FormulaRacingatUCDavis/FE11_CAD/Electrical/Components/Brake Light/EL-A0106-AA-Brake Light Assembly.SLDASM

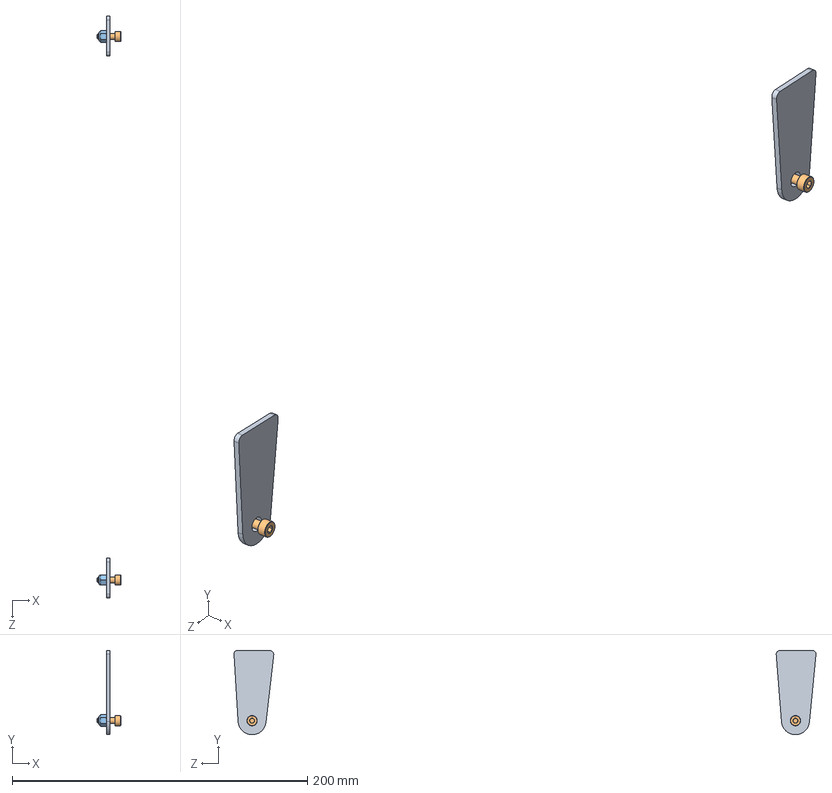
[picture p1: CAD file, 2024-04-30]
Electrical/Components/Brake Light/EL-A0106-AA-Brake Light Assembly.SLDASM
16.0 x 57.3 x 394.5 mm
EL-30080-AA-Brake Light Tabs x 2
BR-Black Oxide C12.9 SHCS, M4x0.7-12 (91290A148) x 2
FS-NYLOC C8 HX, M4x0.7-5 (90576A103) x 2
