FormulaRacingatUCDavis/FE11_CAD/Electrical/Components/Dashboard/FE10 Dashboard Packaging/EL-A00XX-BA-Dashboard Assembly.SLDASM

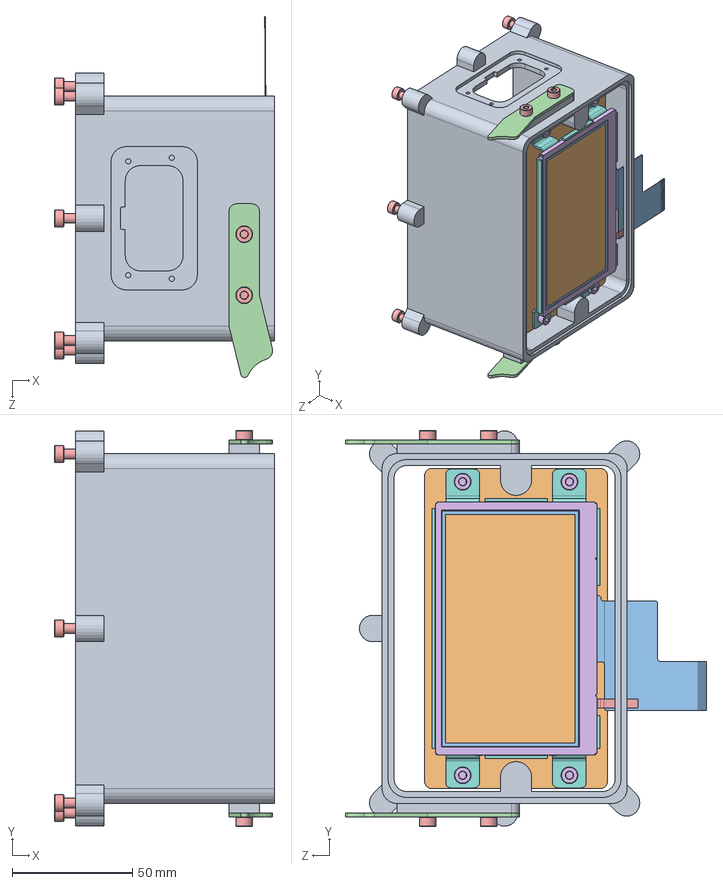
[picture p2: CAD file, 2023-11-07]
Electrical/Components/Dashboard/FE10 Dashboard Packaging/EL-A00XX-BA-Dashboard Assembly.SLDASM
91.8 x 164.9 x 150.3 mm
NHD-4.3-480272MF-34-Controller-Board
PANEL
PANEL-1
BLU
BLU-1
BEZEL
BSO4-M3-6 x 4
NHD-4.3-B
EL-500XX-BA-Dashboard Bottom Enclosure
EL-500XX-AA-Dashboard Screen Flat Panel
EL-500XX-AA-Dashboard Rear Flat Panel
EL-300XX-AA-Dashboard Enclosure Tabs x 2
BR-Black Oxide C12.9 SHCS, M4x0.7-8 (91290A140) x 13
BR-Black Oxide C12.9 SHCS, M4x0.7-5 (91290A138) x 4
