FormulaRacingatUCDavis/FE11_CAD/Electrical/Components/LV Battery/EL-A0104-AA-LV Battery Assembly.SLDASM

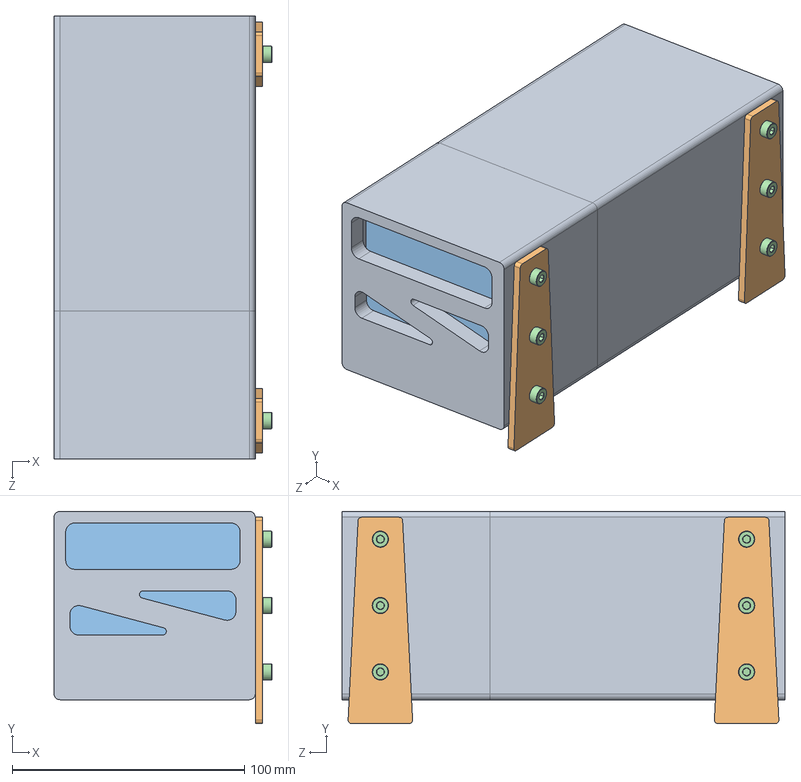
[picture p3: CAD file, 2024-04-30]
Electrical/Components/LV Battery/EL-A0104-AA-LV Battery Assembly.SLDASM
93.9 x 91.4 x 190.8 mm
EL-50060-AA-LV Battery Enclosure
EL-30061-AA-LV Battery Mounting Tab x 2
EL-00004-AA-Aegies-12 V 20 Ah Battery
BR-Black Oxide C12.9 SHCS, M4x0.7-8 (91290A140) x 6
