FormulaRacingatUCDavis/FE11_CAD/Electrical/Components/TSAL/EL-A0105-AA-TSAL Assembly.SLDASM

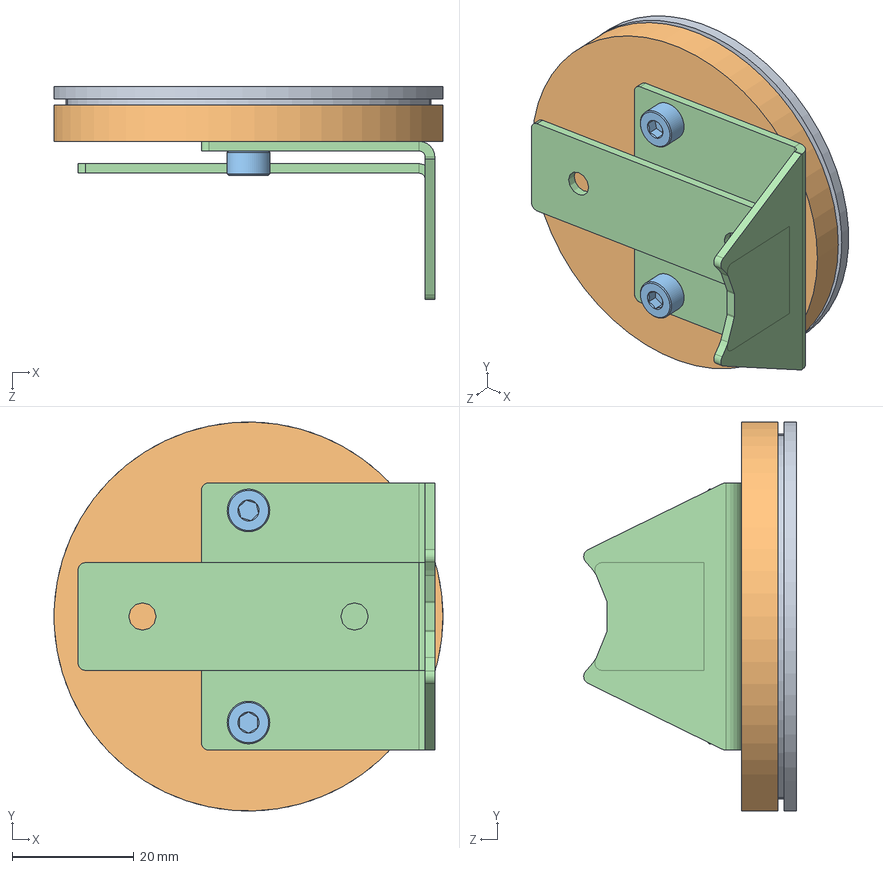
[picture p4: CAD file, 2024-04-30]
Electrical/Components/TSAL/EL-A0105-AA-TSAL Assembly.SLDASM
64.0 x 64.0 x 35.0 mm
EL-50071-AA-TSAL Bottom Housing
EL-50070-AA-TSAL Top Housing
BR-Black Oxide C12.9 SHCS, M4x0.7-8 (91290A140) x 2
EL-30072-AA-TSAL Mounting Tab
