FormulaRacingatUCDavis/FE11_CAD/Electrical/Components/TSMP + MS/EL-A0101-AA-TSMP + MS Assembly.SLDASM

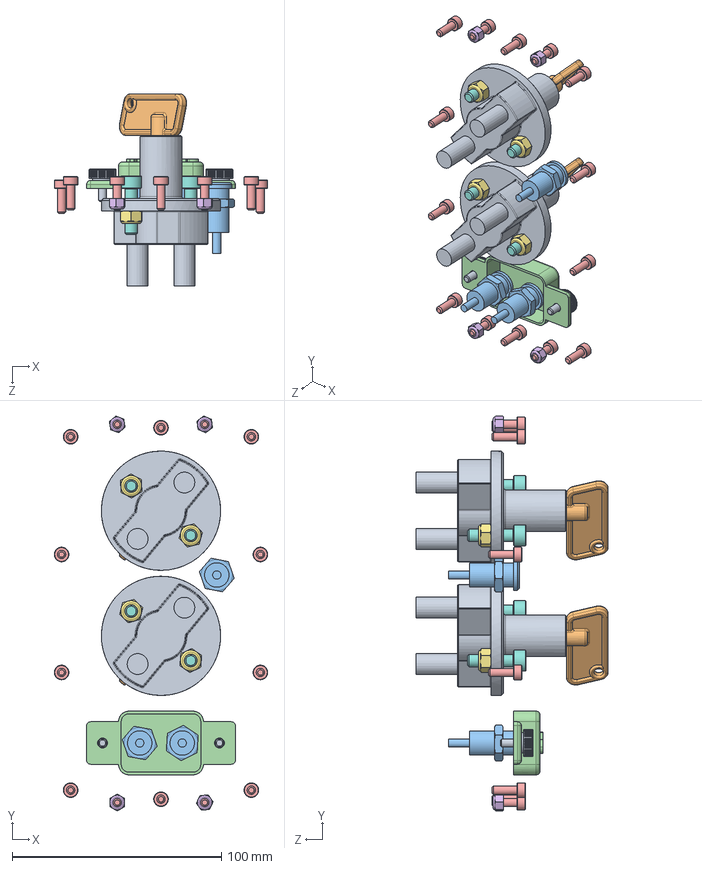
[picture p5: CAD file, 2024-04-30]
Electrical/Components/TSMP + MS/EL-A0101-AA-TSMP + MS Assembly.SLDASM
102.0 x 188.8 x 92.0 mm
EL-000XX-AA-Master Switch x 2
EL-000XX-AA-Master Switch Key x 2
EL-000XX-AA-Pomona Port (72930) x 3
EL-500XX-AA-TSMP Cover
BR-Black Oxide C12.9 SHCS, M4x0.7-12 (91290A148) x 14
FS-NYLOC C8 HX, M4x0.7-5 (90576A103) x 4
EL-Steel Nylon Locknut, C8, M6x1-6 (90576A115) x 4
EL-BLACK OXIDE C12.9 SHCP, M6x1-22 (91290A328) x 4
FS-PLASTIC-HEAD THUMB SCREW, M4x0.7-10 (96016A843 x 2
