FormulaRacingatUCDavis/FE11_CAD/Powertrain/Accumulator/AC-A0200-AA-Accumulator Assembly.SLDASM

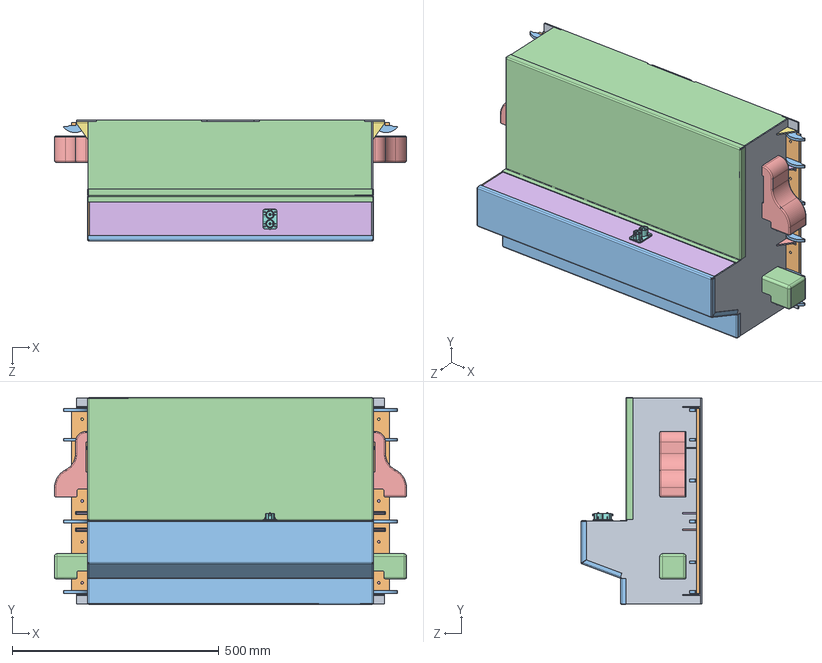
[picture p6: CAD file, 2023-09-17]
Powertrain/Accumulator/AC-A0200-AA-Accumulator Assembly.SLDASM
850.8 x 501.5 x 292.3 mm
AC-30020-BA-Accumulator Floor
AC-30021-AB-Center Walls x 2
AC-30022-AB-Front Wall
AC-30023-AB-Rear Wall
AC-30024-AB-Internal Wall 1
AC-30025-AB-Internal Wall 2
AC-30026-AB-Internal Wall 3
AC-30027-AB-Internal Wall 4
AC-30028-AB-Left Wall
AC-30029-AB-Right Wall
AC-20030-AA-Power Electronics Lid
AC-20031-AA-Accumulator Lid
AC-30032-AA-Long Mount Gusset x 2
AC-30033-AA-Middle Mount Gusset x 2
AC-30034-AA-Short Mount Gusset x 2
AC-X0060-AA-Subpack Case Body x 10
AC-00041-AA-Surlock Maintenance Receptable x 20
AC-00061-AA-Subpack Heatsink x 10
AC-00001-AA-AIR Gigavac GV200 x 2
BenderAIsometer-FE2
AMP_c-1445022-8-d-3d
AMP_c-1445022-2-d-3d x 2
AC-00003-AA-E Meter
AC-00002-AA-Surlock Receptable, PL082X-121-10M6
AC-50005-AA-Internal Duct x 5
AC-30006-AA-Accumulator Mount Plate x 2
AC-30007-AA-Accumulator Mount Gusset x 12
AC-50008-AA-Single External Duct x 2
AC-50009-AA-Double External Duct x 2
