FormulaRacingatUCDavis/FE11_CAD/Powertrain/Accumulator/Components/Power Electronics/3D Prints/AC-50046-AA-Right Maintenance Plug Divider.SLDPRT

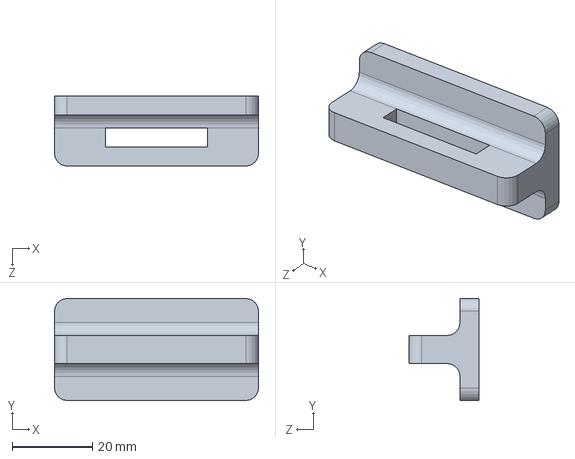
[picture p7: CAD file, 2024-04-30]
Powertrain/Accumulator/Components/Power Electronics/3D Prints/AC-50046-AA-Right Maintenance Plug Divider.SLDPRT
50.8 x 25.4 x 17.5 mm
