FormulaRacingatUCDavis/FE11_CAD/Powertrain/Accumulator/Components/Power Electronics/Cables/AC-00018-AA-Positive Maintenance Cable.SLDPRT

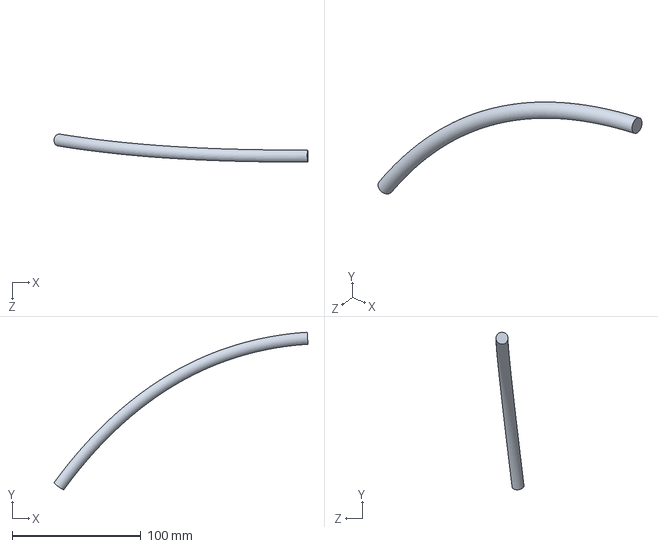
[picture p8: CAD file, 2024-04-30]
Powertrain/Accumulator/Components/Power Electronics/Cables/AC-00018-AA-Positive Maintenance Cable.SLDPRT
197.6 x 122.6 x 21.8 mm
