FormulaRacingatUCDavis/FE11_CAD/Powertrain/Accumulator/Components/Subpacks/Busbars/AC-00090-AA-Surlock Plus Maintenance Receptacles.SLDPRT

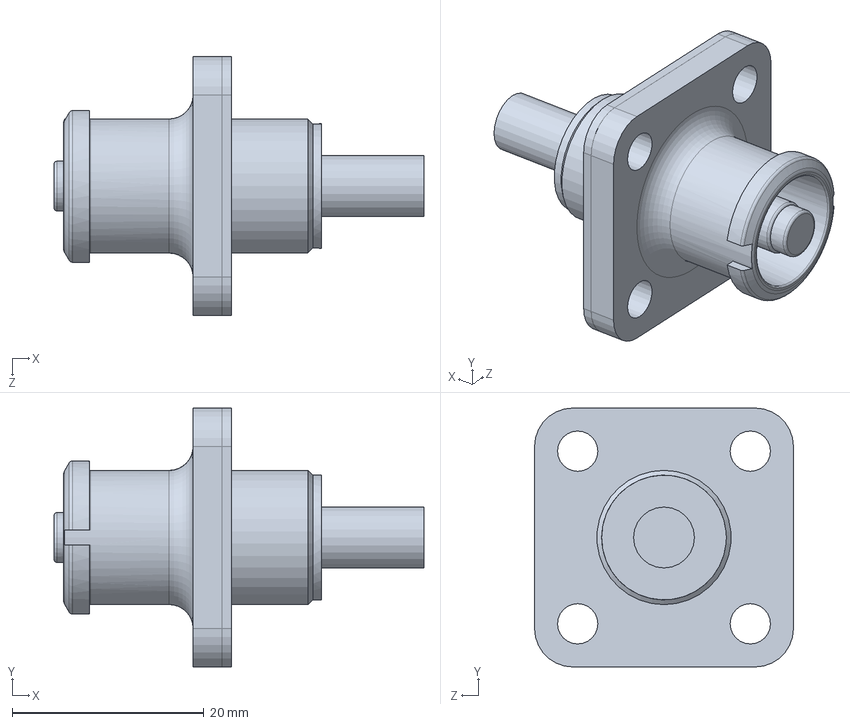
[picture p9: CAD file, 2024-02-17]
Powertrain/Accumulator/Components/Subpacks/Busbars/AC-00090-AA-Surlock Plus Maintenance Receptacles.SLDPRT
38.6 x 27.0 x 27.0 mm
