FormulaRacingatUCDavis/FE11_CAD/Powertrain/Drivetrain/Components/Drivetrain FEA/EN-A0100-AA-Assembly Drivetrain FEA.SLDASM

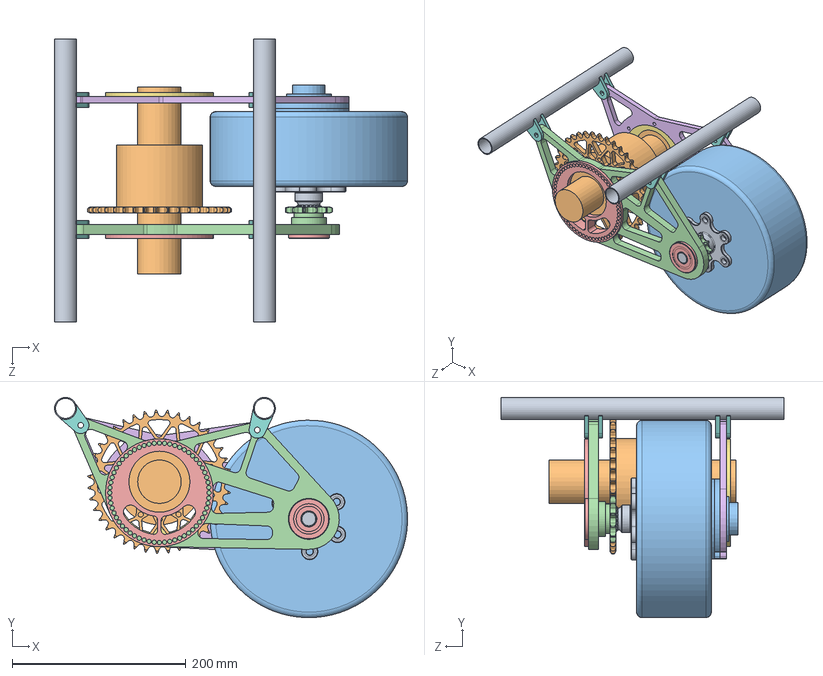
[picture p10: CAD file, 2023-11-04]
Powertrain/Drivetrain/Components/Drivetrain FEA/EN-A0100-AA-Assembly Drivetrain FEA.SLDASM
405.8 x 253.2 x 325.1 mm
Chassis_tubes x 2
EN-00000-AA-Differential Solid Model (1)
EN-00000-AA-Motor Solid Model
EN-10001-AC-Drive_Side_Bracket
EN-10003-AA-Drive Side Puck (DSP)
EN-10001-AD-Support Side Bracket
EN-10004-AA-Support Side Puck (SSP)
EN-30005-AB-Bracket Tabs x 8
EN-00021-AC- Motor Shaft, Involute Splines
EN-10029-AA-Differential Sprocket
EN-10001-AA-Support Side Bracket Spacer (SSBS)
EN-00021-XB-Motor Sprocket, 40B12 Splined
EN-00022-AA-Timken 6303-2RS Deep Groove Ball Bearing
