FormulaRacingatUCDavis/FE11_CAD/Powertrain/Drivetrain/Components/Half Shafts/EN-A0104-AB-Half Shaft Assembly.SLDASM

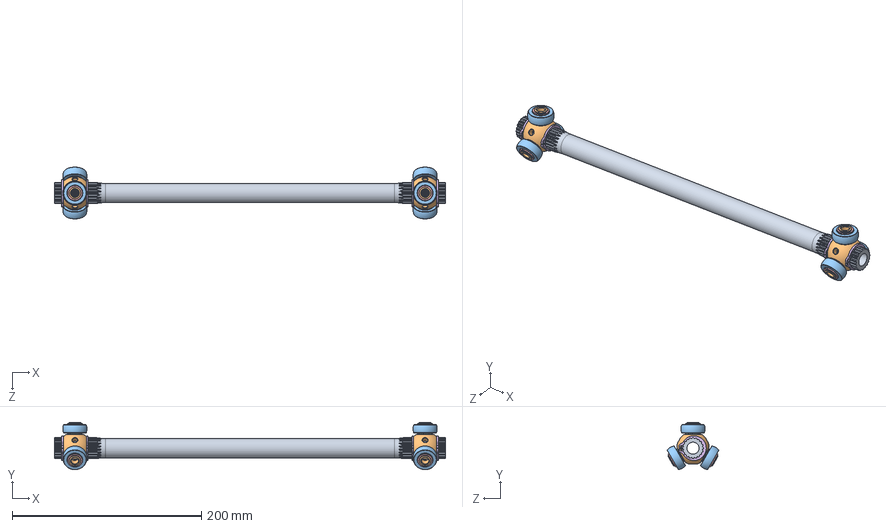
[picture p11: CAD file, 2023-10-24]
Powertrain/Drivetrain/Components/Half Shafts/EN-A0104-AB-Half Shaft Assembly.SLDASM
412.8 x 49.9 x 54.7 mm
EN-00030-AB-RCV Half Shaft
FSAE Tripod V2_1^EN-00031-AB-RCV Tripod x 2
FSAE roller_2451_2^EN-00031-AB-RCV Tripod x 6
needle^EN-00031-AB-RCV Tripod x 174
Tripod Retainer^EN-00031-AB-RCV Tripod x 6
FS-RCV FSAE Snap Ring,214-54 x 4
