FormulaRacingatUCDavis/FE11_CAD/Powertrain/Drivetrain/Components/HVD/EN-A0005-AA-HVD Assembly.SLDASM

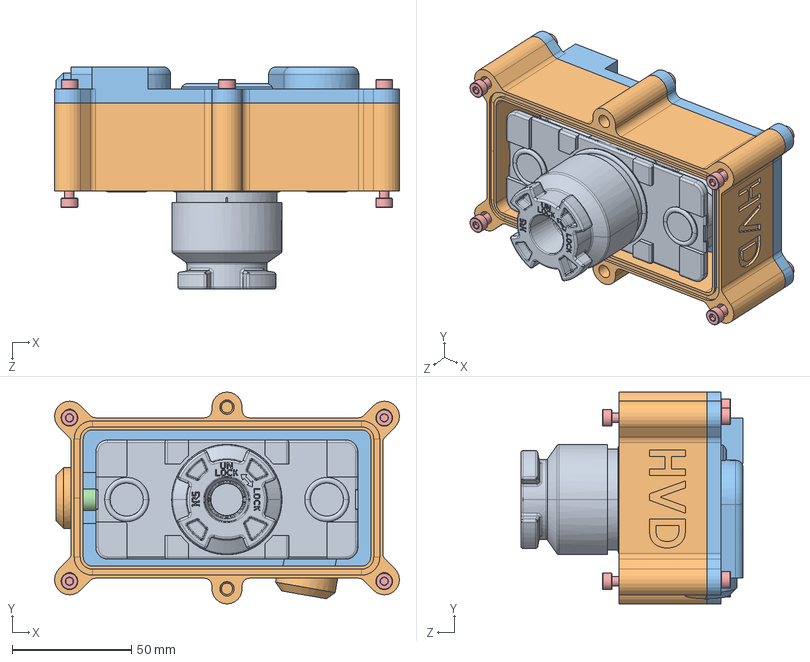
[picture p12: CAD file, 2023-12-18]
Powertrain/Drivetrain/Components/HVD/EN-A0005-AA-HVD Assembly.SLDASM
144.8 x 88.9 x 93.3 mm
EN-00033-AB-HVD, HRS EM30MSD
EN-50000-AA-HVD Bottom Cover
EN-50000-AA-HVD Top Cover
EN-00017-AB-Nelco KRF 16-6 Compression Lugs x 2
BR-Black Oxide C12.9 SHCS, M4x0.7-12(91290A148) x 10
