FormulaRacingatUCDavis/FE11_CAD/Powertrain/Drivetrain/Components/Motor Assembly/Motor Assembly FEA/EN-A0101-XA-Emrax 228 Motor Assembly.SLDASM

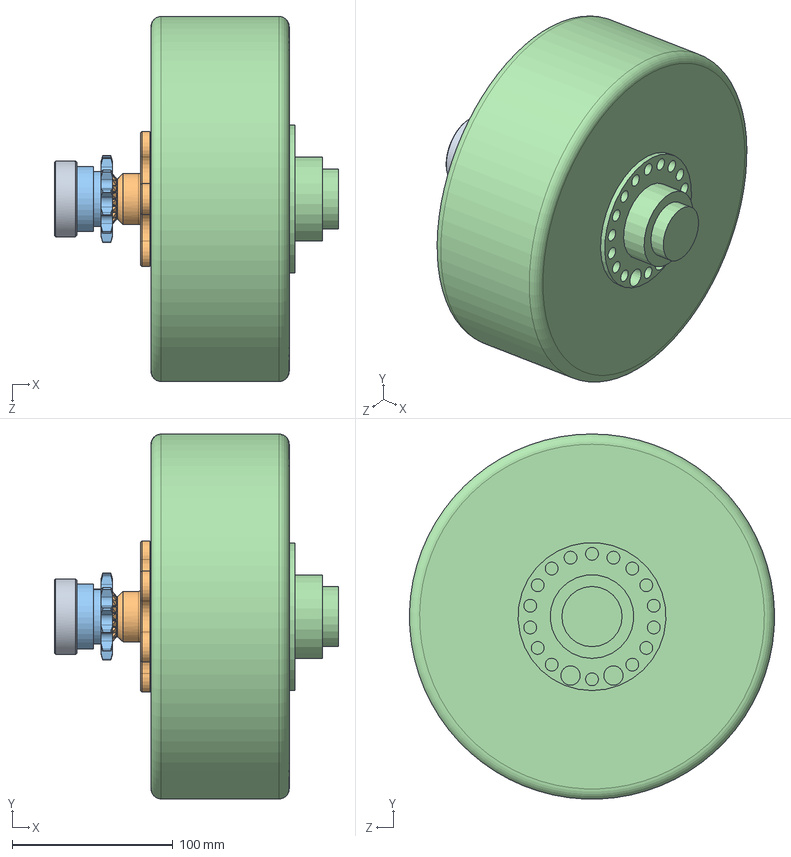
[picture p13: CAD file, 2023-11-03]
Powertrain/Drivetrain/Components/Motor Assembly/Motor Assembly FEA/EN-A0101-XA-Emrax 228 Motor Assembly.SLDASM
176.8 x 226.9 x 227.0 mm
EN-00022-AA-Timken 6303-2RS Deep Groove Ball Bearing
EN-00021-AC- Motor Shaft, Involute Splines
EN-00021-XB-Motor Sprocket, 40B12 Splined
EN-00000-AA-Motor Solid Model
