FormulaRacingatUCDavis/FE11_CAD/Powertrain/Drivetrain/Components/Tensioning Tool/Tensioning Tool EN-A0100-AC-Drivetrain Assembly.SLDPRT

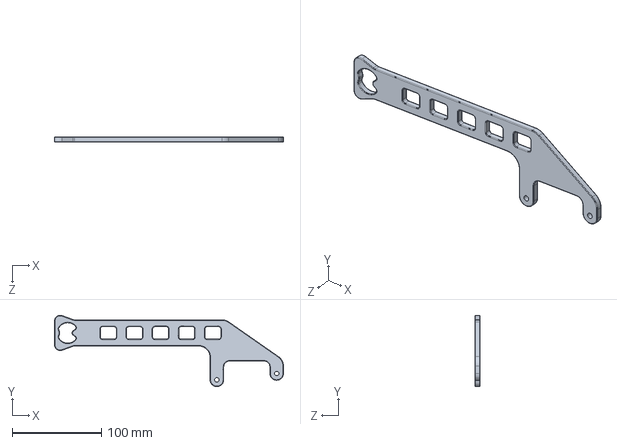
[picture p14: CAD file, 2023-12-28]
Powertrain/Drivetrain/Components/Tensioning Tool/Tensioning Tool EN-A0100-AC-Drivetrain Assembly.SLDPRT
255.9 x 79.7 x 5.59 mm
