FormulaRacingatUCDavis/FE11_CAD/Unsprung/Controls/CN-A0100-AA-Controls-Suspension Front Axle.SLDASM

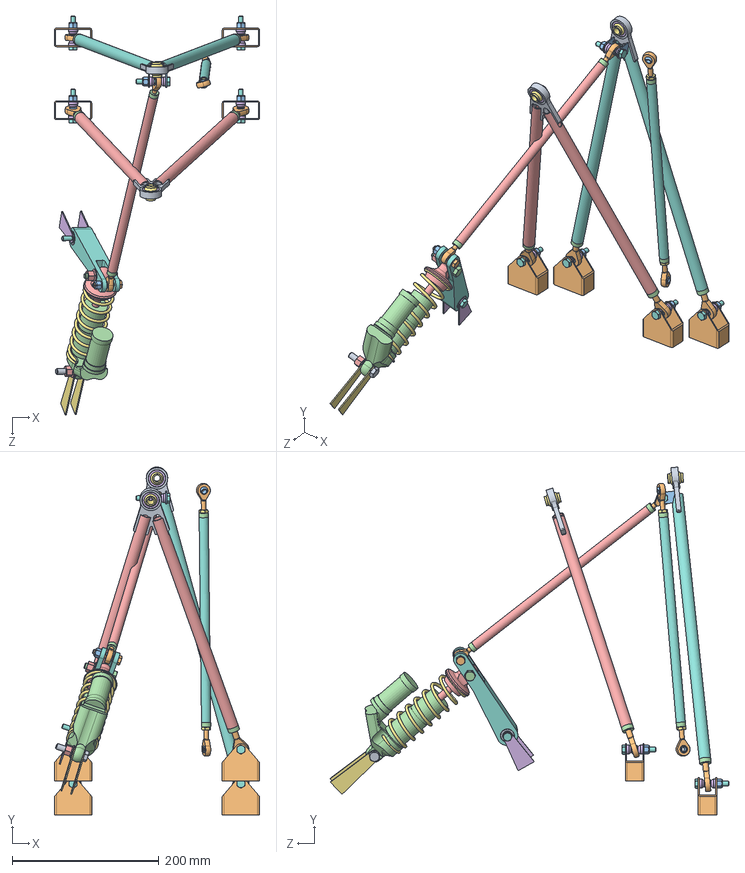
[picture p15: CAD file, 2023-09-12]
Unsprung/Controls/CN-A0100-AA-Controls-Suspension Front Axle.SLDASM
279.4 x 474.2 x 543.7 mm
SP-Upper Apex Front
MirrorBody^MirrorFS-MALE ROD END UNF-3A, 0.3125x24-0.25D (XAM-4)1 x 4
MirrorBall^MirrorFS-MALE ROD END UNF-3A, 0.3125x24-0.25D (XAM-4)1 x 4
SP-10003-AB-Threaded Insert x 4
SP-Upper A-Arm Tube x 2
Race^FS-HIGH MISALIGN SPHERICAL BEARING, 0.375-0.906D (3072-6G) x 2
Ball^FS-HIGH MISALIGN SPHERICAL BEARING, 0.375-0.906D (3072-6G) x 2
SP-Front Lower A-Arm Tube x 2
SP-Lower Apex Front
SP-C30066-AA-A-Arm Tab Box x 4
MirrorSP-30063-AB-Pushrod Tab x 2
Shock Body^SP-A0105-AC-Ohlin TTX25 MKII, 200mm
Head^SP-A0105-AC-Ohlin TTX25 MKII, 200mm
Ball^SP-A0105-AC-Ohlin TTX25 MKII, 200mm x 2
SP-#####-AB-Spring
SP-Front Rocker
FS-BALL BEARING, 0.25ID-0.75OD (60355K702) x 2
FS-CADMIUM PLATED C3 HX, 0.25x28-1.41-0.469 (AN4-13A)
FS-NYLOC G8 HX, 0.25x28-0.3125 (90630A145) x 6
MirrorFS-ZINC YELLOW CHROMATE C10.9 HX, M8x1.25-40-22 (95327A569)
FS-NYLOC FLHX C8, M8x1.25-11.1 (92461A400) x 2
SP-A0200-Front Rocker Tab Box x 2
SP-A0200-Shock Tab x 2
FS-CADMIUM PLATED C3 HEX, 0.25x28-1.65-0.469 (AN4-13A) x 6
FS-ZINC YELLOW CHROMATE C10.9 HX, M8x1.25-40-22 (95327A569)
Body^FS-MALE ROD END UNF-3A, 0.25x28-0.25D (AM-4) x 4
Ball^FS-MALE ROD END UNF-3A, 0.25x28-0.25D (AM-4) x 4
SP-10003-AC-Threaded Insert x 4
SP-A0200-Front Push Rod Tube
FS-ROD END RETAINING WASHER, 0.25-0.245 (NO PN) x 10
FS-ZINC YELLOW THIN NUT G8 HX, 0.25x28-0.15625 (93839A805) x 2
Tie Rod Front
