FormulaRacingatUCDavis/FE11_CAD/Unsprung/Controls/Ergo Jig/Ergo Jig Assembly.SLDASM

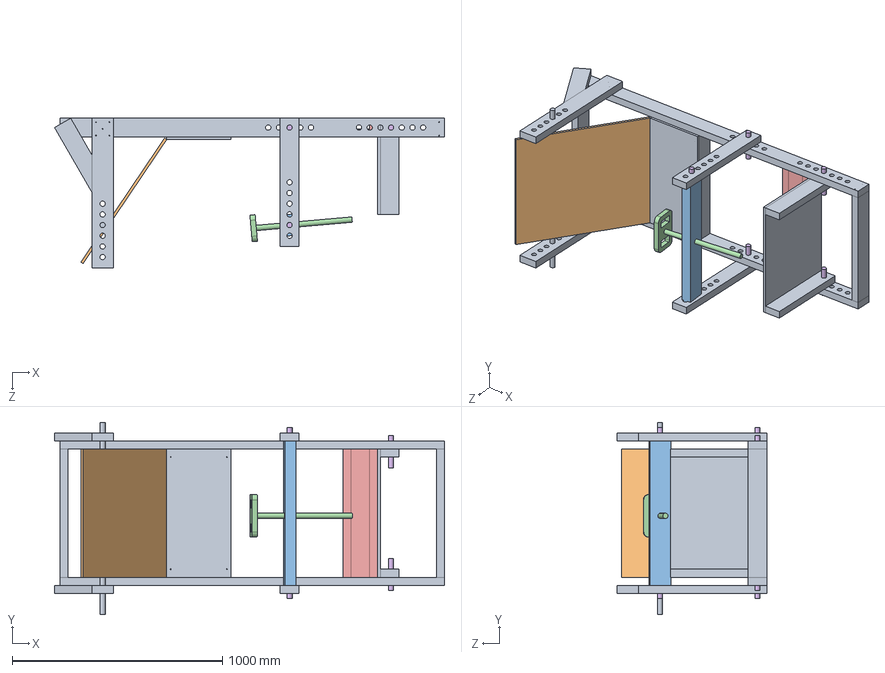
[picture p17: CAD file, 2023-09-12]
Unsprung/Controls/Ergo Jig/Ergo Jig Assembly.SLDASM
1854.5 x 914.4 x 711.2 mm
base-2x4
seat-backing
steering-2x4
steering-wheel
foot rest
adjustment-dowels x 6
