FormulaRacingatUCDavis/FE11_CAD/Unsprung/Controls/Pedal Box/Brake Pedal/Components/Balance Bar/BR-00005-AA-Balance Bar (Tilton 600 Series).SLDASM

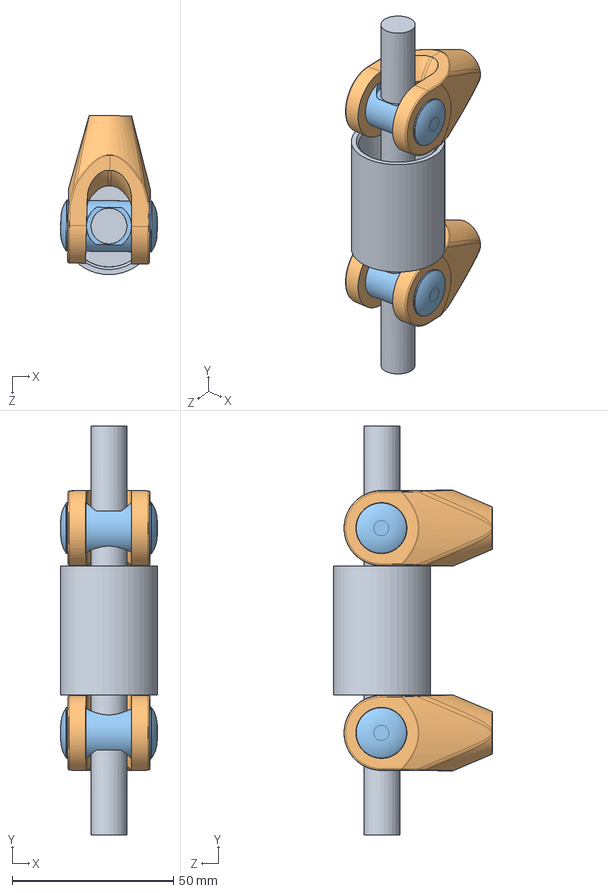
[picture p21: CAD file, 2023-09-12]
Unsprung/Controls/Pedal Box/Brake Pedal/Components/Balance Bar/BR-00005-AA-Balance Bar (Tilton 600 Series).SLDASM
30.2 x 127.0 x 49.5 mm
Copy of Bar^BR-00005-AA-Balance Bar (Tilton 600 Series)
BB Arm^BR-00005-AA-Balance Bar (Tilton 600 Series) x 2
BB Bullet^BR-00005-AA-Balance Bar (Tilton 600 Series) x 2
