FormulaRacingatUCDavis/FE11_CAD/Unsprung/Controls/Pedal Box/Brake Pedal/Components/BPPS/BR-00009-CA-BPPS (PSC360G2-F2AA-C0002-ERA360-05K).SLDASM

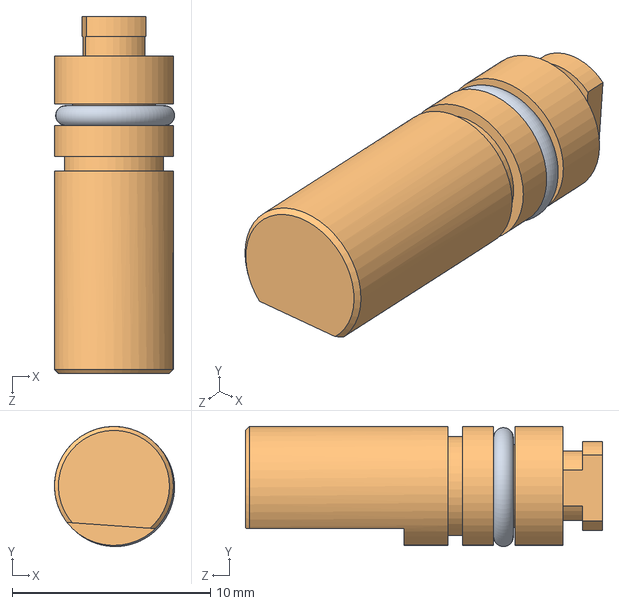
[picture p22: CAD file, 2023-09-12]
Unsprung/Controls/Pedal Box/Brake Pedal/Components/BPPS/BR-00009-CA-BPPS (PSC360G2-F2AA-C0002-ERA360-05K).SLDASM
6.05 x 6.06 x 18.0 mm
3105-JUNTA TORICA PSC360^3269-EJE+ROTOR PSC 360_PSC-360G2_BR-00009-CA-BPPS (PSC360G2-F2AA-C0002-ERA360-05K)
Copy of 3268-EJE METALICO PORTAIMAN PSC 360^BR-00009-CA-BPPS (PSC360G2-F2AA-C0002-ERA360-05K)
