FormulaRacingatUCDavis/FE11_CAD/Unsprung/Controls/Pedal Box/Brake Pedal/Components/Master Cylinder/BR-00004-AB-CP7855 Master Cylinder.SLDASM

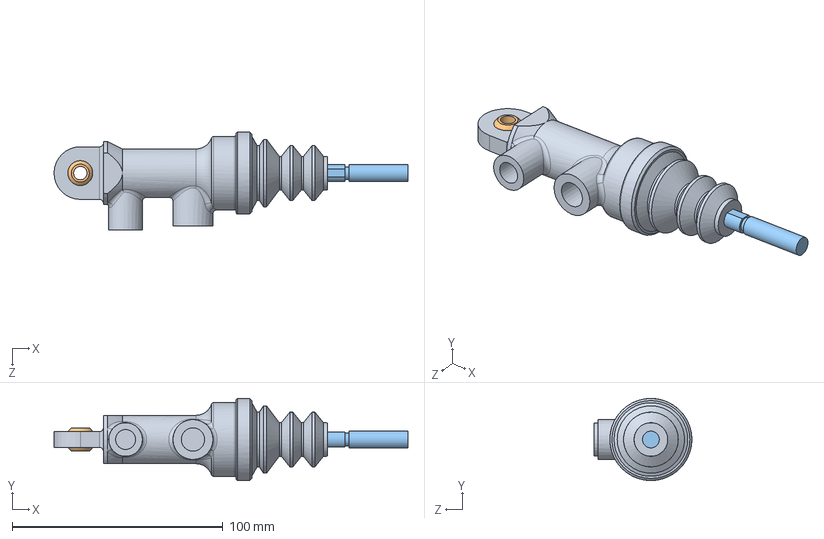
[picture p23: CAD file, 2024-03-02]
Unsprung/Controls/Pedal Box/Brake Pedal/Components/Master Cylinder/BR-00004-AB-CP7855 Master Cylinder.SLDASM
168.1 x 39.0 x 46.5 mm
Main Body^BR-00004-AB-CP7855 Master Cylinder
Spherical Mount^BR-00004-AB-CP7855 Master Cylinder
Threaded Piston^BR-00004-AB-CP7855 Master Cylinder
