FormulaRacingatUCDavis/FE11_CAD/Unsprung/Controls/Steering/Components/Rack Mount Spacer/ST-40026-AA-Rack Mount Spacer.SLDASM

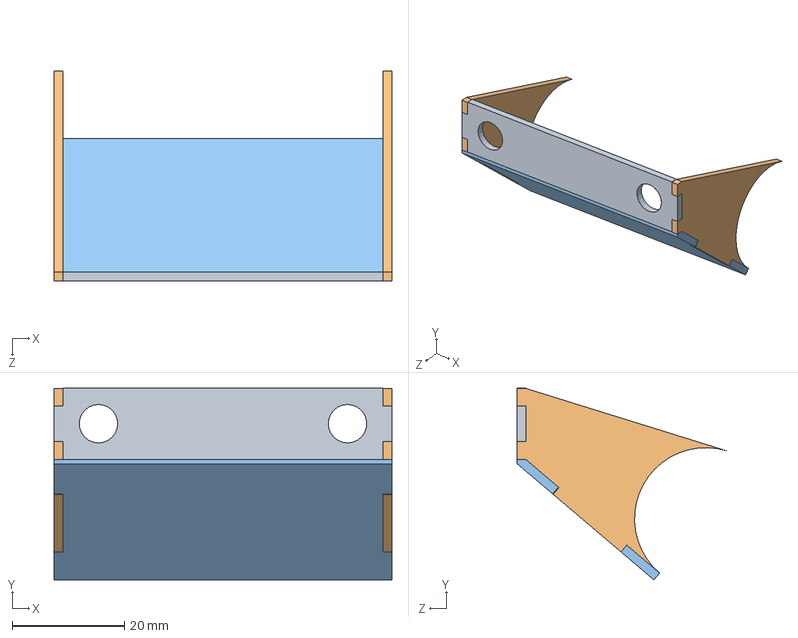
[picture p24: CAD file, 2023-09-12]
Unsprung/Controls/Steering/Components/Rack Mount Spacer/ST-40026-AA-Rack Mount Spacer.SLDASM
60.3 x 34.2 x 37.4 mm
Top Mount^ST-40026-AA-Rack Mount Spacer
Side Brackets^ST-40026-AA-Rack Mount Spacer x 2
Back Plate^ST-40026-AA-Rack Mount Spacer
