FormulaRacingatUCDavis/FE11_CAD/Unsprung/Controls/Steering/Components/ST-10001-AA-Steering Tab Box.SLDASM

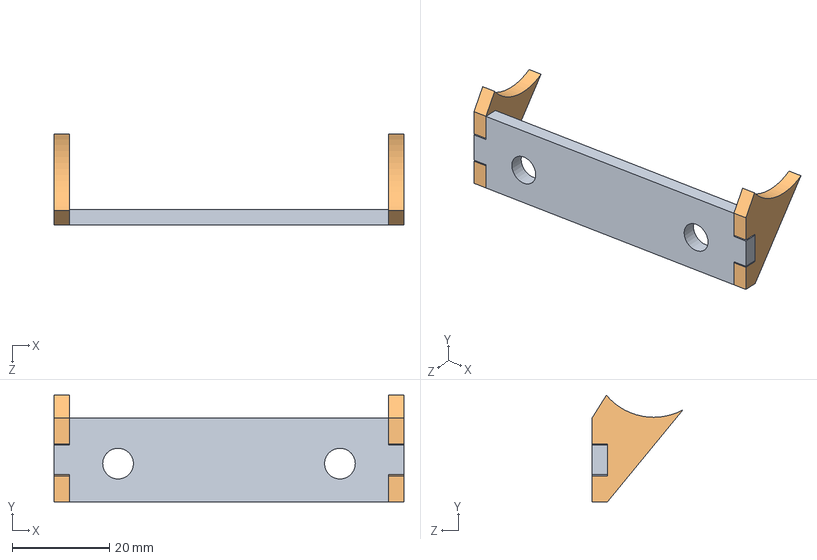
[picture p25: CAD file, 2024-01-08]
Unsprung/Controls/Steering/Components/ST-10001-AA-Steering Tab Box.SLDASM
72.1 x 22.0 x 18.7 mm
Part1^ST-10001-AA-Steering Tab Box
Part2^ST-10001-AA-Steering Tab Box x 2
