FormulaRacingatUCDavis/FE11_CAD/Unsprung/Controls/Steering/Components/Steering Rack/ST-00020-AA-NARRco Rack MkII.SLDASM

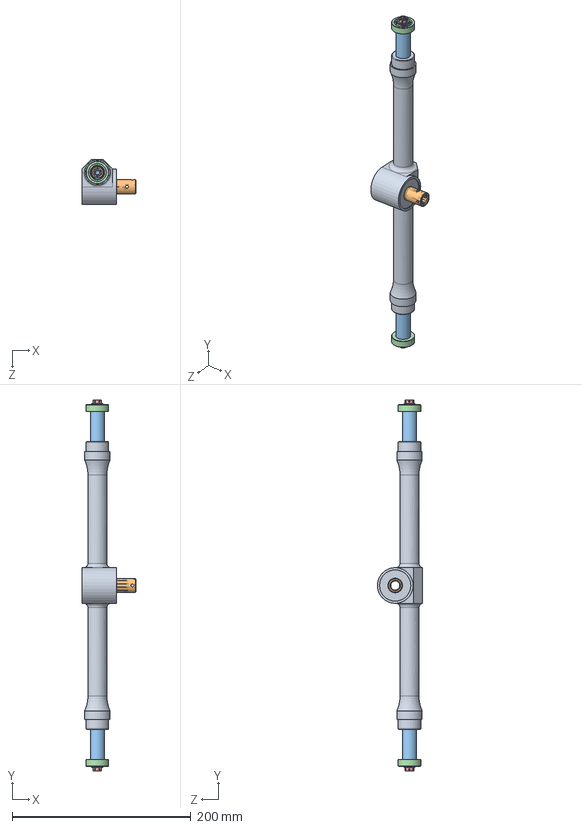
[picture p26: CAD file, 2024-01-16]
Unsprung/Controls/Steering/Components/Steering Rack/ST-00020-AA-NARRco Rack MkII.SLDASM
60.0 x 415.4 x 50.7 mm
ST-00020-AA-NARRco Rack MkII Housing^ST-00020-AA-NARRco Rack MkII
ST-00021-AA-NARRco Rack MkII Pinion^ST-00020-AA-NARRco Rack MkII
ST-00022-AA-NARRco Rack MkII Rack^ST-00020-AA-NARRco Rack MkII
ST-00023-AA-NARRco Rack MkII Bump Stop TT1119-01^ST-00020-AA-NARRco Rack MkII x 2
ST-10024-AA-Rack End Fastener^ST-00020-AA-NARRco Rack MkII x 2
