FormulaRacingatUCDavis/FE11_CAD/Unsprung/Controls/Steering/Components/TYCA Rack Mounts/Rack Mount Assembly.SLDASM

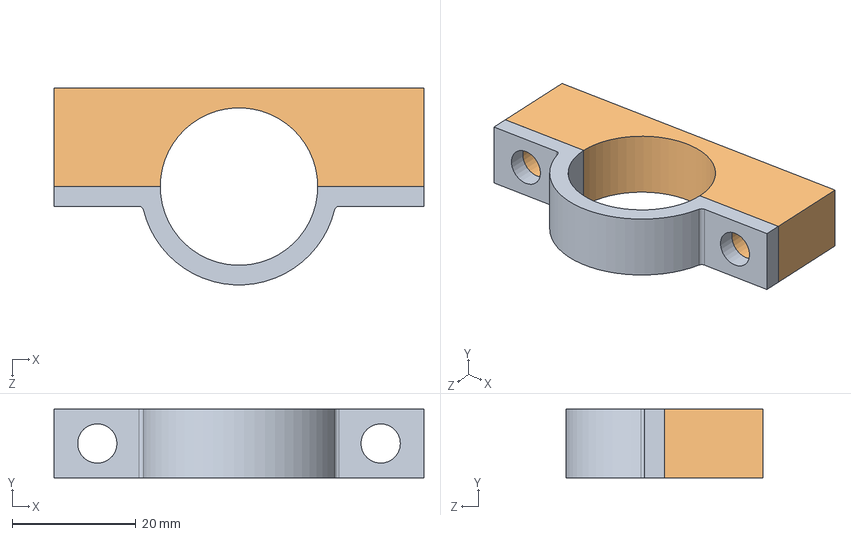
[picture p27: CAD file, 2024-01-08]
Unsprung/Controls/Steering/Components/TYCA Rack Mounts/Rack Mount Assembly.SLDASM
59.7 x 11.1 x 31.7 mm
ST-00011-AB-Rack Mount Top
ST-00012-AB-Rack Mount Bottom
