FormulaRacingatUCDavis/FE11_CAD/Unsprung/Controls/Steering/Components/U-Joint/ST-00007-AB-SU Joint Borgeson.SLDASM

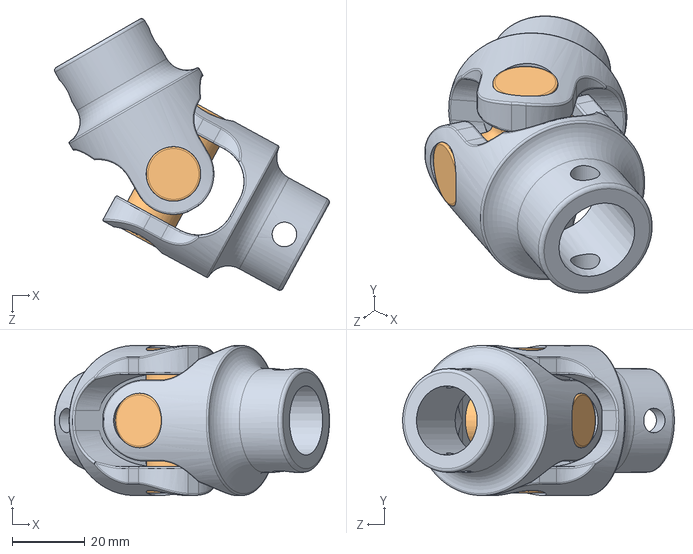
[picture p28: CAD file, 2024-09-13]
Unsprung/Controls/Steering/Components/U-Joint/ST-00007-AB-SU Joint Borgeson.SLDASM
75.6 x 41.2 x 74.7 mm
Clevis^ST-00007-AA-SU Joint Borgeson x 2
Joint^ST-00007-AA-SU Joint Borgeson
