FormulaRacingatUCDavis/FE11_CAD/Unsprung/Suspension/Assemblies/Front A-Arms/SP - Front Lower A-Arms.SLDASM

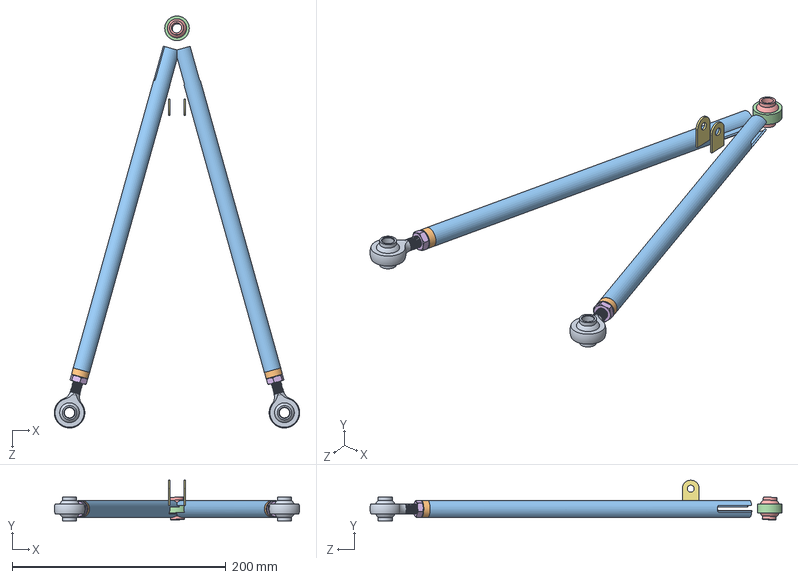
[picture p29: CAD file, 2024-04-30]
Unsprung/Suspension/Assemblies/Front A-Arms/SP - Front Lower A-Arms.SLDASM
229.5 x 38.0 x 385.2 mm
6960T231_Super-Swivel Ball Joint Rod End x 2
SP-10003-AD-Threaded Insert x 2
SP-FR Lower A-Arm Tube x 2
Race^FS-High Misalign Spherical Bearing, 0.375 (HAB-6TG)
Ball^FS-High Misalign Spherical Bearing, 0.375 (HAB-6TG)
FS-ZINC YELLOW THIN NUT G8 HX, 0.375x24-0.21875 (93839A815) x 2
SP-30063-AB-Pushrod Tab x 2
