FormulaRacingatUCDavis/FE11_CAD/Unsprung/Suspension/Assemblies/Rear A-Arms/SP-AB-Rear Upper A-Arms.SLDASM

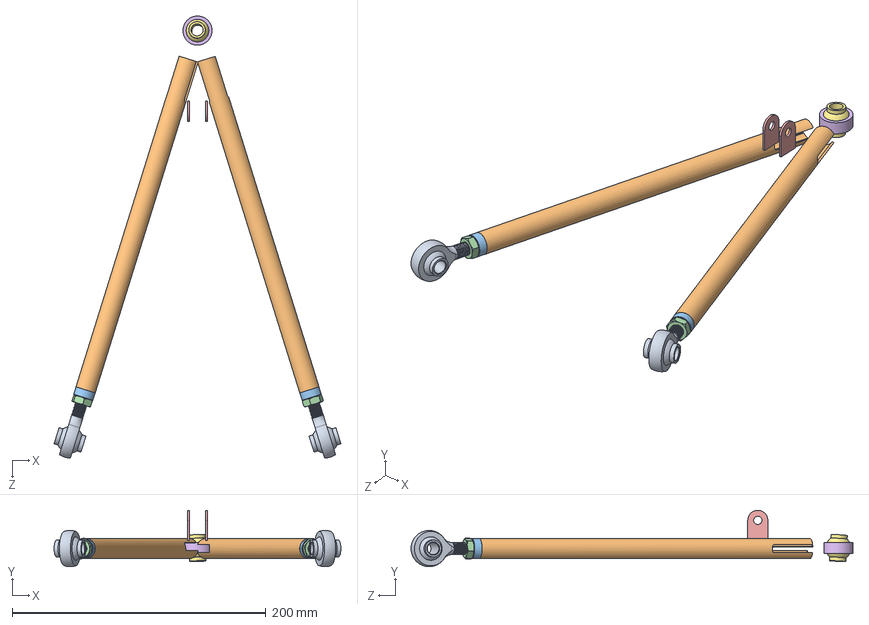
[picture p30: CAD file, 2024-04-30]
Unsprung/Suspension/Assemblies/Rear A-Arms/SP-AB-Rear Upper A-Arms.SLDASM
226.1 x 44.4 x 348.4 mm
6960T231_Super-Swivel Ball Joint Rod End x 2
SP-RR Upper A-Arm Tube x 2
SP-10003-AD-Threaded Insert x 2
FS-ZINC YELLOW THIN NUT G8 HX, 0.375x24-0.21875 (93839A815) x 2
SP-30063-AB-Pushrod Tab x 2
Race^FS-High Misalign Spherical Bearing, 0.375 (HAB-6TG)
Ball^FS-High Misalign Spherical Bearing, 0.375 (HAB-6TG)
