FormulaRacingatUCDavis/FE11_CAD/Unsprung/Suspension/Assemblies/Tie Rods/SP-10011-AA-Front Tie Rods.SLDASM

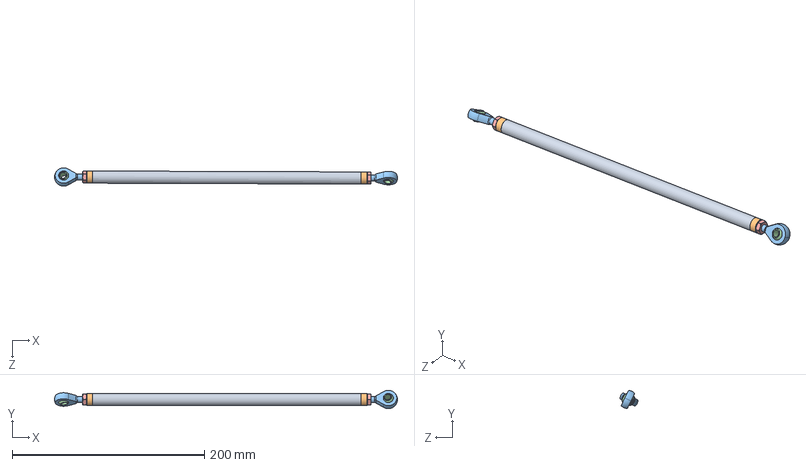
[picture p31: CAD file, 2024-01-16]
Unsprung/Suspension/Assemblies/Tie Rods/SP-10011-AA-Front Tie Rods.SLDASM
356.9 x 19.0 x 19.0 mm
Tie Rod Tube^SP-10011-AA-Front Tie Rods
SP-10003-AC-Threaded Insert x 2
Body^FS-MALE ROD END UNF-3A, 0.25x28-0.25D (AM-4) x 2
Ball^FS-MALE ROD END UNF-3A, 0.25x28-0.25D (AM-4) x 2
FS-ZINC YELLOW THIN NUT G8 HX, 0.25x28-0.15625 (93839A805) x 2
