FormulaRacingatUCDavis/FE11_CAD/Unsprung/Suspension/Components/Rockers/SP-BB-Rear Rocker/SP-A0101-BB-Rear Rocker Assembly.SLDASM

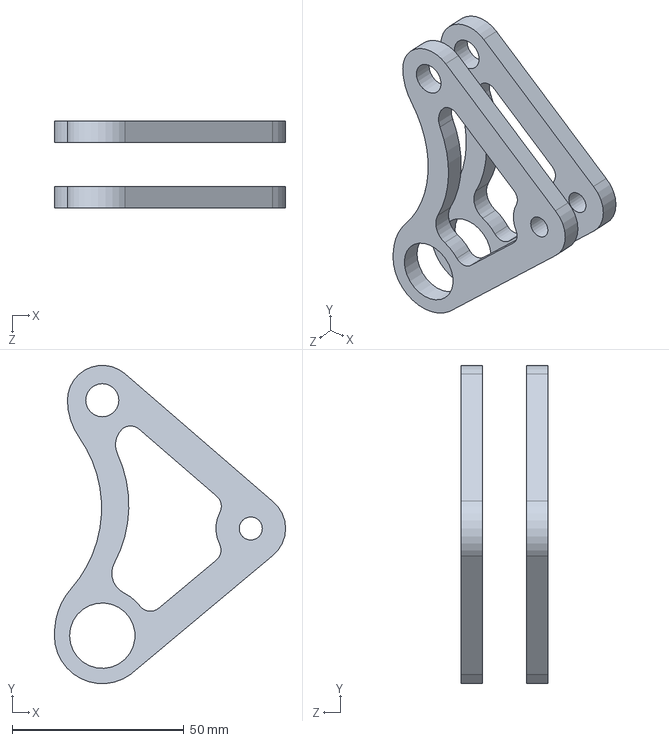
[picture p33: CAD file, 2024-04-30]
Unsprung/Suspension/Components/Rockers/SP-BB-Rear Rocker/SP-A0101-BB-Rear Rocker Assembly.SLDASM
67.4 x 92.6 x 25.4 mm
SP-20001-BB-Rear Rocker x 2
