FormulaRacingatUCDavis/FE11_CAD/Unsprung/Suspension/FE10/Shocks/Shock Tabs/SP-A0106-AB-Front Shock Tab Box.SLDASM

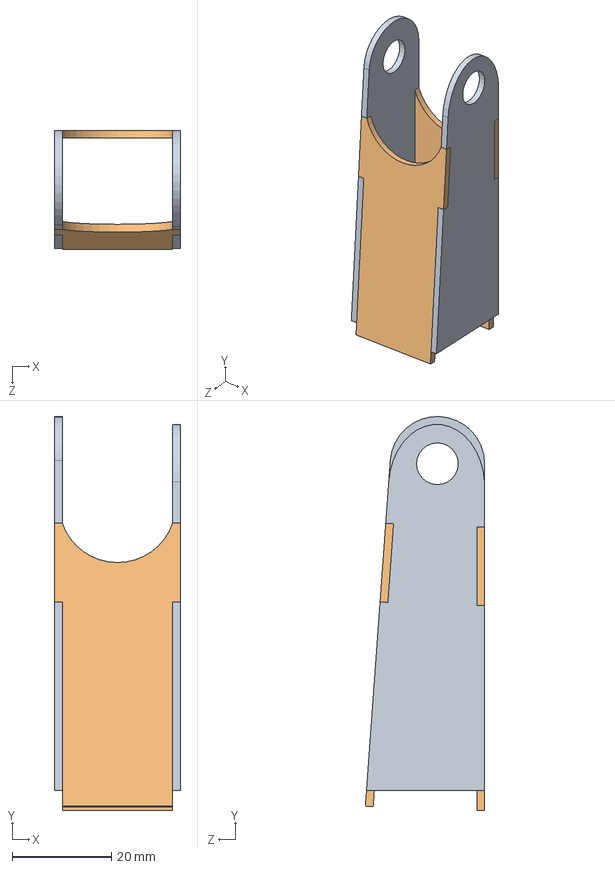
[picture p34: CAD file, 2024-04-30]
Unsprung/Suspension/FE10/Shocks/Shock Tabs/SP-A0106-AB-Front Shock Tab Box.SLDASM
25.4 x 79.4 x 24.0 mm
SP-30034-AB-Front Shock Tab x 2
SP-30035-AA-Front Shock Gusset Tab x 2
