FormulaRacingatUCDavis/FE11_CAD/Unsprung/Suspension/FE10/Shocks/SP-A0105-AC-Ohlin TTX25 MKII, 200mm.SLDASM

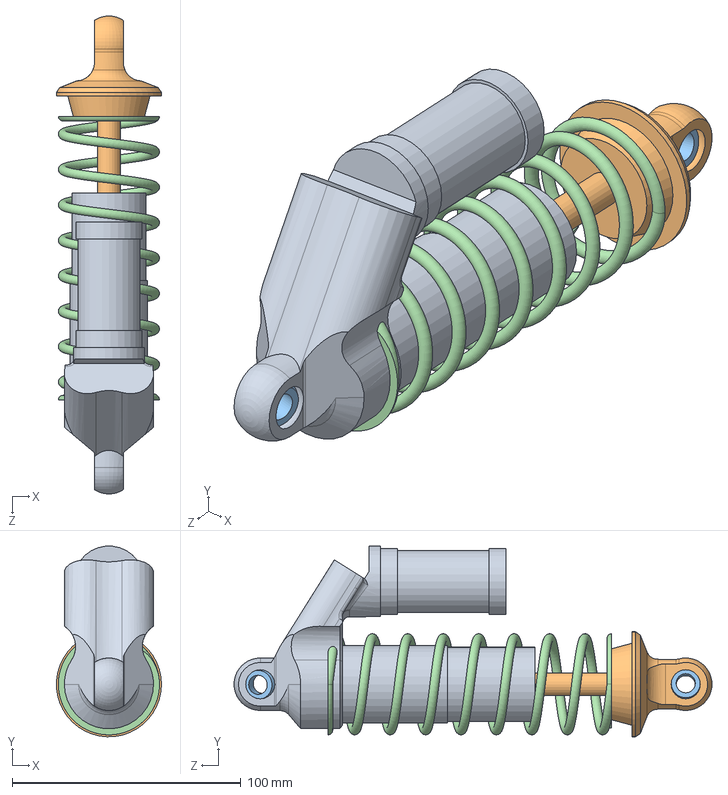
[picture p35: CAD file, 2024-04-30]
Unsprung/Suspension/FE10/Shocks/SP-A0105-AC-Ohlin TTX25 MKII, 200mm.SLDASM
45.9 x 83.4 x 209.2 mm
Shock Body^SP-A0105-AC-Ohlin TTX25 MKII, 200mm
Head^SP-A0105-AC-Ohlin TTX25 MKII, 200mm
Ball^SP-A0105-AC-Ohlin TTX25 MKII, 200mm x 2
SP-#####-AB-Spring
