FormulaRacingatUCDavis/FE11_CAD/Unsprung/Suspension/FE10/Tie-Rod Assembly/Front/SP-####-AA-Front Tie Rod Assembly.SLDASM

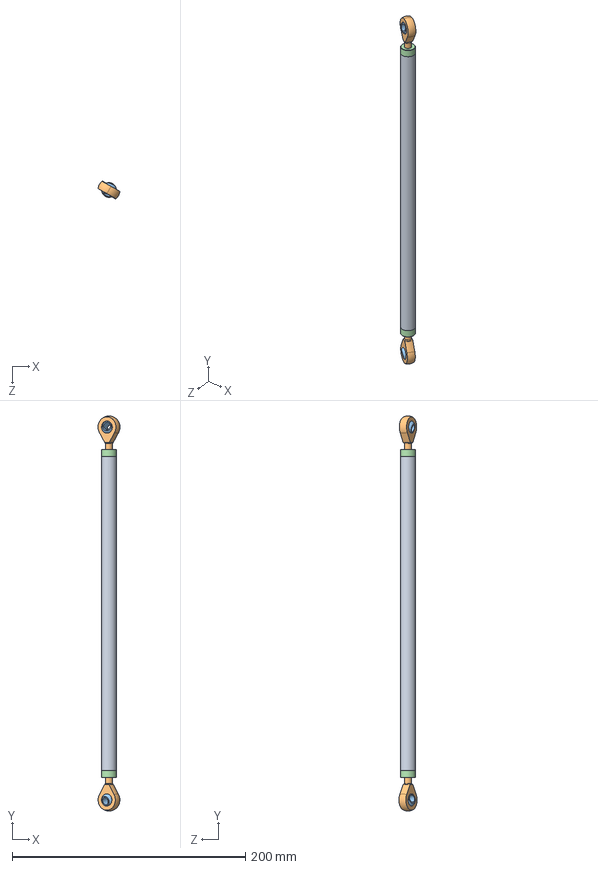
[picture p36: CAD file, 2023-10-22]
Unsprung/Suspension/FE10/Tie-Rod Assembly/Front/SP-####-AA-Front Tie Rod Assembly.SLDASM
18.9 x 339.0 x 15.6 mm
SP-####-AA-Front Tie Rod
Body^FS-MALE ROD END UNF-3A, 0.25x28-0.25D (AM-4) x 2
Ball^FS-MALE ROD END UNF-3A, 0.25x28-0.25D (AM-4) x 2
SP-10003-AC-Threaded Insert x 2
