FormulaRacingatUCDavis/FE11_CAD/Powertrain/Accumulator/Components/Container/Chassis Mounts/AC-A0204-AA-Chassis Side Mount Assembly.SLDASM

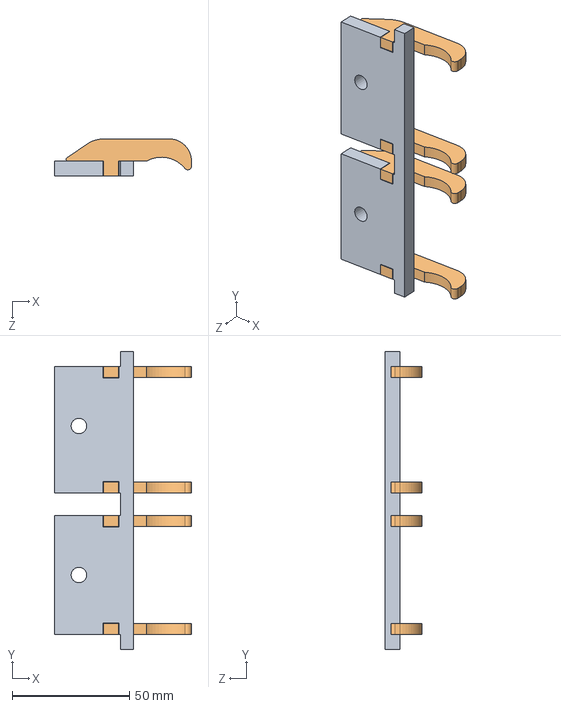
[picture p37: CAD file, 2024-02-17]
Powertrain/Accumulator/Components/Container/Chassis Mounts/AC-A0204-AA-Chassis Side Mount Assembly.SLDASM
58.4 x 127.0 x 15.9 mm
AC-30039-AA-Side Chassis Mounts
AC-30041-AA-Side Mount Gusset x 4
