FormulaRacingatUCDavis/FE11_CAD/Powertrain/Accumulator/Components/Power Electronics/Cables/AC-00022-AA-Left Maintenance Cable.SLDPRT

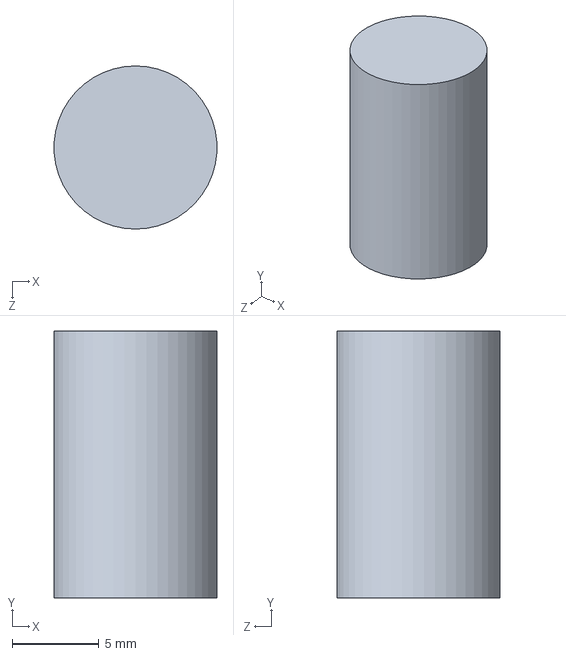
[picture p38: CAD file, 2024-02-17]
Powertrain/Accumulator/Components/Power Electronics/Cables/AC-00022-AA-Left Maintenance Cable.SLDPRT
9.38 x 15.4 x 9.40 mm
