FormulaRacingatUCDavis/FE11_CAD/Powertrain/Drivetrain/Components/Half Shafts/EN-00031-AB-RCV Tripod.SLDASM

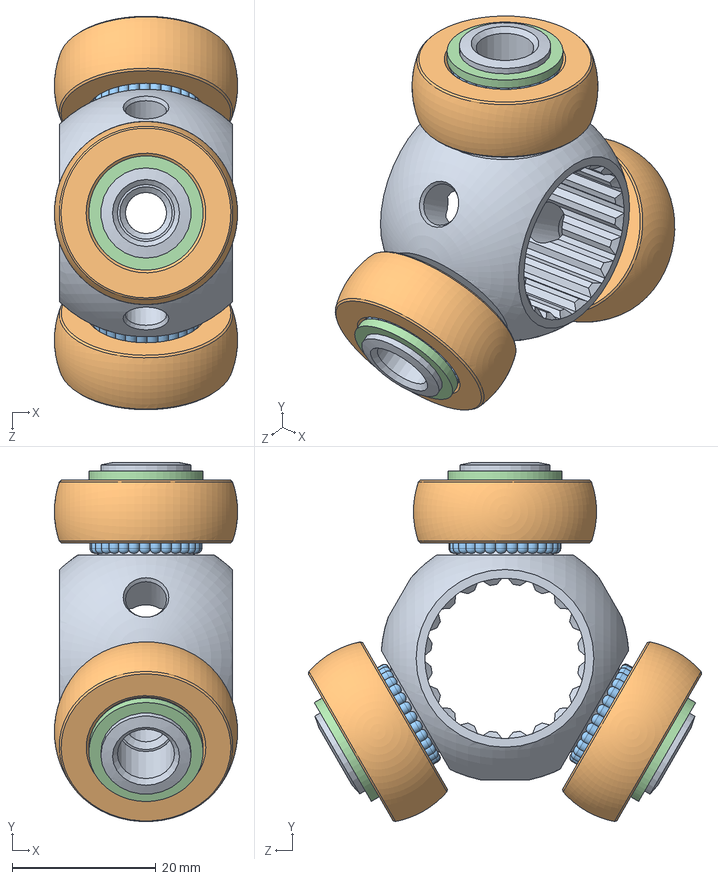
[picture p39: CAD file, 2023-10-24]
Powertrain/Drivetrain/Components/Half Shafts/EN-00031-AB-RCV Tripod.SLDASM
25.5 x 49.9 x 54.7 mm
FSAE Tripod V2_1^EN-00031-AB-RCV Tripod
FSAE roller_2451_2^EN-00031-AB-RCV Tripod x 3
needle^EN-00031-AB-RCV Tripod x 87
Tripod Retainer^EN-00031-AB-RCV Tripod x 3
