FormulaRacingatUCDavis/FE11_CAD/Unsprung/Controls/CN-A0101-AA-Tie Rod Front.SLDASM

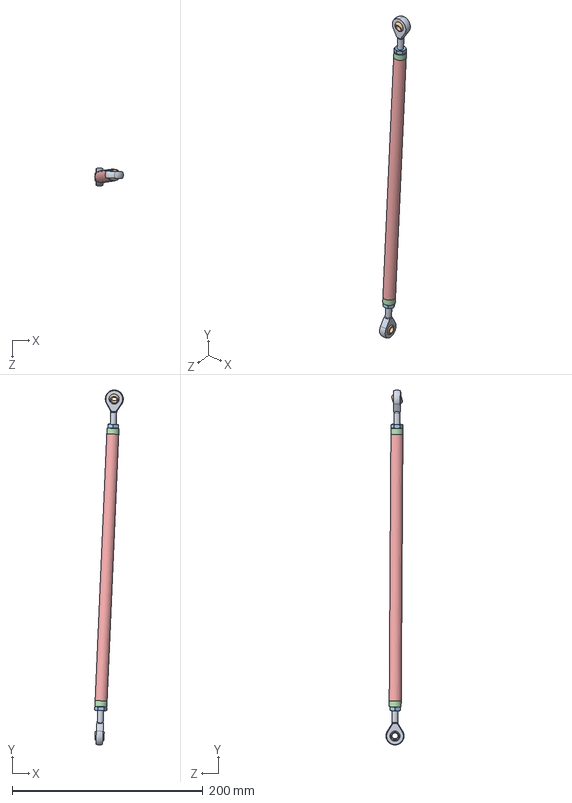
[picture p40: CAD file, 2023-09-12]
Unsprung/Controls/CN-A0101-AA-Tie Rod Front.SLDASM
30.2 x 372.7 x 19.0 mm
Body^FS-MALE ROD END UNF-3A, 0.25x28-0.25D (AM-4) x 2
Ball^FS-MALE ROD END UNF-3A, 0.25x28-0.25D (AM-4) x 2
FS-ZINC YELLOW THIN NUT G8 HX, 0.25x28-0.15625 (93839A805) x 2
SP-10003-AC-Threaded Insert x 2
Tie Rod Front
