FormulaRacingatUCDavis/FE11_CAD/Unsprung/Controls/Pedal Box/Accelerator Pedal/BR-10001-BA-Accel Pedal Assembly.SLDASM

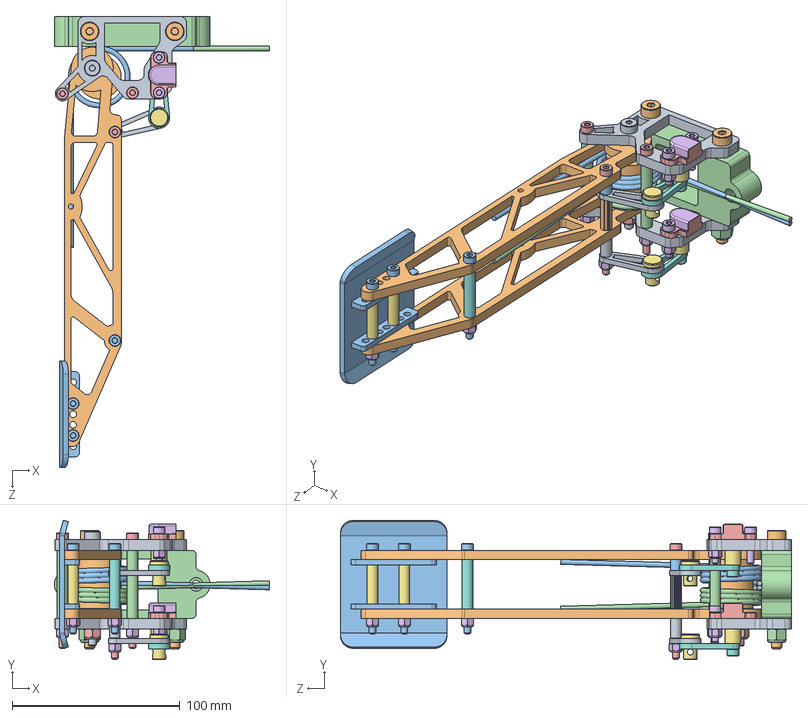
[picture p41: CAD file, 2023-11-05]
Unsprung/Controls/Pedal Box/Accelerator Pedal/BR-10001-BA-Accel Pedal Assembly.SLDASM
128.4 x 83.1 x 268.9 mm
BR-1000X-AC-Accel Pedal Mount x 2
BR-2000X-AE-Accel Pedal Arm x 2
BR-30003-BE-Accel Toe Plate
BR-0000X-AA-AP Mount Spacer x 2
4048_carcasa MSC-360-G01-001^MSC-360_BR-0000X-AA-APPS (MSC360-1A-C0004-ERA360-05K) x 2
3982_apantallamiento^MSC-360_BR-0000X-AA-APPS (MSC360-1A-C0004-ERA360-05K) x 2
BR-0000X-AC-APPS Linkage Barrel x 2
BR-0000X-AC-APPS Linkage Vert Arm x 2
BR-0000X-AC-APPS Linkage Connect Arm x 2
BR-X000X-BB-Torsion Spring Shaft
BR-AD-Torsion Spring (9271K663)
BR-AD-Torsion Spring, Left Wound (9271K597)
BR-Black Oxide C12.9 SHCS, M4x0.7-65 (91290A083) x 3
BR-Steel Nylon Locknut, Grade 8, M4x0.7 (90576A103) x 8
1004-1045 Carbon Steel Clevis Pin (98306A210) x 3
BR-Black Oxide C12.9 SHCS, M4x0.7-8 (91290A140) x 2
BR-Alloy Steel Shoulder B18.3 SHCS, 0.25x10-24, 2.125 in (91259A474)
BR-Alloy Steel Shoulder B18.3 SHCS, 0.3125x0.25-20, 2.125 in Lg (91259A480) x 2
BR-Black Oxide C12.9 SHCS, M4x0.7-50 (91290A186) x 3
BR-Steel Nylon Locknut, Grade 8, 0.25-20 (90630A110) x 2
BR-Stainless Steel Nylon Locknut, 10-24 (91831A011)
BR-Black Oxide C12.9 SHCS, M4x0.7-18 (91290A164) x 3
BR-0000X-AA-AP Toe Plate Spacer x 2
BR-0000X-AA-AP Arm Spacer
BR-0000X-AA-APPS Spacer, Left
BR-0000X-AA-APPS Spacer, Mid
BR-0000X-AA-APPS Spacer, Right
BR-0000X-CB-Accel Pedal Platform
