FormulaRacingatUCDavis/FE11_CAD/Unsprung/Controls/Pedal Box/Brake Pedal/Components/BPPS/BR-00009-AA-BPPS.SLDASM

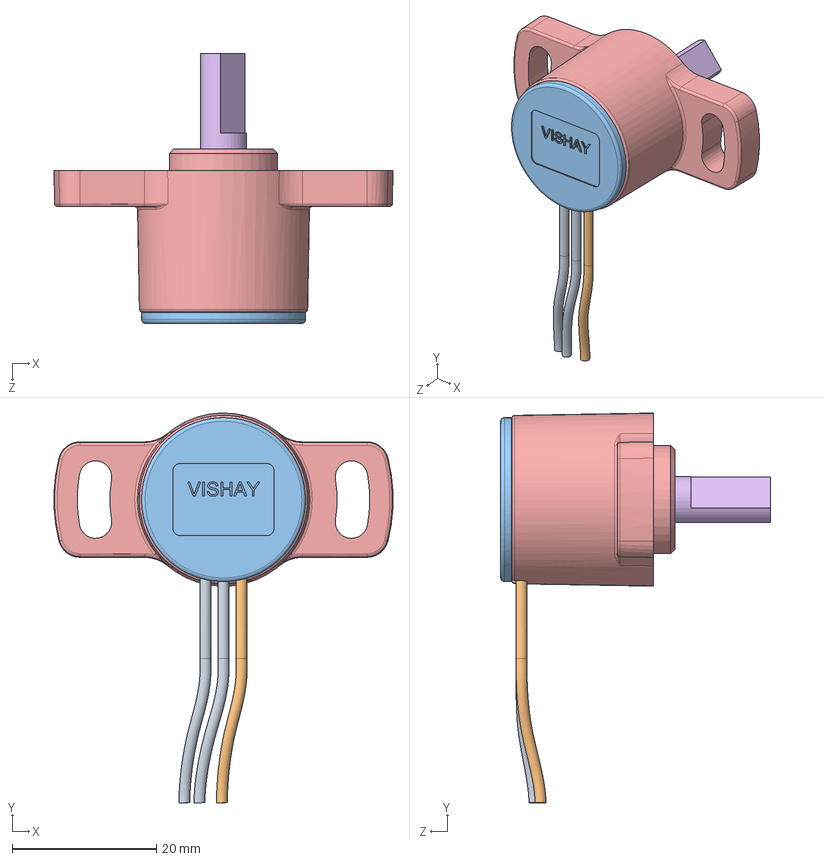
[picture p44: CAD file, 2023-09-12]
Unsprung/Controls/Pedal Box/Brake Pedal/Components/BPPS/BR-00009-AA-BPPS.SLDASM
46.9 x 54.0 x 37.3 mm
fil^981HE-0-W-A-8H01_-_BR-00008-AA-BPPS x 2
fil-oa0^981HE-0-W-A-8H01_-_BR-00008-AA-BPPS
cc00273_-^981HE-0-W-A-8H01_-_BR-00008-AA-BPPS
cn00253^981HE-0-W-A-8H01_-_BR-00008-AA-BPPS
CB00527b^981HE-0-W-A-8H01_-_BR-00008-AA-BPPS
Copy of BPPS Shaft^BR-00008-AA-BPPS
