FormulaRacingatUCDavis/FE11_CAD/Unsprung/Controls/Pedal Box/Brake Pedal/Components/Master Cylinder/BR-00004-AA-Master Cylinder (Tilton 78 Series).SLDASM

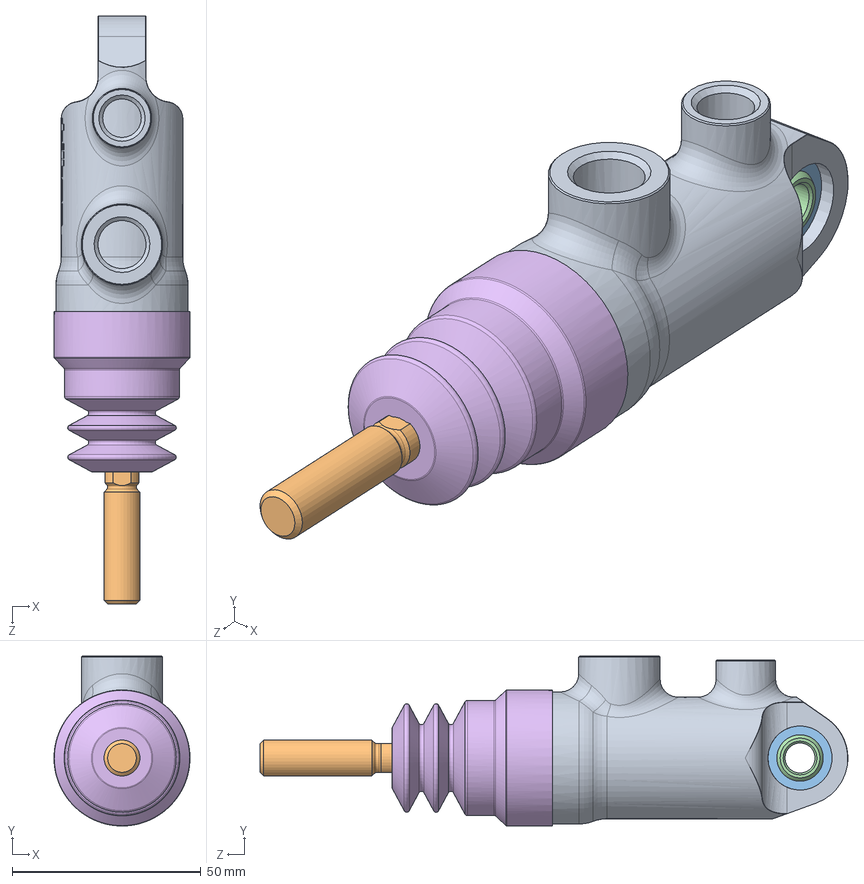
[picture p45: CAD file, 2023-09-12]
Unsprung/Controls/Pedal Box/Brake Pedal/Components/Master Cylinder/BR-00004-AA-Master Cylinder (Tilton 78 Series).SLDASM
36.1 x 45.1 x 155.9 mm
Body^BR-00004-AA-Master Cylinder (Tilton 78 Series)
Piston^BR-00004-AA-Master Cylinder (Tilton 78 Series)
Copy of spherical bearing outer^Copy of Spherical Bearing_BR-00004-AA-Master Cylinder (Tilton 78 Series)
Copy of spherical bearing inner^Copy of Spherical Bearing_BR-00004-AA-Master Cylinder (Tilton 78 Series)
Circlip^BR-00004-AA-Master Cylinder (Tilton 78 Series)
Rubber Boot^BR-00004-AA-Master Cylinder (Tilton 78 Series)
