FormulaRacingatUCDavis/FE11_CAD/Unsprung/Controls/Steering/Ackermann Testing/Assem1.SLDASM

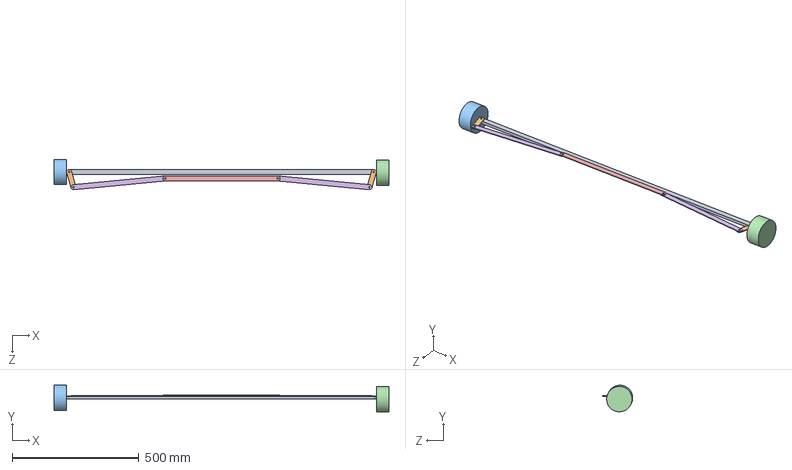
[picture p46: CAD file, 2023-10-22]
Unsprung/Controls/Steering/Ackermann Testing/Assem1.SLDASM
1319.2 x 105.0 x 120.0 mm
Part2^Assem1
Part4^Assem1 x 2
Part6^Assem1
Part8^Assem1
Part9^Assem1
Part10^Assem1 x 2
