FormulaRacingatUCDavis/FE11_CAD/Unsprung/Controls/Steering/Components/Rack Mount Spacer/ST-4000X-AA-Steering Rack Tab Box.SLDASM

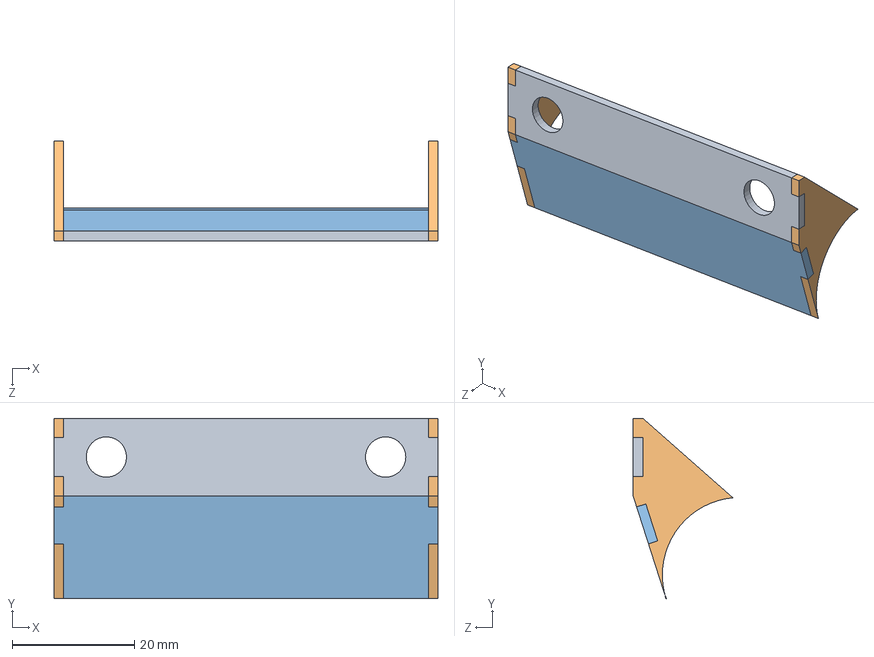
[picture p47: CAD file, 2023-09-12]
Unsprung/Controls/Steering/Components/Rack Mount Spacer/ST-4000X-AA-Steering Rack Tab Box.SLDASM
62.9 x 29.5 x 16.4 mm
Rack Mount Spacer - Top Mount
Rack Mount Spacer - Side Supports x 2
Rack Mount Spacer - Back Support
