FormulaRacingatUCDavis/FE11_CAD/Unsprung/Controls/Steering/Components/U-Joint/ST-00007-AA-SU Joint Borgeson.SLDASM

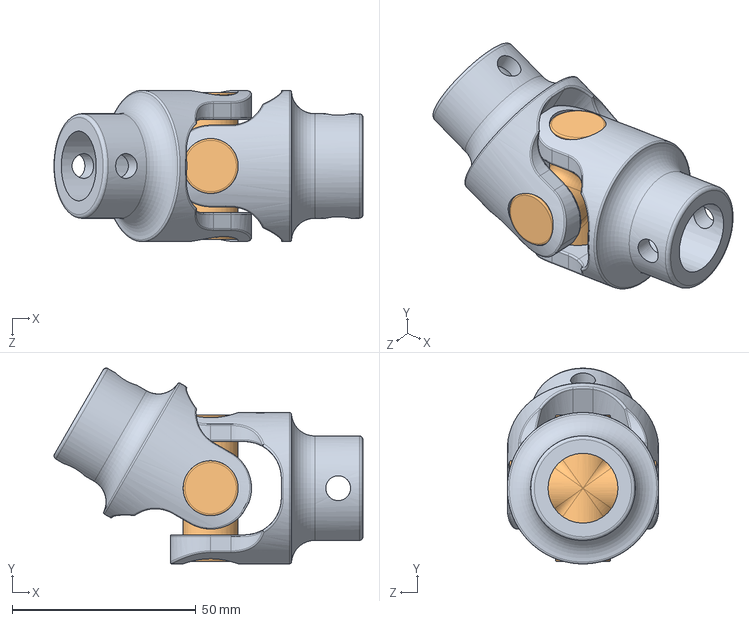
[picture p48: CAD file, 2024-09-13]
Unsprung/Controls/Steering/Components/U-Joint/ST-00007-AA-SU Joint Borgeson.SLDASM
84.2 x 53.3 x 41.2 mm
Clevis^ST-00007-AA-SU Joint Borgeson x 2
Joint^ST-00007-AA-SU Joint Borgeson
