FormulaRacingatUCDavis/FE11_CAD/Unsprung/Suspension/Assemblies/Front A-Arms/SP-AB- Front Upper A-Arms.SLDASM

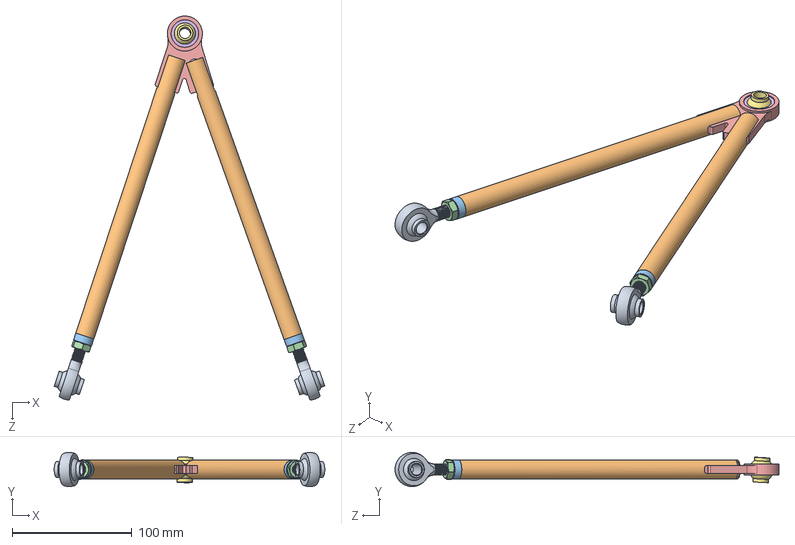
[picture p49: CAD file, 2024-04-30]
Unsprung/Suspension/Assemblies/Front A-Arms/SP-AB- Front Upper A-Arms.SLDASM
226.3 x 28.6 x 321.0 mm
6960T231_Super-Swivel Ball Joint Rod End x 2
SP-FR Upper A-Arm Tube x 2
SP-10003-AD-Threaded Insert x 2
FS-ZINC YELLOW THIN NUT G8 HX, 0.375x24-0.21875 (93839A815) x 2
SP-Upper Apex Front
Race^FS-High Misalign Spherical Bearing, 0.375 (HAB-6TG)
Ball^FS-High Misalign Spherical Bearing, 0.375 (HAB-6TG)
