FormulaRacingatUCDavis/FE11_CAD/Unsprung/Suspension/Assemblies/Rear A-Arms/SP - Rear Lower A-Arms.SLDASM

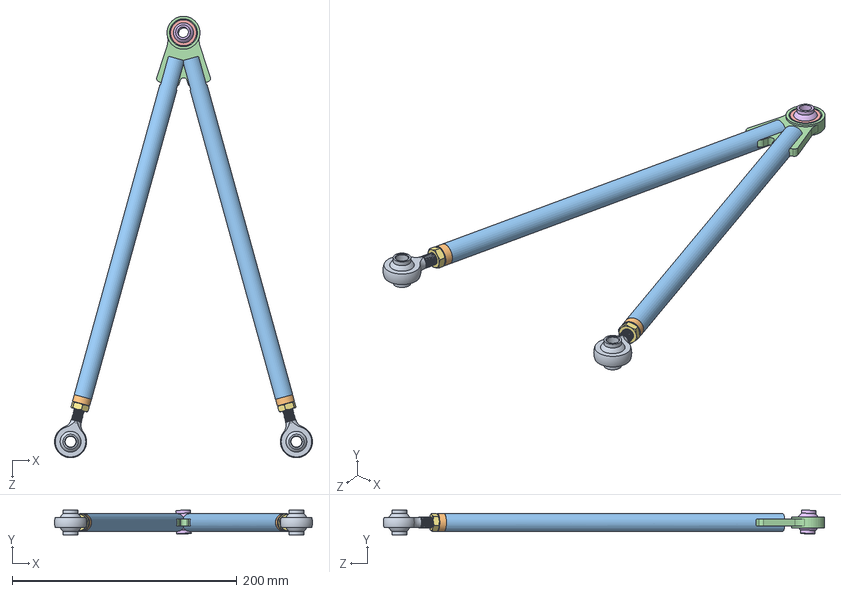
[picture p50: CAD file, 2024-04-30]
Unsprung/Suspension/Assemblies/Rear A-Arms/SP - Rear Lower A-Arms.SLDASM
229.5 x 22.2 x 392.7 mm
6960T231_Super-Swivel Ball Joint Rod End x 2
SP-10003-AD-Threaded Insert x 2
SP-RR Lower A-Arm Tube x 2
SP-10052-AD-Lower Apex R
Race^FS-High Misalign Spherical Bearing, 0.375 (HAB-6TG)
Ball^FS-High Misalign Spherical Bearing, 0.375 (HAB-6TG)
FS-ZINC YELLOW THIN NUT G8 HX, 0.375x24-0.21875 (93839A815) x 2
