FormulaRacingatUCDavis/FE11_CAD/Unsprung/Suspension/Assemblies/SP-A0100-AB-Rear A-Arm Assembly.SLDASM

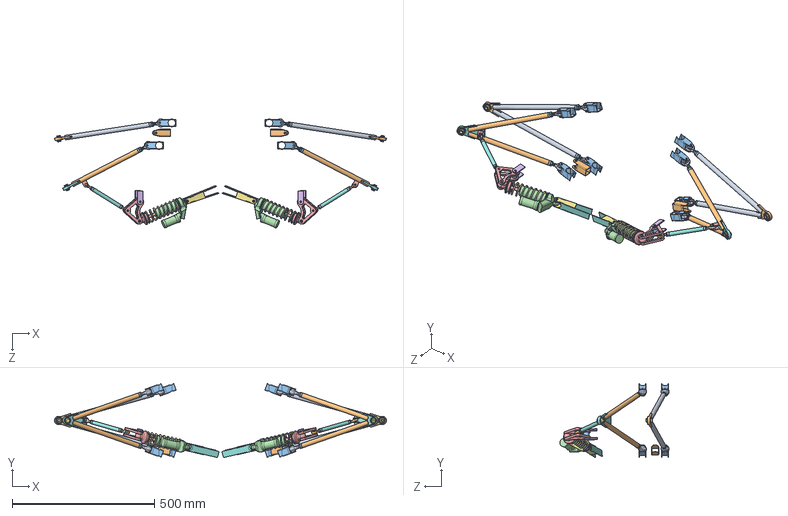
[picture p51: CAD file, 2024-03-02]
Unsprung/Suspension/Assemblies/SP-A0100-AB-Rear A-Arm Assembly.SLDASM
1168.5 x 261.0 x 384.7 mm
6960T231_Super-Swivel Ball Joint Rod End x 8
SP-RR Upper A-Arm Tube x 4
SP-10003-AD-Threaded Insert x 8
FS-ZINC YELLOW THIN NUT G8 HX, 0.375x24-0.21875 (93839A815) x 8
SP-30063-AB-Pushrod Tab x 4
Race^FS-High Misalign Spherical Bearing, 0.375 (HAB-6TG) x 4
Ball^FS-High Misalign Spherical Bearing, 0.375 (HAB-6TG) x 4
SP-10052-AB-Upper Apex R x 2
SP-RR Lower A-Arm Tube x 4
SP-10052-AD-Lower Apex R x 2
SP-C30066-AA-A-Arm Tab Box x 8
Shock Body^SP-A0105-AC-Ohlin TTX25 MKII, 200mm x 2
Head^SP-A0105-AC-Ohlin TTX25 MKII, 200mm x 2
Ball^SP-A0105-AC-Ohlin TTX25 MKII, 200mm x 4
SP-#####-AB-Spring x 2
SP-10071-AC-P Rod Tube R x 2
SP-10003-AC-Threaded Insert x 4
Body^FS-MALE ROD END UNF-3A, 0.25x28-0.25D (AM-4) x 4
Ball^FS-MALE ROD END UNF-3A, 0.25x28-0.25D (AM-4) x 4
FS-ZINC YELLOW THIN NUT G8 HX, 0.25x28-0.15625 (93839A805) x 4
SP-20001-BB-Rear Rocker x 4
SP-A0200-Front Rocker Tab Box x 4
SP-30034-AB-Front Shock Tab x 4
SP-30035-AA-Front Shock Gusset Tab x 4
6391K334_Oil-Embedded Bronze Sleeve Bearing x 2
MirrorSP-C30066-AA-A-Arm Tab Box x 2
92510A802_Aluminum Unthreaded Spacer x 2
