FormulaRacingatUCDavis/FE11_CAD/Unsprung/Suspension/Components/Push Rods/SP-10011-BA-Push Rod Front.SLDASM

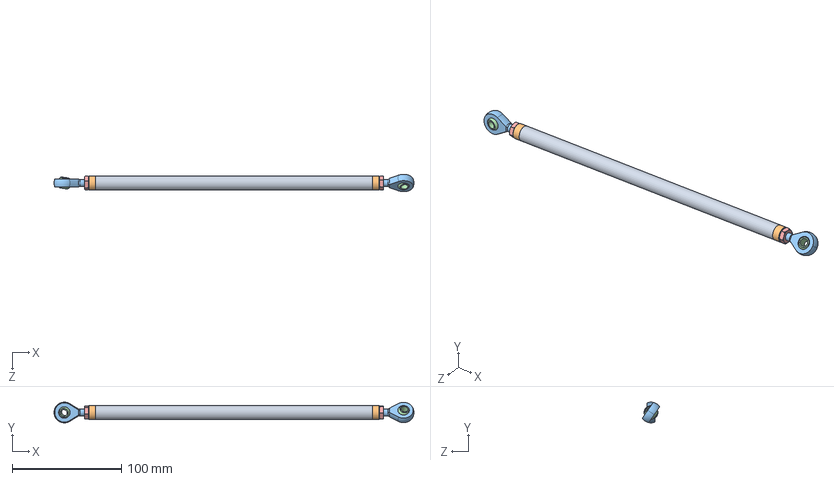
[picture p53: CAD file, 2024-04-30]
Unsprung/Suspension/Components/Push Rods/SP-10011-BA-Push Rod Front.SLDASM
330.2 x 19.0 x 16.0 mm
Part4^SP-10011-BA-Push Rod Front
SP-10003-AC-Threaded Insert x 2
Body^FS-MALE ROD END UNF-3A, 0.25x28-0.25D (AM-4) x 2
Ball^FS-MALE ROD END UNF-3A, 0.25x28-0.25D (AM-4) x 2
FS-ZINC YELLOW THIN NUT G8 HX, 0.25x28-0.15625 (93839A805) x 2
