FormulaRacingatUCDavis/FE11_CAD/Unsprung/Suspension/Components/Shocks/Shock Tabs/SP-A0106-AC-Front Shock Tab Box.SLDASM

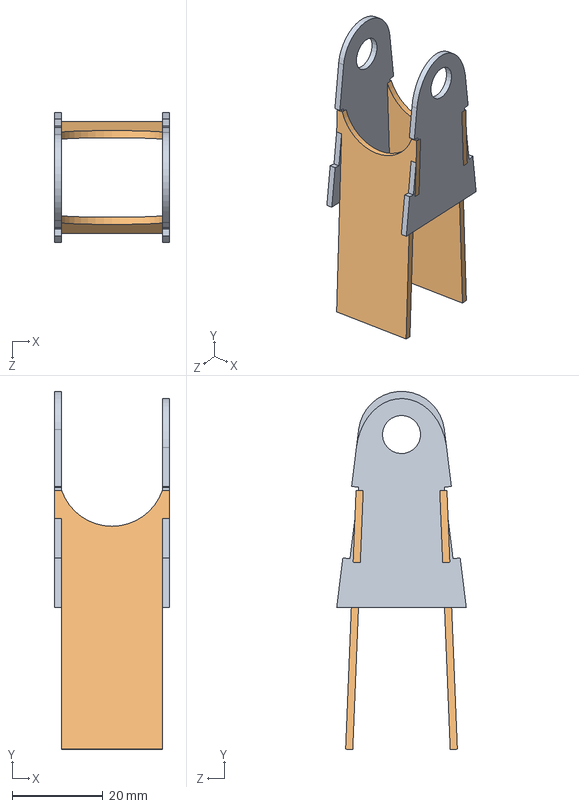
[picture p54: CAD file, 2024-04-30]
Unsprung/Suspension/Components/Shocks/Shock Tabs/SP-A0106-AC-Front Shock Tab Box.SLDASM
25.4 x 79.0 x 28.6 mm
SP-30034-AC-Front Shock Tab x 2
SP-30035-AA-Front Shock Gusset Tab x 2
