FormulaRacingatUCDavis/FE11_CAD/Unsprung/Suspension/FE10/Soft Jaws/Rockers/REAR ROCKER SJ ASSEMBLY.SLDASM

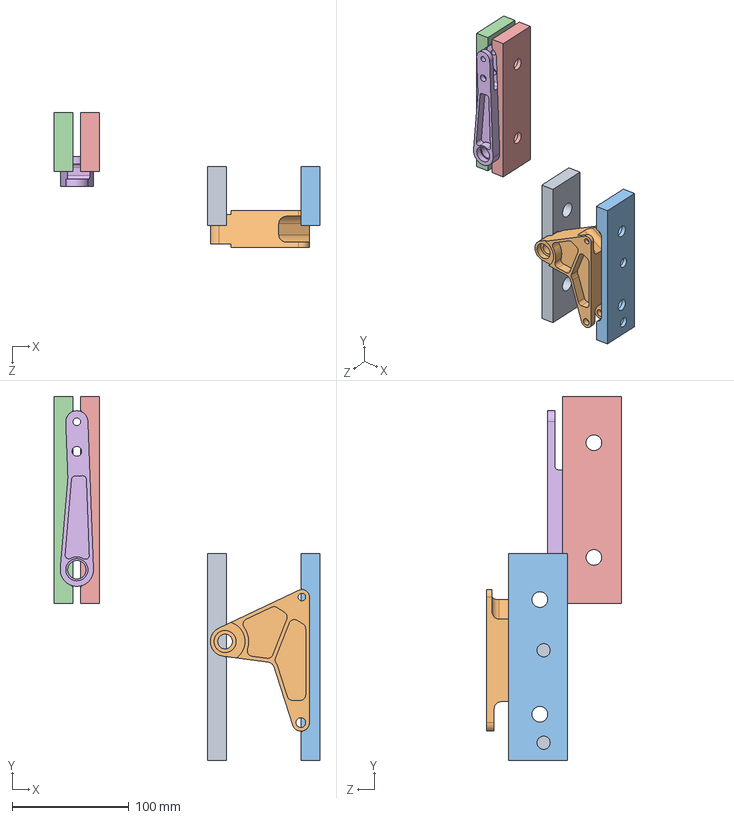
[picture p55: CAD file, 2023-10-22]
Unsprung/Suspension/FE10/Soft Jaws/Rockers/REAR ROCKER SJ ASSEMBLY.SLDASM
228.0 x 312.4 x 116.2 mm
SJ-Rear Rocker 1
WATERJET-REAR-ROCKER
SJ-Rear Rocker 2
SJ-Front Rocker 1
SJ-Front Rocker 2
SP-Front Rocker
