FormulaRacingatUCDavis/FE11_CAD/Unsprung/Suspension/FE10/Tie-Rod Assembly/Rear/SP-####-AA-Rear Tie Rod Assem.SLDASM

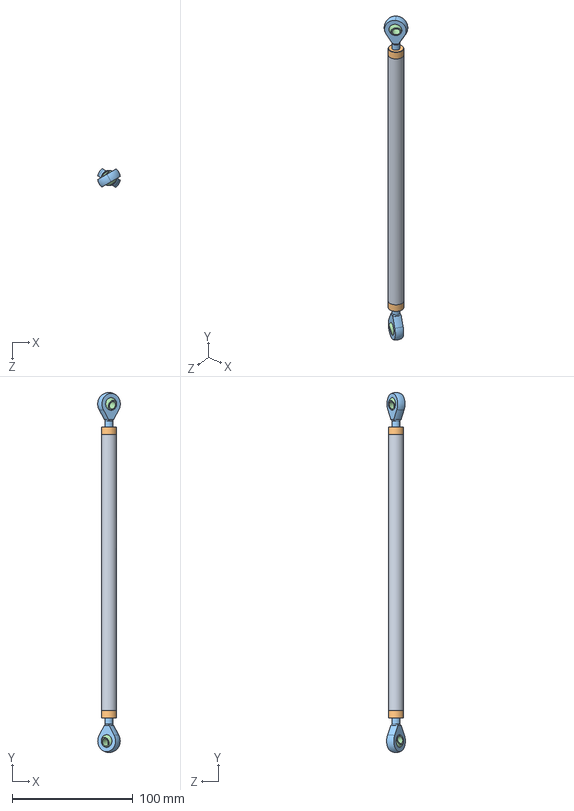
[picture p56: CAD file, 2023-10-22]
Unsprung/Suspension/FE10/Tie-Rod Assembly/Rear/SP-####-AA-Rear Tie Rod Assem.SLDASM
18.9 x 298.7 x 15.6 mm
SP-####-AA-Rear Tie Rod
SP-10003-AC-Threaded Insert x 2
Body^FS-MALE ROD END UNF-3A, 0.25x28-0.25D (AM-4) x 2
Ball^FS-MALE ROD END UNF-3A, 0.25x28-0.25D (AM-4) x 2
