FormulaRacingatUCDavis/FE11_CAD/Powertrain/Accumulator/Components/Power Electronics/3D Prints/AC-50045-AA-Middle Maintenance Plugs Divider.SLDPRT

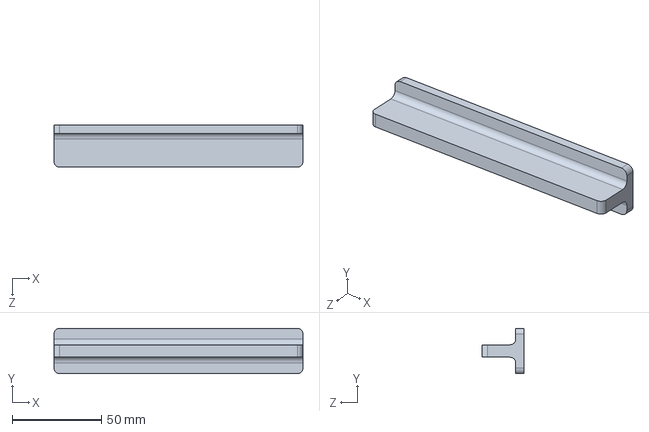
[picture p57: CAD file, 2024-04-30]
Powertrain/Accumulator/Components/Power Electronics/3D Prints/AC-50045-AA-Middle Maintenance Plugs Divider.SLDPRT
139.7 x 25.4 x 23.8 mm
