FormulaRacingatUCDavis/FE11_CAD/Powertrain/Accumulator/Components/Power Electronics/Cables/AC-00019-AA-Negative Maintenance Cable.SLDPRT

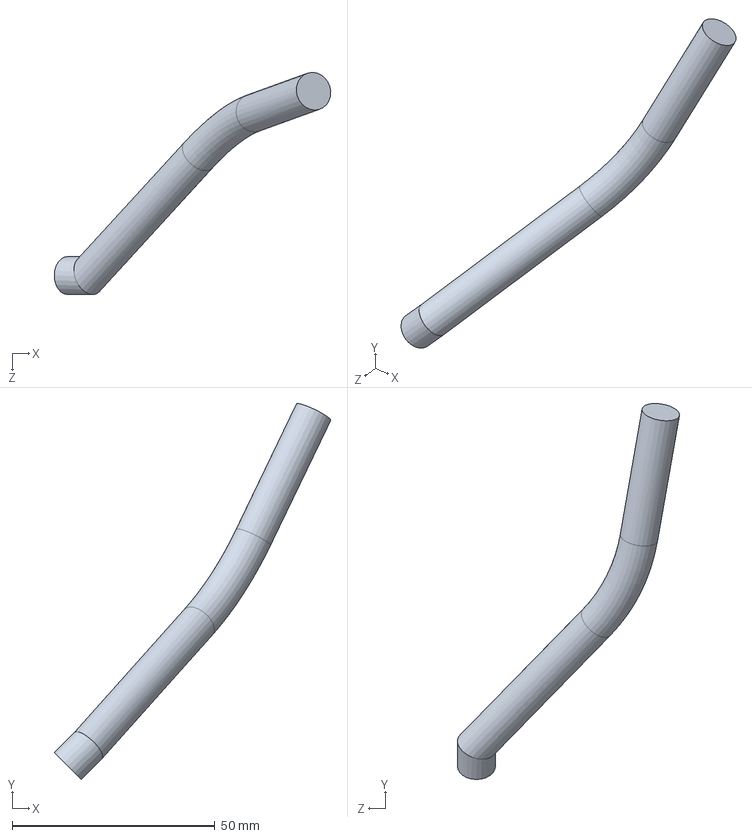
[picture p58: CAD file, 2024-02-17]
Powertrain/Accumulator/Components/Power Electronics/Cables/AC-00019-AA-Negative Maintenance Cable.SLDPRT
68.2 x 92.7 x 54.8 mm
