FormulaRacingatUCDavis/FE11_CAD/Powertrain/Accumulator/Components/Power Electronics/Electronics/AC-00017-AA-Surlock Plus Maintenance Plugs.SLDPRT

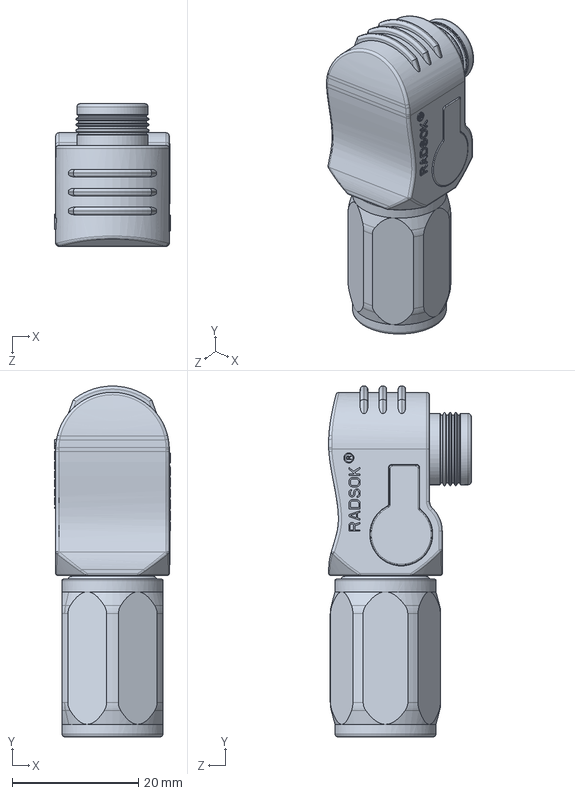
[picture p59: CAD file, 2024-02-17]
Powertrain/Accumulator/Components/Power Electronics/Electronics/AC-00017-AA-Surlock Plus Maintenance Plugs.SLDPRT
18.4 x 55.6 x 22.6 mm
