FormulaRacingatUCDavis/FE11_CAD/Powertrain/Cooling/Components/Fittings/Tee Adapter Subassembly.SLDASM

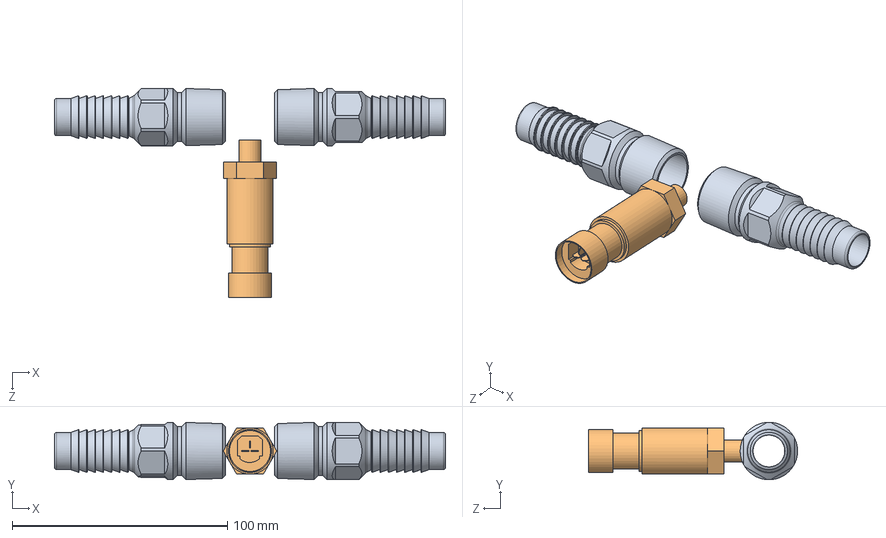
[picture p60: CAD file, 2024-04-30]
Powertrain/Cooling/Components/Fittings/Tee Adapter Subassembly.SLDASM
181.6 x 26.7 x 97.2 mm
EN10111-AA-0.75in Easy-Fit Barbed Hose Fitting (5363K52) x 2
EN-10202-AA-Pressure and Temperature Transducer, Transducers Direct
