FormulaRacingatUCDavis/FE11_CAD/Powertrain/Cooling/Components/Radiators/EN-A0201-AA-4x Koolance Radiator Assembly.SLDASM

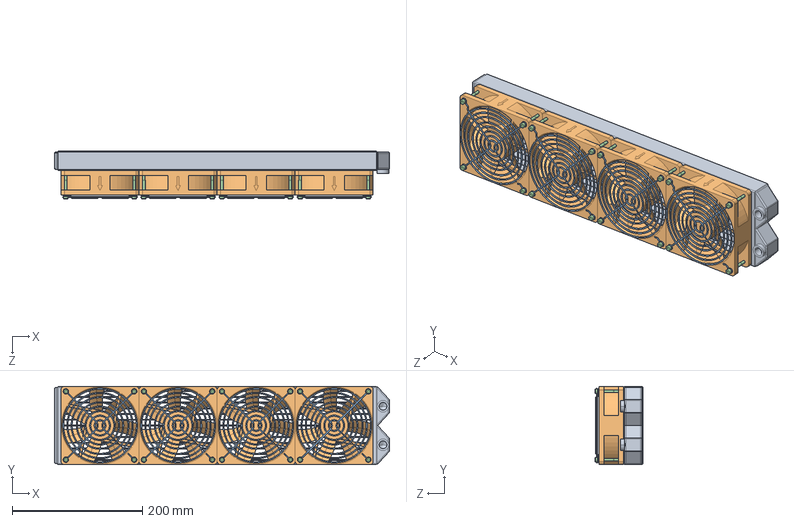
[picture p61: CAD file, 2024-04-30]
Powertrain/Cooling/Components/Radiators/EN-A0201-AA-4x Koolance Radiator Assembly.SLDASM
515.0 x 120.1 x 73.3 mm
EN-00045-AA-CU1320V
EN-00046-12038HBK-184 (Fan) x 4
EN-00078-AA-GRL-AP002P (Grill) x 4
FS-BLACK-OXIDE C12.9 SHCS, M4x0.7-45 (91290A145) x 16
