FormulaRacingatUCDavis/FE11_CAD/Unsprung/Controls/DXF/Rack Mount Assembly.DXF

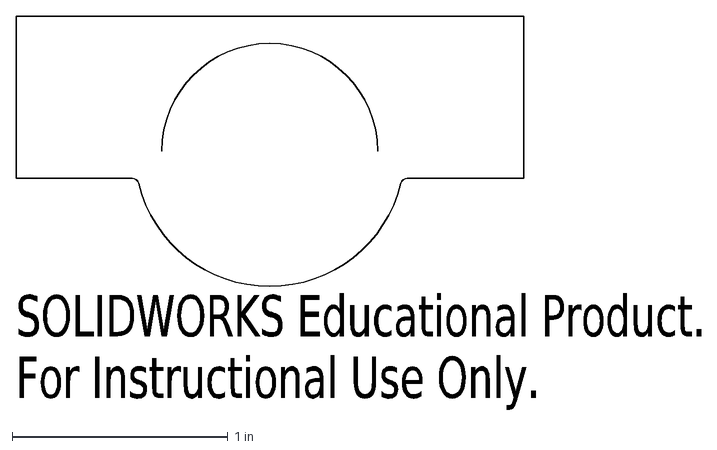
[picture p62: CAD file, 2024-01-08]
Unsprung/Controls/DXF/Rack Mount Assembly.DXF
SOLIDWORKS Educational Product.
For Instructional Use Only.
