FormulaRacingatUCDavis/FE11_CAD/Unsprung/Controls/Pedal Box/BR-A10001-AD-Pedal Box Assembly.SLDASM

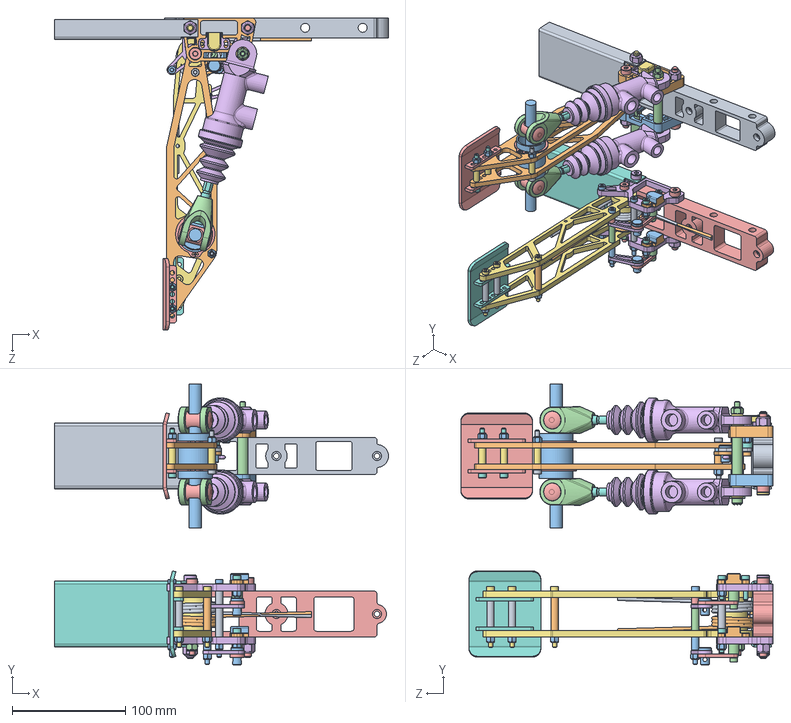
[picture p63: CAD file, 2023-09-12]
Unsprung/Controls/Pedal Box/BR-A10001-AD-Pedal Box Assembly.SLDASM
295.3 x 248.1 x 276.2 mm
BR-X000X-AE-Brake Pedal Platform
BR-20002-AG-Brake Pedal Arm x 2
Copy of Bar^BR-00005-AA-Balance Bar (Tilton 600 Series)
BB Arm^BR-00005-AA-Balance Bar (Tilton 600 Series) x 2
BB Bullet^BR-00005-AA-Balance Bar (Tilton 600 Series) x 2
Main Body^BR-00004-AB-CP7855 Master Cylinder x 2
Spherical Mount^BR-00004-AB-CP7855 Master Cylinder x 2
Threaded Piston^BR-00004-AB-CP7855 Master Cylinder x 2
BR-00001-BC-Heel Plate
BR-10001-BE-Brake Pedal Mount (Left)
BR-10001-BF-Brake Pedal Mount (Right)
FR-00006-AA-BOTS M2011SD3W01
BR-30003-BF-Toe Plate
4048_carcasa MSC-360-G01-001^MSC-360_BR-00009-DA-BPPS (MSC360-1A-C0004-ERA360-05K)
3982_apantallamiento^MSC-360_BR-00009-DA-BPPS (MSC360-1A-C0004-ERA360-05K)
BR-00012-AA-BPPS Linkage Barrel
BR-00010-AC-BPPS Linkage A
BR-00011-AC-BPPS Linkage B
BR-Steel Nylon Locknut, Grade 8, M4x0.7 (90576A103) x 14
BR-Alloy Steel Shoulder B18.3 SHCS, 0.25x10-24, 3 in Lg (91259A106)
BR-Alloy Steel Shoulder B18.3 SHCS, 0.3125x0.25-20, 2.125 in Lg (91259A480) x 3
BR-Steel Nylon Locknut, Grade 8, 0.25-20 (90630A110) x 5
BR-Alloy Steel Shoulder B18.3 SHCS, 0.3125x0.25-20, 2.25 in (91259A108)
FS-BLACK OXIDE C12.9 SHCS, M4x0.7-40 (91290A184) x 2
BR-Black Oxide C12.9 SHCS, M4x0.7-35 (91290A173) x 2
BR-Black Oxide C12.9 SHCS, M4x0.7-12 (91290A148)
1004-1045 Carbon Steel Clevis Pin (98306A210) x 4
BR-Stainless Steel Nylon Locknut, 10-24 (91831A011) x 2
BR-Spring Steel External Retaining Ring, 1.176 ID (97633A340) x 2
BR-Zinc-Plated 1004-1045 Carbon Steel Cotter Pins, 0.5 Lg (98338A170)
BR-0000X-AC-Toe Plate Spacer x 3
BR-0000X-AC-Brake Pedal Arm Spacer, Mid
BR-0000X-AC-Brake Pedal Arm Spacer, Sides x 2
BR-0000X-AA-BPPS Spacer, Long
BR-0000X-AA-BPPS Spacer, Short
BR-0000X-AB-Brake Mount Spacer
BR-0000X-BD-Accel Pedal Platform
BR-1000X-AC-Accel Pedal Mount x 2
BR-2000X-AE-Accel Pedal Arm x 2
BR-30003-BE-Accel Toe Plate
BR-0000X-AA-AP Mount Spacer x 2
4048_carcasa MSC-360-G01-001^MSC-360_BR-0000X-AA-APPS (MSC360-1A-C0004-ERA360-05K) x 2
3982_apantallamiento^MSC-360_BR-0000X-AA-APPS (MSC360-1A-C0004-ERA360-05K) x 2
BR-0000X-AC-APPS Linkage Barrel x 2
BR-0000X-AC-APPS Linkage Vert Arm x 2
BR-0000X-AC-APPS Linkage Connect Arm x 2
BR-X000X-BB-Torsion Spring Shaft
BR-00001-BD-Heel Plate
BR-AD-Torsion Spring (9271K663)
BR-AD-Torsion Spring, Left Wound (9271K597)
BR-Black Oxide C12.9 SHCS, M4x0.7-65 (91290A083) x 3
BR-Black Oxide C12.9 SHCS, M4x0.7-8 (91290A140) x 2
BR-Alloy Steel Shoulder B18.3 SHCS, 0.25x10-24, 2.125 in (91259A474)
BR-Alloy Steel Shoulder B18.3 SHCS, 0.3125x0.25-20, 2.25 in Lg (91259A108)
BR-Black Oxide C12.9 SHCS, M4x0.7-50 (91290A186) x 3
BR-Black Oxide C12.9 SHCS, M4x0.7-18 (91290A164) x 3
BR-0000X-AA-AP Toe Plate Spacer x 2
BR-0000X-AA-AP Arm Spacer
BR-0000X-AA-APPS Spacer, Left
BR-0000X-AA-APPS Spacer, Mid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
