FormulaRacingatUCDavis/FE11_CAD/Unsprung/Controls/Pedal Box/Brake Pedal/Components/BPPS/BR-00009-DA-BPPS (MSC360-1A-C0004-ERA360-05K).SLDASM

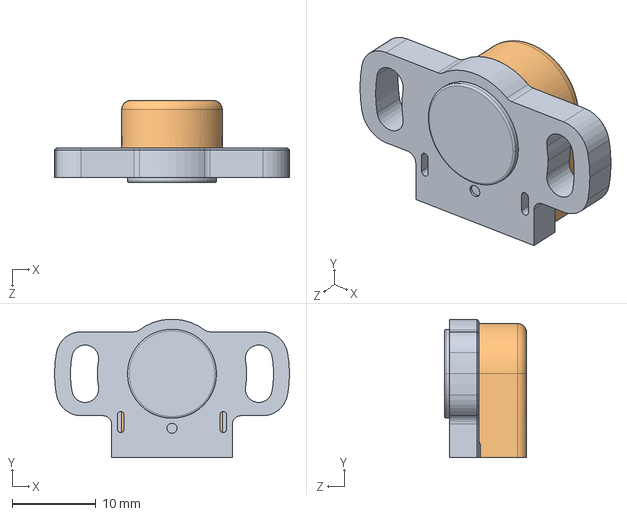
[picture p65: CAD file, 2023-09-12]
Unsprung/Controls/Pedal Box/Brake Pedal/Components/BPPS/BR-00009-DA-BPPS (MSC360-1A-C0004-ERA360-05K).SLDASM
28.0 x 16.5 x 9.80 mm
4048_carcasa MSC-360-G01-001^MSC-360_BR-00009-DA-BPPS (MSC360-1A-C0004-ERA360-05K)
3982_apantallamiento^MSC-360_BR-00009-DA-BPPS (MSC360-1A-C0004-ERA360-05K)
