FormulaRacingatUCDavis/FE11_CAD/Unsprung/Suspension/Assemblies/Front A-Arms/SP - Front Upper A-Arms.SLDASM

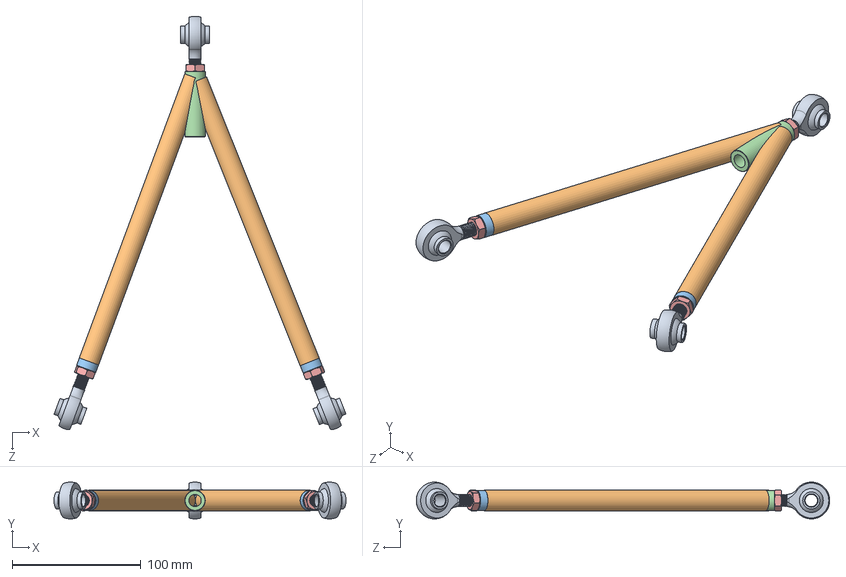
[picture p67: CAD file, 2023-11-03]
Unsprung/Suspension/Assemblies/Front A-Arms/SP - Front Upper A-Arms.SLDASM
226.4 x 28.6 x 320.7 mm
6960T231_Super-Swivel Ball Joint Rod End x 3
SP-FR Upper A-Arm Tube x 2
SP-10003-AD-Threaded Insert x 2
SP-10004-AA-Outer Threaded Insert
FS-ZINC YELLOW THIN NUT G8 HX, 0.375x24-0.21875 (93839A815) x 3
