FormulaRacingatUCDavis/FE11_CAD/Unsprung/Suspension/Assemblies/Rear A-Arms/SP - Rear Upper A-Arms.SLDASM

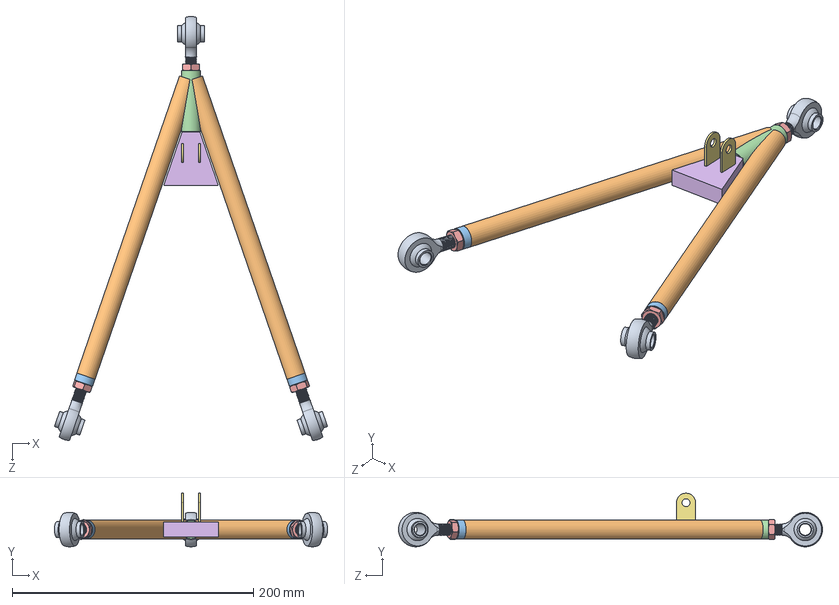
[picture p68: CAD file, 2023-11-03]
Unsprung/Suspension/Assemblies/Rear A-Arms/SP - Rear Upper A-Arms.SLDASM
226.3 x 44.4 x 351.2 mm
6960T231_Super-Swivel Ball Joint Rod End x 3
SP-RR Upper A-Arm Tube x 2
SP-10003-AD-Threaded Insert x 2
SP-10004-AA-Outer Threaded Insert
FS-ZINC YELLOW THIN NUT G8 HX, 0.375x24-0.21875 (93839A815) x 3
Part2^SP - Rear Upper A-Arms
SP-30063-AB-Pushrod Tab x 2
