FormulaRacingatUCDavis/FE11_CAD/Unsprung/Suspension/Components/Push Rods/SP-10011-BA-Push Rod Rear.SLDASM

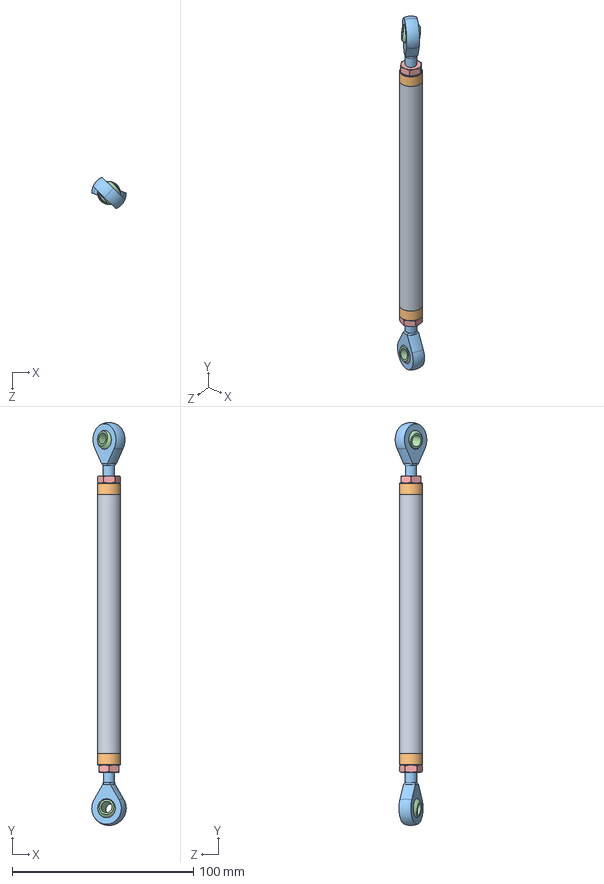
[picture p70: CAD file, 2023-10-24]
Unsprung/Suspension/Components/Push Rods/SP-10011-BA-Push Rod Rear.SLDASM
19.0 x 222.2 x 17.4 mm
SP-10071-AC-P Rod Tube R
SP-10003-AC-Threaded Insert x 2
Body^FS-MALE ROD END UNF-3A, 0.25x28-0.25D (AM-4) x 2
Ball^FS-MALE ROD END UNF-3A, 0.25x28-0.25D (AM-4) x 2
FS-ZINC YELLOW THIN NUT G8 HX, 0.25x28-0.15625 (93839A805) x 2
