FormulaRacingatUCDavis/FE11_CAD/Unsprung/Suspension/Components/Shocks/SP-A0105-AC-Ohlin TTX25 MKII, 200mm.SLDASM

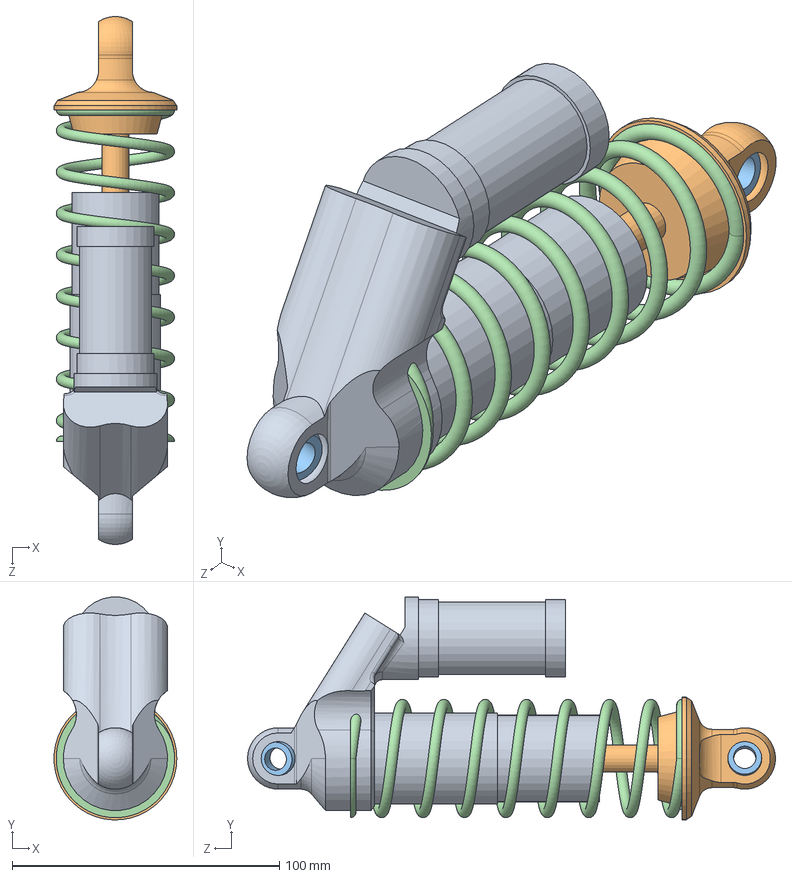
[picture p71: CAD file, 2023-10-22]
Unsprung/Suspension/Components/Shocks/SP-A0105-AC-Ohlin TTX25 MKII, 200mm.SLDASM
45.9 x 83.4 x 197.6 mm
Shock Body^SP-A0105-AC-Ohlin TTX25 MKII, 200mm
Head^SP-A0105-AC-Ohlin TTX25 MKII, 200mm
Ball^SP-A0105-AC-Ohlin TTX25 MKII, 200mm x 2
SP-#####-AB-Spring
