FormulaRacingatUCDavis/FE11_CAD/Unsprung/Wheel Package/Rear Left (Copied over from FE10, needs changes)/RL_Brake Assembly/Int. Brake Assembly.SLDASM

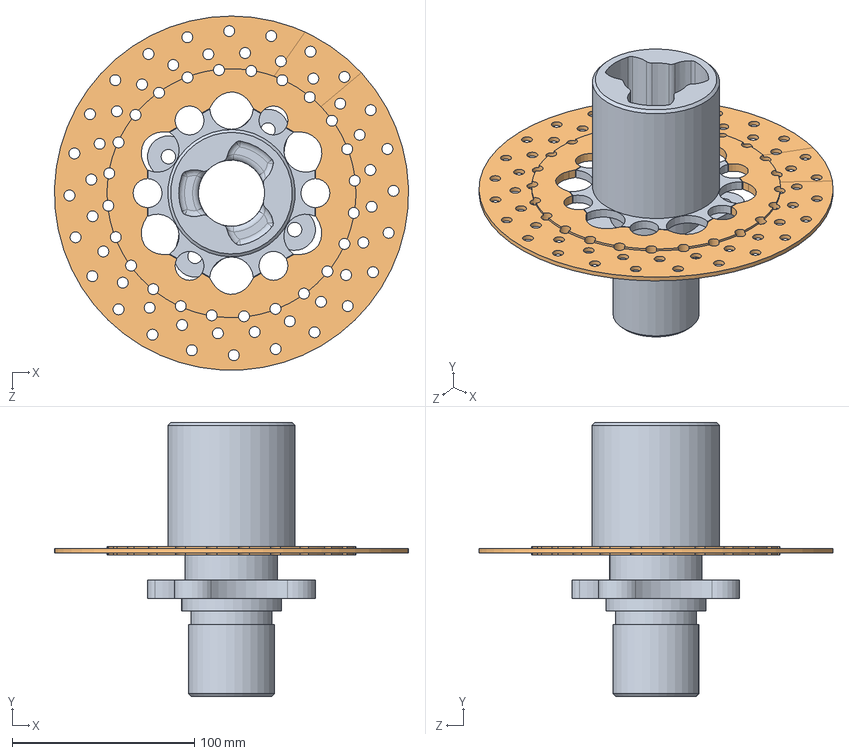
[picture p72: CAD file, 2023-10-22]
Unsprung/Wheel Package/Rear Left (Copied over from FE10, needs changes)/RL_Brake Assembly/Int. Brake Assembly.SLDASM
194.2 x 150.5 x 194.1 mm
WT-XA-#####-Tripod Hub
BR-20601-AB-Brake Rotor
