FormulaRacingatUCDavis/FE11_CAD/Electrical/Components/Dashboard/FE10 Dashboard Packaging/EL-000XX-AA-Dashboard Display PCB.SLDASM

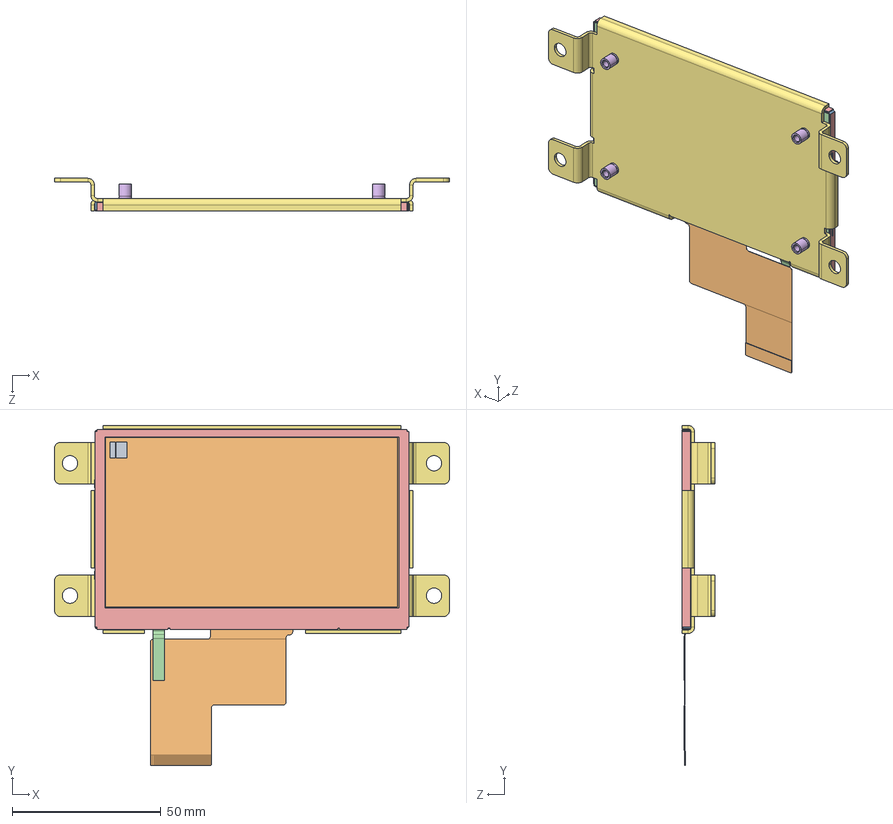
[picture p73: CAD file, 2023-11-03]
Electrical/Components/Dashboard/FE10 Dashboard Packaging/EL-000XX-AA-Dashboard Display PCB.SLDASM
132.6 x 114.2 x 10.9 mm
PANEL
PANEL-1
BLU
BLU-1
BEZEL
BSO4-M3-6 x 4
NHD-4.3-B
