FormulaRacingatUCDavis/FE11_CAD/Electrical/Components/E-stops/FE10 E-stops/EL-A00XX-AA-E-Stop Assembly.SLDASM

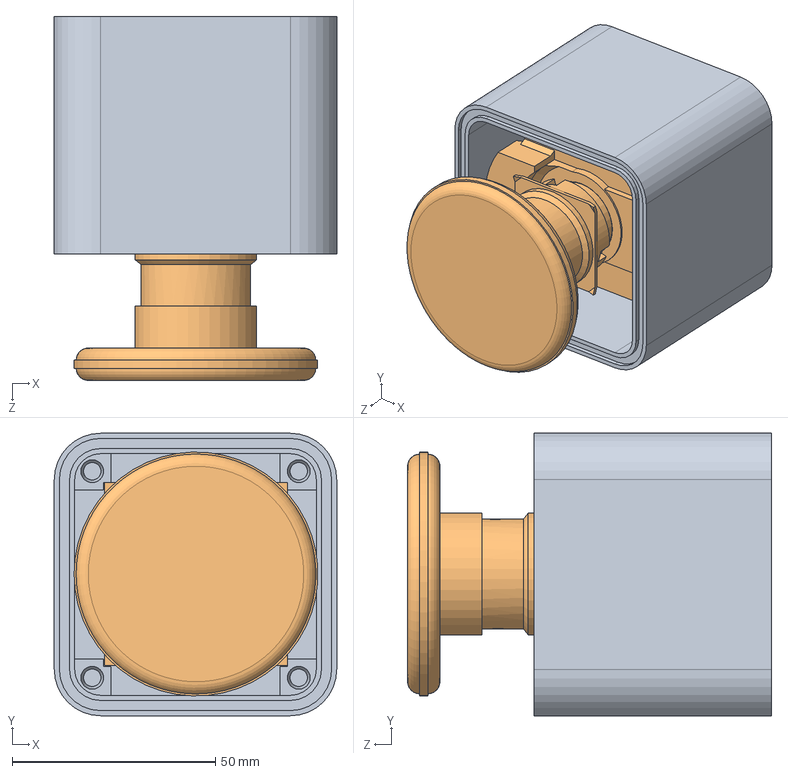
[picture p74: CAD file, 2023-10-24]
Electrical/Components/E-stops/FE10 E-stops/EL-A00XX-AA-E-Stop Assembly.SLDASM
69.5 x 69.5 x 89.5 mm
EL-500XX-AB-E-Stop Enclosure
EL-0002XX-AA-E-Stop
