FormulaRacingatUCDavis/FE11_CAD/Electrical/Components/LV Battery/FE10 LV Battery/EL-A00XX-LV Battery Assembly.SLDASM

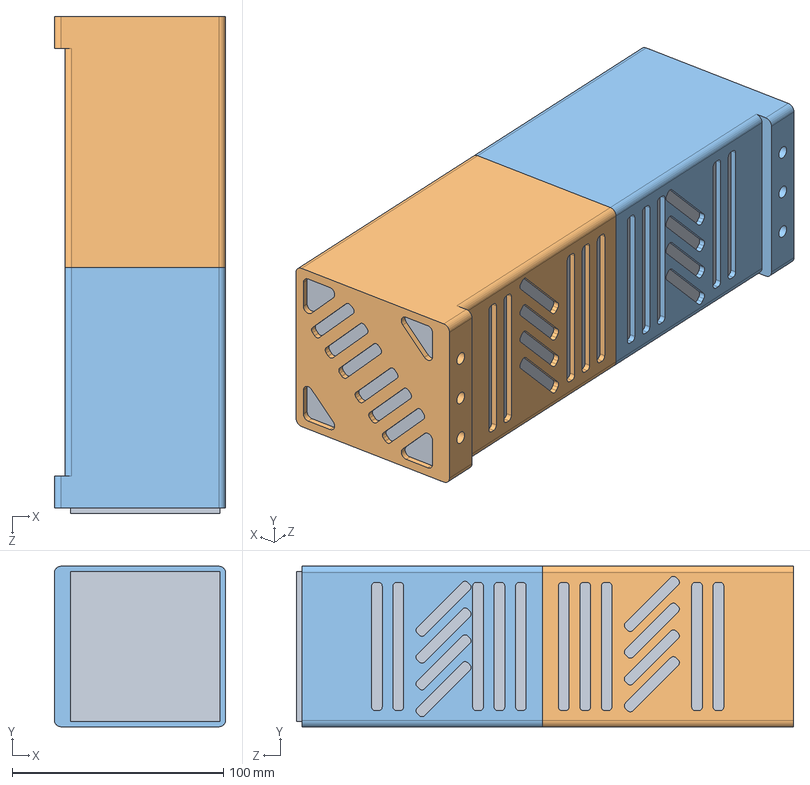
[picture p75: CAD file, 2023-10-24]
Electrical/Components/LV Battery/FE10 LV Battery/EL-A00XX-LV Battery Assembly.SLDASM
81.1 x 76.1 x 235.5 mm
EL-00004-AA-Aegies 12V 30Ah Battery
EL-500XX-AA-12V 30Ah Battery Bottom Enclosure
EL-500XX-AA-12V 30Ah Battery Top Enclosure
