FormulaRacingatUCDavis/FE11_CAD/Electrical/Components/TSMP + MS/FE10 TSMP + MS/EL-AXXXX-AA-HVI Assembly.SLDASM

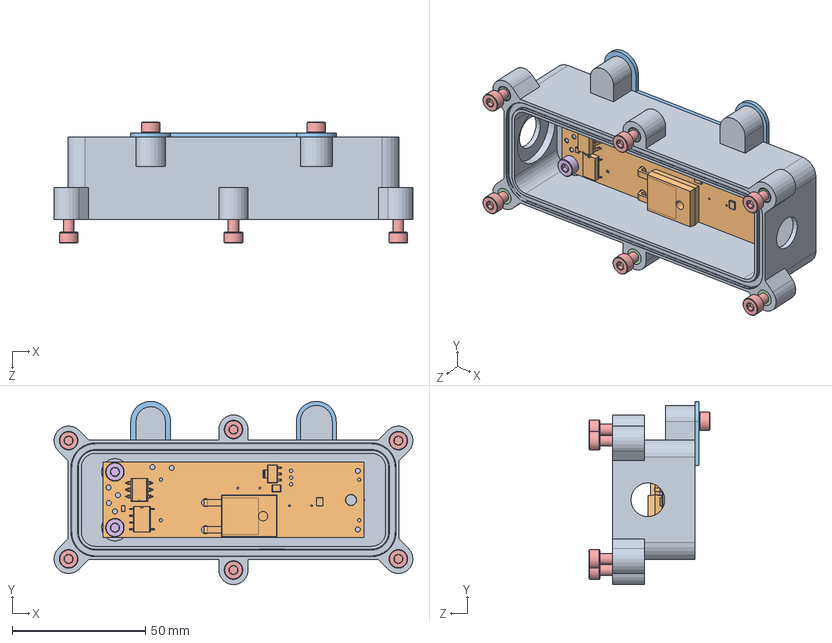
[picture p76: CAD file, 2023-10-24]
Electrical/Components/TSMP + MS/FE10 TSMP + MS/EL-AXXXX-AA-HVI Assembly.SLDASM
134.8 x 68.8 x 45.3 mm
EL-500XX-AA-HVI Enclosure
EL-800XX-BA-HVI Board.SLDASM
EL-300XX-AA-HVI Enclosure Tab
FS-Heat Set Insert, M4x7-4.7 (94180A351) x 11
BR-Black Oxide C12.9 SHCS, M4x0.7-8 (91290A140) x 8
BR-Black Oxide C12.9 SHCS, M4x0.7-5 (91290A138) x 2
