FormulaRacingatUCDavis/FE11_CAD/Unsprung/Controls/Pedal Box/Accelerator Pedal/BR-10001-AB-Accel Pedal Assembly.SLDASM

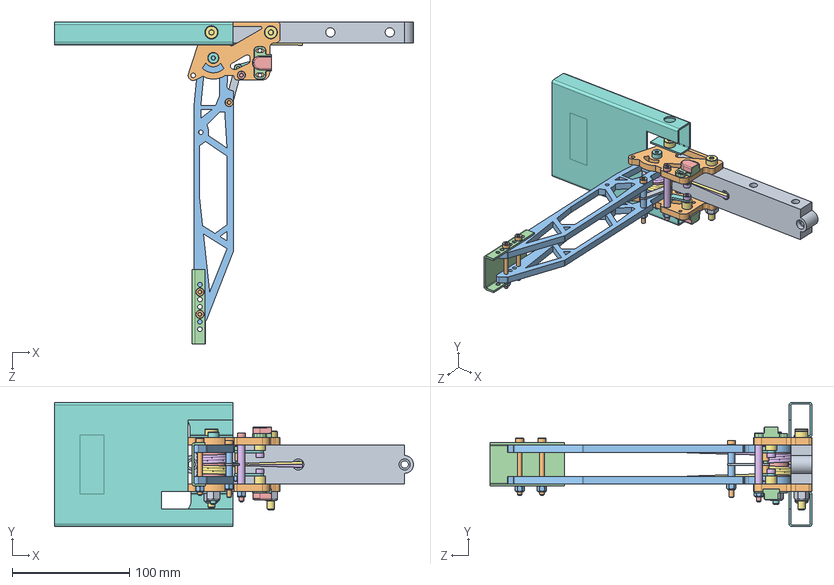
[picture p77: CAD file, 2023-11-03]
Unsprung/Controls/Pedal Box/Accelerator Pedal/BR-10001-AB-Accel Pedal Assembly.SLDASM
306.8 x 106.3 x 275.3 mm
BR-0000X-AA-Accel Pedal Platform
BR-1000X-AA-Accel Pedal Mount x 2
BR-2000X-AC-Accel Pedal Arm x 2
4048_carcasa MSC-360-G01-001^MSC-360_BR-0000X-AA-APPS (MSC360-1A-C0004-ERA360-05K) x 2
3982_apantallamiento^MSC-360_BR-0000X-AA-APPS (MSC360-1A-C0004-ERA360-05K) x 2
BR-0000X-AA-Accel Pedal Stop
BR-0000X-AA-APPS Linkage Barrel x 2
BR-0000X-AA-APPS Linkage Vert Arm x 2
BR-0000X-AA-APPS Linkage Connect Arm
BR-0000X-AA-APPS Linkage Spacer Lower x 2
BR-0000X-AA-APPS Linkage Spacer Upper x 2
BR-30003-AB-Toe Plate
BR-X000X-AA-Torsion Spring Shaft
BR-AB-0000X-Torsion Spring (9271K659)
BR-AA-0000X-Torsion Spring, Left Wound (9271K594)
BR-Steel Nylon Locknut, Grade 8, 0.25-20 (90630A110) x 3
BR-Black Oxide C12.9 SHCS, M4x0.7-45 (91290A175) x 3
BR-Steel Nylon Locknut, Grade 8, M4x0.7 (90576A103) x 5
BR-Black Oxide C12.9 SHCS, M4x0.7-25 (91290A176)
BR-Black Oxide C12.9 SHCS, M4x0.7-55 (91290A187)
BR-Black Oxide C12.9 SHCS, M4x0.7-8 (91290A140) x 2
BR-Alloy Steel Shoulder B18.3 SHCS, 0.3125x0.25-20, 2 in Lg (91259A591) x 2
BR-0000X-AC-Heel Plate
