FormulaRacingatUCDavis/FE11_CAD/Unsprung/Controls/Pedal Box/Brake Pedal/BR-10001-DA-Brake Pedal Assembly.SLDASM

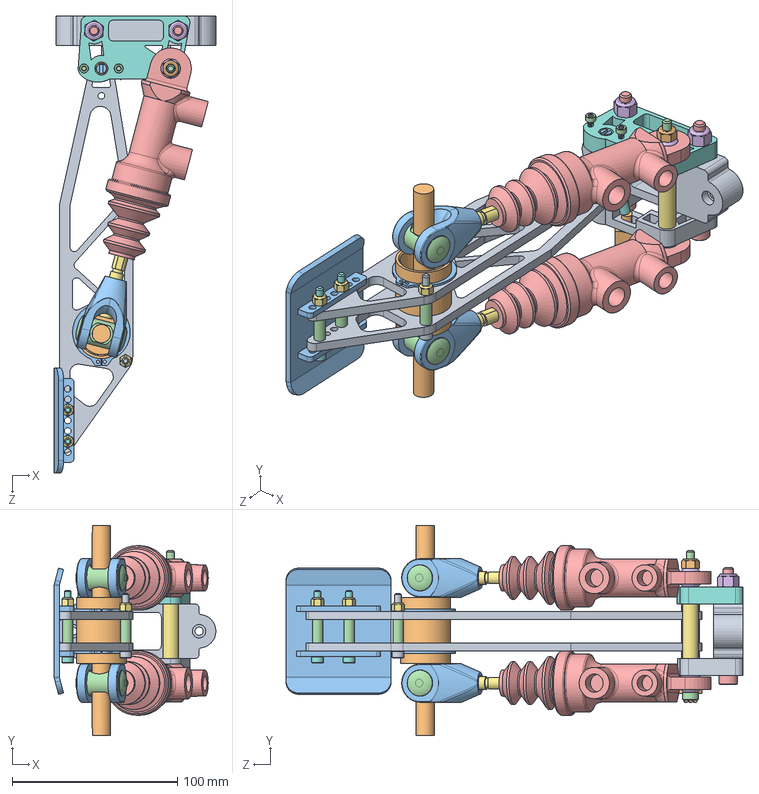
[picture p78: CAD file, 2023-10-22]
Unsprung/Controls/Pedal Box/Brake Pedal/BR-10001-DA-Brake Pedal Assembly.SLDASM
97.8 x 127.0 x 276.2 mm
BR-20002-AG-Brake Pedal Arm x 2
Copy of Bar^BR-00005-AA-Balance Bar (Tilton 600 Series)
BB Arm^BR-00005-AA-Balance Bar (Tilton 600 Series) x 2
BB Bullet^BR-00005-AA-Balance Bar (Tilton 600 Series) x 2
Main Body^BR-00004-AB-CP7855 Master Cylinder x 2
Spherical Mount^BR-00004-AB-CP7855 Master Cylinder x 2
Threaded Piston^BR-00004-AB-CP7855 Master Cylinder x 2
BR-10001-BE-Brake Pedal Mount (Left)
BR-10001-BF-Brake Pedal Mount (Right)
FR-00006-AA-BOTS M2011SD3W01
BR-30003-BF-Toe Plate
BR-Alloy Steel Shoulder B18.3 SHCS, 0.25x10-24, 3 in Lg (91259A106)
BR-Alloy Steel Shoulder B18.3 SHCS, 0.3125x0.25-20, 2.125 in Lg (91259A480) x 2
BR-Steel Nylon Locknut, Grade 8, 0.25-20 (90630A110) x 2
BR-Steel Nylon Locknut, Grade 8, M4x0.7 (90576A103) x 3
FS-BLACK OXIDE C12.9 SHCS, M4x0.7-40 (91290A184) x 2
BR-Black Oxide C12.9 SHCS, M4x0.7-35 (91290A173)
BR-Stainless Steel Nylon Locknut, 10-24 (91831A011)
BR-Spring Steel External Retaining Ring, 1.176 ID (97633A340) x 2
BR-0000X-AC-Toe Plate Spacer x 3
BR-0000X-AC-Brake Pedal Arm Spacer, Mid
BR-0000X-AC-Brake Pedal Arm Spacer, Sides x 2
BR-0000X-AB-Brake Mount Spacer
FR-0000X-AA-BOTS CAP
BR-X000X-BB-Brake Pedal Platform
7804K111_Stainless Steel Ball Bearing 6mm ID 10mm OD x 2
76161 - D-Shaft
91290A115_Alloy Steel Socket Head Screw M3 x 0.5 mm Thread 10 mm Long x 2
