FormulaRacingatUCDavis/FE11_CAD/Unsprung/Controls/Steering/ST-A0100-AB-Inboard Steering.SLDASM

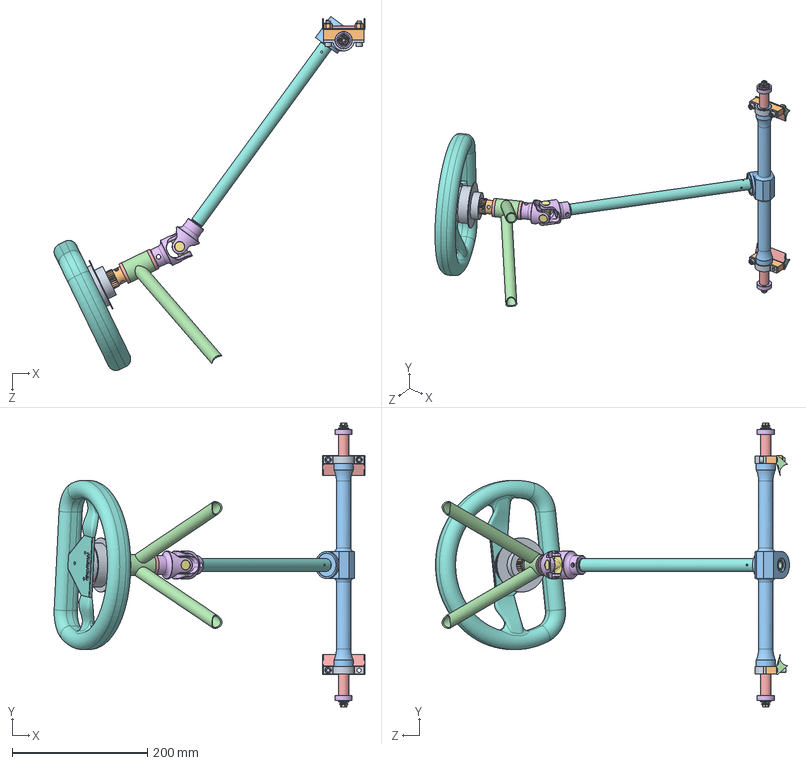
[picture p79: CAD file, 2023-09-12]
Unsprung/Controls/Steering/ST-A0100-AB-Inboard Steering.SLDASM
459.2 x 419.3 x 522.9 mm
ST-00002-AA-Longacre Quick Disconnect_52-56605
ST-00003-AA-Longacre Spud
ST-10004-AB-Upper Column
ST-10005-AC-Upper Support
ST-00006-AA-Upper Column Bearing (2938T23) x 2
Clevis^ST-00007-AA-SU Joint Borgeson x 2
Joint^ST-00007-AA-SU Joint Borgeson
ST-10008-AD-Lower Column
ST-00011-AB-Rack Mount Top x 2
ST-00012-AB-Rack Mount Bottom x 2
ST-00020-AA-NARRco Rack MkII Housing^ST-00020-AA-NARRco Rack MkII
ST-00021-AA-NARRco Rack MkII Pinion^ST-00020-AA-NARRco Rack MkII
ST-00022-AA-NARRco Rack MkII Rack^ST-00020-AA-NARRco Rack MkII
ST-00023-AA-NARRco Rack MkII Bump Stop TT1119-01^ST-00020-AA-NARRco Rack MkII x 2
ST-10024-AA-Rack End Fastener^ST-00020-AA-NARRco Rack MkII x 2
ST-#####-AA-MOMO MOD 12
BR-Black-Oxide Alloy Steel C12.9 SHCS, 0.25-20, 1.25 (91251A544) x 3
BR-Steel Nylon Locknut, Grade 8, 0.25-20 (90630A110) x 2
Rack Mount Spacer - Top Mount x 2
Rack Mount Spacer - Side Supports x 4
Rack Mount Spacer - Back Support x 2
