FormulaRacingatUCDavis/FE11_CAD/Unsprung/Suspension/Assemblies/SP-A0100-AB-Front A-Arm Assembly.SLDASM

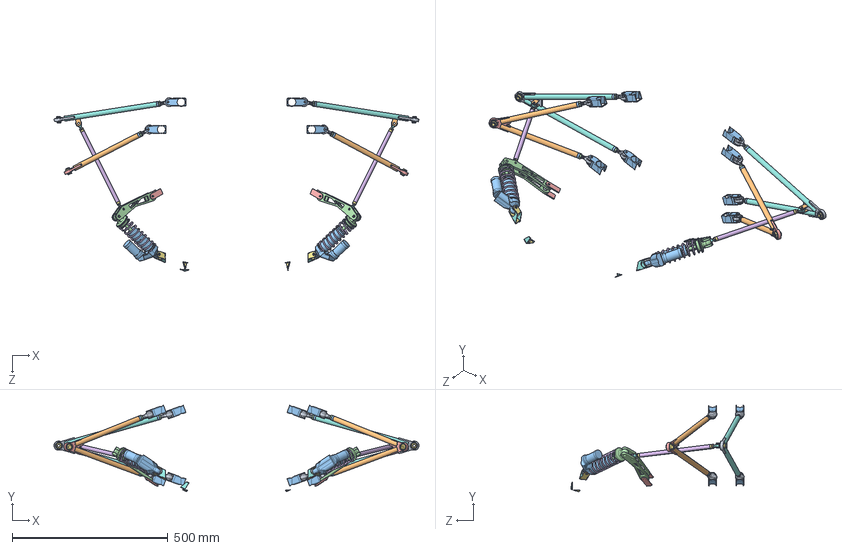
[picture p80: CAD file, 2023-11-07]
Unsprung/Suspension/Assemblies/SP-A0100-AB-Front A-Arm Assembly.SLDASM
1172.3 x 278.7 x 557.3 mm
6960T231_Super-Swivel Ball Joint Rod End x 8
SP-FR Upper A-Arm Tube x 4
SP-10003-AD-Threaded Insert x 8
FS-ZINC YELLOW THIN NUT G8 HX, 0.375x24-0.21875 (93839A815) x 8
SP-Upper Apex Front x 2
Race^FS-High Misalign Spherical Bearing, 0.375 (HAB-6TG) x 4
Ball^FS-High Misalign Spherical Bearing, 0.375 (HAB-6TG) x 4
SP-FR Lower A-Arm Tube x 4
SP-10002-AF-Lower Apex F x 2
SP-30063-AB-Pushrod Tab x 4
SP-C30066-AA-A-Arm Tab Box x 8
SP-10001 - BA - Front Rocker x 2
SP-A0200-Front Rocker Tab Box x 4
Part4^SP-10011-BA-Push Rod Front x 2
SP-10003-AC-Threaded Insert x 4
Body^FS-MALE ROD END UNF-3A, 0.25x28-0.25D (AM-4) x 4
Ball^FS-MALE ROD END UNF-3A, 0.25x28-0.25D (AM-4) x 4
FS-ZINC YELLOW THIN NUT G8 HX, 0.25x28-0.15625 (93839A805) x 4
Shock Body^SP-A0105-AC-Ohlin TTX25 MKII, 200mm x 2
Head^SP-A0105-AC-Ohlin TTX25 MKII, 200mm x 2
Ball^SP-A0105-AC-Ohlin TTX25 MKII, 200mm x 4
SP-#####-AB-Spring x 2
SP-30034-AC-Front Shock Tab x 4
SP-30035-AA-Front Shock Gusset Tab x 4
2868T52_High-Load Oil-Embedded 863 Sleeve Bearing x 2
