FormulaRacingatUCDavis/FE11_CAD/Unsprung/Suspension/Components/Push Rods/Push Rod Front.SLDASM

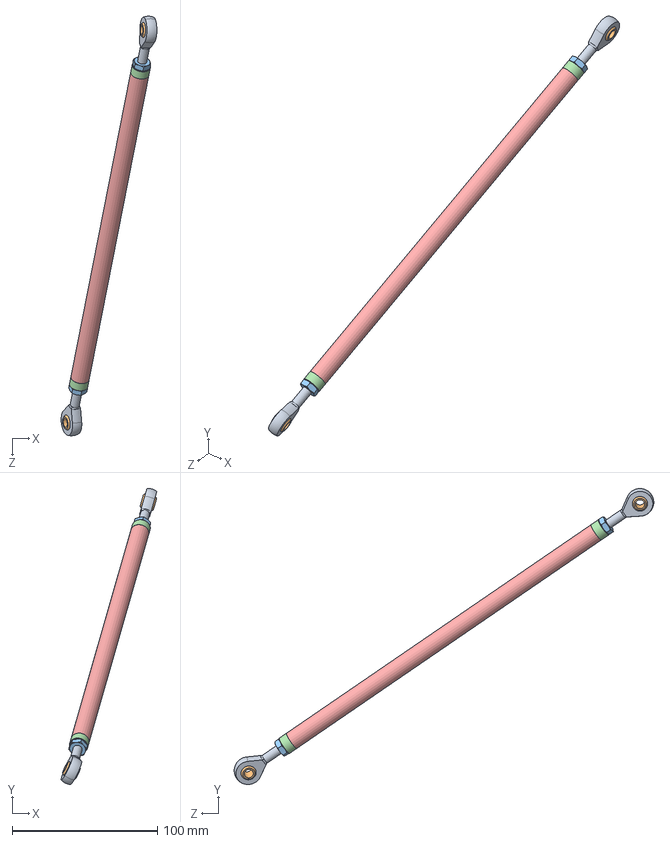
[picture p81: CAD file, 2023-10-22]
Unsprung/Suspension/Components/Push Rods/Push Rod Front.SLDASM
65.9 x 203.6 x 288.6 mm
Body^FS-MALE ROD END UNF-3A, 0.25x28-0.25D (AM-4) x 2
Ball^FS-MALE ROD END UNF-3A, 0.25x28-0.25D (AM-4) x 2
FS-ZINC YELLOW THIN NUT G8 HX, 0.25x28-0.15625 (93839A805) x 2
SP-10003-AC-Threaded Insert x 2
Push Rod Tubes F
