FormulaRacingatUCDavis/FE11_CAD/Unsprung/Suspension/FE10/Rockers/Front Rocker Assembly.SLDASM

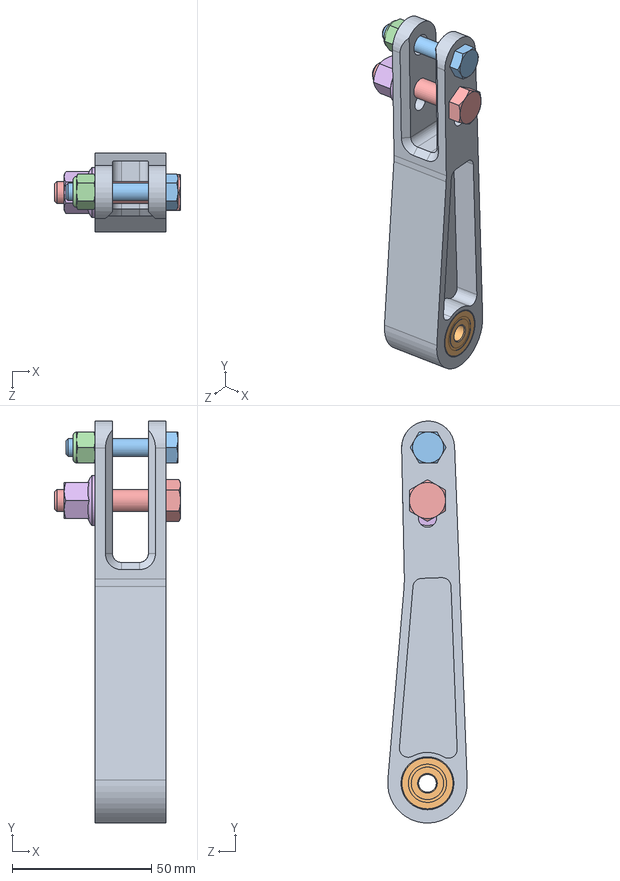
[picture p82: CAD file, 2023-10-24]
Unsprung/Suspension/FE10/Rockers/Front Rocker Assembly.SLDASM
45.3 x 144.4 x 28.5 mm
SP-Front Rocker
FS-BALL BEARING, 0.25ID-0.75OD (60355K702) x 2
FS-CADMIUM PLATED C3 HX, 0.25x28-1.41-0.469 (AN4-13A)
FS-NYLOC G8 HX, 0.25x28-0.3125 (90630A145)
FS-ZINC YELLOW CHROMATE C10.9 HX, M8x1.25-40-22 (95327A569)
FS-NYLOC FLHX C8, M8x1.25-11.1 (92461A400)
