FormulaRacingatUCDavis/FE11_CAD/Unsprung/Suspension/FE10/Shocks/SP-A0105-AD-Ohlin TTX25 MKII, 200mm.SLDASM

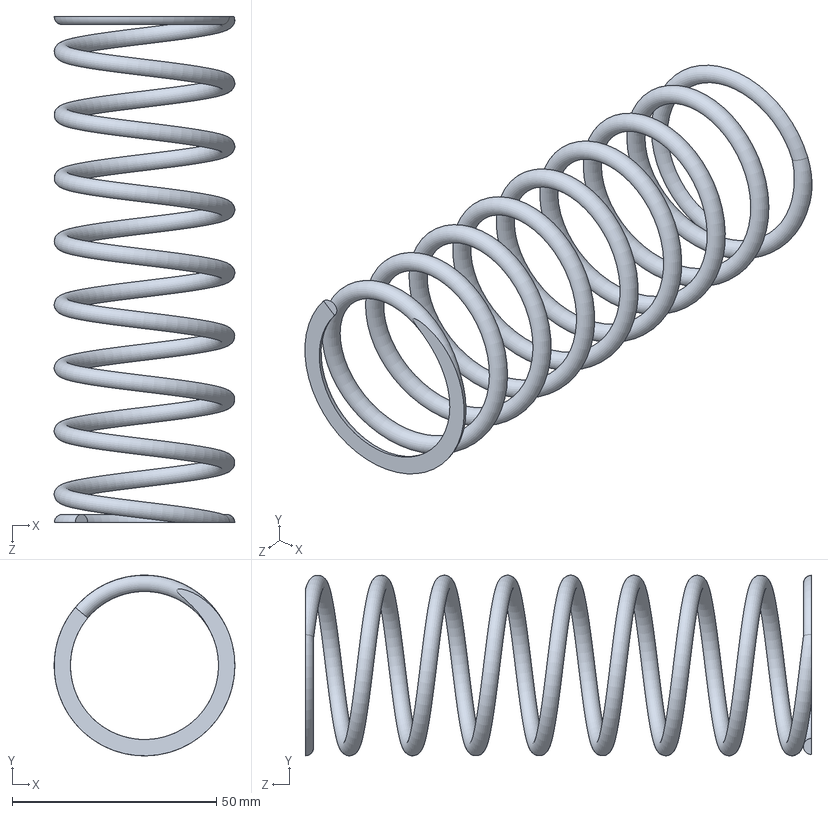
[picture p83: CAD file, 2023-10-22]
Unsprung/Suspension/FE10/Shocks/SP-A0105-AD-Ohlin TTX25 MKII, 200mm.SLDASM
44.3 x 44.3 x 124.0 mm
