FormulaRacingatUCDavis/FE11_CAD/Electrical/Components/HVI/EL-A0107-AA-HVI Assembly.SLDASM

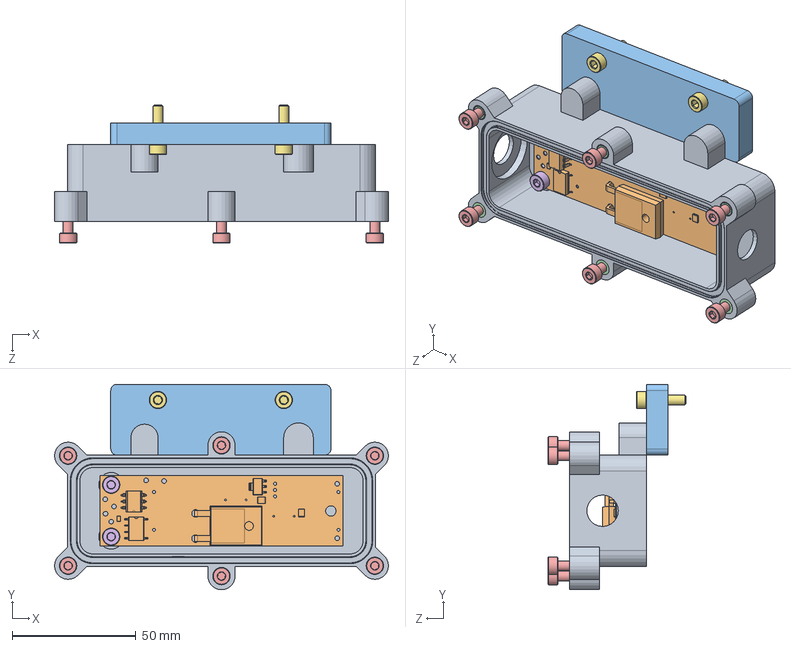
[picture p84: CAD file, 2024-04-30]
Electrical/Components/HVI/EL-A0107-AA-HVI Assembly.SLDASM
134.8 x 82.9 x 55.8 mm
EL-50090-AA-HVI Enclosure
EL-80091-AA-HVI PCB
EL-50093-AA-HVI Mounting Adapter
AC-Heat Set Insert, M4x7-4.7 (94180A351) x 6
BR-Black Oxide C12.9 SHCS, M4x0.7-8 (91290A140) x 8
BR-Black Oxide C12.9 SHCS, M4x0.7-5 (91290A138) x 2
91290A154_Alloy Steel Socket Head Screw, M4x0.7, 16mm x 2
