FormulaRacingatUCDavis/FE11_CAD/Powertrain/Accumulator/Components/Power Electronics/Cables/AC-00020-AA-Right Maintenance Cable.SLDPRT

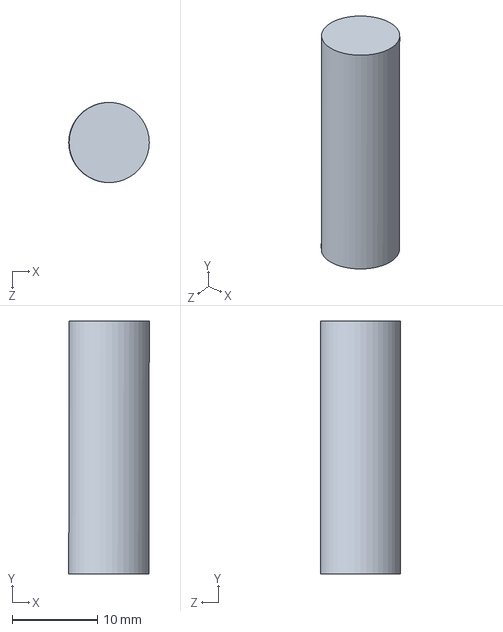
[picture p85: CAD file, 2024-02-17]
Powertrain/Accumulator/Components/Power Electronics/Cables/AC-00020-AA-Right Maintenance Cable.SLDPRT
9.45 x 29.6 x 9.37 mm
