FormulaRacingatUCDavis/FE11_CAD/Powertrain/Cooling/Components/Fittings/Aluminum Adapter Subassembly.SLDASM

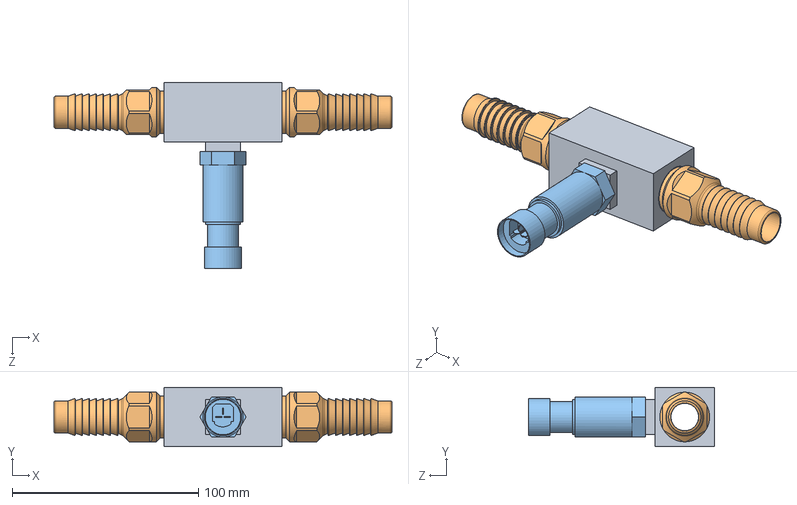
[picture p86: CAD file, 2024-04-30]
Powertrain/Cooling/Components/Fittings/Aluminum Adapter Subassembly.SLDASM
181.6 x 31.8 x 99.7 mm
EN10114-AA-Aluminum Adapter
EN10111-AA-0.75in Easy-Fit Barbed Hose Fitting (5363K52) x 2
EN-10202-AA-Pressure and Temperature Transducer, Transducers Direct
