FormulaRacingatUCDavis/FE11_CAD/Powertrain/Drivetrain/Components/HV Cover/EN-A0010-AC-HV Connection Cover.SLDASM

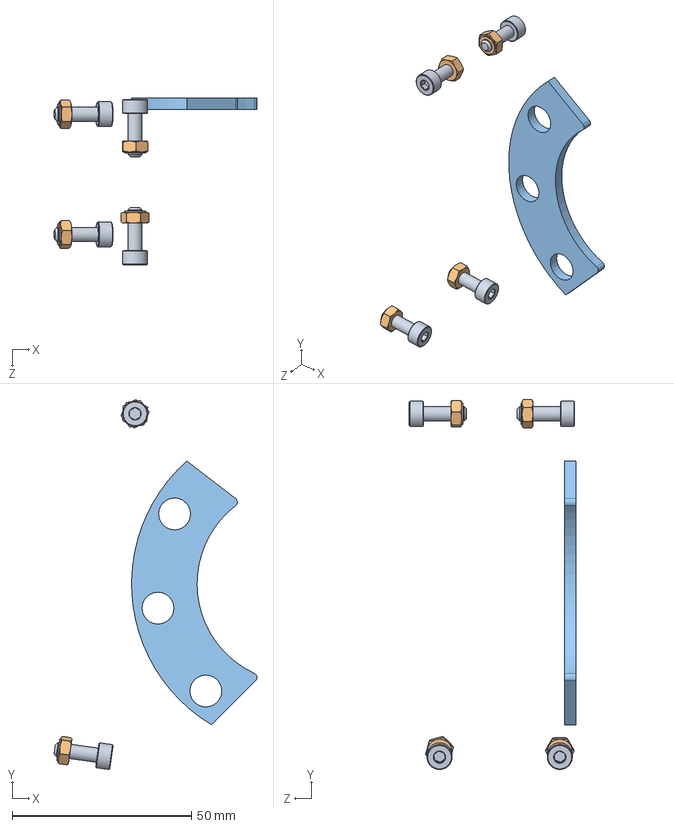
[picture p87: CAD file, 2023-11-03]
Powertrain/Drivetrain/Components/HV Cover/EN-A0010-AC-HV Connection Cover.SLDASM
56.6 x 103.1 x 46.4 mm
BR-Black Oxide C12.9 SHCS, M4x0.7-12 (91290A148) x 4
FS - Nylon Hex Nut, M4x0.7 (93369A127) x 4
HV Cover 1
