FormulaRacingatUCDavis/FE11_CAD/Unsprung/Controls/DXF/Rack Mount Assembly v3.dxf

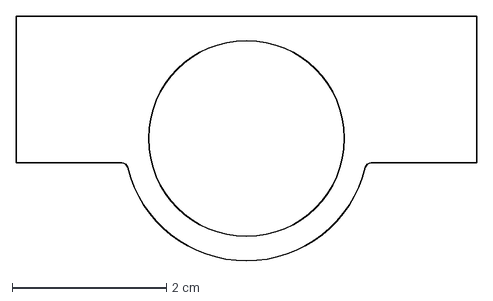
[picture p88: CAD file, 2024-01-08]
Unsprung/Controls/DXF/Rack Mount Assembly v3.dxf
5.97 x 3.18 cm
