FormulaRacingatUCDavis/FE11_CAD/Unsprung/Controls/Pedal Box/Accelerator Pedal/BR-10001-CB-Accel Pedal Assembly.SLDASM

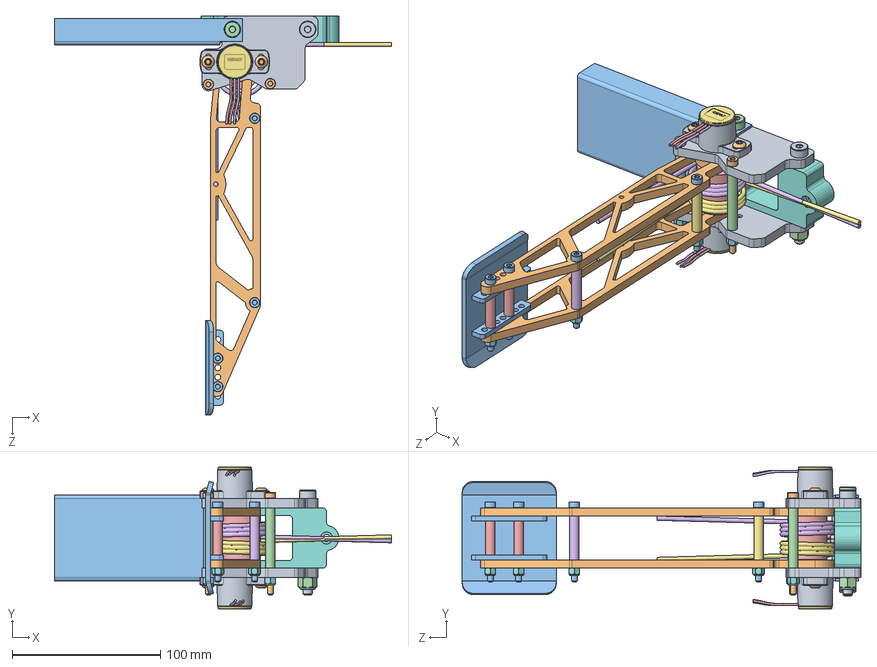
[picture p89: CAD file, 2023-10-26]
Unsprung/Controls/Pedal Box/Accelerator Pedal/BR-10001-CB-Accel Pedal Assembly.SLDASM
227.4 x 95.6 x 268.9 mm
BR-1000X-CB-Accel Pedal Mount x 2
BR-2000X-BB-Accel Pedal Arm x 2
BR-30003-BE-Accel Toe Plate
BR-0000X-AA-AP Mount Spacer x 2
BR-X000X-BC-Torsion Spring Shaft
BR-AD-Torsion Spring (9271K663)
BR-AD-Torsion Spring, Left Wound (9271K597)
BR-Steel Nylon Locknut, Grade 8, M4x0.7 (90576A103) x 6
BR-Alloy Steel Shoulder B18.3 SHCS, 0.3125x0.25-20, 2.125 in Lg (91259A480)
BR-Black Oxide C12.9 SHCS, M4x0.7-65 (91290A083) x 2
BR-Black Oxide C12.9 SHCS, M4x0.7-50 (91290A186) x 4
BR-Steel Nylon Locknut, Grade 8, 0.25-20 (90630A110) x 2
BR-0000X-AA-AP Toe Plate Spacer x 2
BR-0000X-AA-AP Arm Spacer
BR-0000X-AA-APPS Spacer, Right
BR-0000X-CB-Accel Pedal Platform
7804K115_Stainless Steel Ball Bearing 8mm ID 12 mm OD x 2
D-Shaft Misumi SFRV8-74-F30-T30-W6 8mm OD
BR-00001-BD-Heel Plate
BR-Alloy Steel Shoulder B18.3 SHCS, 0.3125x0.25-20, 2.25 in Lg (91259A108)
fil.stp x 4
fil-oa0.stp x 2
cc00273_-.stp x 2
cn00253.stp x 2
CB00527b.stp x 2
90910A961_Button Head Torx Screws M4.5x0.7-10 x 4
