FormulaRacingatUCDavis/FE11_CAD/Unsprung/Controls/Pedal Box/BR-A10001-AA-Pedal Box Assembly.SLDASM

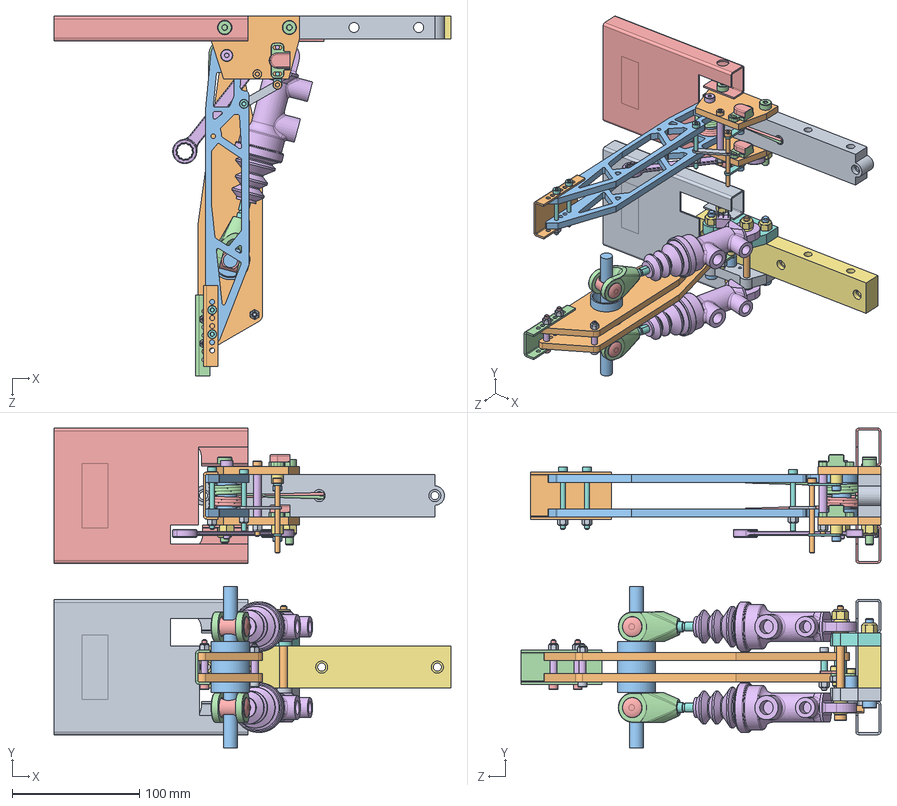
[picture p90: CAD file, 2023-09-12]
Unsprung/Controls/Pedal Box/BR-A10001-AA-Pedal Box Assembly.SLDASM
311.9 x 251.4 x 282.6 mm
BR-0000X-AA-Accel Pedal Platform
BR-1000X-AA-Accel Pedal Mount x 2
BR-2000X-AD-Accel Pedal Arm x 2
4048_carcasa MSC-360-G01-001^MSC-360_BR-0000X-AA-APPS (MSC360-1A-C0004-ERA360-05K) x 2
3982_apantallamiento^MSC-360_BR-0000X-AA-APPS (MSC360-1A-C0004-ERA360-05K) x 2
BR-0000X-AA-Accel Pedal Stop
BR-0000X-AA-APPS Linkage Barrel x 2
BR-0000X-AA-APPS Linkage Vert Arm x 2
BR-0000X-AA-APPS Linkage Connect Arm
BR-30003-AB-Toe Plate
BR-X000X-AA-Torsion Spring Shaft
BR-AB-0000X-Torsion Spring (9271K659)
BR-AA-0000X-Torsion Spring, Left Wound (9271K594)
BR-Alloy Steel Shoulder B18.3 SHCS, 0.25x10-24, 1.875 in Lg (91259A510)
BR-Steel Nylon Locknut, Grade 8, 0.25-20 (90630A110) x 7
BR-Black Oxide C12.9 SHCS, M4x0.7-45 (91290A175) x 3
BR-Steel Nylon Locknut, Grade 8, M4x0.7 (90576A103) x 9
BR-Black Oxide C12.9 SHCS, M4x0.7-55 (91290A187) x 2
BR-Black Oxide C12.9 SHCS, M4x0.7-8 (91290A140) x 2
BR-Alloy Steel Shoulder B18.3 SHCS, 0.3125x0.25-20, 2 in Lg (91259A591) x 2
BR-0000X-AC-Heel Plate
BR-0000X-AA-Wrench For Reference
BR-X000X-AB-Brake Pedal Platform
BR-10001-BC-Brake Pedal Mount (Left)
BR-10001-BC-Brake Pedal Mount (Right)
BR-20002-AC-Brake Pedal Arm x 2
Copy of Bar^BR-00005-AA-Balance Bar (Tilton 600 Series)
BB Arm^BR-00005-AA-Balance Bar (Tilton 600 Series) x 2
BB Bullet^BR-00005-AA-Balance Bar (Tilton 600 Series) x 2
Main Body^BR-00004-AB-CP7855 Master Cylinder x 2
Spherical Mount^BR-00004-AB-CP7855 Master Cylinder x 2
Threaded Piston^BR-00004-AB-CP7855 Master Cylinder x 2
4048_carcasa MSC-360-G01-001^MSC-360_BR-00009-BA-BPPS (MSC360-1A-C0004-ERA360-05K)
3982_apantallamiento^MSC-360_BR-00009-BA-BPPS (MSC360-1A-C0004-ERA360-05K)
BR-00012-AA-BPPS Linkage Barrel
BR-00010-AA-BPPS Linkage A
BR-00011-AA-BPPS Linkage B
FR-00006-AA-BOTS M2011SD3W01
BR-Black Oxide C12.9 SHCS, M4x0.7-12 (91290A148) x 2
BR-0000X-AB-Brake Pedal Arm Spacer Upper
BR-Black Oxide C12.9 SHCS, M4x0.7-30 (91290A172) x 2
BR-Alloy Steel Shoulder B18.3 SHCS, 0.25x10-24, 3 in Lg (91259A106)
BR-Alloy Steel Shoulder B18.3 SHCS, 0.3125x0.25-20, 2.125 in Lg (91259A480) x 3
BR-30003-AD-Toe Plate
BR-Black Oxide C12.9 SHCS, M4x0.7-35 (91290A173) x 2
BR-0000X-AB-Toe Plate Spacer x 3
BR-0000X-AA-Brake Pedal Arm Spacer (Lower, Side) x 2
BR-0000X-AA-Brake Pedal Arm Spacer (Lower, Mid)
BR-00001-AA-Heel Plate
