FormulaRacingatUCDavis/FE11_CAD/Unsprung/Suspension/Components/Push Rods/SP-A0104-AB-P Rod F.SLDASM

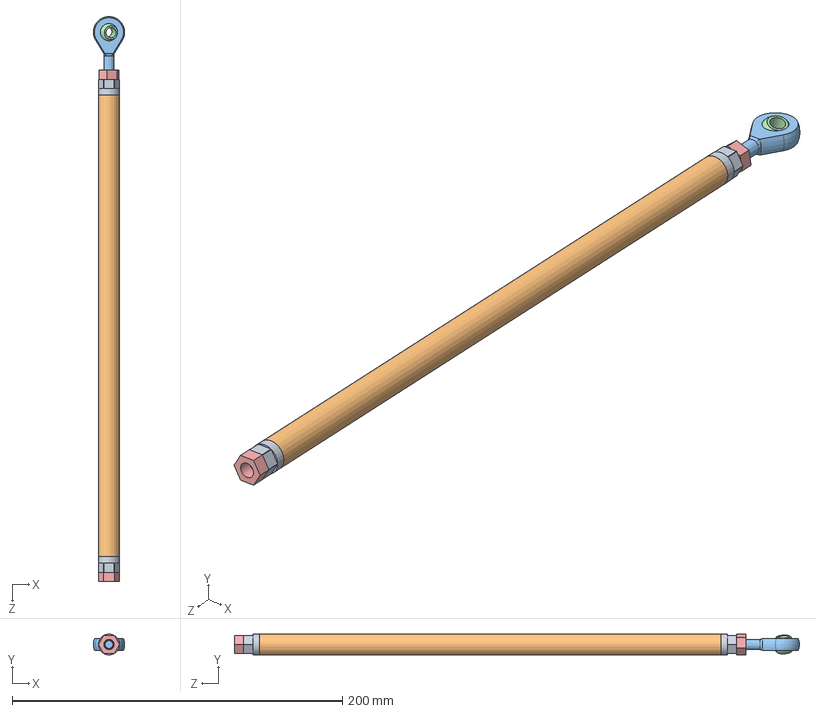
[picture p92: CAD file, 2023-10-22]
Unsprung/Suspension/Components/Push Rods/SP-A0104-AB-P Rod F.SLDASM
19.0 x 12.7 x 342.2 mm
SP-10003-AB-Threaded Insert x 2
SP-10031-AC-P Rod Tube F
Body^FS-Rod End, 0.25x0.25-28 (AM-4T)
Ball^FS-Rod End, 0.25x0.25-28 (AM-4T)
FS-Jam Nut, 0.25-28 (99891A505) x 2
