FormulaRacingatUCDavis/FE11_CAD/Unsprung/Suspension/Components/Shocks/Shock Tabs/SP-A0106-AA-Front Shock Tab Box.SLDASM

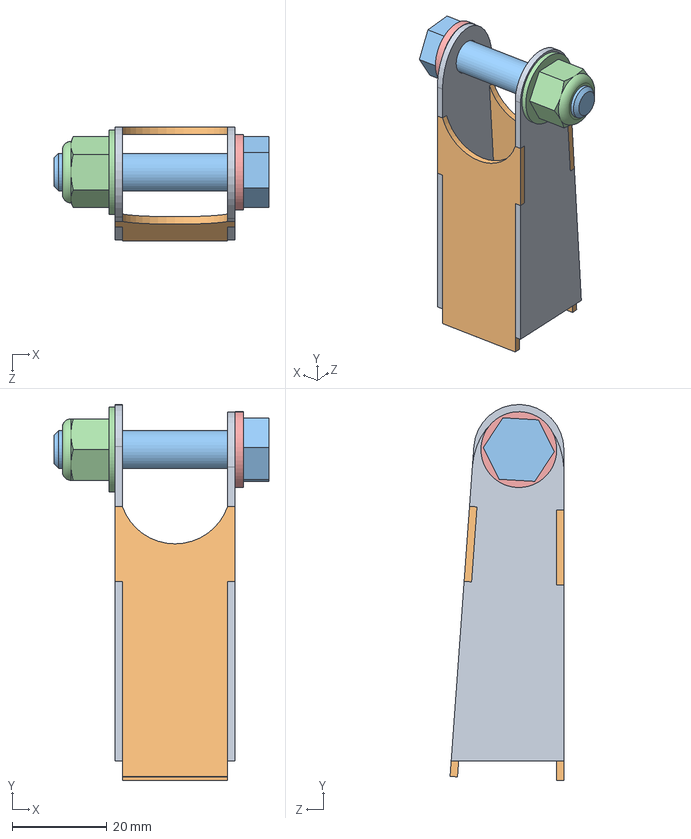
[picture p93: CAD file, 2023-10-22]
Unsprung/Suspension/Components/Shocks/Shock Tabs/SP-A0106-AA-Front Shock Tab Box.SLDASM
45.3 x 79.4 x 24.0 mm
SP-30034-AB-Front Shock Tab x 2
SP-30035-AA-Front Shock Gusset Tab x 2
FS-High Strength Zinc Yellow-Chromate Plated Cap Screw, M8-40 (95327A569)
FS-Nylon-Insert Nonmarring Flanger Locknut, M8 (92461A400)
FS-Steel Flat Washer, M8-1.8 Cl.10.9 (91455A130)
