FormulaRacingatUCDavis/FE11_CAD/Unsprung/Suspension/Components/Shocks/SP-A0105-AB-Ohlin TTX25 MKII, 200mm.SLDASM

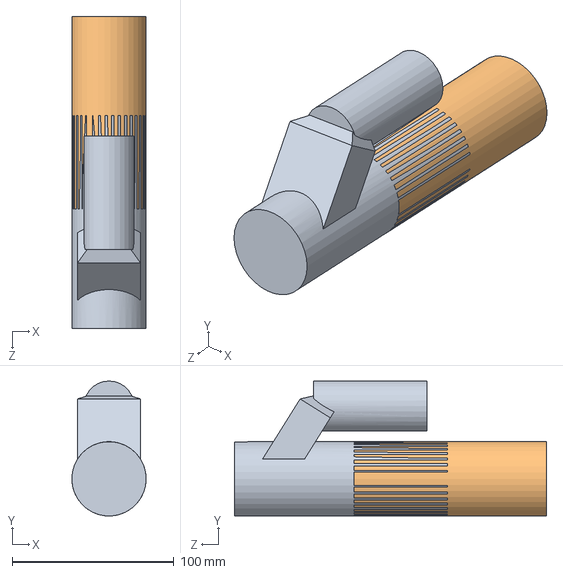
[picture p94: CAD file, 2023-10-22]
Unsprung/Suspension/Components/Shocks/SP-A0105-AB-Ohlin TTX25 MKII, 200mm.SLDASM
46.0 x 83.5 x 193.1 mm
Shock Body^SP-A0105-AB-Ohlin TTX25 MKII, 200mm
Head^SP-A0105-AB-Ohlin TTX25 MKII, 200mm
