FormulaRacingatUCDavis/FE11_CAD/Unsprung/Wheel Package/Front Left/WT-A0100-AC-Toe Bracket.SLDASM

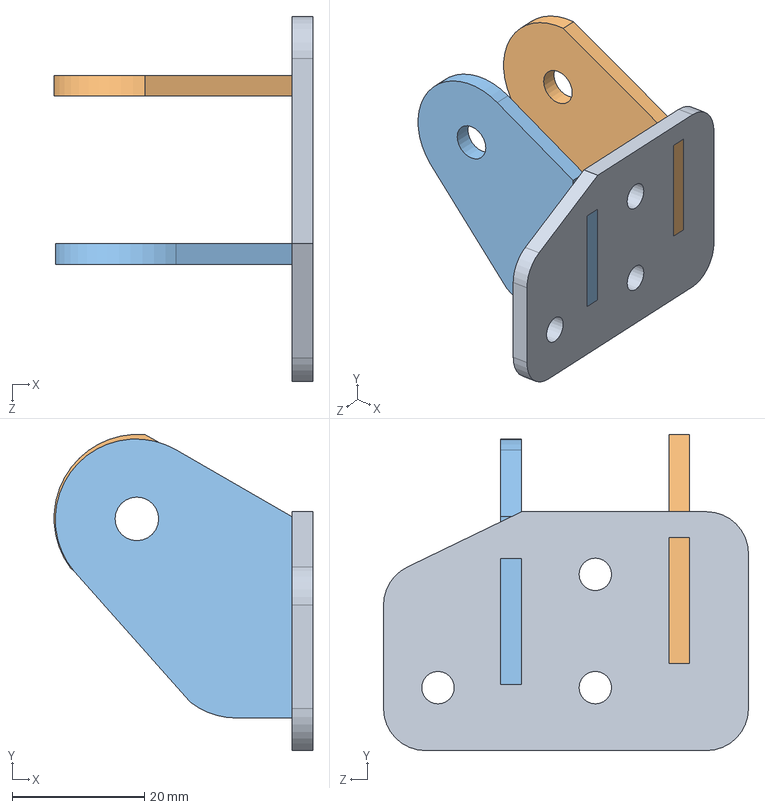
[picture p95: CAD file, 2023-12-09]
Unsprung/Wheel Package/Front Left/WT-A0100-AC-Toe Bracket.SLDASM
39.2 x 47.8 x 55.2 mm
WT-FC-Toe Base Plate
WT-FC-Toe Bottom Clevis
WT-GB-Toe Top Clevis1
