FormulaRacingatUCDavis/FE11_CAD/Unsprung/Wheel Package/Rear Left (Copied over from FE10, needs changes)/RL_Brake Assembly/BR-A0000-AA-Rear Brake Assembly.SLDASM

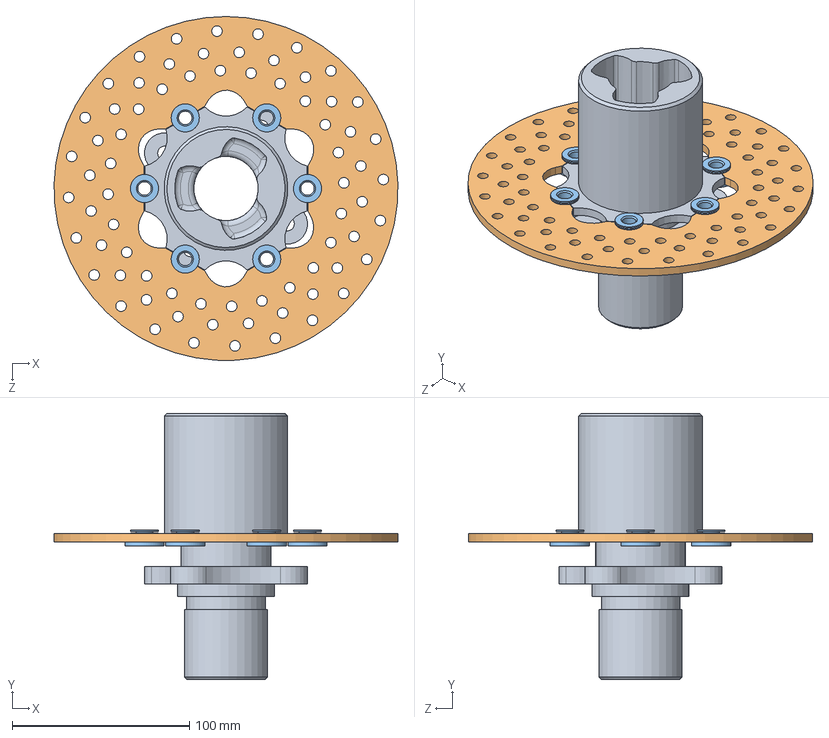
[picture p96: CAD file, 2023-10-22]
Unsprung/Wheel Package/Rear Left (Copied over from FE10, needs changes)/RL_Brake Assembly/BR-A0000-AA-Rear Brake Assembly.SLDASM
194.2 x 150.5 x 194.3 mm
WT-XA-#####-Tripod Hub
BR-20601-AB-Brake Rotor
BR-20603-BA-Floating Bobbins x 6
