FormulaRacingatUCDavis/FE11_CAD/Electrical/Components/Telemnodes/Rear Telemnode Assembly.SLDASM

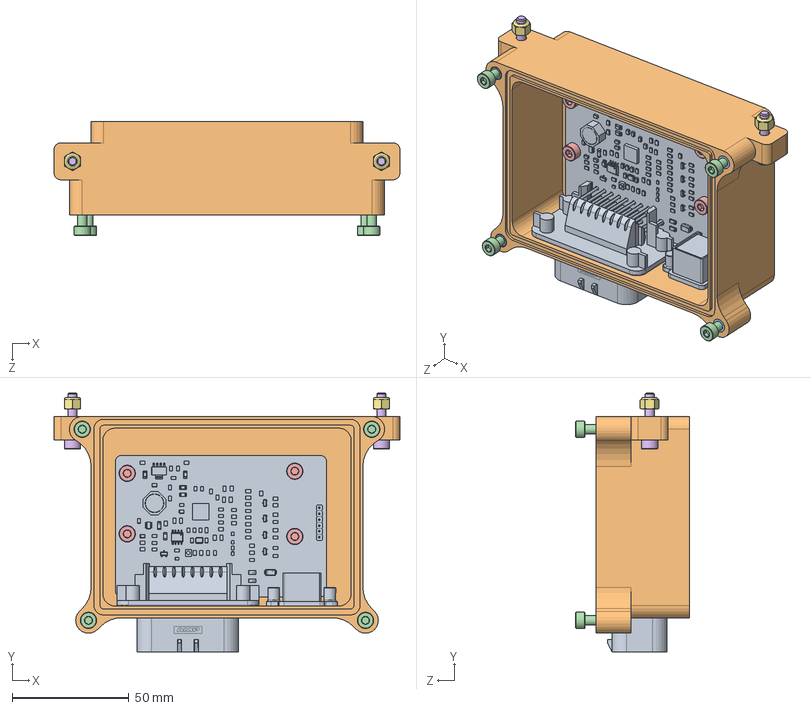
[picture p97: CAD file, 2023-11-12]
Electrical/Components/Telemnodes/Rear Telemnode Assembly.SLDASM
148.1 x 110.8 x 48.7 mm
Rear Telemnode
Rear Telemnode Enclosure
AC-Heat Set Insert, M4x7-4.7 (94180A351) x 8
BR-Black Oxide C12.9 SHCS, M4x0.7-8 (91290A140) x 4
BR-Black Oxide C12.9 SHCS, M4x0.7-5 (91290A138) x 4
91290A168_Alloy Steel Socket Head Screw M4x0.7, 20mm x 2
BR-Steel Nylon Locknut, Grade 8, M4x0.7 (90576A103) x 2
