FormulaRacingatUCDavis/FE11_CAD/Powertrain/Drivetrain/Components/Drexler Assembly/EN-00027-AB-61810-2RS1.SLDASM

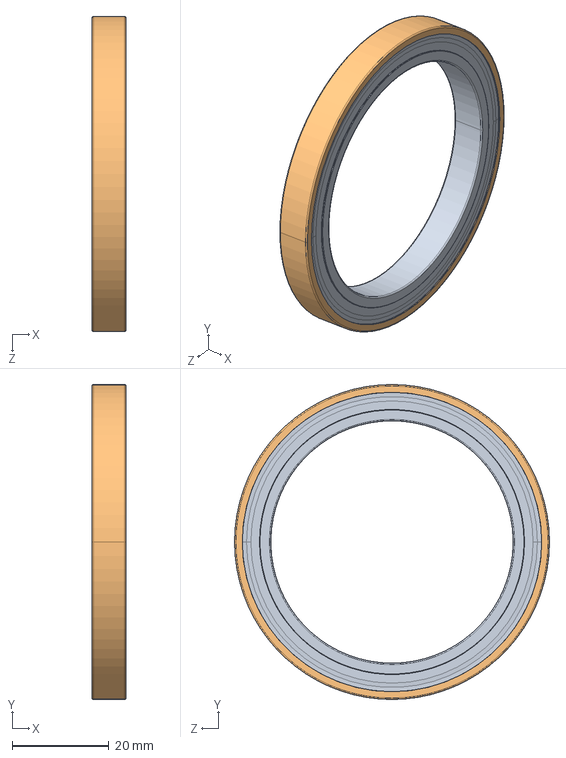
[picture p98: CAD file, 2023-08-29]
Powertrain/Drivetrain/Components/Drexler Assembly/EN-00027-AB-61810-2RS1.SLDASM
7.00 x 65.0 x 65.0 mm
Copy of Copy of _61810_2RS1_PART1_2^EN-00027-AB-61810-2RS1
Copy of Copy of _61810_2RS1_PART2_4^EN-00027-AB-61810-2RS1
