FormulaRacingatUCDavis/FE11_CAD/Unsprung/Controls/Pedal Box/Accelerator Pedal/BR-10001-CA-Accel Pedal Assembly.SLDASM

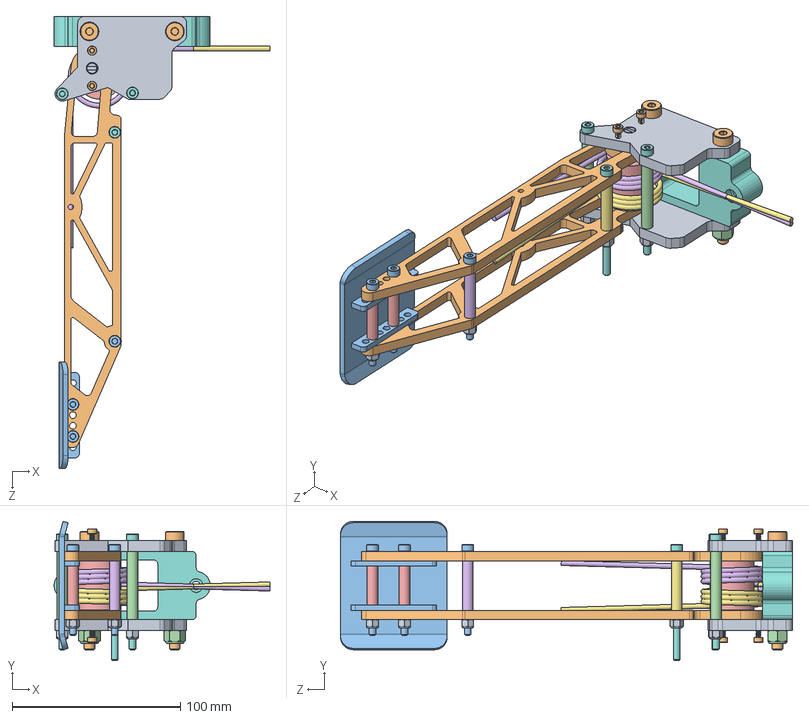
[picture p99: CAD file, 2023-10-22]
Unsprung/Controls/Pedal Box/Accelerator Pedal/BR-10001-CA-Accel Pedal Assembly.SLDASM
128.4 x 82.9 x 268.9 mm
BR-1000X-CA-Accel Pedal Mount x 2
BR-2000X-BA-Accel Pedal Arm x 2
BR-30003-BE-Accel Toe Plate
BR-0000X-AA-AP Mount Spacer x 2
BR-X000X-BB-Torsion Spring Shaft
BR-AD-Torsion Spring (9271K663)
BR-AD-Torsion Spring, Left Wound (9271K597)
BR-Black Oxide C12.9 SHCS, M4x0.7-65 (91290A083) x 3
BR-Steel Nylon Locknut, Grade 8, M4x0.7 (90576A103) x 6
BR-Alloy Steel Shoulder B18.3 SHCS, 0.3125x0.25-20, 2.125 in Lg (91259A480) x 2
BR-Black Oxide C12.9 SHCS, M4x0.7-50 (91290A186) x 3
BR-Steel Nylon Locknut, Grade 8, 0.25-20 (90630A110) x 2
BR-0000X-AA-AP Toe Plate Spacer x 2
BR-0000X-AA-AP Arm Spacer
BR-0000X-AA-APPS Spacer, Right
BR-0000X-CB-Accel Pedal Platform
76161 - D-Shaft
91290A115_Alloy Steel Socket Head Screw M3 x 0.5 mm Thread 10 mm Long x 4
7804K111_Stainless Steel Ball Bearing 6mm ID 10mm OD x 2
