FormulaRacingatUCDavis/FE11_CAD/Unsprung/Controls/Pedal Box/Brake Pedal/BR-10001-BB-Brake Pedal Assembly.SLDASM

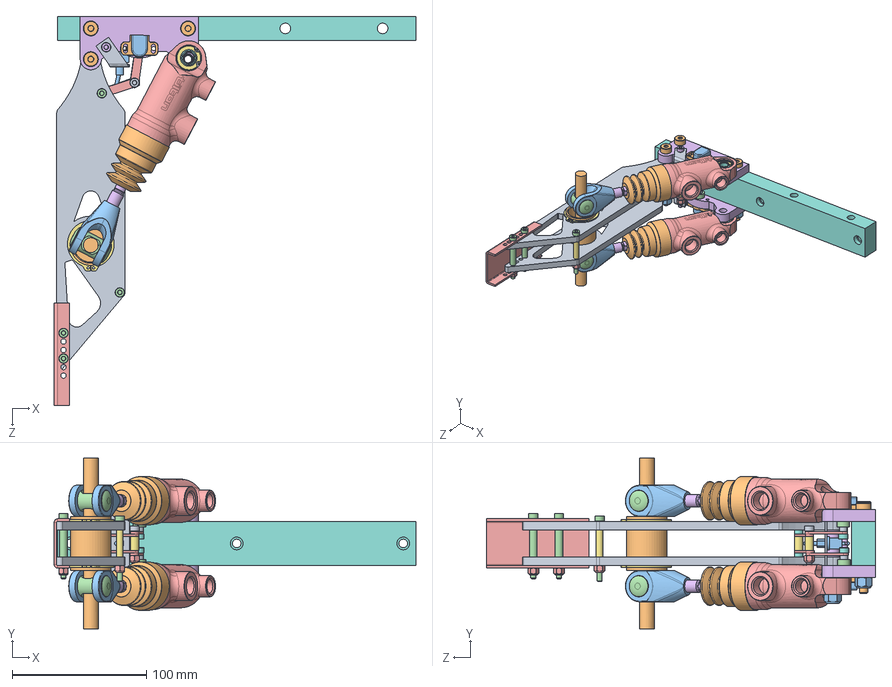
[picture p100: CAD file, 2023-09-12]
Unsprung/Controls/Pedal Box/Brake Pedal/BR-10001-BB-Brake Pedal Assembly.SLDASM
269.2 x 127.0 x 289.6 mm
BR-20002-AB-Brake Pedal Arm x 2
Copy of Bar^BR-00005-AA-Balance Bar (Tilton 600 Series)
BB Arm^BR-00005-AA-Balance Bar (Tilton 600 Series) x 2
BB Bullet^BR-00005-AA-Balance Bar (Tilton 600 Series) x 2
Body^BR-00004-AA-Master Cylinder (Tilton 78 Series) x 2
Piston^BR-00004-AA-Master Cylinder (Tilton 78 Series) x 2
Copy of spherical bearing outer^Copy of Spherical Bearing_BR-00004-AA-Master Cylinder (Tilton 78 Series) x 2
Copy of spherical bearing inner^Copy of Spherical Bearing_BR-00004-AA-Master Cylinder (Tilton 78 Series) x 2
Circlip^BR-00004-AA-Master Cylinder (Tilton 78 Series) x 2
Rubber Boot^BR-00004-AA-Master Cylinder (Tilton 78 Series) x 2
FR-00006-AA-BOTS M2011SD3W01
BR-0000X-AA-Toe Plate Spacer x 2
BR-30003-AC-Toe Plate
BR-0000X-AA-Brake Mount Spacer
BR-0000X-AA-Brake Pedal Arm Spacer Upper
BR-X000X-AA-Brake Pedal Platform
BR-00008-AB-BOTS Mount
BR-Alloy Steel Shoulder B18.3 SHCS, 0.3125x0.25-20, 2 in Lg (91259A591) x 3
BR-Steel Nylon Locknut, Grade 8, 0.25-20 (90630A110) x 4
BR-Black Oxide C12.9 SHCS, M4x0.7-45 (91290A175) x 4
BR-Steel Nylon Locknut, Grade 8, M4x0.7 (90576A103) x 6
BR-Black Oxide C12.9 SHCS, M4x0.7-65 (91290A083)
BR-Spring Steel External Retaining Ring, 1.176 ID (97633A340) x 2
BR-Black Oxide C12.9 SHCS, M4x0.7-5 (91290A138) x 2
BR-Black Oxide C12.9 SHCS, M4x0.7-25 (91290A176)
4048_carcasa MSC-360-G01-001^MSC-360_BR-0000X-AA-APPS (MSC360-1A-C0004-ERA360-05K) x 2
3982_apantallamiento^MSC-360_BR-0000X-AA-APPS (MSC360-1A-C0004-ERA360-05K) x 2
BR-0000X-AA-APPS Linkage Barrel x 2
BR-0000X-AA-APPS Linkage Connect Arm x 4
BR-10001-BB-Brake Pedal Mount x 2
BR-00007-AB-BOTS Contact Spacer x 2
BR-00007-AA-BOTS Contact Spacer Small x 2
BR-0000X-AA-APPS Linkage Spacer Lower Small x 2
