FormulaRacingatUCDavis/FE11_CAD/Powertrain/Accumulator/Components/Power Electronics/Cables/AC-00021-AA-MIddle Maintenance Cable.SLDPRT

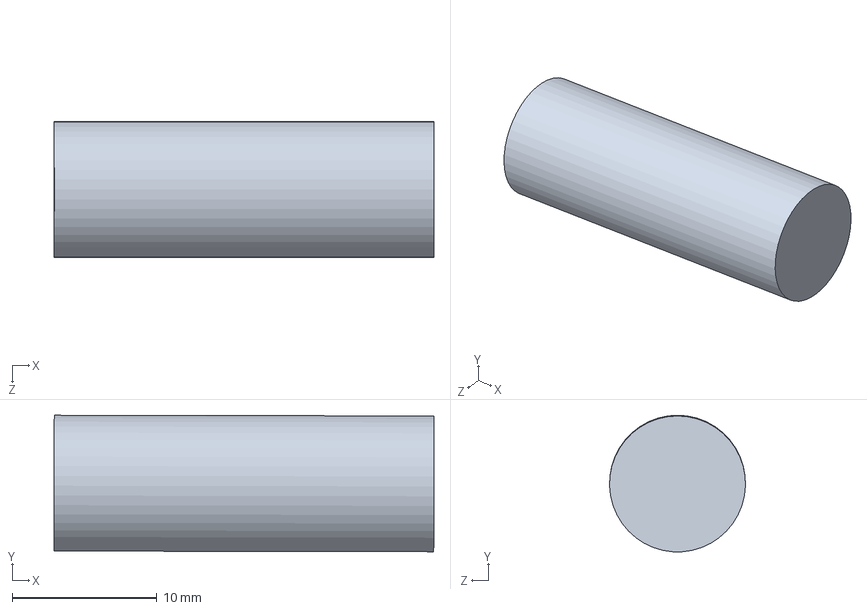
[picture p102: CAD file, 2024-02-17]
Powertrain/Accumulator/Components/Power Electronics/Cables/AC-00021-AA-MIddle Maintenance Cable.SLDPRT
26.3 x 9.44 x 9.39 mm
