FormulaRacingatUCDavis/FE11_CAD/Powertrain/Drivetrain/Components/Drexler Assembly/EN-00026-AB-61811-2RS1.SLDASM

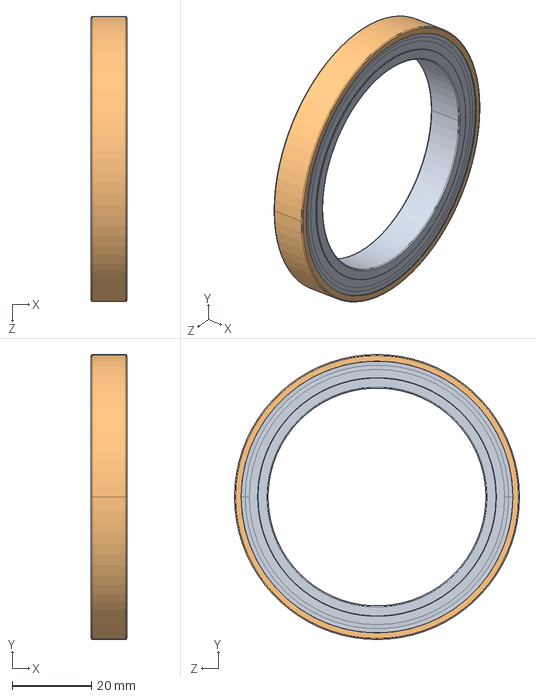
[picture p103: CAD file, 2023-08-29]
Powertrain/Drivetrain/Components/Drexler Assembly/EN-00026-AB-61811-2RS1.SLDASM
9.00 x 72.0 x 72.0 mm
Copy of Copy of _61811_2RS1_PART1_2^EN-00026-AB-61811-2RS1
Copy of Copy of _61811_2RS1_PART2_4^EN-00026-AB-61811-2RS1
