FormulaRacingatUCDavis/FE11_CAD/Unsprung/Controls/Pedal Box/BR-A10001-AC-Pedal Box Assembly.SLDASM

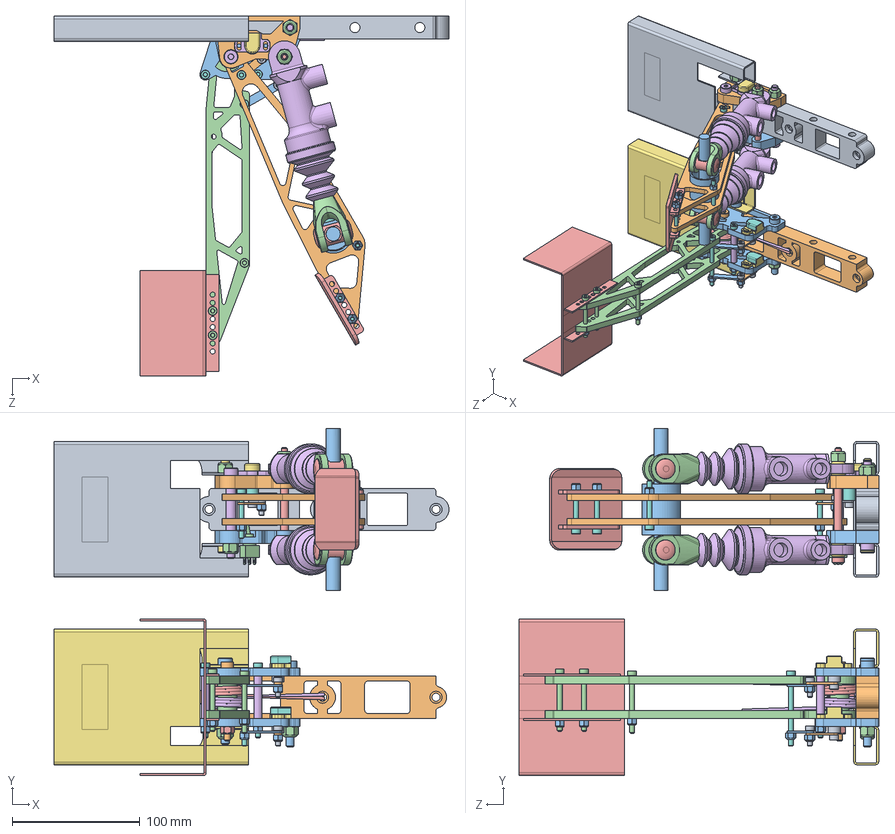
[picture p104: CAD file, 2023-09-12]
Unsprung/Controls/Pedal Box/BR-A10001-AC-Pedal Box Assembly.SLDASM
309.4 x 272.1 x 281.6 mm
BR-X000X-AD-Brake Pedal Platform
BR-20002-AF-Brake Pedal Arm x 2
Copy of Bar^BR-00005-AA-Balance Bar (Tilton 600 Series)
BB Arm^BR-00005-AA-Balance Bar (Tilton 600 Series) x 2
BB Bullet^BR-00005-AA-Balance Bar (Tilton 600 Series) x 2
Main Body^BR-00004-AB-CP7855 Master Cylinder x 2
Spherical Mount^BR-00004-AB-CP7855 Master Cylinder x 2
Threaded Piston^BR-00004-AB-CP7855 Master Cylinder x 2
BR-00001-AA-Heel Plate
BR-10001-BD-Brake Pedal Mount (Left)
BR-10001-BD-Brake Pedal Mount (Right)
FR-00006-AA-BOTS M2011SD3W01
BR-30003-BF-Toe Plate
4048_carcasa MSC-360-G01-001^MSC-360_BR-00009-DA-BPPS (MSC360-1A-C0004-ERA360-05K)
3982_apantallamiento^MSC-360_BR-00009-DA-BPPS (MSC360-1A-C0004-ERA360-05K)
BR-00012-AA-BPPS Linkage Barrel
BR-00010-AB-BPPS Linkage A
BR-00011-AB-BPPS Linkage B
BR-Steel Nylon Locknut, Grade 8, M4x0.7 (90576A103) x 13
BR-Steel Nylon Locknut, Grade 8, 0.25-20 (90630A110) x 6
BR-Alloy Steel Shoulder B18.3 SHCS, 0.25x10-24, 3 in Lg (91259A106)
BR-Alloy Steel Shoulder B18.3 SHCS, 0.3125x0.25-20, 2.125 in Lg (91259A480) x 2
BR-Alloy Steel Shoulder B18.3 SHCS, 0.25x10-24, 2.25 in (91259A108)
BR-Black Oxide C12.9 SHCS, M4x0.7-35 (91290A173) x 4
BR-Black Oxide C12.9 SHCS, M4x0.7-12 (91290A148) x 4
BR-0000X-AB-Accel Pedal Platform
BR-1000X-AB-Accel Pedal Mount x 2
BR-2000X-AD-Accel Pedal Arm x 2
BR-30003-AC-Toe Plate
BR-0000X-AA-Accel Pedal Stop x 2
4048_carcasa MSC-360-G01-001^MSC-360_BR-0000X-AA-APPS (MSC360-1A-C0004-ERA360-05K) x 2
3982_apantallamiento^MSC-360_BR-0000X-AA-APPS (MSC360-1A-C0004-ERA360-05K) x 2
BR-0000X-AA-APPS Linkage Barrel x 2
BR-0000X-AB-APPS Linkage Vert Arm x 2
BR-0000X-AB-APPS Linkage Connect Arm x 2
BR-X000X-AA-Torsion Spring Shaft
BR-AB-0000X-Torsion Spring (9271K659)
BR-AA-0000X-Torsion Spring, Left Wound (9271K594)
BR-0000X-AC-Heel Plate
BR-Black Oxide C12.9 SHCS, M4x0.7-55 (91290A187) x 3
BR-Black Oxide C12.9 SHCS, M4x0.7-8 (91290A140) x 2
BR-Alloy Steel Shoulder B18.3 SHCS, 0.25x10-24, 1.875 in Lg (91259A510)
BR-Alloy Steel Shoulder B18.3 SHCS, 0.3125x0.25-20, 2 in Lg (91259A591) x 2
BR-Black Oxide C12.9 SHCS, M4x0.7-45 (91290A175) x 3
BR-Stainless Steel Nylon Locknut, 10-24 (91831A011)
