FormulaRacingatUCDavis/FE11_CAD/Unsprung/Suspension/FE10/Shocks/Shock Tabs/SP-A0229-AB-Rear Shock Tab Box.SLDASM

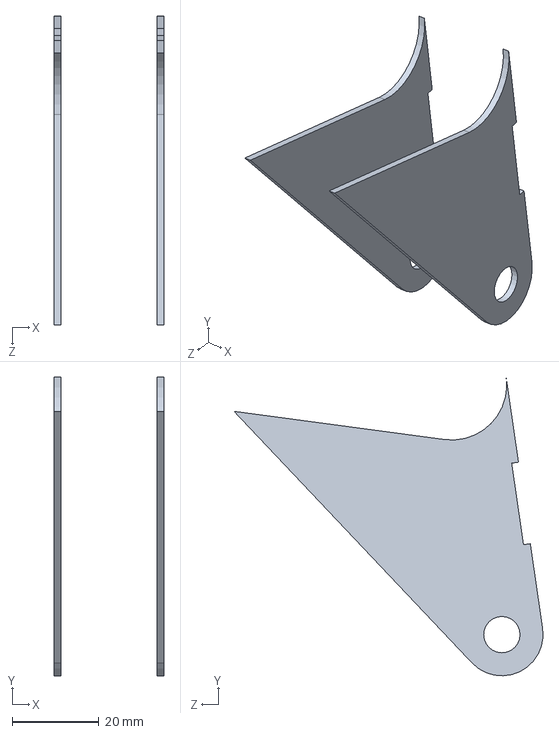
[picture p106: CAD file, 2023-10-22]
Unsprung/Suspension/FE10/Shocks/Shock Tabs/SP-A0229-AB-Rear Shock Tab Box.SLDASM
25.4 x 69.0 x 71.4 mm
SP-30233-AB-Rear Shock Tab x 2
