FormulaRacingatUCDavis/FE11_CAD/Electrical/Components/E-stops/FE10 E-stops/EL-A00XX-AB-E-Stop Assembly.SLDASM

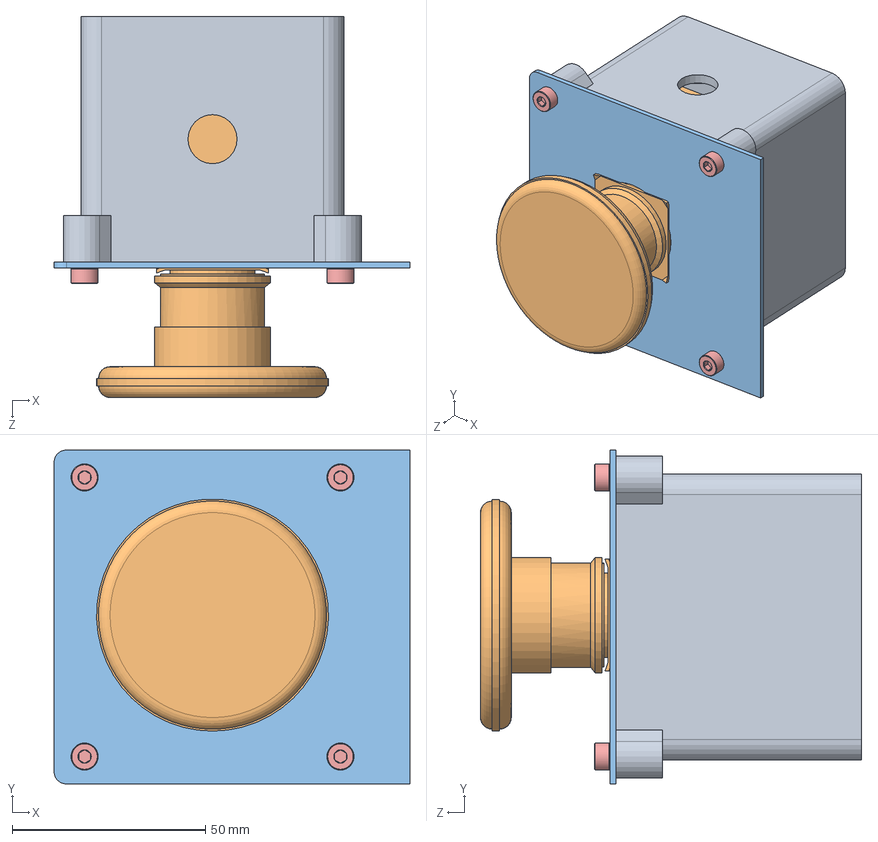
[picture p107: CAD file, 2023-10-24]
Electrical/Components/E-stops/FE10 E-stops/EL-A00XX-AB-E-Stop Assembly.SLDASM
92.1 x 86.4 x 98.6 mm
EL-500XX-AC-E-Stop Enclosure
EL-0002XX-AA-E-Stop
EN-300XX-AA-E-Stop Tab
FS-Heat Set Insert, M4x7-4.7 (94180A351) x 4
BR-Black Oxide C12.9 SHCS, M4x0.7-8 (91290A140) x 4
