FormulaRacingatUCDavis/FE11_CAD/Powertrain/Accumulator/Components/Container/Prototyping/FE12 CAD/Subpack Comparison/FE12 Subpack - Hexagonal Pattern.SLDASM

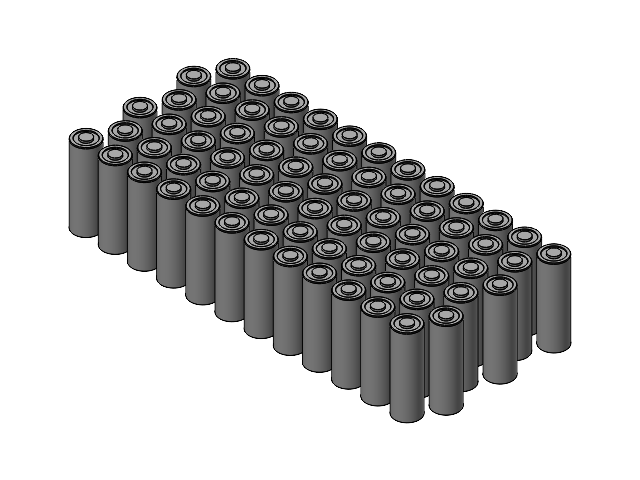
[picture p108: CAD file, 2024-08-28]
Powertrain/Accumulator/Components/Container/Prototyping/FE12 CAD/Subpack Comparison/FE12 Subpack - Hexagonal Pattern.SLDASM
Molicel P45B x 72
