FormulaRacingatUCDavis/FE11_CAD/Powertrain/Accumulator/Components/Subpacks/AC-A0203-AA-Subpack Fixture Assembly.SLDASM

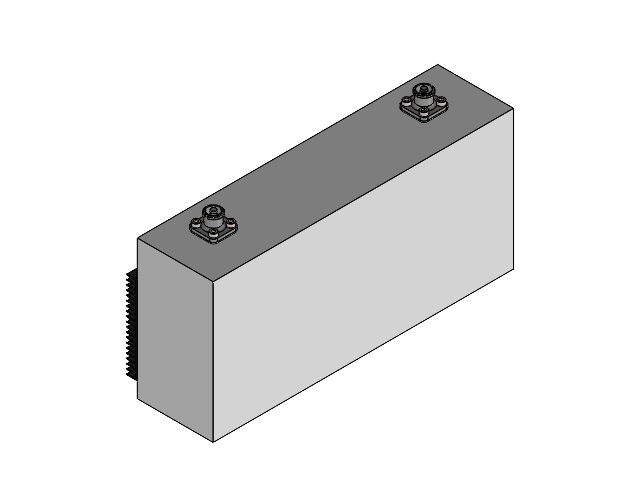
[picture p109: CAD file, 2024-02-17]
Powertrain/Accumulator/Components/Subpacks/AC-A0203-AA-Subpack Fixture Assembly.SLDASM
AC-X0060-AA-Subpack Case Body
AC-00090-AA-Surlock Plus Maintenance Receptacles x 2
AC-00061-AA-Subpack Heatsink
BR-Black Oxide C12.9 SHCS, M4x0.7-8 (91290A140) x 8
