FormulaRacingatUCDavis/FE11_CAD/Powertrain/Drivetrain/Components/CAM/Differential Sprocket 2.75 CAM/Differntial Sprocket 2.75 CAM.SLDASM

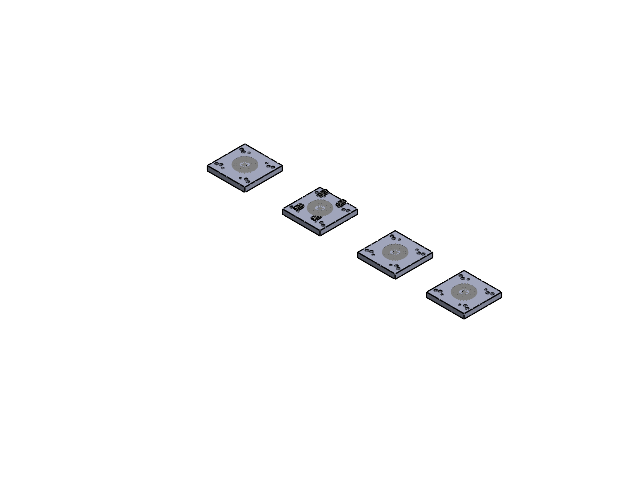
[picture p110: CAD file, 2024-04-30]
Powertrain/Drivetrain/Components/CAM/Differential Sprocket 2.75 CAM/Differntial Sprocket 2.75 CAM.SLDASM
12.00_x_12.00_x_1.5_Fixture_Plate x 4
EN-10029-BA-Differential Sprocket 33-Teeth x 4
4999A31_Step Setup Clamp x 4
