FormulaRacingatUCDavis/FE11_CAD/Powertrain/Drivetrain/Components/CAM/Differential Sprocket CAM/Sprocket_Assem.SLDASM

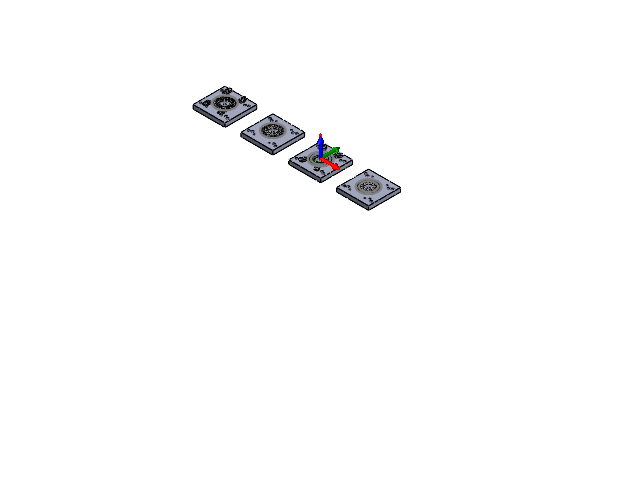
[picture p111: CAD file, 2024-04-30]
Powertrain/Drivetrain/Components/CAM/Differential Sprocket CAM/Sprocket_Assem.SLDASM
12.00_x_12.00_x_1.5_Fixture_Plate x 4
EN-10029-AB-Differential Sprocket x 4
4999A31_Step Setup Clamp x 8
socket head cap screw_am x 24
