FormulaRacingatUCDavis/FE11_CAD/Unsprung/Controls/Steering/Ackermann Testing/Assem2.SLDASM

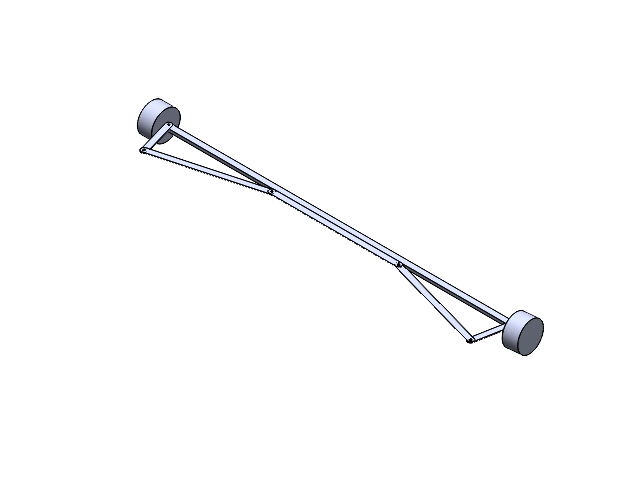
[picture p112: CAD file, 2024-10-08]
Unsprung/Controls/Steering/Ackermann Testing/Assem2.SLDASM
Part2^Assem2
Part4^Assem2 x 2
Part6^Assem2
Part8^Assem2
Part9^Assem2
Part10^Assem2 x 2
