FormulaRacingatUCDavis/FE11_CAD/Unsprung/Controls/Steering/ST-A0200-BA-Inboard Steering.SLDASM

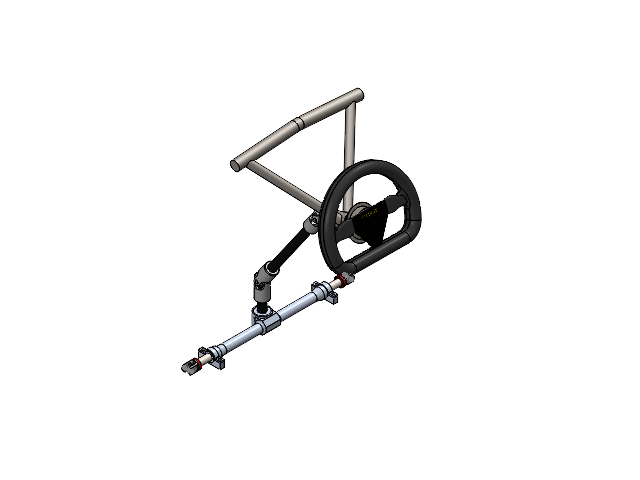
[picture p113: CAD file, 2024-09-14]
Unsprung/Controls/Steering/ST-A0200-BA-Inboard Steering.SLDASM
ST-00020-AA-NARRco Rack MkII Housing^ST-00020-AA-NARRco Rack MkII
ST-00021-AA-NARRco Rack MkII Pinion^ST-00020-AA-NARRco Rack MkII
ST-00022-AA-NARRco Rack MkII Rack^ST-00020-AA-NARRco Rack MkII
ST-00023-AA-NARRco Rack MkII Bump Stop TT1119-01^ST-00020-AA-NARRco Rack MkII x 2
ST-10024-AA-Rack End Fastener^ST-00020-AA-NARRco Rack MkII x 2
ST-10008-AG-Lower Column
ST-10004-AC-Upper Column
ST-10005-BB-Upper Support
ST-00006-AA-Upper Column Bearing (2938T23) x 2
ST-00003-AA-Longacre Spud
ST-#####-AA-MOMO MOD 12
ST-00002-AA-Longacre Quick Disconnect_52-56605
ST-10009-AA-Lower Lower Column
ST-10025-AA-Rack End Left
ST-10025-AA-Rack End
ST-00011-AB-Rack Mount Top x 2
ST-00012-AB-Rack Mount Bottom x 2
2456K17_Mil. Spec. Machinable-Bore Single U-Joint x 2
