FormulaRacingatUCDavis/FE11_CAD/Unsprung/Controls/Steering/Steering Collar Jigging/Chassis Steering Collar Jig.SLDASM

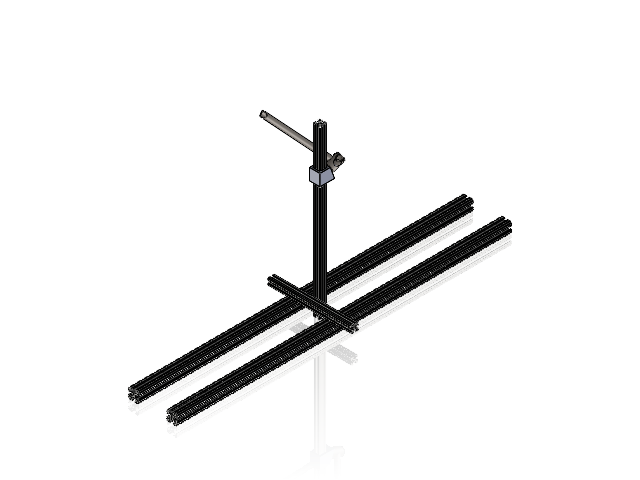
[picture p114: CAD file, 2024-03-02]
Unsprung/Controls/Steering/Steering Collar Jigging/Chassis Steering Collar Jig.SLDASM
47065T127_T-Slotted Framing Extruded Al x 2
47065T209_T-Slotted Framing Extruded Al 1x1 - 2 ft
47065T411_T-Slotted Framing 1x1 1ft
JigtoChassisA
ST-10005-BC-Upper Support
ST-00006-AA-Upper Column Bearing (2938T23) x 2
