FormulaRacingatUCDavis/FE11_CAD/Unsprung/Suspension/FE10/Tie-Rod Assembly/Rear/MirrorSP-####-AA-Rear Tie Rod Assem.SLDASM

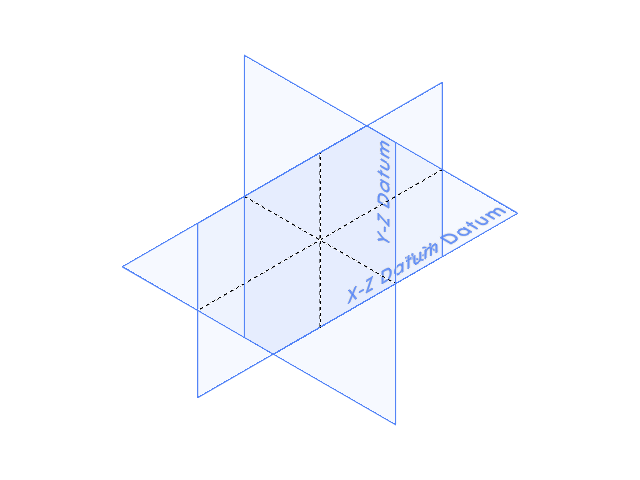
[picture p116: CAD file, 2023-10-22]
Unsprung/Suspension/FE10/Tie-Rod Assembly/Rear/MirrorSP-####-AA-Rear Tie Rod Assem.SLDASM
MirrorSP-####-AA-Rear Tie Rod
MirrorSP-10003-AC-Threaded Insert x 2
MirrorBody^FS-MALE ROD END UNF-3A, 0.25x28-0 x 2
MirrorBall^FS-MALE ROD END UNF-3A, 0.25x28-0 x 2
