FormulaRacingatUCDavis/FE11_CAD/Powertrain/Accumulator/Components/Container/Prototyping/FE12 CAD/Subpack Comparison/Hexagonal Pattern.SLDASM

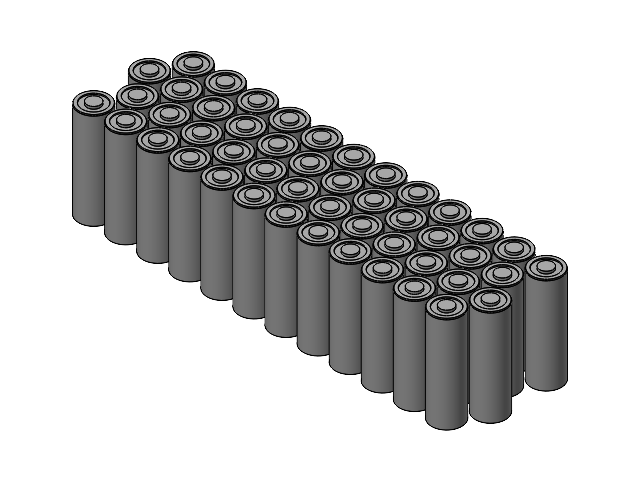
[picture p117: CAD file, 2024-08-28]
Powertrain/Accumulator/Components/Container/Prototyping/FE12 CAD/Subpack Comparison/Hexagonal Pattern.SLDASM
Molicel P45B x 48
