FormulaRacingatUCDavis/FE11_CAD/Powertrain/Cooling/Components/Expansion Tank/Expansion Tank Subassembly.SLDASM

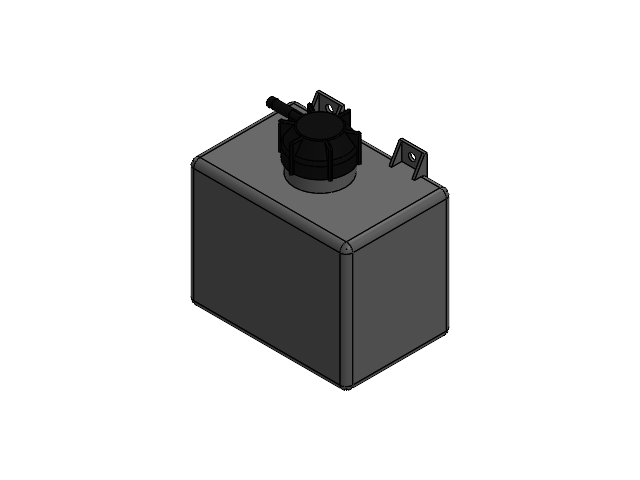
[picture p118: CAD file, 2024-04-30]
Powertrain/Cooling/Components/Expansion Tank/Expansion Tank Subassembly.SLDASM
EN-00055-AB-Expansion Tank
EN-00056-AB-Expansion Tank Cap
