FormulaRacingatUCDavis/FE11_CAD/Unsprung/Suspension/Components/Push Rods/Pushrod Tabs/SP-A####-AA-Pushrod Tab Box.SLDASM

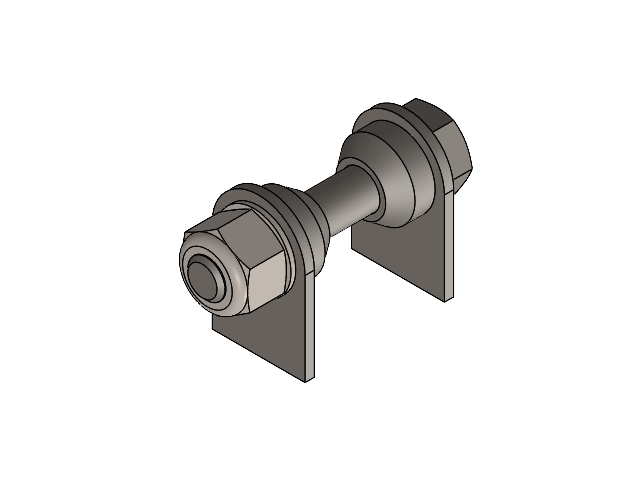
[picture p119: CAD file, 2023-10-22]
Unsprung/Suspension/Components/Push Rods/Pushrod Tabs/SP-A####-AA-Pushrod Tab Box.SLDASM
Copy of SP-30063-AB-Pushrod Tab^SP-A####-AA-Pushrod Tab Box x 2
Copy of FS-CADMIUM PLATED C3 HX, 0.25x28-1.41-0.469 (AN4-13A)^SP-A####-AA-Pushrod Tab Box
Copy of FS-NYLOC G8 HX, 0.25x28-0.3125 (90630A145)^SP-A####-AA-Pushrod Tab Box
Copy of FS-FLAT WASHER THIN, 0.25-0.5D (AN960-416L)^SP-A####-AA-Pushrod Tab Box x 2
Copy of FS-ROD END RETAINING WASHER, 0.25-0.25 (NO PN)^SP-A####-AA-Pushrod Tab Box x 2
