FormulaRacingatUCDavis/FE11_CAD/Unsprung/Wheel Package/CAM/Brake Rotor CAM/CAMBreakRotorPostWaterJet.SLDASM

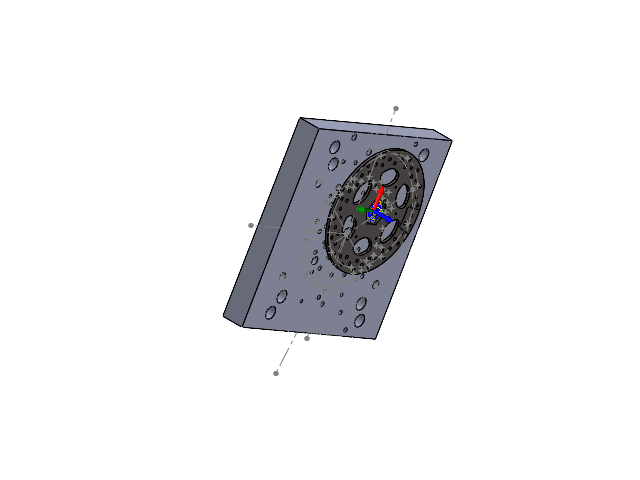
[picture p120: CAD file, 2024-06-04]
Unsprung/Wheel Package/CAM/Brake Rotor CAM/CAMBreakRotorPostWaterJet.SLDASM
BR-#####-AB-Solid Brake Rotor
12.00_x_12.00_x_1.5_Fixture_Plate
BR-RotorJetStock
