FormulaRacingatUCDavis/FE11_CAD/Electrical/Components/E-stops/EL-A0103-AA-E-Stop Assembly.SLDASM

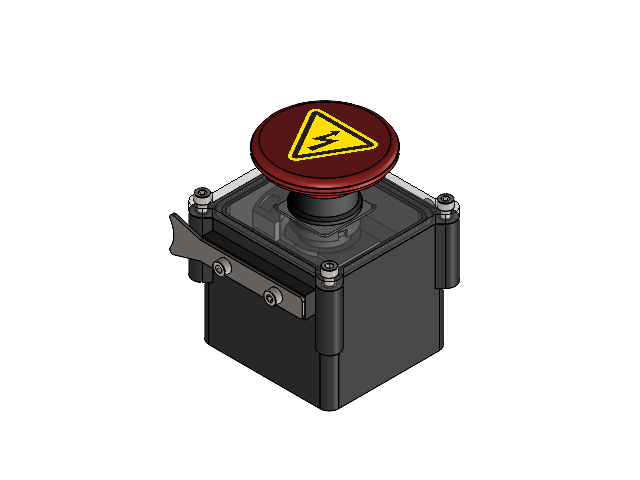
[picture p121: CAD file, 2024-04-30]
Electrical/Components/E-stops/EL-A0103-AA-E-Stop Assembly.SLDASM
EL-50052-AA-E-Stop Enclosure
EL-0002XX-AA-E-Stop
FS-Heat Set Insert, M4x7-4.7 (94180A351)2 x 8
BR-Black Oxide C12.9 SHCS, M4x0.7-8 (91290A140) x 8
EL-50051-AA-E-Stop Lid
EL-20050-AA-E-Stop Brackets x 2
