FormulaRacingatUCDavis/FE11_CAD/Electrical/Components/Telemnodes/EL-A0108-AA-Rear Telemnode Assembly.SLDASM

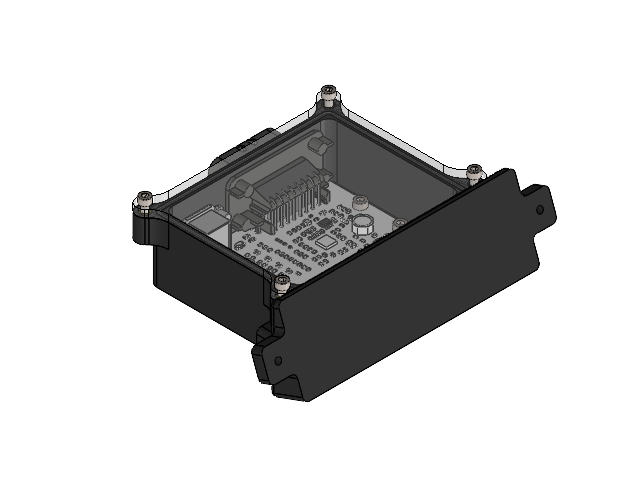
[picture p122: CAD file, 2024-04-30]
Electrical/Components/Telemnodes/EL-A0108-AA-Rear Telemnode Assembly.SLDASM
EL-80101-AA-Rear Telemnode PCB
EL-50100-AA-Rear Telemnode Enclosure
EL-60102-AA-Telemnode Enclosure Lid
EL-500XX-AA-Rear Telemnode Mounting Base
AC-Heat Set Insert, M4x7-4.7 (94180A351) x 8
BR-Black Oxide C12.9 SHCS, M4x0.7-8 (91290A140) x 4
BR-Black Oxide C12.9 SHCS, M4x0.7-5 (91290A138) x 4
91290A168_Alloy Steel Socket Head Screw M4x0.7, 20mm x 2
BR-Steel Nylon Locknut, Grade 8, M4x0.7 (90576A103) x 2
