FormulaRacingatUCDavis/FE11_CAD/Powertrain/Drivetrain/Components/CAM/DS Bracket CAM/DS Bracket CAM.SLDASM

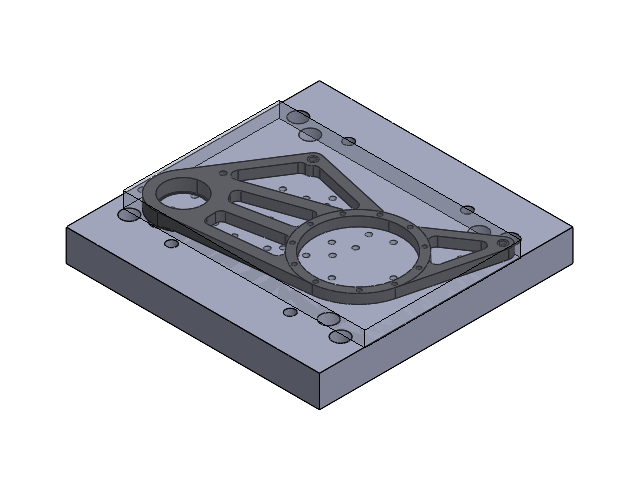
[picture p123: CAD file, 2024-02-17]
Powertrain/Drivetrain/Components/CAM/DS Bracket CAM/DS Bracket CAM.SLDASM
12.00_x_12.00_x_1.5_Fixture_Plate
DS Bracket Stock
EN-10001-BC-Drive_Side_Bracket
