FormulaRacingatUCDavis/FE11_CAD/Unsprung/Controls/Pedal Box/Accelerator Pedal/Components/APPS/BR-0000X-AA-APPS (MSC360-1A-C0004-ERA360-05K).SLDASM

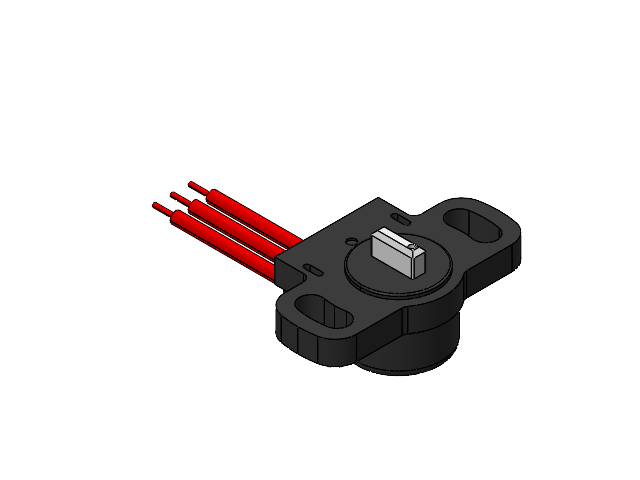
[picture p124: CAD file, 2023-09-12]
Unsprung/Controls/Pedal Box/Accelerator Pedal/Components/APPS/BR-0000X-AA-APPS (MSC360-1A-C0004-ERA360-05K).SLDASM
3980_cable^3981_subjto PCB_MSC-360_BR-0000X-AA-APPS (MSC360-1A-C0004-ERA360-05K) x 3
3987_rotor sobremoldeado^3987 rotor sobremoldeo_MSC-360_BR-0000X-AA-APPS (MSC360-1A-C0004-ERA360-05K)
4048_carcasa MSC-360-G01-001^MSC-360_BR-0000X-AA-APPS (MSC360-1A-C0004-ERA360-05K)
3982_apantallamiento^MSC-360_BR-0000X-AA-APPS (MSC360-1A-C0004-ERA360-05K)
