FormulaRacingatUCDavis/FE11_CAD/Unsprung/Controls/Steering/Steering Collar Jigging/Jig to Steering Collar Tubes.SLDASM

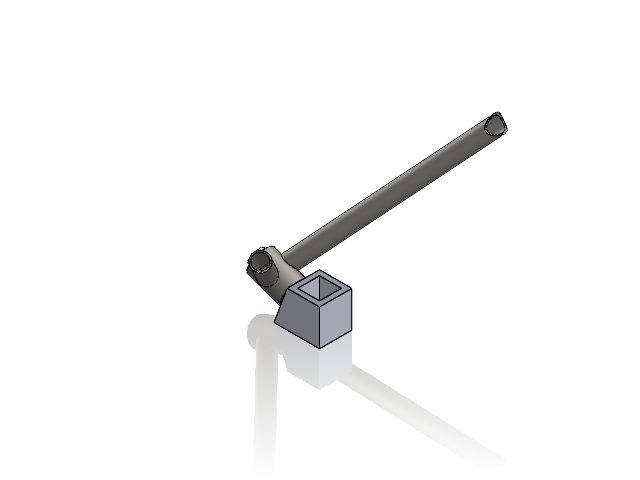
[picture p125: CAD file, 2024-03-02]
Unsprung/Controls/Steering/Steering Collar Jigging/Jig to Steering Collar Tubes.SLDASM
JigtoChassisA
ST-10005-BC-Upper Support
