FormulaRacingatUCDavis/FE11_CAD/Unsprung/Suspension/Components/CAM/Apex CAM.SLDASM

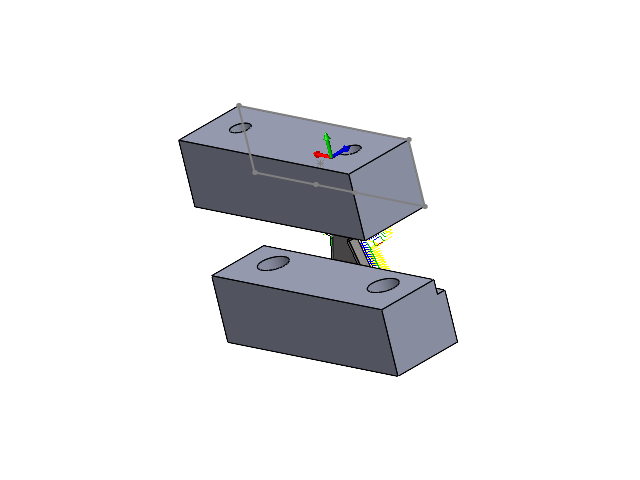
[picture p126: CAD file, 2024-03-02]
Unsprung/Suspension/Components/CAM/Apex CAM.SLDASM
Soft Jaws
Apex Stock
Soft Jaws Step side
SP-10052-AB-Upper Apex R
