FormulaRacingatUCDavis/FE11_CAD/Unsprung/Wheel Package/CAM/Front Camber Block Cam/WT-XXXXX-CA-Front Camber Block.SLDASM

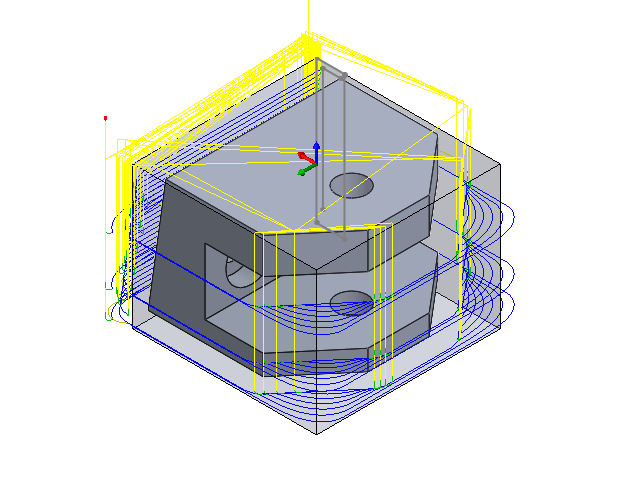
[picture p127: CAD file, 2024-03-14]
Unsprung/Wheel Package/CAM/Front Camber Block Cam/WT-XXXXX-CA-Front Camber Block.SLDASM
CA-Front Camber Block STOCK
WT-XXXXX-CA-Front Camber Block(1)
