FormulaRacingatUCDavis/FE11_CAD/Powertrain/Accumulator/Components/Container/Prototyping/AC mini Waterproofing Assembly.SLDASM

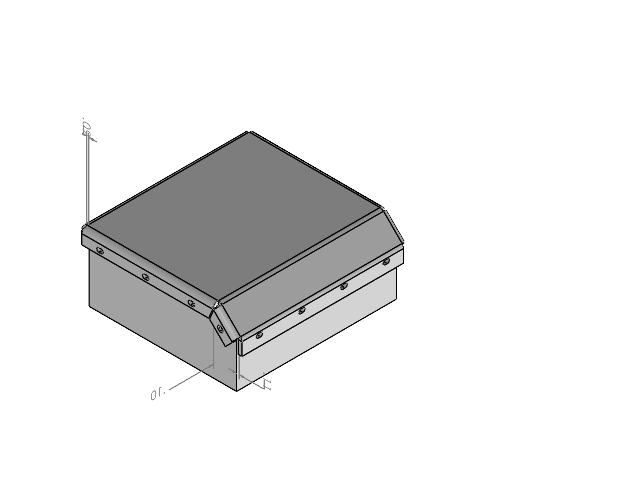
[picture p129: CAD file, 2024-02-17]
Powertrain/Accumulator/Components/Container/Prototyping/AC mini Waterproofing Assembly.SLDASM
AC V4 Waterproofing container
AC mini lid
