FormulaRacingatUCDavis/FE11_CAD/Powertrain/Drivetrain/Components/CAM/DS Bracket CAM/AB DSB CAM.SLDASM

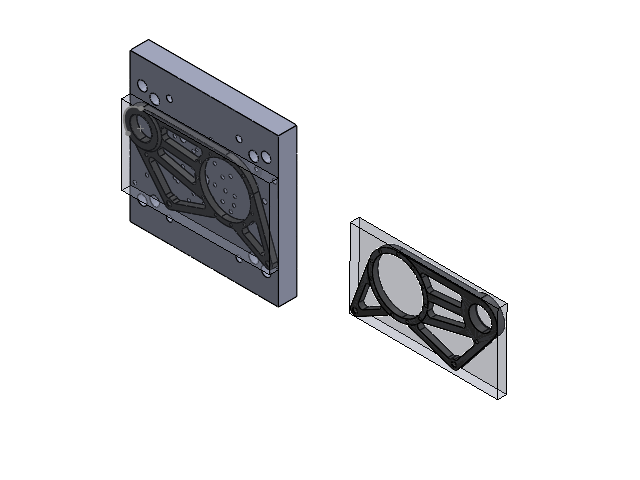
[picture p130: CAD file, 2024-02-17]
Powertrain/Drivetrain/Components/CAM/DS Bracket CAM/AB DSB CAM.SLDASM
12.00_x_12.00_x_1.5_Fixture_Plate
EN-10001-BC-Drive_Side_Bracket x 2
DS Bracket Stock x 2
