FormulaRacingatUCDavis/FE11_CAD/Powertrain/Drivetrain/Components/CAM/SS Bracket CAM/SS Bracket CAM.SLDASM

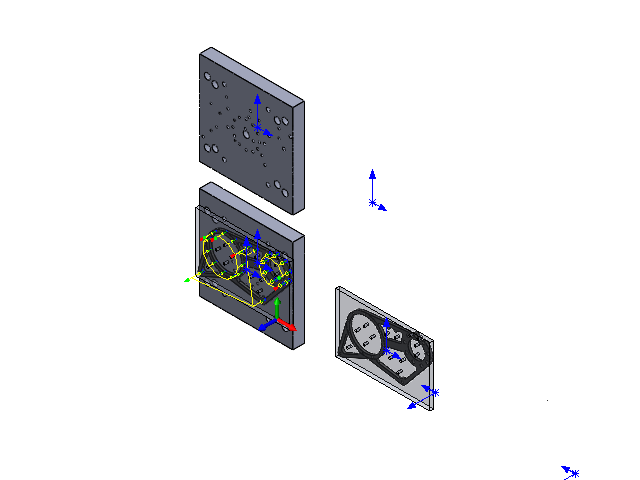
[picture p131: CAD file, 2024-02-17]
Powertrain/Drivetrain/Components/CAM/SS Bracket CAM/SS Bracket CAM.SLDASM
12.00_x_12.00_x_1.5_Fixture_Plate x 2
SS Bracket Stock x 2
EN-10001-BC-Support Side Bracket x 2
