FormulaRacingatUCDavis/FE11_CAD/Powertrain/Drivetrain/Components/Drexler Assembly/EN-00028-AB-HK 2820.SLDASM

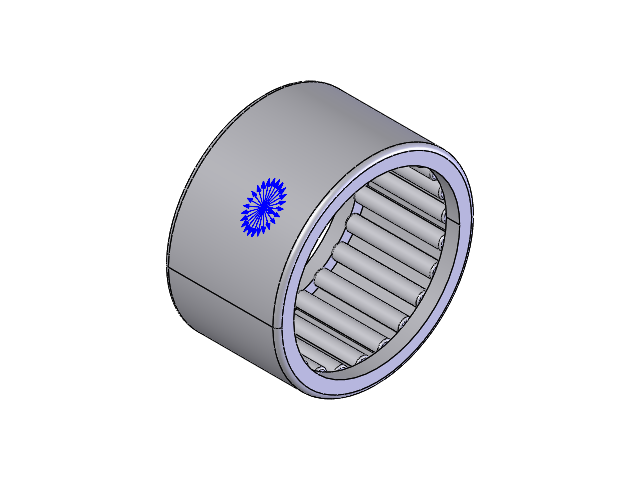
[picture p132: CAD file, 2023-08-29]
Powertrain/Drivetrain/Components/Drexler Assembly/EN-00028-AB-HK 2820.SLDASM
Copy of Copy of _HK_2820_PART1_2^EN-00028-AB-HK 2820
Copy of Copy of _HK_2820_PART2_4^EN-00028-AB-HK 2820 x 24
