FormulaRacingatUCDavis/FE11_CAD/Unsprung/Wheel Package/CAM/BA Camber Block CAM.SLDASM

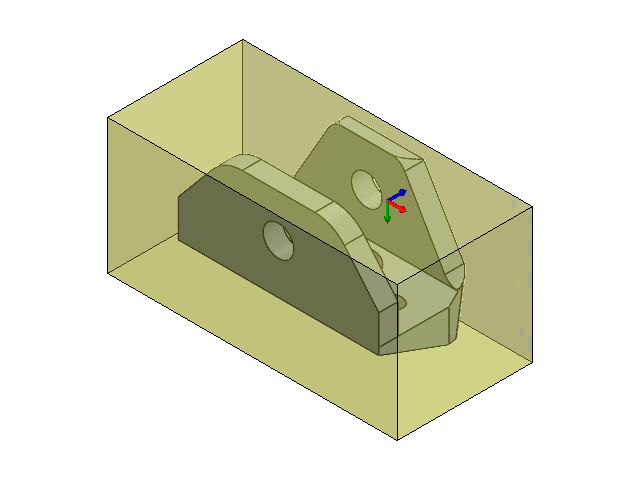
[picture p133: CAD file, 2024-03-14]
Unsprung/Wheel Package/CAM/BA Camber Block CAM.SLDASM
WT-RR####-CA-Camber Block
Camber Block CAM Stock
