FormulaRacingatUCDavis/FE11_CAD/Unsprung/Wheel Package/CAM/Brake Rotor CAM/NOTUSEDCAM.SLDASM

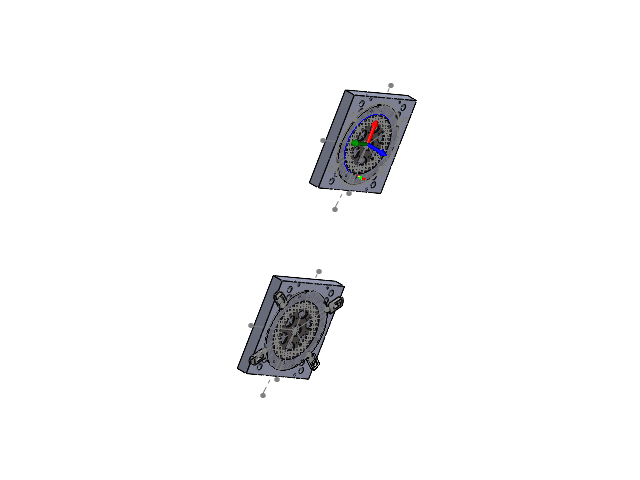
[picture p134: CAD file, 2024-05-30]
Unsprung/Wheel Package/CAM/Brake Rotor CAM/NOTUSEDCAM.SLDASM
BR-#####-AB-Solid Brake Rotor x 2
WT-Brake Rotor STOCK x 2
12.00_x_12.00_x_1.5_Fixture_Plate x 2
4999A31_Step Setup Clamp x 4
91290A154_Alloy Steel Socket Head Screw, M4x0.7, 16mm x 9
