FormulaRacingatUCDavis/FE11_CAD/Powertrain/Accumulator/Components/Container/AC-A0201-EA-Container Assembly.SLDASM

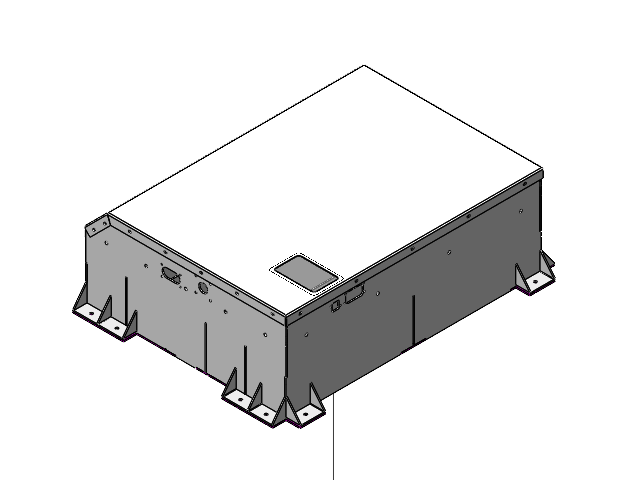
[picture p135: CAD file, 2024-04-30]
Powertrain/Accumulator/Components/Container/AC-A0201-EA-Container Assembly.SLDASM
AC-30070-DC-Accumulator Floor
AC-30071-BA-Center Wall
AC-30072-AE-Front Wall
AC-30073-AE-Rear Wall
AC-30074-AC-Internal Wall 1
AC-30075-AD-Internal Wall 2
AC-30076-AC-Internal Wall 3
AC-30077-AC-Internal Wall 4
AC-30078-AD-Left Wall
AC-30079-AD-Right Wall
AC-20080-CA-Accumulator Lid
AC-60083-AA-PEI Board Clear Cover
AC-30081-AB- Side Container Gussets x 8
AC-30082-AC- Rear Container Gusset x 2
