FormulaRacingatUCDavis/FE11_CAD/Powertrain/Accumulator/Components/Container/Prototyping/FE12 CAD/Subpack Comparison/Subpack layout for CDR.SLDASM

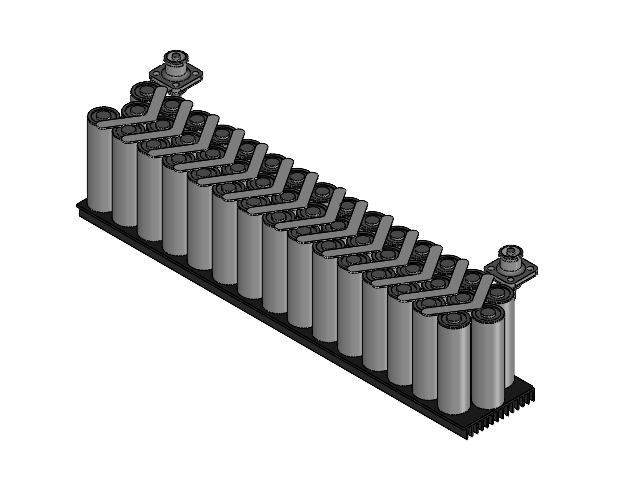
[picture p136: CAD file, 2024-08-15]
Powertrain/Accumulator/Components/Container/Prototyping/FE12 CAD/Subpack Comparison/Subpack layout for CDR.SLDASM
Molicel P45B x 45
FE12 generic heatsink
AC-00090-AA-Surlock Plus Maintenance Receptacles x 2
FE12 sample busbar x 14
