FormulaRacingatUCDavis/FE11_CAD/Unsprung/Wheel Package/CAM/Camber Block CAM.SLDASM

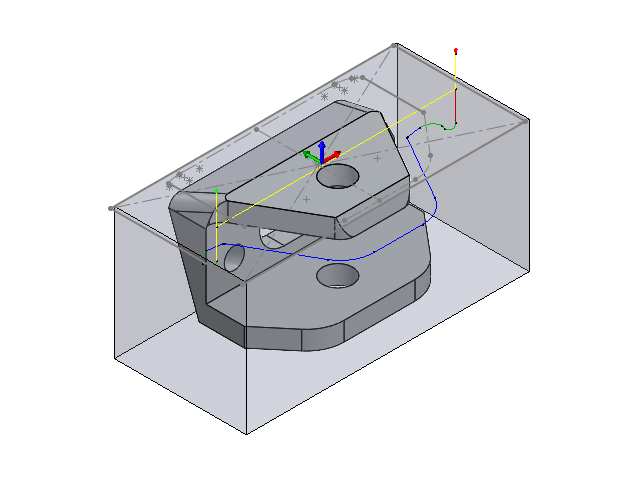
[picture p137: CAD file, 2024-03-02]
Unsprung/Wheel Package/CAM/Camber Block CAM.SLDASM
Camber Block CAM Stock
2.21.24 WT-RR####-CA-Camber Block
