FormulaRacingatUCDavis/FE11_CAD/(list of files, cad)

Other CAD files:
Powertrain/Accumulator/Components/Subpacks/Busbars/AC-00041-AA-Surlock Maintenance Receptable.SLDPRT
Unsprung/Controls/Pedal Box/Accelerator Pedal/BR-10001-CC-Accel Pedal Assembly.SLDASM
Unsprung/Suspension/FE10/Shocks/MirrorSP-A0105-AC-Ohlin TTX25 MKII, 200mm.SLDASM
Electrical/Components/Brake Light/EL-A0105-AA-Brake Light Assembly.SLDASM
Unsprung/Suspension/Components/Shocks/MirrorSP-A0105-AC-Ohlin TTX25 MKII, 200mm.SLDASM
Electrical/Components/LV Battery/EL-50060-AA-LV Battery Assembly.SLDASM
Unsprung/Controls/Steering/Components/Rack Mount Spacer/ST-40026-AB-Rack Mount Spacer.SLDASM
Unsprung/Controls/Steering/ST-A0100-AA-Inboard Steering.SLDASM
Unsprung/Suspension/Components/Rockers/MirrorFront Rocker Assembly.SLDASM
Unsprung/Suspension/FE10/Rockers/MirrorFront Rocker Assembly.SLDASM
Unsprung/Controls/Pedal Box/Accelerator Pedal/BR-10001-AC-Accel Pedal Assembly.SLDASM
CAD Workshop/FR-20001-AA-Frame Gusset.SLDDRW
CAD Workshop/FR-20001-AA-Frame Gusset.SLDPRT
Electrical/Components/Brake Light/EL-00081-AA-Brake light.SLDPRT
Electrical/Components/Brake Light/EL-30080-AA-Brake Light Tabs.SLDPRT
Electrical/Components/Crash Sensor/EL-30001-AA-Crash Sensor Tab.SLDPRT
Electrical/Components/Crash Sensor/EL-30090-AA-Crash Sensor Tab.SLDPRT
Electrical/Components/Dashboard/BA-Dashboard Enclosure.SLDPRT
Electrical/Components/Dashboard/Carbon Fiber Dash Panel Tabs.SLDPRT
Electrical/Components/Dashboard/Carbon Fiber Dashboard Panel.SLDPRT
Electrical/Components/Dashboard/Carbon_Dashboard (Edwin).SLDPRT
Electrical/Components/Dashboard/Carbon_Dashboard_Edwin.SLDPRT
Electrical/Components/Dashboard/Controller Board.SLDPRT
Electrical/Components/Dashboard/DASH V1.SLDPRT
Electrical/Components/Dashboard/Dashbaord Enclosure.SLDPRT
Electrical/Components/Dashboard/Dashboard Display.SLDPRT
Electrical/Components/Dashboard/Dashboard Enclosure Lid.SLDPRT
Electrical/Components/Dashboard/Dashboard Panel Clear Screen.SLDPRT
Electrical/Components/Dashboard/EL-30045-AA-Carbon Fiber Dash Panel Tabs.SLDPRT
Electrical/Components/Dashboard/EL-50041-AA-Dashboard Enclosure.SLDPRT
Electrical/Components/Dashboard/EL-50041-BA-Dashboard Enclosure.SLDPRT
Electrical/Components/Dashboard/EL-50048-AA-SD Card Slot Cap.SLDPRT
Electrical/Components/Dashboard/EL-60046-AA-Dashboard Enclosure Lid.SLDPRT
Electrical/Components/Dashboard/EL-60047-AA-Dashboard Panel Clear Screen.SLDPRT
Electrical/Components/Dashboard/EL-70040-AA-Dashboard Carbon Fiber Panel.SLDPRT
Electrical/Components/Dashboard/EL-70040-AB-Dashboard Carbon Fiber Panel.SLDPRT
Electrical/Components/Dashboard/EL-80042-AA-Dashboard Display.SLDPRT
Electrical/Components/Dashboard/EL-80044-AA-Dashboard Controller Board.SLDPRT
Electrical/Components/Dashboard/FE10 Dashboard Packaging/BEZEL.SLDPRT
Electrical/Components/Dashboard/FE10 Dashboard Packaging/BLU-1.SLDPRT
Electrical/Components/Dashboard/FE10 Dashboard Packaging/BLU.SLDPRT
Electrical/Components/Dashboard/FE10 Dashboard Packaging/BSO4-M3-6.SLDPRT
Electrical/Components/Dashboard/FE10 Dashboard Packaging/Board mounting bracket.SLDPRT
Electrical/Components/Dashboard/FE10 Dashboard Packaging/Board-Part-1.SLDPRT
Electrical/Components/Dashboard/FE10 Dashboard Packaging/Board.SLDASM
Electrical/Components/Dashboard/FE10 Dashboard Packaging/Cover.SLDPRT
Electrical/Components/Dashboard/FE10 Dashboard Packaging/Dashboard Display.SLDASM
Electrical/Components/Dashboard/FE10 Dashboard Packaging/Dashboard Jigging Spacer.SLDPRT
Electrical/Components/Dashboard/FE10 Dashboard Packaging/EL-000XX-AA-Dashboard Controller Board.SLDPRT
Electrical/Components/Dashboard/FE10 Dashboard Packaging/EL-300XX-AA-Dashboard Enclosure Tabs.SLDPRT
Electrical/Components/Dashboard/FE10 Dashboard Packaging/EL-300XX-AA-Left Control Panel Tab.SLDPRT
Electrical/Components/Dashboard/FE10 Dashboard Packaging/EL-300XX-AA-Right Control Panel Tab.SLDPRT
Electrical/Components/Dashboard/FE10 Dashboard Packaging/EL-300XX-AB-Left Control Panel Tab.SLDPRT
Electrical/Components/Dashboard/FE10 Dashboard Packaging/EL-500XX-AA-Dashboard Bottom Enclosure.SLDPRT
Electrical/Components/Dashboard/FE10 Dashboard Packaging/EL-500XX-AA-Dashboard Rear Flat Panel.SLDPRT
Electrical/Components/Dashboard/FE10 Dashboard Packaging/EL-500XX-AA-Dashboard Screen Flat Panel.SLDPRT
Electrical/Components/Dashboard/FE10 Dashboard Packaging/EL-500XX-AA-Dashboard Spacer.SLDPRT
Electrical/Components/Dashboard/FE10 Dashboard Packaging/EL-500XX-BA-Dashboard Bottom Enclosure.SLDPRT
Electrical/Components/Dashboard/FE10 Dashboard Packaging/EL-600XX-AA-Dashboard Enclosure Lid.SLDPRT
Electrical/Components/Dashboard/FE10 Dashboard Packaging/EL-600XX-AA-Dashboard Screen Clear Acrylic.SLDPRT
Electrical/Components/Dashboard/FE10 Dashboard Packaging/EL-80001-AA-Dashboard Display.SLDASM
Electrical/Components/Dashboard/FE10 Dashboard Packaging/EL-80006-AA-Dashboard PCB.SLDPRT
Electrical/Components/Dashboard/FE10 Dashboard Packaging/EL-A00XX-AA-Dashboard Assembly.SLDASM
Electrical/Components/Dashboard/FE10 Dashboard Packaging/NHD-4.3-480272EF-subassembly-1.SLDASM
Electrical/Components/Dashboard/FE10 Dashboard Packaging/NHD-4.3-480272EF-subassembly-2.SLDASM
Electrical/Components/Dashboard/FE10 Dashboard Packaging/NHD-4.3-480272EF.SLDASM
Electrical/Components/Dashboard/FE10 Dashboard Packaging/NHD-4.3-480272MB-xxxx.SLDASM
Electrical/Components/Dashboard/FE10 Dashboard Packaging/NHD-4.3-480272MF-34-Controller-Board.SLDPRT
Electrical/Components/Dashboard/FE10 Dashboard Packaging/NHD-4.3-B.SLDPRT
Electrical/Components/Dashboard/FE10 Dashboard Packaging/PANEL-1.SLDPRT
Electrical/Components/Dashboard/FE10 Dashboard Packaging/PANEL.SLDPRT
Electrical/Components/Dashboard/FE10 Dashboard Packaging/PCB2 (1).sldasm-subassembly-1.SLDASM
Electrical/Components/Dashboard/FE10 Dashboard Packaging/Screen Cover.SLDPRT
Electrical/Components/Dashboard/FE10 Dashboard Packaging/Spacer.SLDPRT
Electrical/Components/Dashboard/FE10 Dashboard Packaging/Top Cover.SLDPRT
Electrical/Components/Dashboard/FE10 Dashboard Packaging/Top Plate Cover.SLDPRT
Electrical/Components/E-stops/EL-0002XX-AA-E-Stop.SLDPRT
Electrical/Components/E-stops/EL-20050-AA-E-Stop Brackets.SLDPRT
Electrical/Components/E-stops/EL-50051-AA-E-Stop Lid.SLDPRT
Electrical/Components/E-stops/EL-50052-AA-E-Stop Enclosure.SLDPRT
Electrical/Components/E-stops/FE10 E-stops/E-Stop Tab Spacer.SLDPRT
Electrical/Components/E-stops/FE10 E-stops/EL-500XX-AA-E-Stop Enclosure.SLDPRT
Electrical/Components/E-stops/FE10 E-stops/EL-500XX-AA-E-Stop Tab Spacer.SLDPRT
Electrical/Components/E-stops/FE10 E-stops/EL-500XX-AB-E-Stop Enclosure.SLDPRT
Electrical/Components/E-stops/FE10 E-stops/EL-500XX-AC-E-Stop Enclosure.SLDPRT
Electrical/Components/E-stops/FE10 E-stops/EN-300XX-AA-E-Stop Tab.SLDPRT
Electrical/Components/E-stops/FE10 E-stops/EN-300XX-AB-E-Stop Tab.SLDPRT
Electrical/Components/HVI/EL-50090-AA-HVI Enclosure.SLDPRT
Electrical/Components/HVI/EL-50093-AA-HVI Mounting Adapter.SLDPRT
Electrical/Components/HVI/EL-60092-AA-HVI Enclosure Lid.SLDPRT
Electrical/Components/HVI/EL-80091-AA-HVI PCB.SLDPRT
Electrical/Components/HVI/HVI Mounting Adapter.SLDPRT
Electrical/Components/LV Battery/BR-Black Oxide C12.9 SHCS, M4x0.7-8 (91290A140).SLDPRT
Electrical/Components/LV Battery/EL-00004-AA-Aegies-12 V 20 Ah Battery.SLDPRT
Electrical/Components/LV Battery/EL-30061-AA-LV Battery Mounting Tab.SLDPRT
Electrical/Components/LV Battery/EL-50060-AA-LV Battery Enclosure.SLDPRT
Electrical/Components/LV Battery/FE10 LV Battery/Battery Jigging Spacer.SLDPRT
Electrical/Components/LV Battery/FE10 LV Battery/Cut-Extrude5.SLDPRT
Electrical/Components/LV Battery/FE10 LV Battery/Cut-Extrude6.SLDPRT
Electrical/Components/LV Battery/FE10 LV Battery/EL-00003-AA-Shorai LV Battery, 21Ah LFX216-BS12.SLDPRT
Electrical/Components/LV Battery/FE10 LV Battery/EL-00004-AA-Aegies 12V 30Ah Battery.SLDPRT
Electrical/Components/LV Battery/FE10 LV Battery/EL-00004-AA-Aegies-12 V 20 Ah Battery.SLDPRT
Electrical/Components/LV Battery/FE10 LV Battery/EL-300XX-AA-LV Battery Floor Panel.SLDPRT
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
