FormulaRacingatUCDavis/FE11_CAD/Powertrain/Accumulator/Components/Pulse Testing Results/FRUCD_12_2023_test/298K/FRUCD_12222023_7_Channel_7_298K.xlsx

Sheet: Global_Info
 |  |  | TEST REPORT
 |  |  | FRUCD_12222023 | Serial Number |  | C:\ArbinSoftware\DataPro\Result\FRUCD_12222023_7\FRUCD_12222023_7_Channel_7.1.xlsx
 |  |  | 2024-01-08 | 204983
Channel | Start DateTime | Schedule File Name | Creator | Comments | Software Version | Schedule Version | Item ID | Has Aux | Has Specail | Log Aux Data Flag | Log Special Flag
7 | 2023-12-23 23:06 | FRUCD_P42A_HPPC_298K.sdu |  |  | PV7.0 Build: 180301USB | Schedule Version 7.00.13 |  | 0 | 0 | TRUE | TRUE

Sheet: Channel_7_1
Date_Time | Test_Time(s) | Step_Time(s) | Step_Index | Cycle_Index | Voltage(V) | Current(A) | Charge_Capacity(Ah) | Discharge_Capacity(Ah) | Charge_Energy(Wh) | Discharge_Energy(Wh) | ACR(Ohm) | Internal Resistance(Ohm) | dV/dt(V/s)
2023-12-23 23:09 | 10.0004 | 10.0004 | 1 | 1 | 2.888497353 | 0 | 0 | 0 | 0 | 0 |  |  | 2.479553223e-05
2023-12-23 23:09 | 10.0007 | 10.0007 | 1 | 1 | 2.888497353 | 0 | 0 | 0 | 0 | 0 |  |  | 2.48077679e-05
2023-12-23 23:10 | 70.047 | 60.0014 | 2 | 1 | 3.247904778 | 4.000070572 | 0.06666604429 | 0 | 0.2098312676 | 0 |  |  | 0.002473831177
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
