FormulaRacingatUCDavis/FE11_CAD/Powertrain/Accumulator/Components/Pulse Testing Results/FRUCD_12_2023_test/303K/FRUCD_12222023_7_Channel_7_303K Test.xlsx

Sheet: Global_Info
 |  |  | TEST REPORT
 |  |  | FRUCD_12222023 | Serial Number |  | C:\ArbinSoftware\DataPro\Result\FRUCD_12222023_7\FRUCD_12222023_7_Channel_7.1.xlsx
 |  |  | 2024-01-08 | 204983
Channel | Start DateTime | Schedule File Name | Creator | Comments | Software Version | Schedule Version | Item ID | Has Aux | Has Specail | Log Aux Data Flag | Log Special Flag
7 | 2023-12-25 13:32 | FRUCD_P42A_HPPC_298K.sdu |  |  | PV7.0 Build: 180301USB | Schedule Version 7.00.13 |  | 0 | 0 | TRUE | TRUE

Sheet: Channel_7_1
Date_Time | Test_Time(s) | Step_Time(s) | Step_Index | Cycle_Index | Voltage(V) | Current(A) | Charge_Capacity(Ah) | Discharge_Capacity(Ah) | Charge_Energy(Wh) | Discharge_Energy(Wh) | ACR(Ohm) | Internal Resistance(Ohm) | dV/dt(V/s)
2023-12-25 13:35 | 10.0012 | 10.0013 | 1 | 1 | 2.972432137 | 0 | 0 | 0 | 0 | 0 |  |  | -1.525878906e-05
2023-12-25 13:35 | 10.0016 | 10.0017 | 1 | 1 | 2.972432137 | 0 | 0 | 0 | 0 | 0 |  |  | -1.524481239e-05
2023-12-25 13:36 | 70.0465 | 60.0009 | 2 | 1 | 3.272299767 | 4.000079155 | 0.06666223705 | 0 | 0.2124442756 | 0 |  |  | 0.002082824707
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
