FormulaRacingatUCDavis/FE11_CAD/Powertrain/Accumulator/Components/Pulse Testing Results/FRUCD_12_2023_test/313K/FRUCD_12222023_7_Channel_7_313K.xlsx

Sheet: Global_Info
 |  |  | TEST REPORT
 |  |  | FRUCD_12222023 | Serial Number |  | C:\ArbinSoftware\DataPro\Result\FRUCD_12222023_7\FRUCD_12222023_7_Channel_7.1.xlsx
 |  |  | 2024-01-08 | 204983
Channel | Start DateTime | Schedule File Name | Creator | Comments | Software Version | Schedule Version | Item ID | Has Aux | Has Specail | Log Aux Data Flag | Log Special Flag
7 | 2023-12-27 14:36 | FRUCD_P42A_HPPC_298K.sdu |  |  | PV7.0 Build: 180301USB | Schedule Version 7.00.13 |  | 0 | 0 | TRUE | TRUE

Sheet: Channel_7_1
Date_Time | Test_Time(s) | Step_Time(s) | Step_Index | Cycle_Index | Voltage(V) | Current(A) | Charge_Capacity(Ah) | Discharge_Capacity(Ah) | Charge_Energy(Wh) | Discharge_Energy(Wh) | ACR(Ohm) | Internal Resistance(Ohm) | dV/dt(V/s)
2023-12-27 14:39 | 10.0012 | 10.0012 | 1 | 1 | 2.906384468 | 0 | 0 | 0 | 0 | 0 |  |  | 1.525878906e-05
2023-12-27 14:39 | 10.0016 | 10.0016 | 1 | 1 | 2.906386375 | 0 | 0 | 0 | 0 | 0 |  |  | 1.527519311e-05
2023-12-27 14:40 | 70.0446 | 60.0007 | 2 | 1 | 3.21460247 | 4.000008583 | 0.06666422635 | 0 | 0.207958281 | 0 |  |  | 0.002477645874
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
