FormulaRacingatUCDavis/FE11_CAD/Unsprung/Controls/Pedal Box/BR-A1001-AD-Pedal Box Assembly.pdf

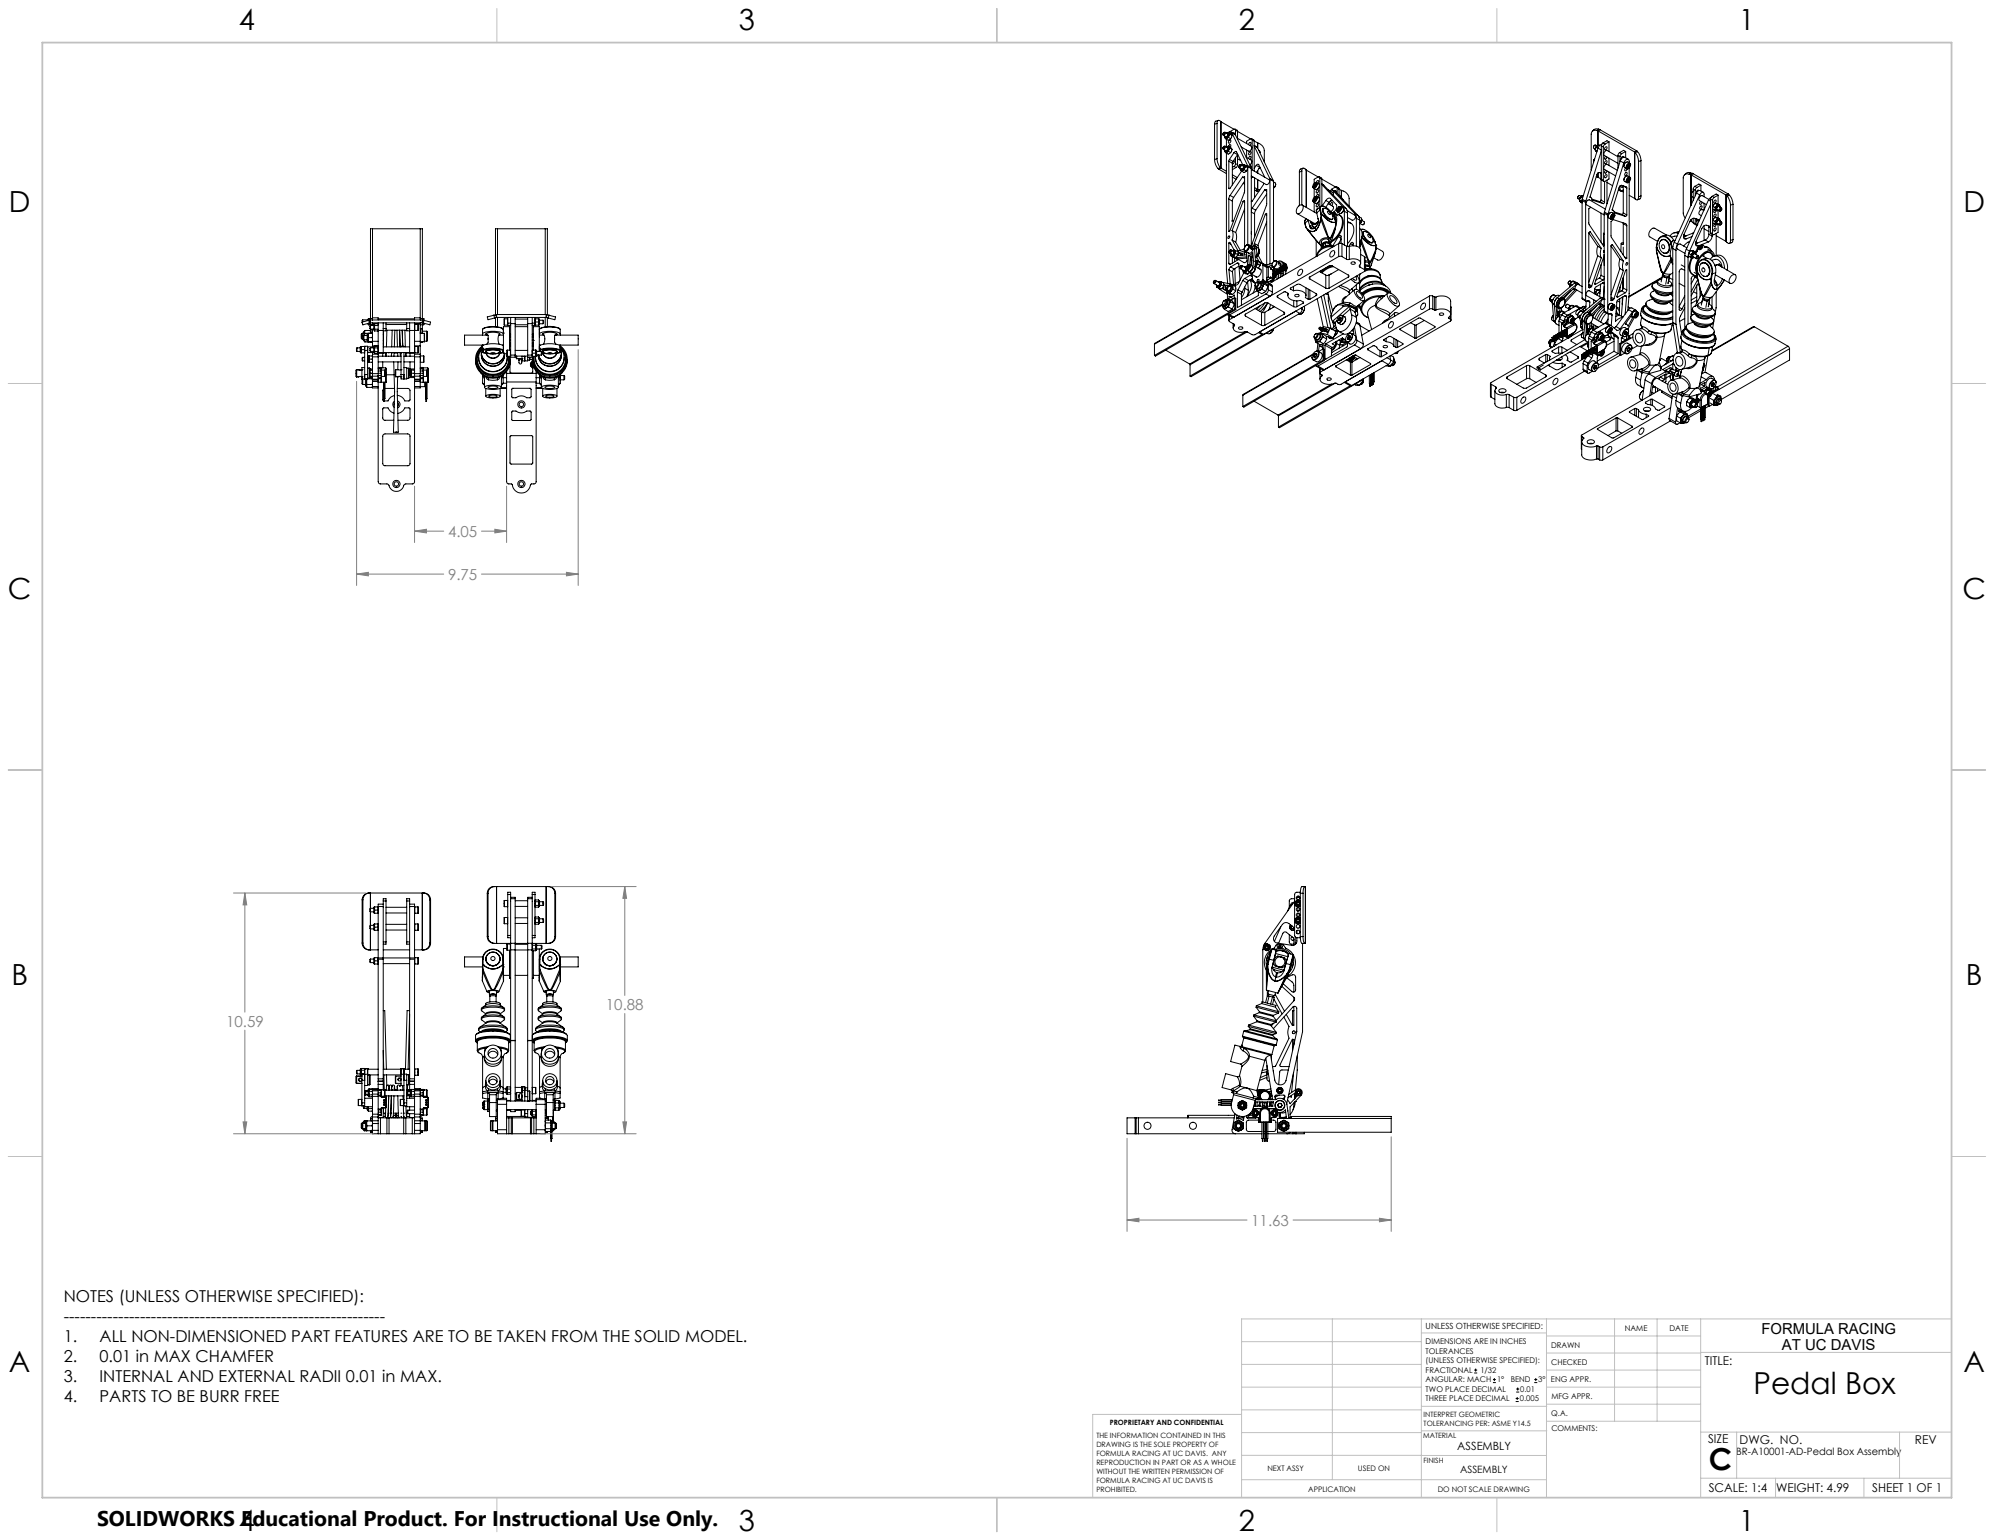
[picture p138: page 1]

NOTES (UNLESS OTHERWISE SPECIFIED):
1. ALL NON-DIMENSIONED PART FEATURES ARE TO BE TAKEN FROM THE SOLID MODEL.
2. 0.01 in MAX CHAMFER
3. INTERNAL AND EXTERNAL RADII 0.01 in MAX.
4. PARTS TO BE BURR FREE

UNLESS OTHERWISE SPECIFIED: | | NAME | DATE | FORMULA RACING AT UC DAVIS
DIMENSIONS ARE IN INCHES TOLERANCES (UNLESS OTHERWISE SPECIFIED): FRACTIONAL 1/32 ANGULAR: MACH 1° BEND 3° TWO PLACE DECIMAL 0.01 THREE PLACE DECIMAL 0.005 | DRAWN

CHECKED | | | TITLE: Pedal Box

ENG APPR.
MFG APPR.

INTERPRET GEOMETRIC TOLERANCING PER: ASME Y14.5 | Q.A.
MATERIAL ASSEMBLY | | SIZE C | DWG. NO. BR-A10001-AD-Pedal Box Assembly | REV

PROPRIETARY AND CONFIDENTIAL
THE INFORMATION CONTAINED IN THIS
DRAWING IS THE SOLE PROPERTY OF
FORMULA RACING AT UC DAVIS. ANY
REPRODUCTION IN PART OR AS A WHOLE
WITHOUT THE WRITTEN PERMISSION OF
FORMULA RACING AT UC DAVIS IS
PROHIBITED.

NEXT ASSY | USED ON | FINISH ASSEMBLY

APPLICATION | DO NOT SCALE DRAWING | | SCALE: 1:4 | WEIGHT: 4.99 | SHEET 1 OF 1

SOLIDWORKS Educational Product. For Instructional Use Only.
