FormulaRacingatUCDavis/FE11_CAD/Unsprung/Wheel Package/Rear Left (Copied over from FE10, needs changes)/RL_Brake Assembly/WT-RR####-XB-Tripod Nut.pdf

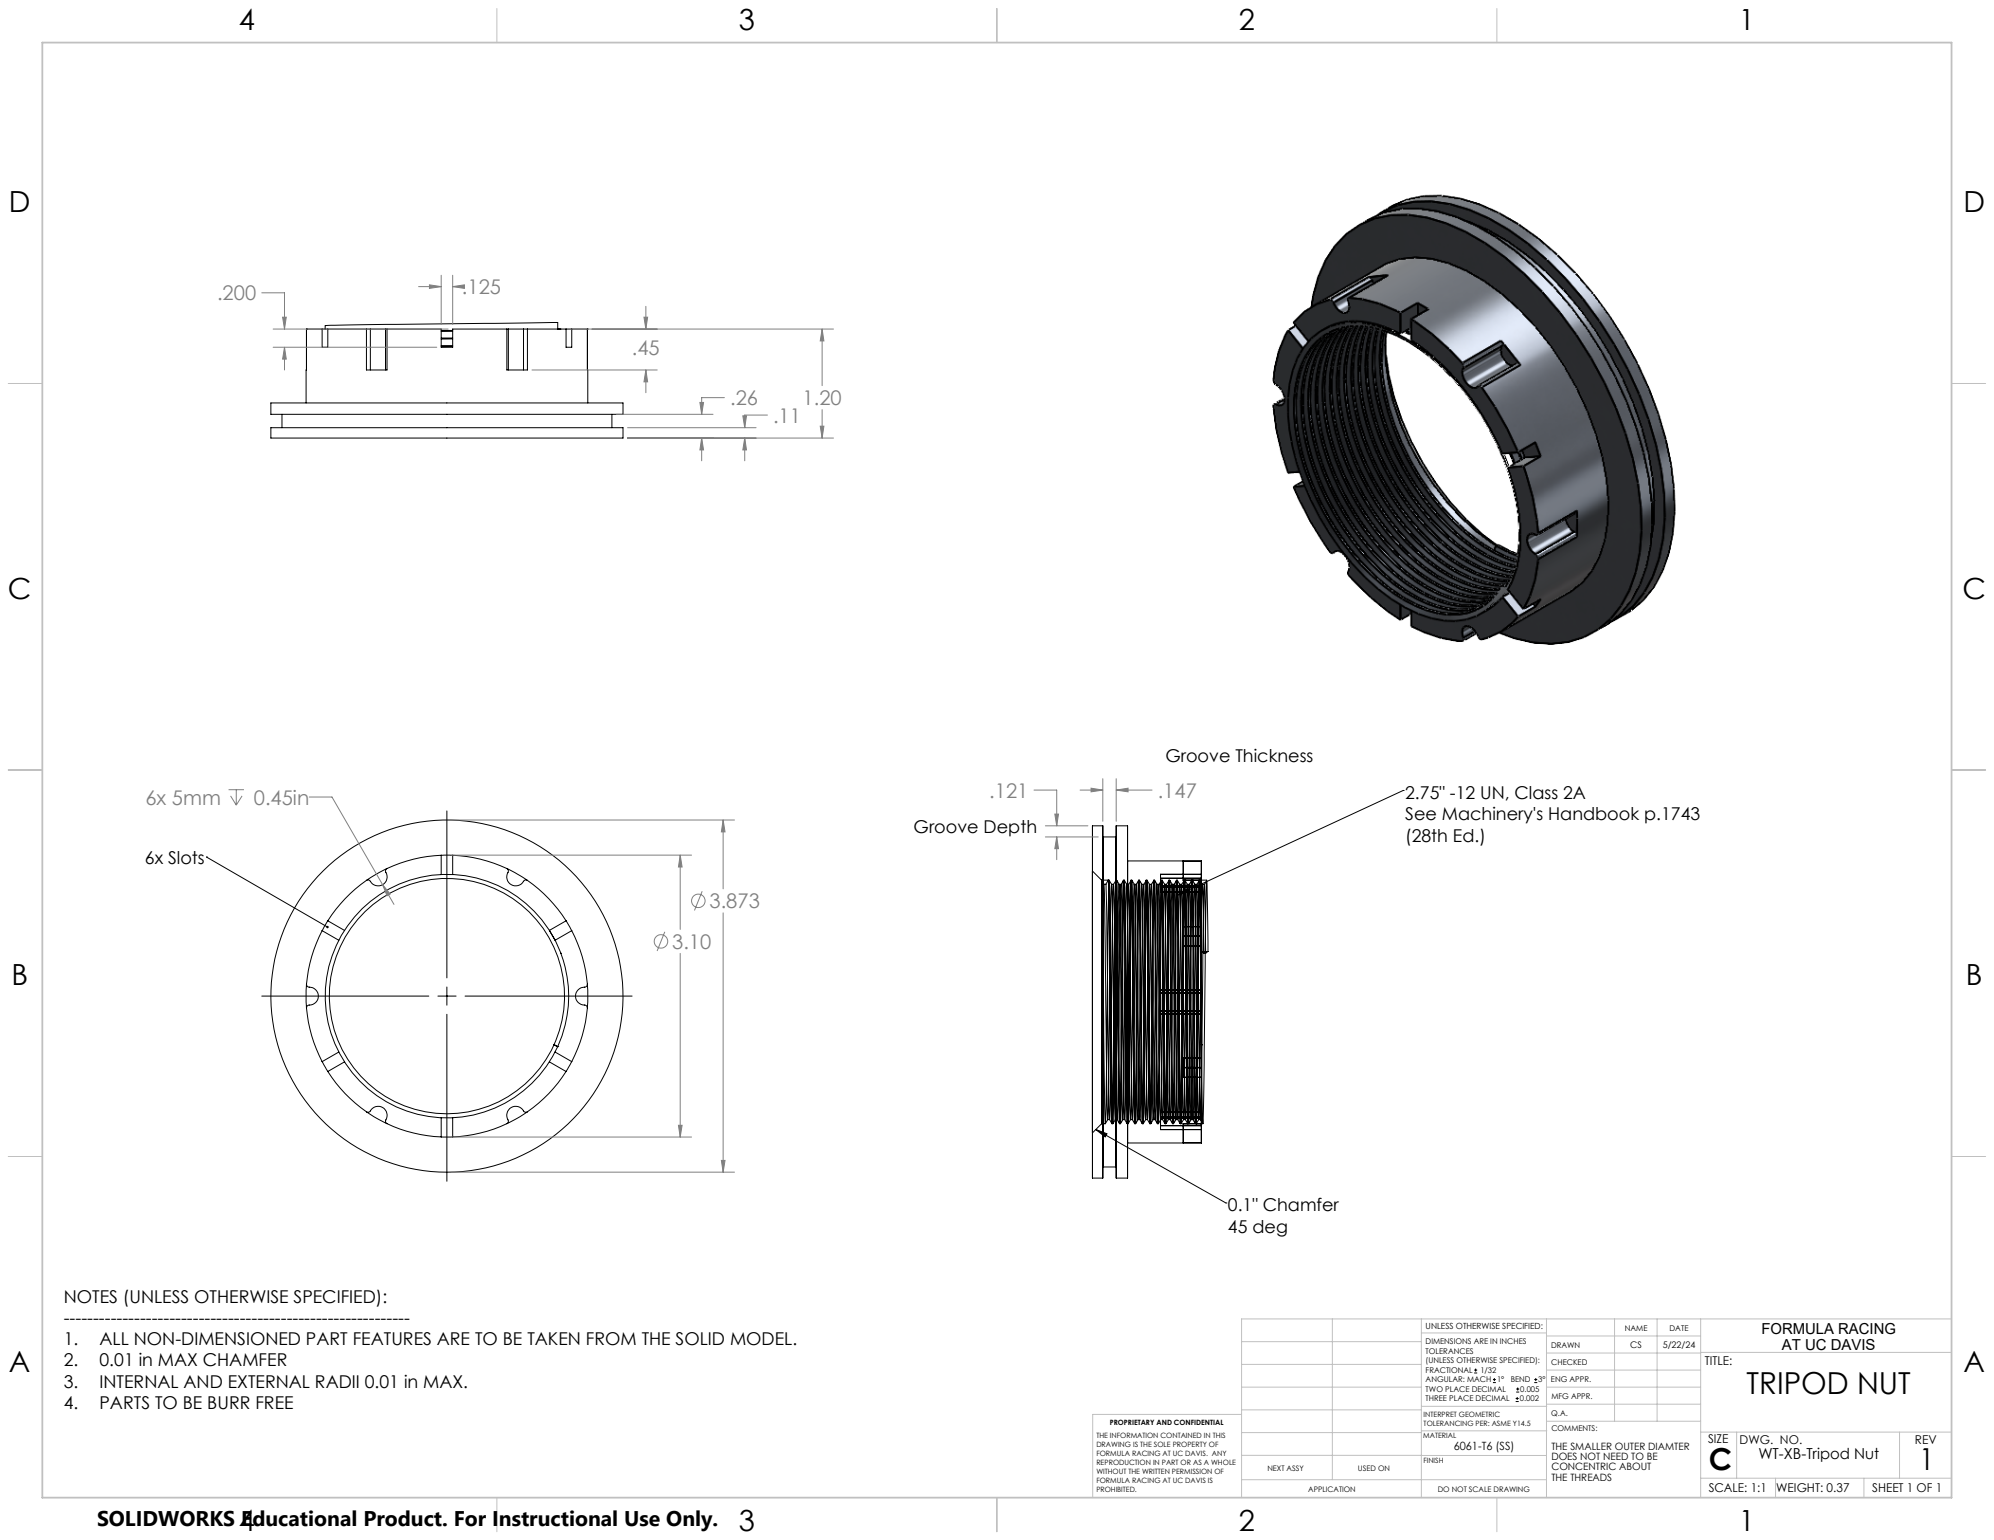
[picture p139: page 1]
2.75" -12 UN, Class 2A; 0.1" Chamfer 45 deg; 6x Slots; Groove Depth; Groove Thickness

See Machinery's Handbook p.1743

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

UNLESS OTHERWISE SPECIFIED: | | NAME | DATE | FORMULA RACING AT UC DAVIS
DIMENSIONS ARE IN INCHES TOLERANCES (UNLESS OTHERWISE SPECIFIED): FRACTIONAL 1/32 ANGULAR: MACH 1° BEND 3° TWO PLACE DECIMAL 0.005 THREE PLACE DECIMAL 0.002 | DRAWN | CS | 5/22/24

CHECKED | | | TITLE: TRIPOD NUT

ENG APPR.
MFG APPR.

INTERPRET GEOMETRIC TOLERANCING PER: ASME Y14.5 | Q.A.
MATERIAL 6061-T6 (SS) | | SIZE C | DWG. NO. WT-XB-Tripod Nut | REV 1

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

COMMENTS:
THE SMALLER OUTER DIAMTER
DOES NOT NEED TO BE
CONCENTRIC ABOUT
THE THREADS

NEXT ASSY | USED ON | FINISH

APPLICATION | DO NOT SCALE DRAWING | | SCALE: 1:1 | WEIGHT: 0.37 | SHEET 1 OF 1

SOLIDWORKS Educational Product. For Instructional Use Only.
