FormulaRacingatUCDavis/FE11_CAD/Unsprung/Suspension/Drawings/Suspension Assembly Drawings/SP-A0100-AA-Front A-Arm Assembly.pdf

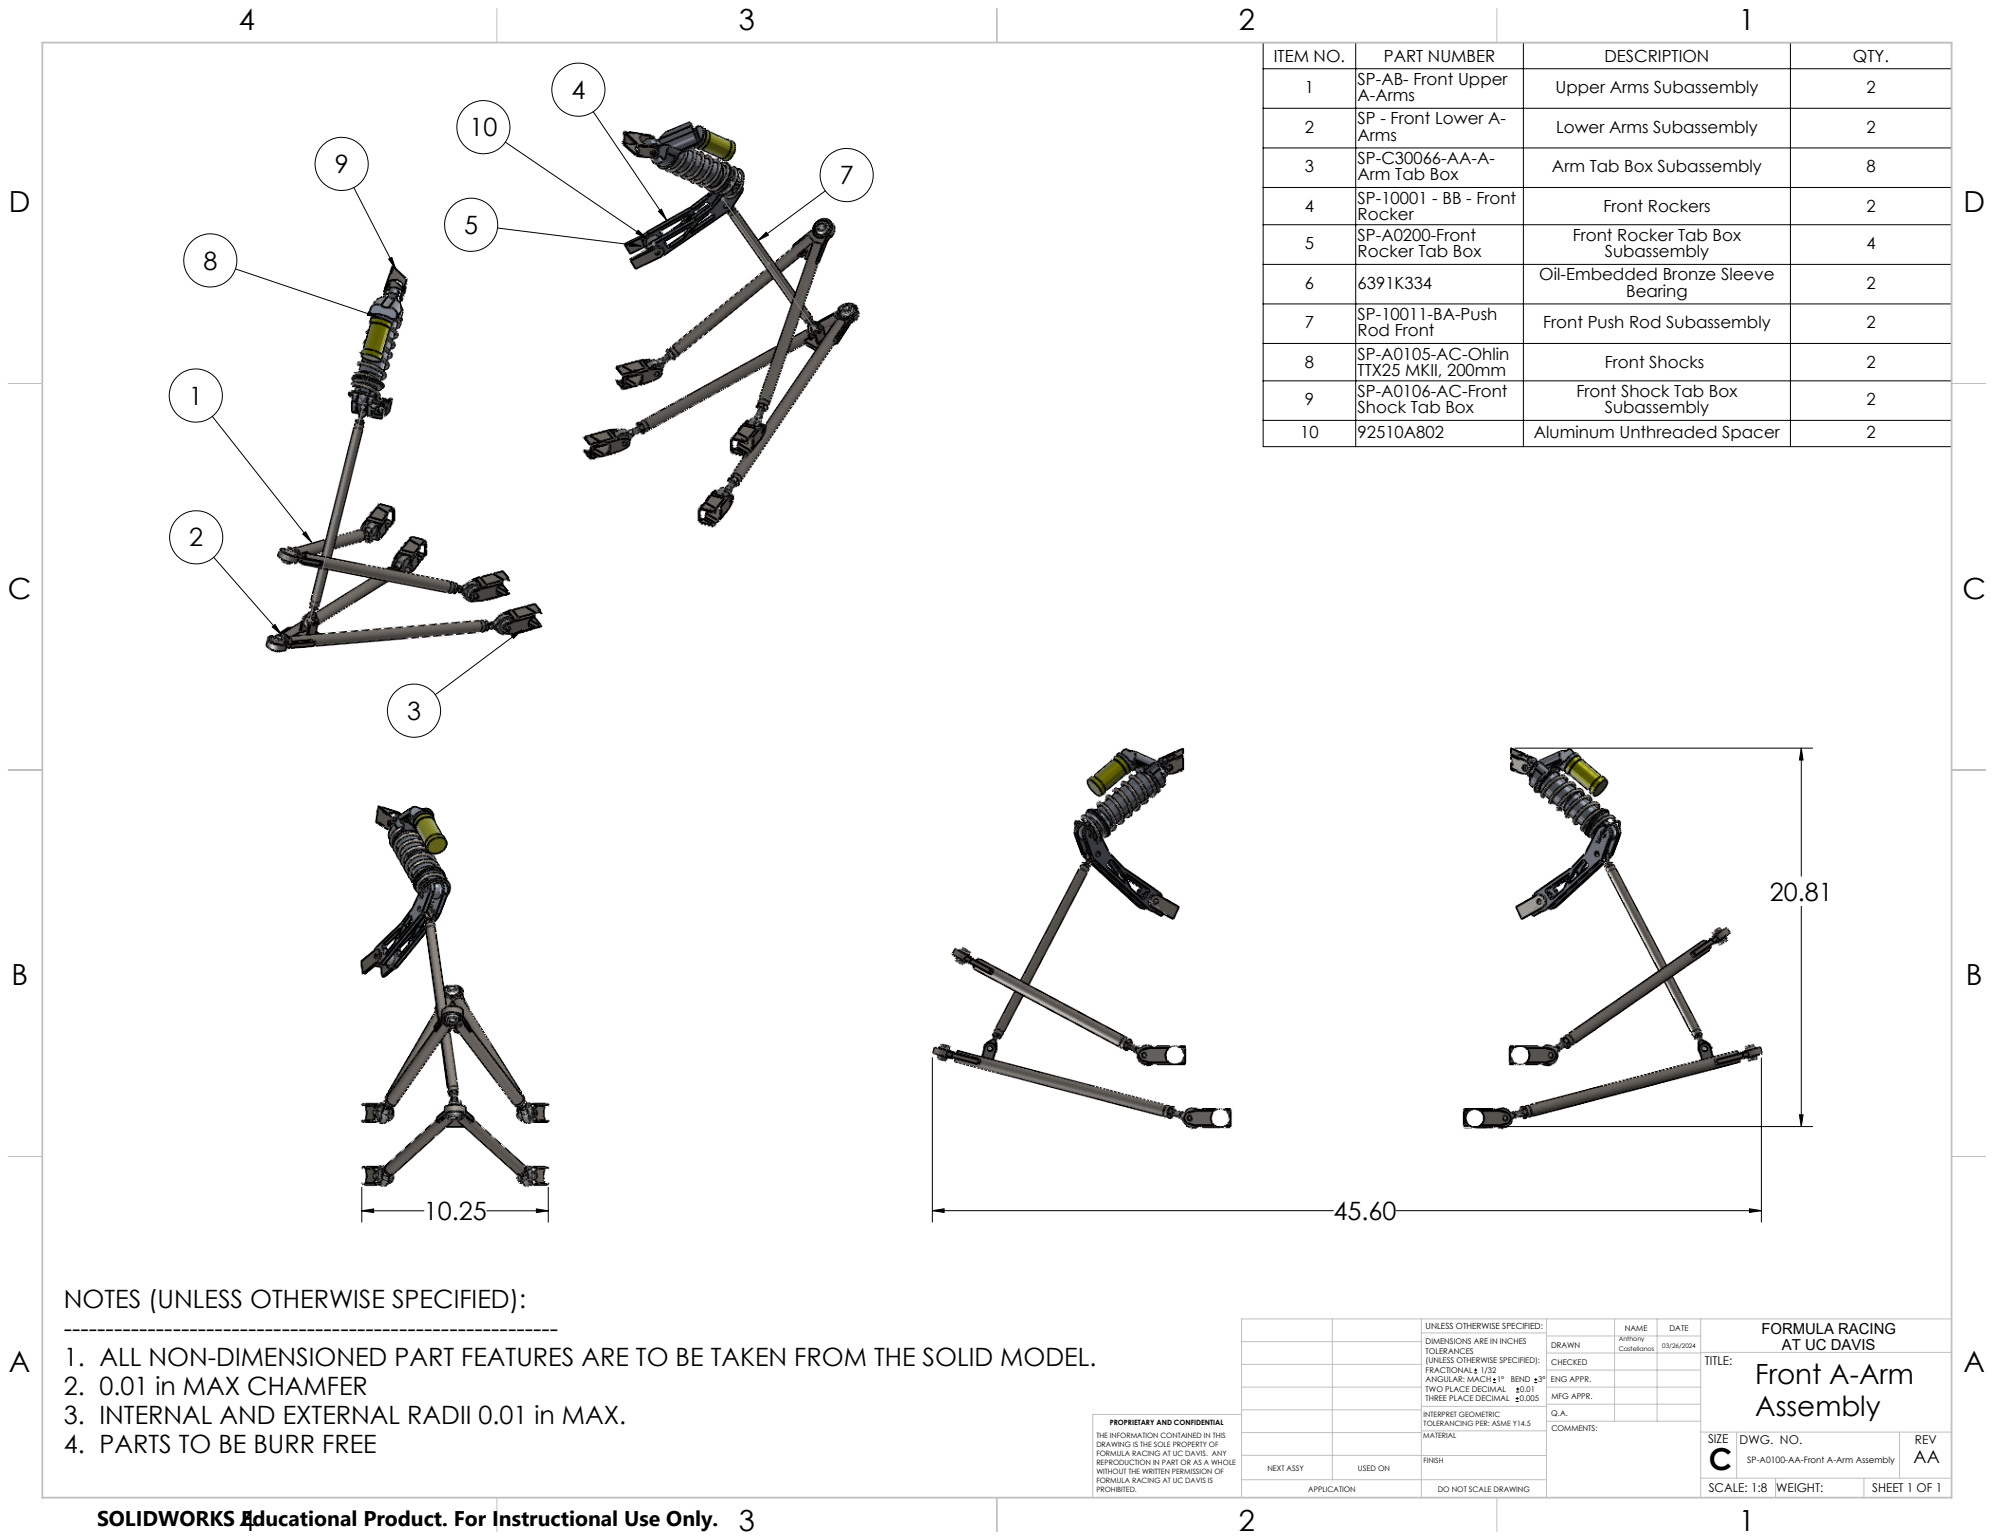
[picture p140: page 1]

ITEM NO. | PART NUMBER | DESCRIPTION | QTY.
1 | SP-AB- Front Upper A-Arms | Upper Arms Subassembly | 2
2 | SP - Front Lower A-Arms | Lower Arms Subassembly | 2
3 | SP-C30066-AA-A-Arm Tab Box | Arm Tab Box Subassembly | 8
4 | SP-10001 - BB - Front Rocker | Front Rockers | 2
5 | SP-A0200-Front Rocker Tab Box | Front Rocker Tab Box Subassembly | 4
6 | 6391K334 | Oil-Embedded Bronze Sleeve Bearing | 2
7 | SP-10011-BA-Push Rod Front | Front Push Rod Subassembly | 2
8 | SP-A0105-AC-Ohlin TTX25 MKII, 200mm | Front Shocks | 2
9 | SP-A0106-AC-Front Shock Tab Box | Front Shock Tab Box Subassembly | 2
10 | 92510A802 | Aluminum Unthreaded Spacer | 2

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

UNLESS OTHERWISE SPECIFIED: | | NAME | DATE | FORMULA RACING AT UC DAVIS
DIMENSIONS ARE IN INCHES TOLERANCES (UNLESS OTHERWISE SPECIFIED): FRACTIONAL 1/32 ANGULAR: MACH 1° BEND 3° TWO PLACE DECIMAL 0.01 THREE PLACE DECIMAL 0.005 | DRAWN | Anthony Castellanos | 03/26/2024

CHECKED | | | TITLE: Front A-Arm Assembly

ENG APPR.
MFG APPR.

INTERPRET GEOMETRIC TOLERANCING PER: ASME Y14.5 | Q.A.

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

MATERIAL | | SIZE C | DWG. NO. SP-A0100-AA-Front A-Arm Assembly | REV AA

NEXT ASSY | USED ON | FINISH

APPLICATION | DO NOT SCALE DRAWING | | SCALE: 1:8 | WEIGHT: | SHEET 1 OF 1

SOLIDWORKS Educational Product. For Instructional Use Only.
