FormulaRacingatUCDavis/FE11_CAD/Unsprung/Suspension/Drawings/Suspension Assembly Drawings/SP-A0100-AA-Rear A-Arm Assembly.pdf

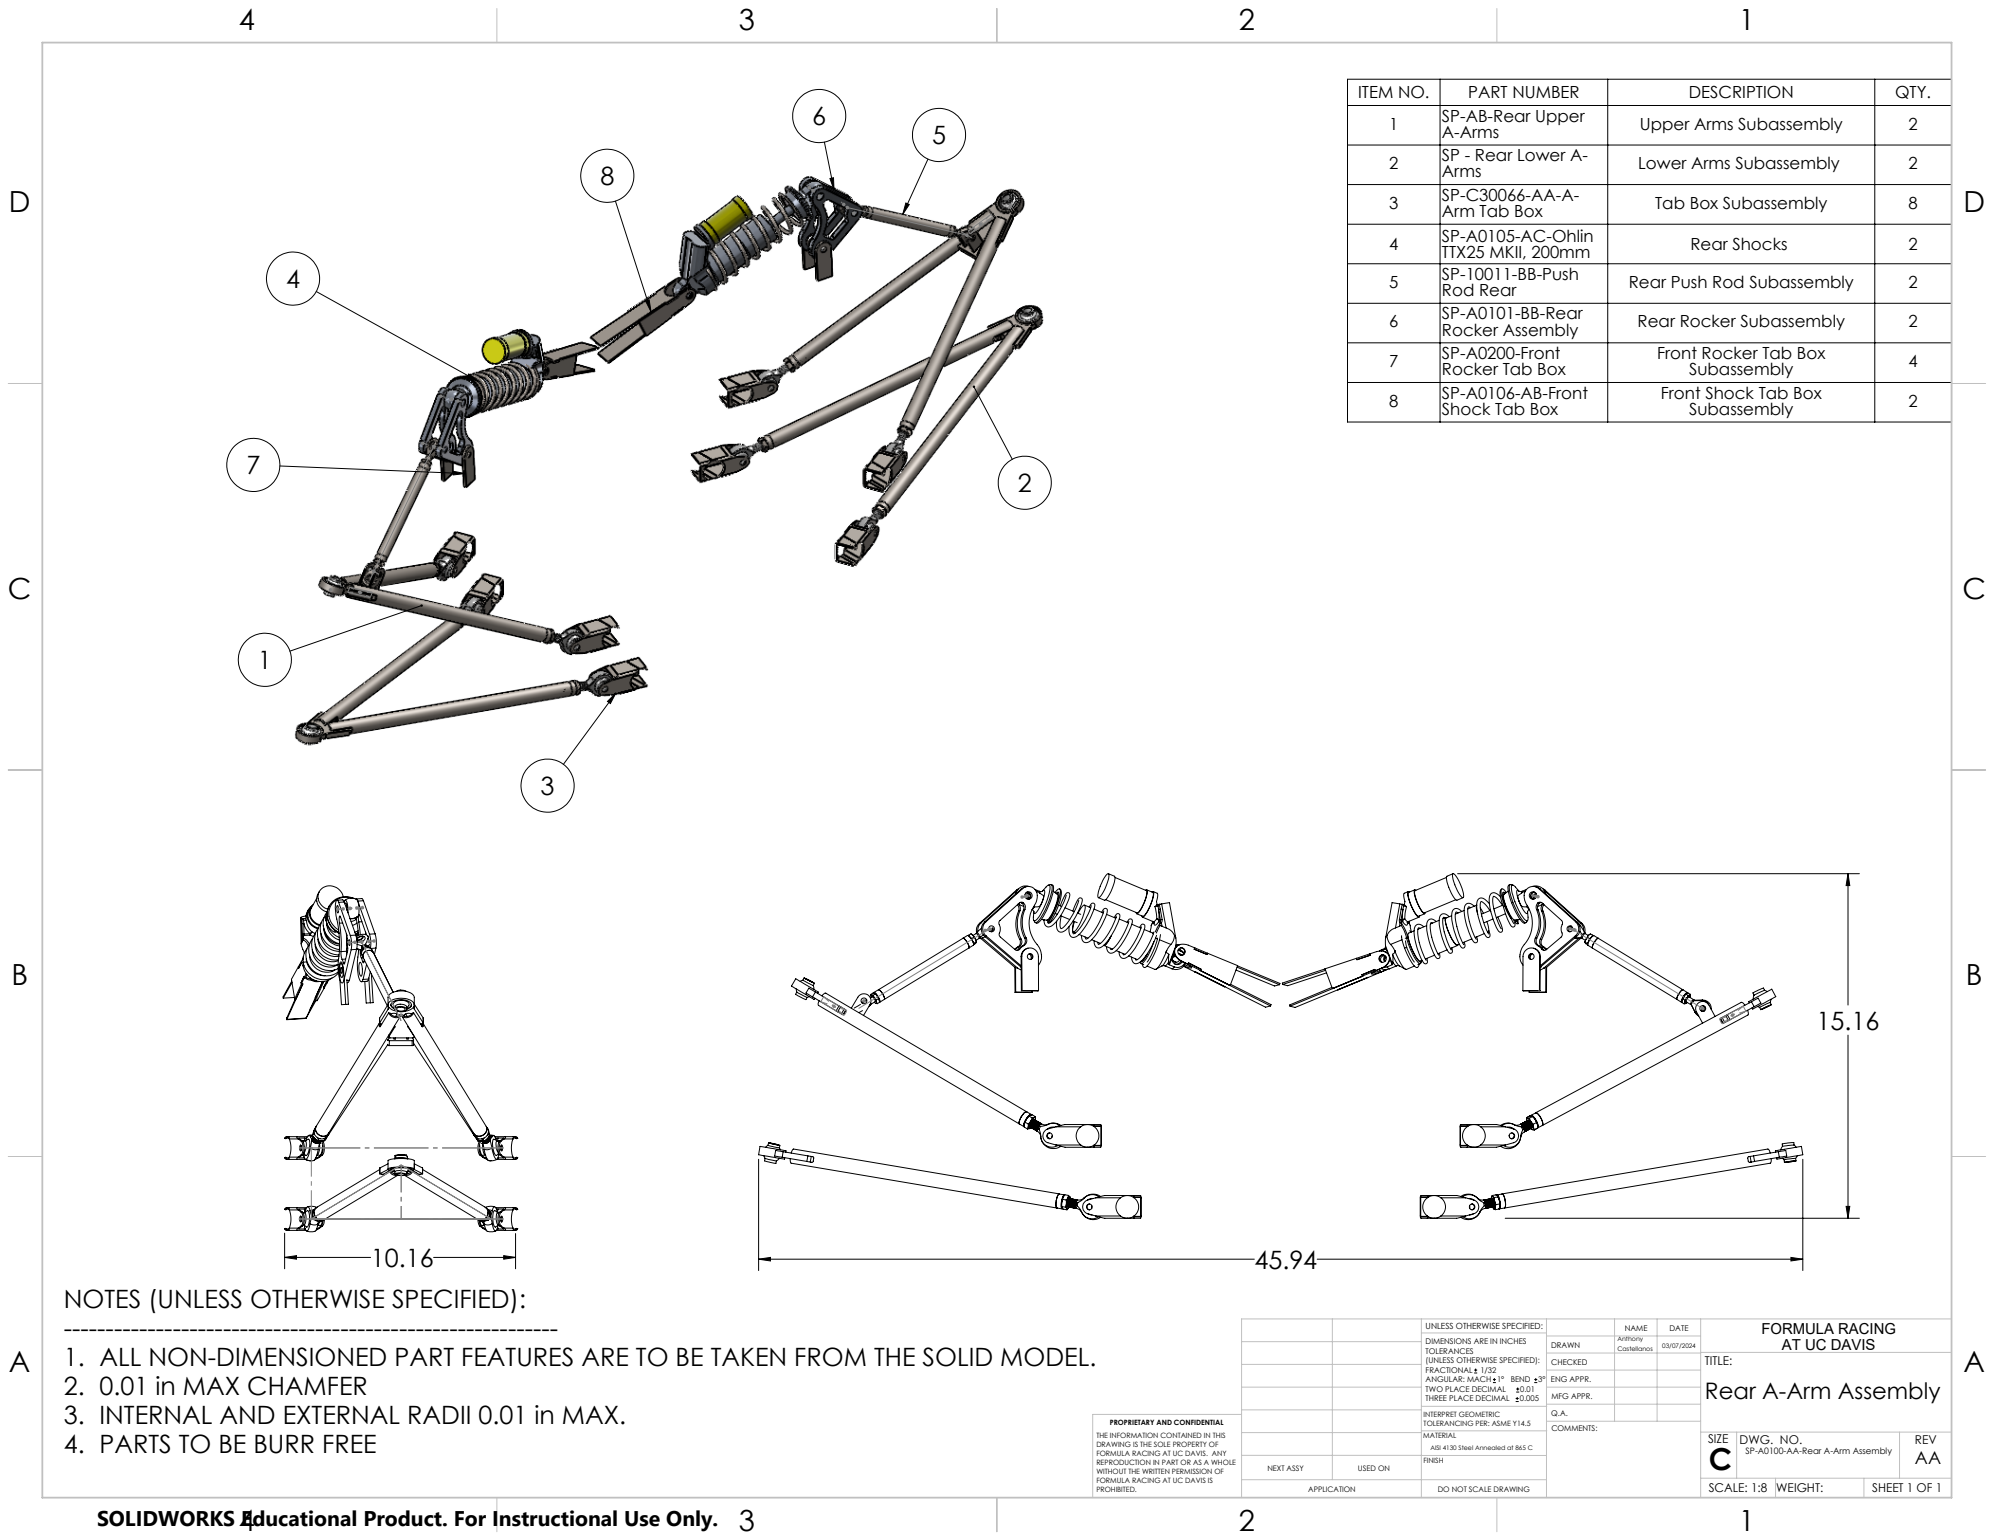
[picture p141: page 1]

ITEM NO. | PART NUMBER | DESCRIPTION | QTY.
1 | SP-AB-Rear Upper A-Arms | Upper Arms Subassembly | 2
2 | SP - Rear Lower A-Arms | Lower Arms Subassembly | 2
3 | SP-C30066-AA-A-Arm Tab Box | Tab Box Subassembly | 8
4 | SP-A0105-AC-Ohlin TTX25 MKII, 200mm | Rear Shocks | 2
5 | SP-10011-BB-Push Rod Rear | Rear Push Rod Subassembly | 2
6 | SP-A0101-BB-Rear Rocker Assembly | Rear Rocker Subassembly | 2
7 | SP-A0200-Front Rocker Tab Box | Front Rocker Tab Box Subassembly | 4
8 | SP-A0106-AB-Front Shock Tab Box | Front Shock Tab Box Subassembly | 2

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

UNLESS OTHERWISE SPECIFIED: | | NAME | DATE | FORMULA RACING AT UC DAVIS
DIMENSIONS ARE IN INCHES TOLERANCES (UNLESS OTHERWISE SPECIFIED): FRACTIONAL 1/32 ANGULAR: MACH 1° BEND 3° TWO PLACE DECIMAL 0.01 THREE PLACE DECIMAL 0.005 | DRAWN | Castellanos | 03/07/2024 Anthony

CHECKED | | | TITLE: Rear A-Arm Assembly

ENG APPR.
MFG APPR.

INTERPRET GEOMETRIC TOLERANCING PER: ASME Y14.5 | Q.A.

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

MATERIAL AISI 4130 Steel Annealed at 865 C | | SIZE C | DWG. NO. SP-A0100-AA-Rear A-Arm Assembly | REV AA

NEXT ASSY | USED ON | FINISH

APPLICATION | DO NOT SCALE DRAWING | | SCALE: 1:8 | WEIGHT: | SHEET 1 OF 1

SOLIDWORKS Educational Product. For Instructional Use Only.
