FormulaRacingatUCDavis/FE11_CAD/Powertrain/Drivetrain/Components/Motor Assembly/EN-00021-AC- Motor Shaft, Involute Splines.pdf

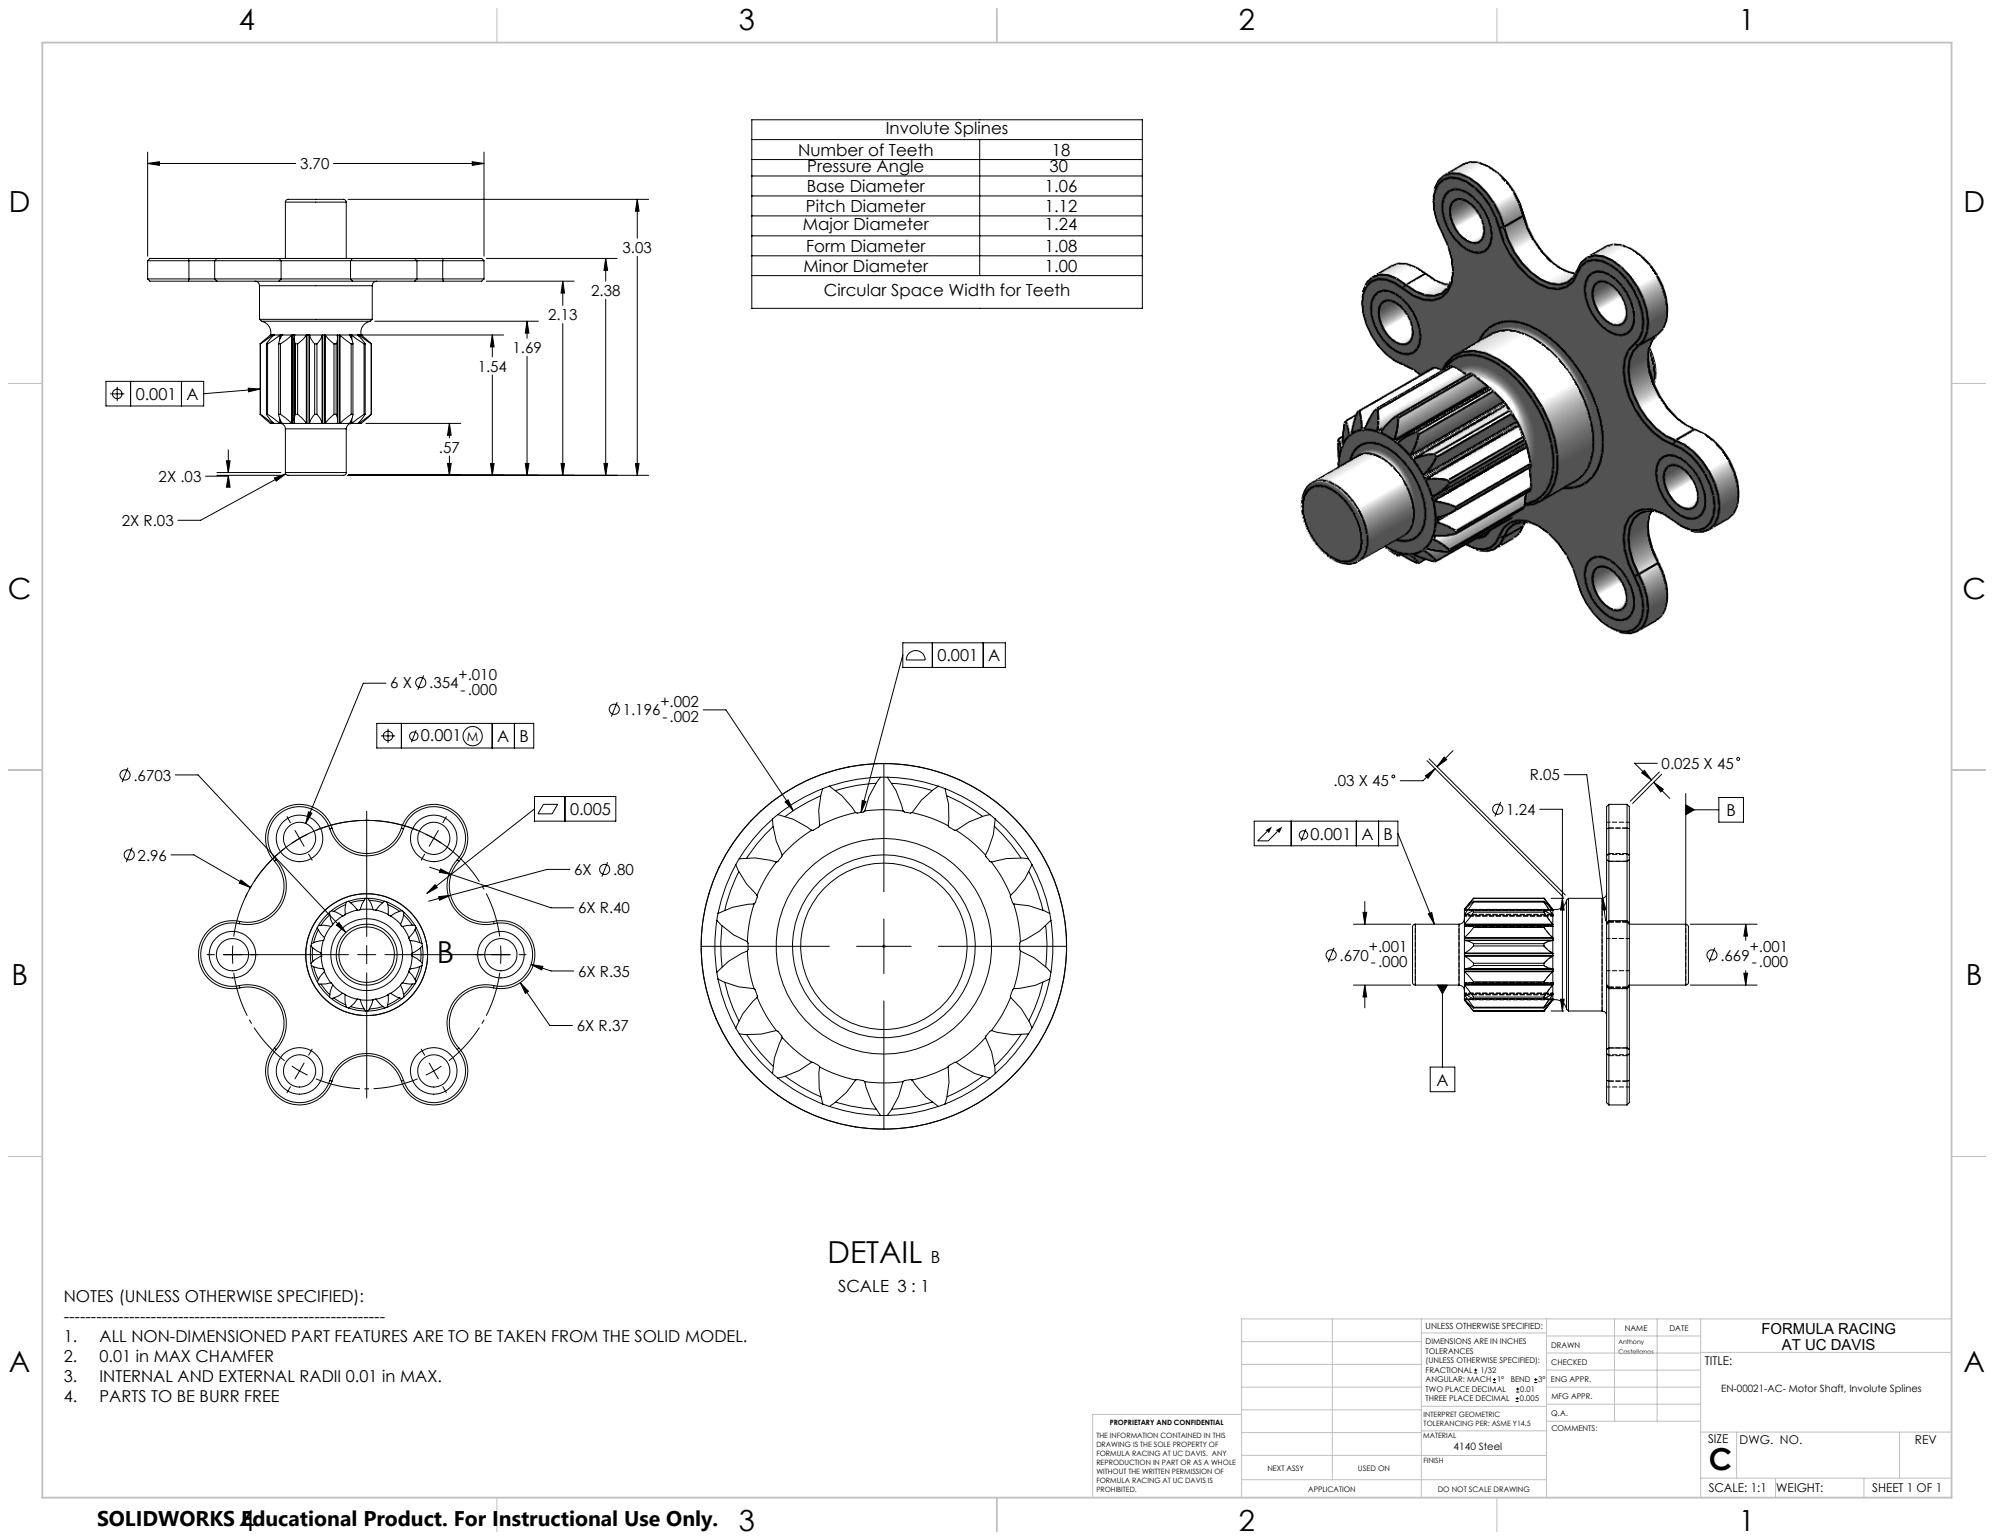
[picture p142: page 1]
DETAIL B; SCALE 3 : 1; Involute Splines

Number of Teeth | 18
Pressure Angle | 30
Base Diameter | 1.06
Pitch Diameter | 1.12
Major Diameter | 1.24
Form Diameter | 1.08
Minor Diameter | 1.00

Circular Space Width for Teeth

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

CHECKED | | | TITLE: EN-00021-AC- Motor Shaft, Involute Splines

ENG APPR.
MFG APPR.

INTERPRET GEOMETRIC TOLERANCING PER: ASME Y14.5 | Q.A.
MATERIAL 4140 Steel | | SIZE C | DWG. NO. | REV

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

NEXT ASSY | USED ON | FINISH

APPLICATION | DO NOT SCALE DRAWING | | SCALE: 1:1 | WEIGHT: | SHEET 1 OF 1

SOLIDWORKS Educational Product. For Instructional Use Only.
