FormulaRacingatUCDavis/FE11_CAD/Unsprung/Suspension/Drawings/Components Drawings/A-Arm Tube Drawings/SP-RR Lower A-Arm Tube.pdf

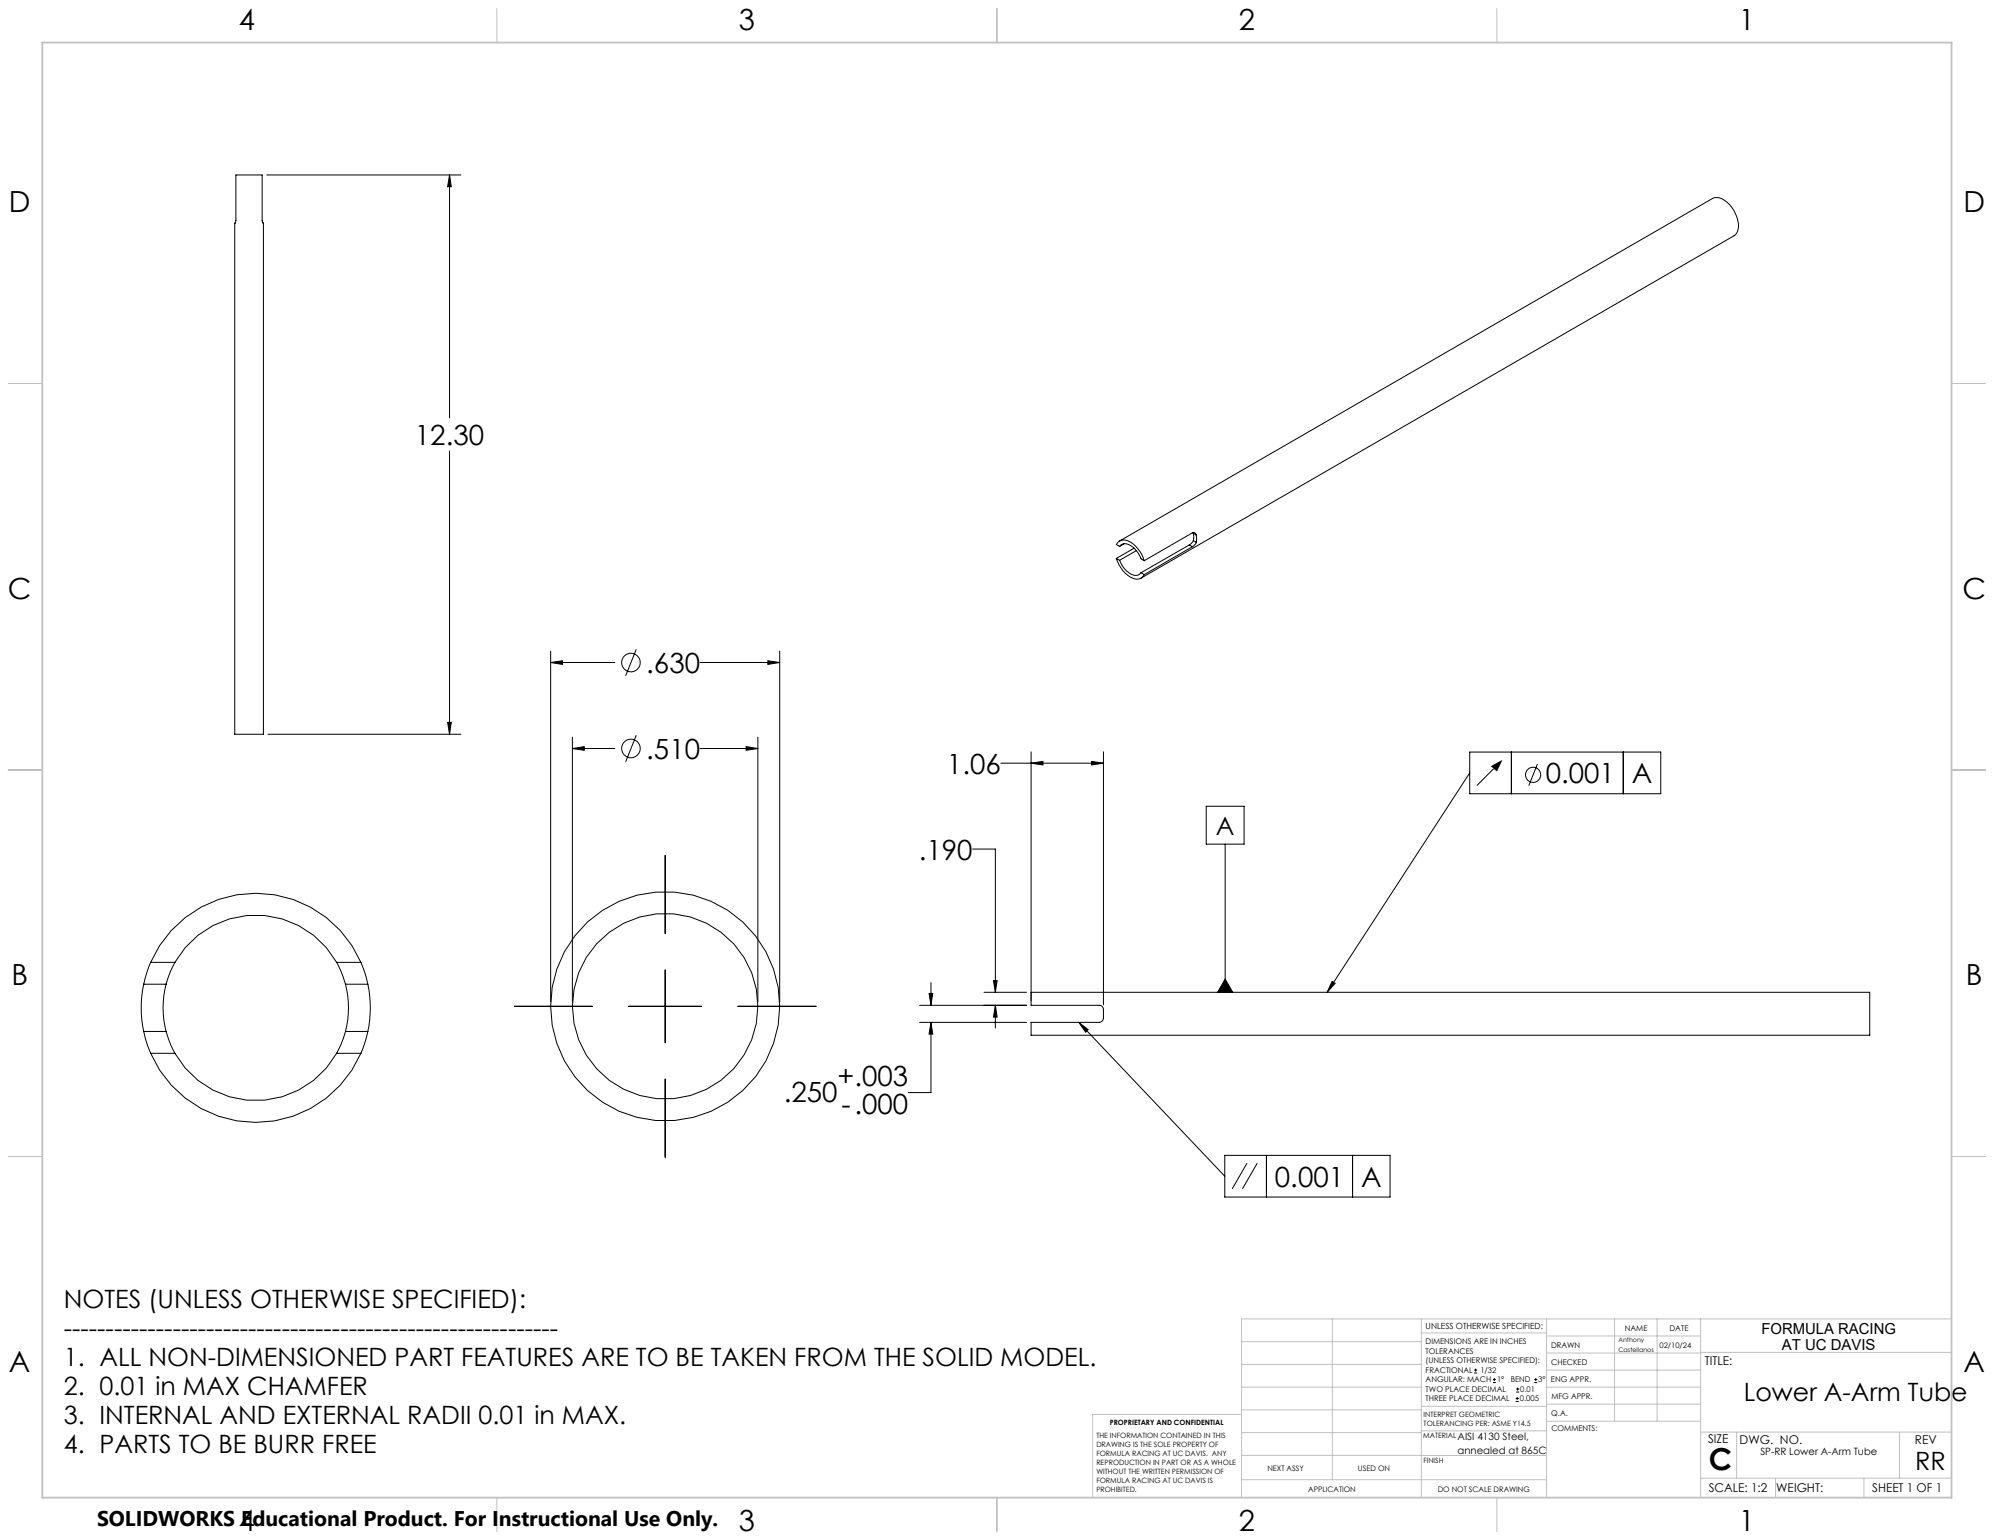
[picture p143: page 1]
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

UNLESS OTHERWISE SPECIFIED: | | NAME | DATE | FORMULA RACING AT UC DAVIS
DIMENSIONS ARE IN INCHES TOLERANCES (UNLESS OTHERWISE SPECIFIED): FRACTIONAL 1/32 ANGULAR: MACH 1° BEND 3° TWO PLACE DECIMAL 0.01 THREE PLACE DECIMAL 0.005 | DRAWN | Anthony Castellanos | 02/10/24

CHECKED | | | TITLE:

ENG APPR.
MFG APPR.

Lower A-Arm Tube

INTERPRET GEOMETRIC TOLERANCING PER: ASME Y14.5 | Q.A.
MATERIAL AISI 4130 Steel, annealed at 865C | | SIZE C | DWG. NO. SP-RR Lower A-Arm Tube | REV RR

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

NEXT ASSY | USED ON | FINISH

APPLICATION | DO NOT SCALE DRAWING | | SCALE: 1:2 | WEIGHT: | SHEET 1 OF 1

SOLIDWORKS Educational Product. For Instructional Use Only.
