FormulaRacingatUCDavis/FE11_CAD/Unsprung/Suspension/Drawings/A-Arm Tab Box Drawings/SP-C30066-AA-A-Arm Tab Box.pdf

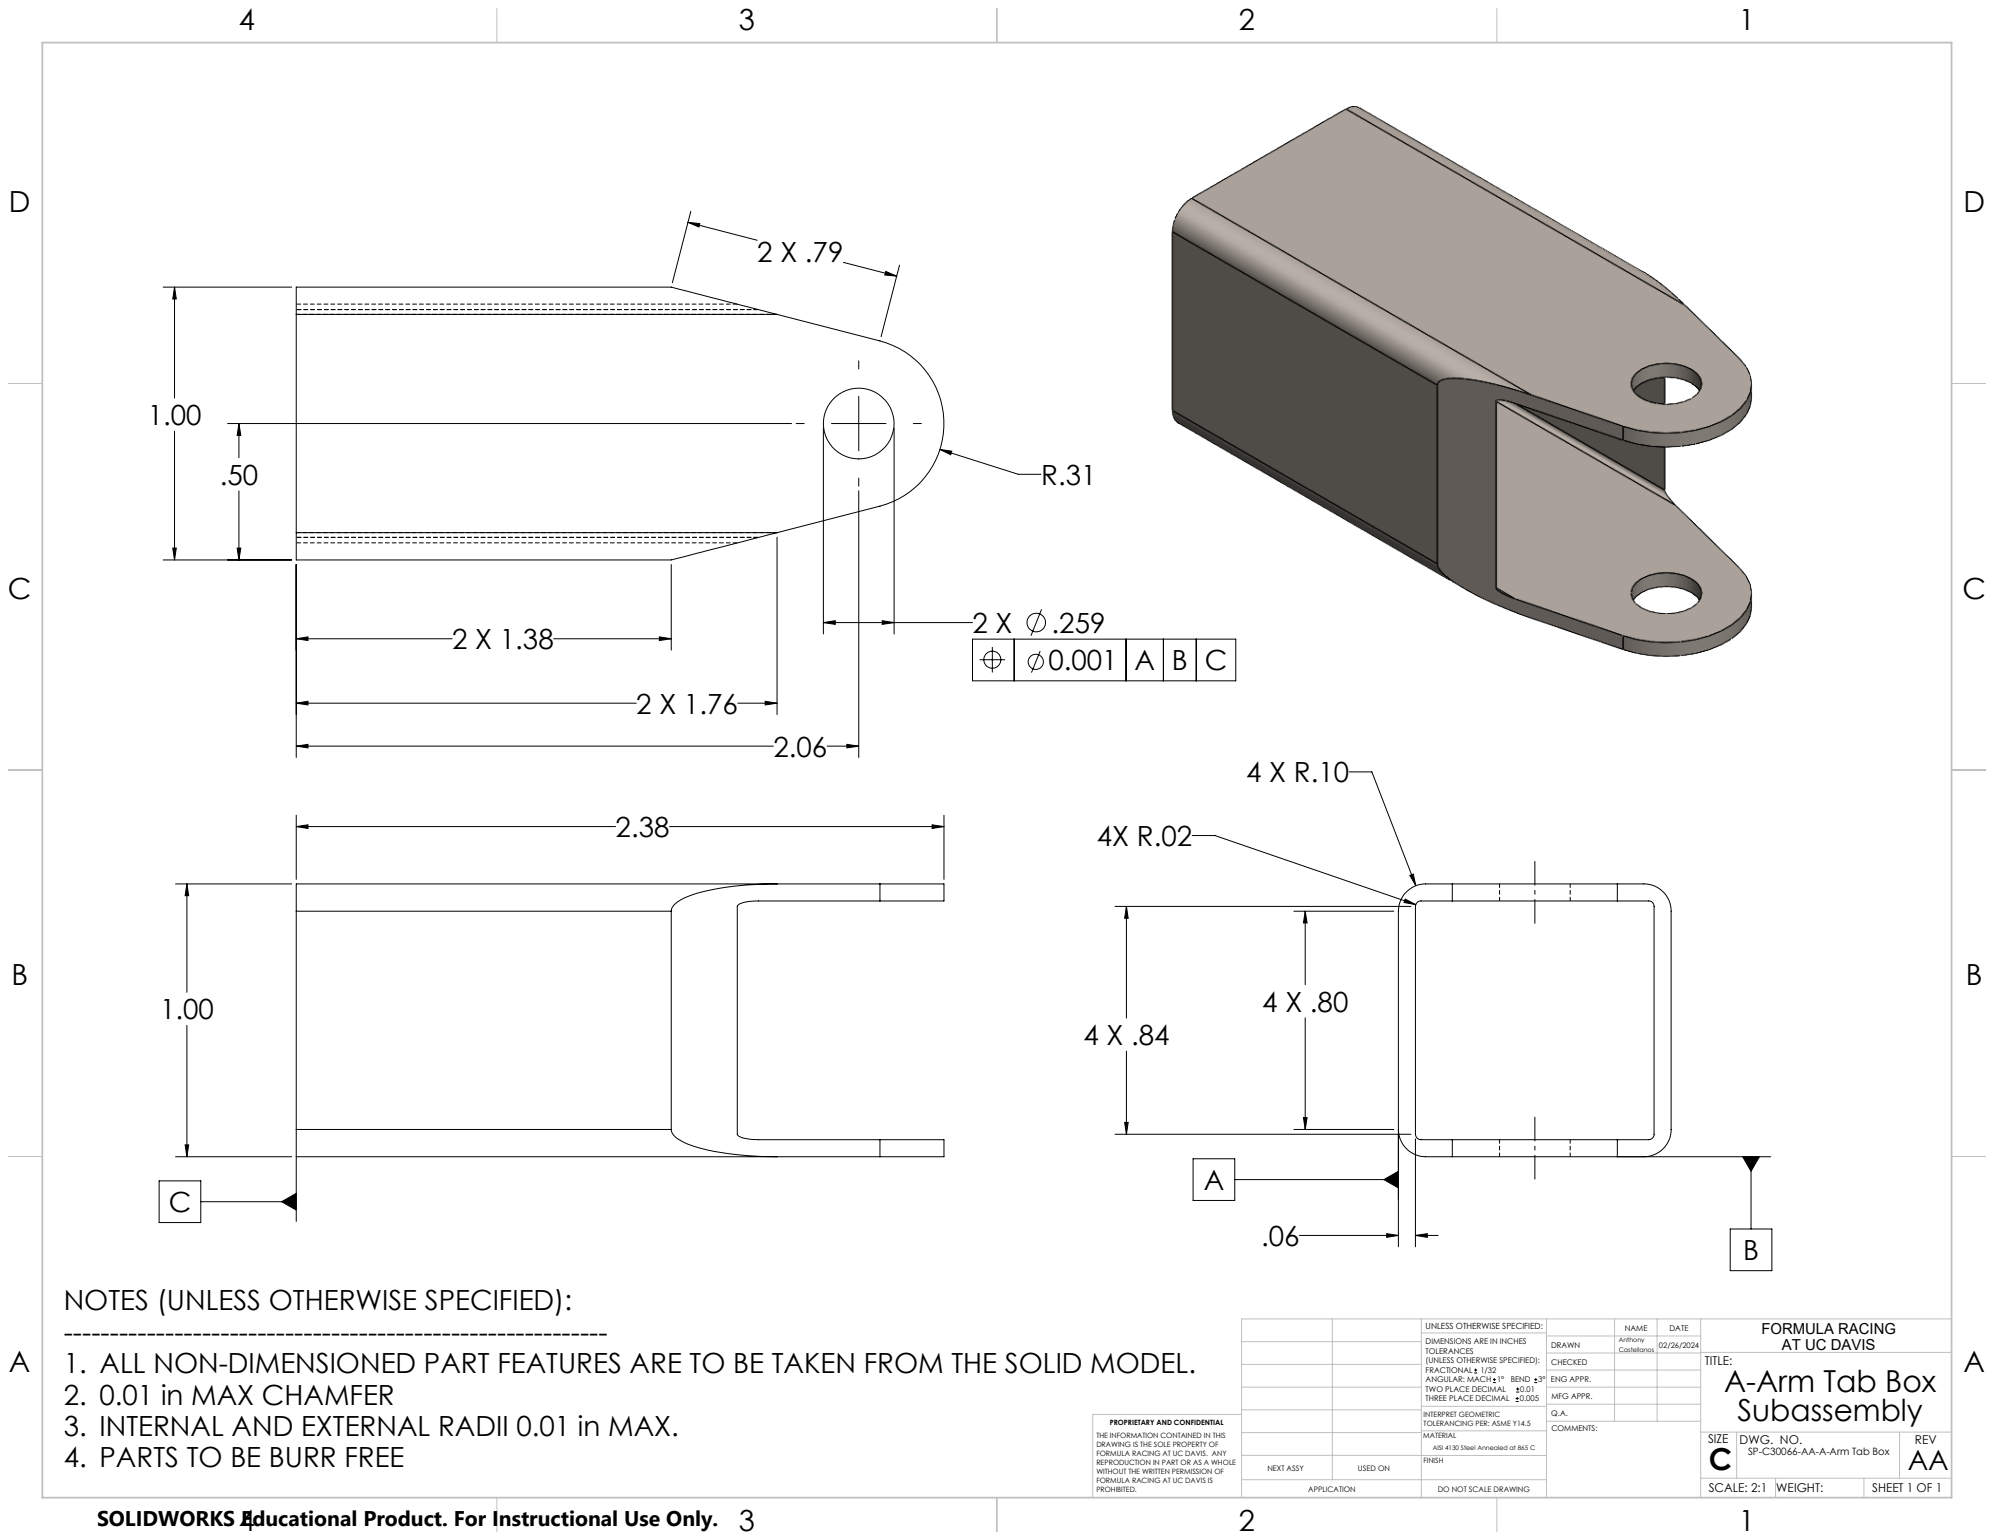
[picture p145: page 1]
4. PARTS TO BE BURR FREE; AISI 4130 Steel Annealed at 865 C

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

UNLESS OTHERWISE SPECIFIED: | | NAME | DATE | FORMULA RACING AT UC DAVIS
DIMENSIONS ARE IN INCHES TOLERANCES (UNLESS OTHERWISE SPECIFIED): FRACTIONAL 1/32 ANGULAR: MACH 1° BEND 3° TWO PLACE DECIMAL 0.01 THREE PLACE DECIMAL 0.005 | DRAWN | Anthony Castellanos | 02/26/2024

CHECKED | | | TITLE: A-Arm Tab Box Subassembly

ENG APPR.
MFG APPR.

INTERPRET GEOMETRIC TOLERANCING PER: ASME Y14.5 | Q.A.
MATERIAL | | SIZE C | DWG. NO. SP-C30066-AA-A-Arm Tab Box | REV AA

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

SOLIDWORKS Educational Product. For Instructional Use Only.

NEXT ASSY | USED ON | FINISH

APPLICATION | DO NOT SCALE DRAWING | | SCALE: 2:1 | WEIGHT: | SHEET 1 OF 1
