FormulaRacingatUCDavis/FE11_CAD/(commit log)

2023-08-29 Drivetrain Assembly
    [EN-00021-XA-Motor Sprocket, 40B12 Splined.SLDPRT, EN-00022-AA-Timken 6303-2RS Deep Groove Ball Bearing.SLDPRT, EN-00025-AA-RCV Performance Medium Tulip(Tripod Housing).SLDPRT, EN-00026-AB-61811-2RS1.SLDASM, EN-00027-AB-61810-2RS1.SLDASM, EN-00028-AB-HK 2820.SLDASM, EN-10020-XA-Motor Shaft.SLDPRT, EN-10030-XA-Differential Sprocket.SLDPRT]
2023-09-02 Tensioning Pucks
    [EN-10003-AA-Drive Side Puck (DSP).SLDPRT, EN-10004-AA-Support Side Puck (SSP).SLDPRT]
2023-09-03 Create Chassis CAD Revisions
2023-09-03 Accumulator Assembly
2023-09-03 Chassis CAD Revisions
2023-09-06 Puck Modified FEA
    [EN-10003-AA-Drive Side Puck (DSP).SLDPRT, EN-10003-AB-Drive Side Puck (DSP).SLDPRT]
2023-09-06 Pucks for Assembly
    [EN-10004-XB-Support Side Puck (SSP).SLDPRT]
2023-09-06 Container Assembly
    [AC-30020-AA-Accumulator Floor.SLDPRT, AC-30021-AA-Center Wall.SLDPRT, AC-30022-AA-Front Wall.SLDPRT, AC-30023-AA-Rear Wall.SLDPRT, AC-30024-AA-Internal Wall 1.SLDPRT, AC-30025-AA-Internal Wall 2.SLDPRT, AC-30026-AA-Internal Wall 3.SLDPRT, AC-30027-AA-Internal Wall 4.SLDPRT]
2023-09-06 Create AC-00001-AA-AIR Gigavac GV200.SLDPRT
    [AC-00001-AA-AIR Gigavac GV200.SLDPRT]
2023-09-08 Create FR-40001-BA-Space Frame.SLDPRT
    [FR-40001-BA-Space Frame.SLDPRT]
2023-09-08 Create FR-40001-BB-Space Frame.SLDPRT
    [FR-40001-BB-Space Frame.SLDPRT]
2023-09-11 Controls FE10 -> FE11
    Pushed FE10 Controls folder to FE11 in order to modify existing files
    [2D Ergo Model (Updated).SLDPRT, 2D-ergoModel.SLDPRT, BPPS Pedal Relation.SLDPRT, BPPS Shaft.SLDPRT, BR-00001-AA-Heel Plate.SLDPRT, BR-00001-AB-Heel Plate.SLDPRT, BR-00001-BC-Heel Plate.SLDPRT, BR-00001-BD-Heel Plate.SLDPRT]
2023-09-12 Pedal Box Update
    [BR-0000X-CA-Accel Pedal Platform.SLDPRT, BR-10001-BA-Accel Pedal Assembly.SLDASM, BR-10001-CA-Brake Pedal Assembly.SLDASM, BR-A10001-BA-Pedal Box Assembly.SLDASM, BR-X000X-BA-Brake Pedal Platform.SLDPRT]
2023-09-13 Accumulator and Power Electronics Lid
    [AC-30030-AA-Power Electronics Lid.SLDPRT, AC-30031-AA-Accumulator Lid.SLDPRT]
2023-09-13 Accumulator and Power Electronics name change
    [AC-20030-AA-Power Electronics Lid.SLDPRT, AC-20031-AA-Accumulator Lid.SLDPRT]
2023-09-13 New Steering Design
    Created new assembly for FE11 steering design
    [13T-17.4_NARRco_Rack_V2.IGS, ST-00007-AA-SU Joint Borgeson.SLDASM, ST-00007-AB-SU Joint Borgeson.SLDASM, ST-10008-AG-Lower Column.SLDPRT, ST-A0200-AA-Inboard Steering.SLDASM]
2023-09-13 Create FR-40001-BC-Space Frame.SLDPRT
    [FR-40001-BC-Space Frame.SLDPRT]
2023-09-14 Updated Steering Column
    Added lower lower steering column
    [ST-10009-AA-Lower Lower Column.SLDPRT, ST-A0200-AA-Inboard Steering.SLDASM]
2023-09-15 Ackermann Testing
    Created an assembly to find best toe bracket placement based on desired Ackermann steering percentage
    [Assem1.SLDASM]
2023-09-16 Create SS Bracket Anthony Castellanos V2.SLDPRT
    SS Bracket- Anthony Castellanos
    [SS Bracket Anthony Castellanos V2.SLDPRT]
2023-09-16 AA Cooling Assembly
    [EN-00000-XX-Bent Reinf. Silicone Hose, 0.75in.SLDPRT, EN-00040-AA-Davies Craig EBP40 Pump.SLDPRT, EN-00042-AA-Davies Craig Pump Bracket.SLDPRT, EN-00045-AA-CU1320V.SLDPRT, EN-00046-12038HBK-184 (Fan).SLDPRT, EN-00047-AA-Reinf. Silicone Hose, 0.75in.SLDPRT, EN-00048-AA-Reinf. Silicone Hose, 0.75in.SLDPRT, EN-00049-AA-Reinf. Silicone Hose, 0.375in.SLDPRT]
2023-09-17 Cooling Assembly
    [EN-00052-AA-Reinf. Silicone Hose, 0.75in.SLDPRT, EN-00054-AA-HPS Elbow Reducer Hose 5-8in to 3-4 in.SLDPRT, EN-90053-AA-Aluminum Hardline Pump to MC Inlet.SLDPRT, EN-90064-AA-Aluminum Hardline Pump to MC Inlet.SLDPRT, FS-WORM DRIVE CLAMP, 0.3125-0.625in (5076K31).SLDPRT, FS-WORM DRIVE CLAMP, 0.75-1.25in (5076K15).SLDPRT]
2023-09-17 Create ~$SS Bracket Anthony Castellanos V2.SLDPRT
    Updated SS bracket
2023-09-17 Create 2023-24 prototype motor shaft.SLDPRT
    [2023-24 prototype motor shaft.SLDPRT]
2023-09-18 Create BR-0000X-CB-Accel Pedal Platform.SLDPRT
    [BR-0000X-CB-Accel Pedal Platform.SLDPRT]
2023-09-18 Pedal static studies
    [BR-0000X-CB-Accel Pedal Platform.SLDPRT, BR-X000X-BB-Brake Pedal Platform.SLDPRT]
2023-09-18 Mass savings for platforms
    [BR-0000X-CB-Accel Pedal Platform.SLDPRT, BR-X000X-BB-Brake Pedal Platform.SLDPRT]
2023-09-18 Pedal box refresh
    [BR-10001-BA-Accel Pedal Assembly.SLDASM, BR-10001-CA-Brake Pedal Assembly.SLDASM, BR-A10001-BA-Pedal Box Assembly.SLDASM]
2023-09-19 Create FR-40001-BD-Space Frame.SLDPRT
    [FR-40001-BD-Space Frame.SLDPRT]
2023-09-22 Create ~$FR-40001-BD-Space Frame.SLDPRT
2023-09-22 Update FR-40001-BD-Space Frame.SLDPRT
    [FR-40001-BD-Space Frame.SLDPRT]
2023-09-29 Pivot Shaft APPS
    [BR-0000X-AA-Pivot Shaft.SLDPRT, BR-1000X-CA-Accel Pedal Mount.SLDPRT, MTA02-06DBS-Small Angular Contact Bearings.dxf]
2023-10-01 APPS at pivot design for accel
    [BR-10001-CA-Accel Pedal Assembly.SLDASM, BR-1000X-CA-Accel Pedal Mount.SLDPRT, Bearing Bounding Box.SLDPRT]
2023-10-04 APPS to Pivot Pt
    [76161 - 96MM D-Shaft.SLDPRT, 76161 - 96MM D-Shaft.stp, 7804K111_Stainless Steel Ball Bearing 6mm ID 10mm OD.SLDPRT, BR-10001-BA-Accel Pedal Assembly.SLDASM, BR-10001-CA-Accel Pedal Assembly.SLDASM, BR-1000X-CA-Accel Pedal Mount.SLDPRT, BR-2000X-BA-Accel Pedal Arm.SLDPRT]
2023-10-04 Accelerator Pedal
    added bearings, correct fasteners, organized mates
    [76161 - 96MM D-Shaft.SLDPRT, 91290A115_Alloy Steel Socket Head Screw M3 x 0.5 mm Thread 10 mm Long.SLDPRT, BR-0000X-AA-APPS Spacer, Right.SLDPRT, BR-10001-CA-Accel Pedal Assembly.SLDASM, BR-1000X-CA-Accel Pedal Mount.SLDPRT]
2023-10-05 Tolerance Improvements
    [76161 - 96MM D-Shaft.SLDPRT, BR-10001-CA-Accel Pedal Assembly.SLDASM, BR-1000X-CA-Accel Pedal Mount.SLDPRT, BR-2000X-BA-Accel Pedal Arm.SLDPRT]
2023-10-08 Accumulator waterproofing prototype files and assembly
    [AC waterproofing PE lid.SLDPRT, AC waterproofing complete.SLDASM, AC waterproofing container.SLDPRT, AC waterproofing main lid.SLDPRT]
2023-10-08 Accumulator Waterproofing prototype assembly fixed
    [AC waterproofing PE lid.SLDPRT, AC waterproofing container.SLDPRT, AC waterproofing main lid.SLDPRT, accumulator waterproofing prototype lid.SLDPRT, accumulator waterproofing prototype.SLDPRT, accumulator waterproofing protoype power electronics lid.SLDPRT]
2023-10-08 Added New Folder in Sus
    Added new folders to sus and started working on CADIng parts
    [SP-FR Lower A-Arm Tube.SLDPRT]
2023-10-09 Front Suspension CAD
    - Made front upper & lower A Arns and their assemblies
    - Made front axle assembly for A-arms and A-Arm tabs
    [6960T231_Super-Swivel Ball Joint Rod End.SLDPRT, FS-0.5625 Rubber Push-In Grommet (9600K210).SLDPRT, FS-BALL BEARING, 0.25ID-0.75OD (60355K702).SLDPRT, FS-BLACK NYLON SPACER, M4-13 (99072A155).SLDPRT, FS-BLACK NYLON SPACER, M4-8 (99072A148).SLDPRT, FS-BLACK OXIDE C10.9 BHCS, M4x0.7-14 (91239A149).SLDPRT, FS-BLACK OXIDE C10.9 BHCS, M5x0.8-22 (91239A242).SLDPRT, FS-BLACK OXIDE C10.9 BHCS, M5x0.8-25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]
2023-10-09 Rear Sus Assembly
    Made rear sus assembly and renamed some of the assemblies
    [SP - Rear Lower A-Arms.SLDASM, SP - Rear Upper A-Arms.SLDASM, SP-10002-AE-Upper Apex F.SLDPRT, SP-10052-AD-Lower Apex R.SLDPRT, SP-A0100-AA-Front A-Arm Assembly.SLDASM, SP-A0100-AA-Rear A-Arm Assembly.SLDASM, SP-RR Lower A-Arm Tube.SLDPRT, SP-RR Upper A-Arm Tube.SLDPRT]
2023-10-09 Updated SUS
    [SP - Front Lower A-Arms.SLDASM, SP - Front Upper A-Arms.SLDASM, SP-10004-AA-Outer Threaded Insert.SLDPRT, SP-A0100-AA-Front A-Arm Assembly.SLDASM, SP-FR Upper A-Arm Tube.SLDPRT]
2023-10-09 Rear Sus Update
    [SP - Rear Lower A-Arms.SLDASM, SP - Rear Upper A-Arms.SLDASM, SP-A0100-AA-Rear A-Arm Assembly.SLDASM, SP-RR Lower A-Arm Tube.SLDPRT, SP-RR Upper A-Arm Tube.SLDPRT]
2023-10-09 Updates
    Updated ackerman project and steering assembly
    [Assem1.SLDASM, ST-00007-AA-SU Joint Borgeson.SLDASM, ST-00007-AB-SU Joint Borgeson.SLDASM, ST-10009-AA-Lower Lower Column.SLDPRT, ST-A0200-AA-Inboard Steering.SLDASM]
2023-10-09 Steering updates
    [ST-00007-AA-SU Joint Borgeson.SLDASM, ST-00007-AB-SU Joint Borgeson.SLDASM, ST-10005-AD-Upper Support (backup).SLDPRT, ST-10009-AA-Lower Lower Column.SLDPRT, ST-A0200-AA-Inboard Steering.SLDASM]
2023-10-09 Create FR-40001-CA-Space Frame.SLDPRT
2023-10-09 Update AC waterproofing complete.SLDASM
    [AC waterproofing complete.SLDASM]
2023-10-09 AC waterproofing prototype assembly and files updated
    [AC waterproofing PE lid.SLDPRT, AC waterproofing complete.SLDASM, AC waterproofing container.SLDPRT, accumulator waterproofing prototype lid.SLDPRT, accumulator waterproofing prototype.SLDPRT, accumulator waterproofing protoype power electronics lid.SLDPRT]
2023-10-09 Accumulator Lid Change
    There should be no changes to AA versions; I hit the save button so it looks like it was edited. BA versions length adjusted to no-cooling container.
    [AC-20030-AA-Power Electronics Lid.SLDPRT, AC-20030-BA-Power Electronics Lid.SLDPRT, AC-20031-AA-Accumulator Lid.SLDPRT, AC-20031-BA-Accumulator Lid.SLDPRT]
2023-10-10 Unsprung rolling chassis
    Created an unsprung rolling chassis CAD specifically for all unsprung parts to be mounted to the most up to date chassis
    [SP - Front Lower A-Arms.SLDASM, SP-A0100-AA-Front A-Arm Assembly.SLDASM, SP-A0100-AA-Rear A-Arm Assembly.SLDASM, ST-00020-AA-NARRco Rack MkII.SLDASM, ST-10005-AD-Upper Support.SLDPRT, ST-10008-AG-Lower Column.SLDPRT, ST-10009-AA-Lower Lower Column.SLDPRT, ST-A0200-AA-Inboard Steering.SLDASM]
2023-10-11 Sus and Steering changes
    Updated steering assembly for proper ergo and front roll hoop
    Added rocker design for fronts
    [DXF-SP-A0200-Rear Inner Rocker Gusset.DXF, DXF-SP-A0200-Rear Long Rocker Tab.DXF, DXF-SP-A0200-Rear Outer Rocker Gusset.DXF, DXF-SP-A0200-Rear Rocker Gusset Support.DXF, DXF-SP-A0200-Rear Shock Gusset.DXF, DXF-SP-A0200-Rear Shock Tab.DXF, DXF-SP-A0200-Rear Short Rocker Tab.DXF, FS-MALE ROD END UNF-3A, 0.25x28-0.25D (AM-4).SLDASM]
2023-10-11 Create AC-A0200-BA-Accumulator Assembly.SLDASM
    [AC-A0200-BA-Accumulator Assembly.SLDASM]
2023-10-11 Update AC-A0201-CA-Container Assembly.SLDASM
    [AC-A0201-CA-Container Assembly.SLDASM]
2023-10-12 Accumulator PE floor and insulating sheet
    [AC-20035-AA-Power Electronics Floor.SLDPRT, AC-20036-AA-Power Electronics Floor Insulating Sheet.SLDPRT]
2023-10-12 Create FR-40001-CB-Space Frame.SLDPRT
    [FR-40001-CB-Space Frame.SLDPRT]
2023-10-12 Create FR-40001-CC-Space Frame.SLDPRT
2023-10-12 Sus Stuff
    Shocks and shock mounts
    [DXF-SP-A0200-Rear Shock Gusset.DXF, DXF-SP-A0200-Rear Shock Tab.DXF, MirrorSP-#####-AB-Spring.SLDPRT, MirrorSP-A0105-AC-Ohlin TTX25 MKII, 200mm.SLDASM, SP - Front Lower A-Arms.SLDASM, SP-#####-AB-Spring.SLDPRT, SP-10011-BA-Push Rod Front.SLDASM, SP-30034-AB-Front Shock Tab.SLDPRT]
2023-10-13 Sus is SUS
    [Assem1.SLDASM, DXF-SP-A0200-Rear Inner Rocker Gusset.DXF, DXF-SP-A0200-Rear Long Rocker Tab.DXF, DXF-SP-A0200-Rear Outer Rocker Gusset.DXF, DXF-SP-A0200-Rear Rocker Gusset Support.DXF, DXF-SP-A0200-Rear Short Rocker Tab.DXF, Front Rocker Assembly.SLDASM, MirrorFront Rocker Assembly.SLDASM]
2023-10-13 Moved Fasteners from GrabCAD to GitHub
    [BR-10001-CA-Accel Pedal Assembly.SLDASM, BR-Alloy Steel Shoulder B18.3 SHCS, 0.3125x0.25-20, 2.125 in Lg (91259A480).SLDPRT, BR-Black Oxide C12.9 SHCS, M4x0.7-50 (91290A186).SLDPRT, BR-Black Oxide C12.9 SHCS, M4x0.7-65 (91290A083).SLDPRT, BR-Steel Nylon Locknut, Grade 8, 0.25-20 (90630A110).SLDPRT, BR-Steel Nylon Locknut, Grade 8, M4x0.7 (90576A103).SLDPRT]
2023-10-13 Pedal mount bearing tolerances
    [BR-10001-CA-Accel Pedal Assembly.SLDASM, BR-1000X-CA-Accel Pedal Mount.SLDPRT]
2023-10-14 Brake Pedal Pivot
    [76161 - 96MM D-Shaft.stp, 76161 - D-Shaft.SLDPRT, 7804K111_Stainless Steel Ball Bearing 6mm ID 10mm OD.SLDPRT, BR-10001-BE-Brake Pedal Mount (Left).SLDPRT, BR-10001-BF-Brake Pedal Mount (Right).SLDPRT, BR-10001-CA-Accel Pedal Assembly.SLDASM, BR-10001-CA-Brake Pedal Assembly.SLDASM, BR-10001-DA-Brake Pedal Assembly.SLDASM]
2023-10-14 Motor Shaft & Sprocket
    [2023-24_prototype_motor_shaft_Issues_fixed.SLDPRT, EN-00021-XA-Motor Sprocket, 40B12 Splined.SLDPRT]
2023-10-16 Quarter Car stuffs
    [76161 - 96MM D-Shaft.SLDPRT, BR-0000X-CB-Accel Pedal Platform.SLDPRT, BR-20002-AG-Brake Pedal Arm.SLDPRT, BR-2000X-BA-Accel Pedal Arm.SLDPRT, Components_for_APPS_at_Pivot.xlsx, SP - Front Upper A-Arms.SLDASM, SP-10011-AA-Front Tie Rods.SLDASM, SP-A0100-AA-Front A-Arm Assembly.SLDASM]
2023-10-18 Motor shaft
    [2023-24 prototype motor shaft.SLDPRT, 2023-24_prototype_motor_shaft_Issues_fixed.SLDPRT, EN-00007-AB-ANSI 40 Chain, Pin.SLDPRT, EN-00007-AB-ANSI 40 Chain, Roller.SLDPRT, EN-00021-XB-Motor Sprocket, 40B12 Splined.SLDPRT, EN-10029-AA-Differential Sprocket.SLDPRT]
2023-10-19 Create FR-40001-CD-Space Frame.SLDPRT
2023-10-20 Sus/Controls updates
    [981HE-0-W-A-8H01_-.stp, FS-High Misalign Spherical Bearing, 0.375 (HAB-6TG).SLDASM, FS-MALE ROD END UNF-3A, 0.25x28-0.25D (AM-4).SLDASM, FS-MALE ROD END UNF-3A, 0.3125x24-0.25D (XAM-4).SLDASM, SP - Rear Lower A-Arms.SLDASM, SP-10003-AC-Threaded Insert.SLDPRT, SP-10011-AA-Front Tie Rods.SLDASM, SP-10011-BA-Push Rod Rear.SLDASM]
2023-10-21 New Assembly
2023-10-23 GLVP Update
    [6246613952.step.SLDPRT, 6246614672.step.SLDPRT, Battery Jigging Spacer.SLDPRT, Body-0.step.SLDPRT, Body.step.SLDPRT, Coating.step.SLDPRT, Cut-Extrude5.SLDPRT, Cut-Extrude6.SLDPRT]
2023-10-24 Modified Sus and updated steering assembly
    [FS-FLAT WASHER, M8-16.0D (91455A130).SLDPRT, FS-MALE ROD END UNF-3A, 0.25x28-0.25D (AM-4).SLDASM, FS-ROD END RETAINING WASHER, M8-20.5D (3068-M08).SLDPRT, Front Rocker Assembly.SLDASM, MirrorFront Rocker Assembly.SLDASM, MirrorSP-Front Rocker.SLDPRT, SP-10011-BA-Push Rod Rear.SLDASM, SP-10011-BB-Push Rod Rear.SLDASM]
2023-10-25 Add files via upload
    updated drive side bracket 10/24
    [EN-10001-AC-Drive_Side_Bracket.SLDPRT]
2023-10-25 Accumulator Waterproofing fix and Container holes
    [AC waterproofing PE lid.SLDPRT, AC waterproofing complete.SLDASM, AC waterproofing container.SLDPRT, AC waterproofing main lid.SLDPRT, AC-20030-BA-Power Electronics Lid.SLDPRT, AC-20031-BA-Accumulator Lid.SLDPRT, AC-A0201-CA-Container Assembly.SLDASM]
2023-10-26 Accumulator Fastener Holes
    [AC-20030-BA-Power Electronics Lid.SLDPRT, AC-20031-BA-Accumulator Lid.SLDPRT, AC-30028-AC-Left Wall.SLDPRT, AC-30029-AC-Right Wall.SLDPRT, AC-A0201-DA-Container Assembly.SLDASM]
2023-10-26 New Member Project
    [EN-10004-XA-Support Side Puck (SSP) - Name.SLDPRT]
2023-10-26 Accumulator Fastener Holes fixed
    [AC-20030-BA-Power Electronics Lid.SLDPRT, AC-30022-AC-Front Wall.SLDPRT, AC-30023-AC-Rear Wall.SLDPRT, AC-30025-AC-Internal Wall 2.SLDPRT, AC-30028-AC-Left Wall.SLDPRT, AC-30029-AC-Right Wall.SLDPRT, AC-A0201-DA-Container Assembly.SLDASM]
2023-10-26 Accelerator Pedal New Sensors Redesign
    [7804K115_Stainless Steel Ball Bearing 8mm ID 12 mm OD.SLDPRT, 90910A961_Button Head Torx Screws M4.5x0.7-10.SLDPRT, 91290A115_Alloy Steel Socket Head Screw M3 x 0.5 mm Thread 10 mm Long.SLDPRT, 91290A115_Alloy Steel Socket Head Screw M3x0.5-10.SLDPRT, APPS New Sensor 981HE-0-W-A-8H01_-.SLDASM, APPS New Sensor 981HE-0-W-A-8H01_-.SLDPRT, BR-10001-CB-Accel Pedal Assembly.SLDASM, BR-1000X-CA-Accel Pe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]
2023-10-26 Accelerator Pedal with Plain Bearings
    [7811K141_Multipurpose 660 Leaded Sleeve Bearing 8mm ID 10mm OD.SLDPRT, BR-10001-CB-Accel Pedal Assembly.SLDASM, BR-10001-CC-Accel Pedal Assembly.SLDASM, BR-1000X-CB-Accel Pedal Mount.SLDPRT, BR-1000X-CC-Accel Pedal Mount.SLDPRT]
2023-10-27 Create FR-40001-CE-Space Frame.SLDPRT
2023-10-27 Update FR-40001-CE-Space Frame.SLDPRT
2023-10-27 Create SS bracket Anthony Castellanos.SLDPRT
    SS Bracket Design-Anthony Castellanos
    [SS bracket Anthony Castellanos.SLDPRT]
2023-10-28 Update BR-1000X-CC-Accel Pedal Mount.SLDPRT
    [BR-1000X-CC-Accel Pedal Mount.SLDPRT]
2023-10-28 E-Stop Assembly
    [EL-0050--E-Stop Brackets.SLDPRT, EL-A0103-AA-E-Stop Assembly.SLDASM]
2023-10-28 E-Stop Naming fix
    [EL-0050-AA-E-Stop Brackets.SLDPRT]
2023-10-28 E-Stop Assembly Parts
    [EL-0051-AA-E-Stop Lid.SLDPRT, EL-0052-AA-E-Stop Enclosure.SLDPRT, EL-A0103-AA-E-Stop Assembly.SLDASM]
2023-10-28 E stop naming convention fix
    [EL-20050-AA-E-Stop Brackets.SLDPRT, EL-50051-AA-E-Stop Lid.SLDPRT, EL-50052-AA-E-Stop Enclosure.SLDPRT, EL-A0103-AA-E-Stop Assembly.SLDASM]
2023-10-28 New Member Project - Bracket
    [EN-10001-XA-Support Side Bracket.SLDPRT]
2023-10-28 More Updates
    [AC-20035-BA-Power Electronics Floor.SLDPRT, AC-30021-BA-Center Wall.SLDPRT, AC-30022-AD-Front Wall.SLDPRT, AC-30023-AD-Rear Wall.SLDPRT, AC-30025-AD-Internal Wall 2.SLDPRT, AC-30028-AD-Left Wall.SLDPRT, AC-30029-AD-Right Wall.SLDPRT, AC-A0201-EA-Container Assembly.SLDASM]
2023-10-28 Create MS-30001-AA-Lab and Sub Belt Tabs.SLDPRT
    [MS-30001-AA-Lab and Sub Belt Tabs.SLDPRT]
2023-10-28 Accelerator Pedal Cleanup
    [BR-10001-CC-Accel Pedal Assembly.SLDASM, BR-1000X-CC-Accel Pedal Mount.SLDPRT, BR-2000X-BB-Accel Pedal Arm.SLDPRT]
2023-10-28 Added rail holes for torsion spring and added fastener hardware
    [91290A148_Alloy Steel Socket Head Screw, M4x0.7-12.SLDPRT, 93657A033_Nylon Unthreaded Spacer.SLDPRT, BR-0000X-CB-Accel Pedal Platform.SLDPRT, BR-10001-CC-Accel Pedal Assembly.SLDASM, BR-1000X-CC-Accel Pedal Mount.SLDPRT]
2023-10-28 Brake Pedal CA Assembly Update
    [BR-00004-AB-CP7855 Master Cylinder.SLDASM, BR-10001-CA-Brake Pedal Assembly.SLDASM]
2023-10-29 AB upper apex front and rear
    [SP-AB- Front Upper A-Arms.SLDASM, SP-AB-Rear Upper A-Arms.SLDASM]
2023-10-29 Create EN-10001-AA-Drive_Side_Bracket-Anthony Castellanos.SLDPRT
    [EN-10001-AA-Drive_Side_Bracket-Anthony Castellanos.SLDPRT]
2023-10-29 Update EN-10001-AA-Drive_Side_Bracket-Anthony Castellanos.SLDPRT
    [EN-10001-AA-Drive_Side_Bracket-Anthony Castellanos.SLDPRT]
2023-10-29 Create EN-10001-AA-Support_Side_Bracket-Anthony Castellanosv2.SLDPRT
    [EN-10001-AA-Support_Side_Bracket-Anthony Castellanosv2.SLDPRT]
2023-10-30 E-stop Update
    [EL-20050-AA-E-Stop Brackets.SLDPRT, EL-50052-AA-E-Stop Enclosure.SLDPRT, EL-A0103-AA-E-Stop Assembly.SLDASM]
2023-10-30 Update E-Stop Enclosure
    [EL-50052-AA-E-Stop Enclosure.SLDPRT]
2023-10-30 Updated SUS CAD + Toe Brackets
    SUS CAD geometry change + FEA on rockers
    [FR-20001-AA-Frame Gusset.SLDDRW, FR-20001-AA-Frame Gusset.SLDPRT, SP - Front Lower A-Arms.SLDASM, SP - Front Upper A-Arms.SLDASM, SP - Rear Upper A-Arms.SLDASM, SP-10001 - BA - Front Rocker.SLDPRT, SP-10011-AA-Front Tie Rods.SLDASM, SP-10011-BB-Push Rod Rear.SLDASM]
2023-10-30 E-stop Lid Update
    [EL-50051-AA-E-Stop Lid.SLDPRT, EL-A0103-AA-E-Stop Assembly.SLDASM]
2023-10-31 Create Composite Folder and Dashboard
    Test File for the carbon dashboard
    [dashboard_practice.SLDPRT]
2023-10-31 Motor Assembly
    [EN-A0101-XA-Emrax 228 Motor Assembly.SLDASM]
2023-10-31 Create FR-40001-CF-Space Frame.SLDPRT
2023-10-31 Update EN-10001-AA-Support_Side_Bracket-Anthony Castellanosv2.SLDPRT
    [EN-10001-AA-Support_Side_Bracket-Anthony Castellanosv2.SLDPRT]
2023-10-31 Sus + Controls CAD
    [SP-10001 - BA - Front Rocker.SLDPRT, SP-20001-BB-Rear Rocker.SLDPRT, SP-A0100-AA-Rear A-Arm Assembly.SLDASM, SP-A0101-BB-Rear Rocker Assembly.SLDASM, SP-A0105-AC-Ohlin TTX25 MKII, 200mm.SLDASM, SP-A0106-AB-Front Shock Tab Box.SLDASM, SP-AB-Rear Rocker.SLDPRT, ST-00020-AA-NARRco Rack MkII.SLDASM]
2023-11-02 Updated Accel Pedal Mount With Cuts (No Static Study)
    [BR-1000X-CC-Accel Pedal Mount.SLDPRT]
2023-11-02 HV Cover
    [EN-90043-AB-HV Connection Cover L1.SLDPRT, EN-90044-AB-HV Connection Cover L2.SLDPRT, EN-90045-AA-HV Connection Cover L3.SLDPRT, EN-A0010-AC-HV Connection Cover.SLDASM]
2023-11-02 Create Version 2 Accumulator Lid
    [AC-20037-AA-Version 2 Accumulator Lid.SLDPRT]
2023-11-02 Pedal Platform + Steering Column modifications
    [BR-0000X-CC-Accel Pedal Platform.SLDPRT, ST-10005-BB-Upper Support.SLDPRT]
2023-11-02 New Accel Pedal Assembly
    [BR-10001-CD-Accel Pedal Assembly.SLDASM]
2023-11-02 Motor Shaft Changes
    [2023-24 prototype motor shaft.SLDPRT, EN-00021-AC- Motor Shaft, Involute Splines.SLDPRT, EN-10001-AD-Support Side Bracket.SLDPRT]
2023-11-03 Create FR-40001-CG-Space Frame.SLDPRT
2023-11-03 Dash Update
    [BEZEL.SLDPRT, BLU-1.SLDPRT, BLU.SLDPRT, BSO4-M3-6.SLDPRT, Board mounting bracket.SLDPRT, Board-Part-1.SLDPRT, Board.SLDASM, Carbon_Dashboard (Edwin).SLDPRT]
2023-11-03 Controls & Sus stuff
    [BR-10001-AB-Accel Pedal Assembly.SLDASM, BR-1000X-CC-Accel Pedal Mount.SLDPRT, SP - Rear Lower A-Arms.SLDASM, SP-A0100-AA-Rear A-Arm Assembly.SLDASM, SP-A0105-AC-Ohlin TTX25 MKII, 200mm.SLDASM, ST-A0200-AA-Inboard Steering.SLDASM]
2023-11-03 Controls Shid
    Brake pedal mount modification
    [BR-10001-DB-Brake Pedal Assembly.SLDASM, BR-X000X-BC-Brake Pedal Platform.SLDPRT]
2023-11-03 updated TSMP
    [EL-30021-AA-Enclosure Mounts.SLDPRT, EL-50020-AA-TSMP + MS Enclosure.SLDPRT, EL-50023-AA-TSMP Cover.SLDPRT, EL-60022-AA-Enclosure Lid.SLDPRT, EL-A0101-AA-TSMP + MS Assembly.SLDASM]
2023-11-04 Create FR-40001-CH-Space Frame.SLDPRT
2023-11-04 Controls shid
    [ST-70001-AA-Steering Rack Cover.SLDPRT, ST-A0200-AA-Inboard Steering.SLDASM]
2023-11-04 More update
    [EL-A0101-AA-TSMP + MS Assembly.SLDASM]
2023-11-04 More Cutouts for Accel Pedal Mount
    [BR-10001-CD-Accel Pedal Assembly.SLDASM, BR-1000X-CC-Accel Pedal Mount.SLDPRT]
2023-11-04 Create EN-A0100-AA-Assembly Drivetrain FEA
2023-11-04 New Revision
    [FR-20001-AA-Firewall.SLDPRT, FR-20001-AA-Seat Floor.SLDPRT]
2023-11-04 Final Cuts to Accel Pedal Mount
    [BR-10001-CD-Accel Pedal Assembly.SLDASM, BR-1000X-CC-Accel Pedal Mount.SLDPRT]
2023-11-04 Update FR-40001-CH-Space Frame.SLDPRT
2023-11-04 Create EN-10029-AB-Differential Sprocket.SLDPRT
    [EN-10029-AB-Differential Sprocket.SLDPRT]
2023-11-04 Update EN-10029-AB-Differential Sprocket.SLDPRT
    [EN-10029-AB-Differential Sprocket.SLDPRT]
2023-11-04 Update LV Battery Enclosure
    [EL-30061-AA-LV Battery Mounting Tab.SLDPRT, EL-50060-AA-LV Battery Enclosure.SLDPRT]
2023-11-04 Final Accel Pedal Mount Edit
    [BR-10001-CD-Accel Pedal Assembly.SLDASM, BR-1000X-CC-Accel Pedal Mount.SLDPRT]
2023-11-04 LV Battery Update
    [EL-50060-AA-LV Battery Assembly.SLDASM, EL-50060-AA-LV Battery Enclosure.SLDPRT]
2023-11-04 Accum Lids and Container Fastener Holes Update
    [AC-20038-AB-Version 2 Accumulator Lid.SLDPRT, AC-30022-AE-Front Wall.SLDPRT, AC-30023-AE-Rear Wall.SLDPRT, AC-30028-AD-Left Wall.SLDPRT, AC-30029-AD-Right Wall.SLDPRT, AC-A0201-EA-Container Assembly.SLDASM]
2023-11-04 LV Battery Enclosure Mounting
    [EL-30061-AA-LV Battery Mounting Tab.SLDPRT, EL-50060-AA-LV Battery Assembly.SLDASM]
2023-11-04 E-Stop Enclosure with Inserts and Fasteners
    [EL-50052-AA-E-Stop Enclosure.SLDPRT, EL-A0103-AA-E-Stop Assembly.SLDASM]
2023-11-04 Apex revision and assemblies
    [SP-10002-AF-Lower Apex F.SLDPRT, SP-10052-AB-Upper Apex R.SLDPRT, SP-A0100-AB-Front A-Arm Assembly.SLDASM, SP-A0100-AB-Rear A-Arm Assembly.SLDASM]
2023-11-04 TSAL Update
    [BR-Black Oxide C12.9 SHCS, M4x0.7-8 (91290A140).SLDPRT, EL-30072-AA-TSAL Mounting Tab.SLDPRT, EL-50070-AA-TSAL Top Housing.SLDPRT, EL-50071-AA-TSAL Bottom Housing.SLDPRT, EL-A0105-AA-TSAL Assembly.SLDASM, FS-Heat Set Insert, M4x7-4.7 (94180A351).SLDPRT]
2023-11-04 Brake Light update
    [BR-Black Oxide C12.9 SHCS, M4x0.7-8 (91290A140).SLDPRT, EL-00081-AA-Brake light.SLDPRT, EL-30080-AA-Brake Light Tabs.SLDPRT, EL-A0105-AA-Brake Light Assembly.SLDASM]
2023-11-04 Accumulator Add Press Fit Nut
    [94674A603_Flush-Mount Press-Fit Nut for Sheet Metal.SLDPRT, AC-20038-AB-Version 2 Accumulator Lid.SLDPRT, AC-30022-AE-Front Wall.SLDPRT, AC-30023-AE-Rear Wall.SLDPRT, AC-30028-AD-Left Wall.SLDPRT, AC-30029-AD-Right Wall.SLDPRT, AC-A0201-EA-Container Assembly.SLDASM, Chassis Side Mounts Assembly.SLDASM]
2023-11-05 AC Updates
    [AC-20036-AB-Power Electronics Floor Insulating Sheet.SLDPRT, AC-20037-CA-Accumulator Lid.SLDPRT, AC-A0201-EA-Container Assembly.SLDASM]
2023-11-05 Final PB Assembly
    [BR-00004-AB-CP7855 Master Cylinder.SLDASM, BR-0000X-CC-Accel Pedal Platform.SLDPRT, BR-10001-BA-Accel Pedal Assembly.SLDASM, BR-10001-BE-Brake Pedal Mount (Left).SLDPRT, BR-10001-CA-Brake Pedal Assembly.SLDASM, BR-10001-CD-Accel Pedal Assembly.SLDASM, BR-10001-DC-Brake Pedal Assembly.SLDASM, BR-1000X-CC-Accel Pedal Mount.SLDPRT]
2023-11-06 A lot of updates
    [90358A137_Ultra-Low-Profile Socket Head Screw.SLDPRT, 93070A144_Alloy Steel Low-Profile Socket Head Screw.SLDPRT, 94674A603_Flush-Mount Press-Fit Nut for Sheet Metal.SLDPRT, 95185A680_Zinc-Plated Steel Press-Fit Nut for Sheet Metal.SLDPRT, AC-20035-BA-Power Electronics Floor.SLDPRT, AC-20036-AB-Power Electronics Floor Insulating Sheet.SLDPRT, AC-20037-CA-Accumulator Lid.SLDPRT, AC-30020-DB-Accumu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]
2023-11-06 Cooling Assembly
    Mainly routing changes with new tee-adapter :need_bed:
    [0.75in Barbed Tee Adapter with Sensors.SLDASM, Aluminum Adapter Subassembly.SLDASM, Aluminum Tee.SLDPRT, EN-00064-AA-Bent Reinf. Silicone Hose, 0.75in.SLDPRT, EN-00065-AA-Reinf. Silicone Hose Elbow, 0.75in.SLDPRT, EN-00070-AA-Reinf. Silicone Hose Elbow, 0.75in Radiator Outlet.SLDPRT, EN-00073-AA-Bent Reinf. Silicone Hose, 0.75in Pump to Motor Inlet.SLDPRT, EN-00075-AA-Reinf. Silicone Hose Elbow, 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]
2023-11-07 Minor Cooling Changes
    [EN-00055-AB-Expansion Tank.SLDPRT, EN-00055-AC-Expansion Tank.SLDPRT, EN-00078-AA-Bent Reinf. Silicone Hose, 0.75in Pump to MC Inlet.SLDPRT, EN-90069-AA-0.75in Aluminum Hose Joiner.SLDPRT, Expansion Tank.SLDPRT]
2023-11-07 Dashboard assem
    [Dashbaord Enclosure.SLDPRT, EL-A00XX-BA-Dashboard Assembly.SLDASM]
2023-11-07 susp revisions
    [2868T52_High-Load Oil-Embedded 863 Sleeve Bearing.SLDPRT, SP - Front Lower A-Arms.SLDASM, SP-10001 - BA - Front Rocker.SLDPRT, SP-10002-AF-Lower Apex F.SLDPRT, SP-20001-BB-Rear Rocker.SLDPRT, SP-30063-AB-Pushrod Tab.SLDPRT, SP-A0100-AB-Front A-Arm Assembly.SLDASM, SP-A0100-AB-Rear A-Arm Assembly.SLDASM]
2023-11-07 rear tie rods
    [SP - Rear Lower A-Arms.SLDASM, SP-10011-AA-Rear Tie Rods.SLDASM, SP-A0100-AB-Rear A-Arm Assembly.SLDASM, SP-AB-Rear Upper A-Arms.SLDASM]
2023-11-07 Full Cooling Assembly
    :need_bed:
    [EN-00056-Expansion Tank Cap.SLDPRT, EN-00064-AA-Bent Reinf. Silicone Hose, 0.75in.SLDPRT, EN-00070-AA-Reinf. Silicone Hose Elbow, 0.75in Radiator Outlet.SLDPRT, EN-00074-AA-Bent Reinf. Silicone Hose, 0.50in Expansion Tank Outlet.SLDPRT, EN-00078-AA-Bent Reinf. Silicone Hose, 0.75in Pump to MC Inlet.SLDPRT, EN-00300-Expansion Tank Mounting Tab.SLDPRT, EN-00301-AA-Expansion Tank Mounting Tab.SLDPRT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]
2023-11-08 MANY UPDATES
    [90576A102_Medium-Strength Steel Nylon-Insert Locknut, M3x0.5.SLDPRT, 91290A115_Alloy Steel Socket Head Screw M3x0.5-10.SLDPRT, 91290A119_Alloy Steel Socket Head Screw, M3x0.5,14mm.SLDPRT, 91290A168_Alloy Steel Socket Head Screw M4x0.7,20.SLDPRT, 91290A572_Alloy Steel Socket Head Screw. M3x0.5, 15mm.SLDPRT, 93795A220_Top-Lock Distorted-Thread Locknut, M6x1.SLDPRT, 97654A381_18-8 Stainless Steel Fl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]
2023-11-08 Expansion Tank updates
    [EN-00055-AB-Expansion Tank.SLDPRT, EN-00056-Expansion Tank Cap.SLDPRT, EN-00074-AA-Bent Reinf. Silicone Hose, 0.50in Expansion Tank Outlet.SLDPRT, EN-00301-AA-Expansion Tank Mounting Tab.SLDPRT, Expansion Tank Subassembly.SLDASM]
2023-11-08 Motor Guard
    [EN-90042-AB-Motor Guard.SLDPRT]
2023-11-08 Master CAD
2023-11-09 Final controls changes + updated unsprung chassis
    [BR-00004-AB-CP7855 Master Cylinder.SLDASM, BR-10001-CD-Accel Pedal Assembly.SLDASM, BR-10001-DC-Brake Pedal Assembly.SLDASM, BR-1000X-CC-Accel Pedal Mount.SLDPRT, BR-X000X-BC-Brake Pedal Platform.SLDPRT, Components_for_APPS_at_Pivot.xlsx, SP-A0100-AA-Front A-Arm Assembly.SLDASM, SP-A0100-AB-Rear A-Arm Assembly.SLDASM]
2023-11-10 Chassis unsprung updated
    [BR-10001-DC-Brake Pedal Assembly.SLDASM, FS-High Misalign Spherical Bearing, 0.375 (HAB-6TG).SLDASM, FS-MALE ROD END UNF-3A, 0.25x28-0.25D (AM-4).SLDASM, SP - Rear Lower A-Arms.SLDASM, SP-10011-BB-Push Rod Rear.SLDASM, SP-A0100-AB-Rear A-Arm Assembly.SLDASM, SP-A0101-BB-Rear Rocker Assembly.SLDASM, SP-A0105-AC-Ohlin TTX25 MKII, 200mm.SLDASM]
2023-11-10 Master Assembly
2023-11-11 Cooling Assembly Alignment
    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
    [Aluminum Adapter Subassembly.SLDASM, EN-00040-AA-Davies Craig EBP40 Pump.SLDPRT, EN-00064-AA-Bent Reinf. Silicone Hose, 0.75in.SLDPRT, EN-00066-AA-Reinf. Silicone Hose, 10mm Motor Inlet.SLDPRT, EN-00073-AA-Bent Reinf. Silicone Hose, 0.75in Pump to Motor Inlet.SLDPRT, EN-00074-AA-Bent Reinf. Silicone Hose, 0.50in Expansion Tank Outlet.SLDPRT, EN-00076-AA-Bent Reinf. Silicone Hose, 0.75in.SLDPRT, E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]
2023-11-11 Create ~$EN-10001-BB-Support Side Bracket.SLDPRT
    Revision of Bracket 11/11/2023
    -Changed Motor Guard holes
2023-11-12 Pedal Box Floor
    [FR-70001-AA-Pedal Box Floor.SLDPRT]
2023-11-12 Intermediate Floor
    [FR-70001-AA-Intermediate Floor.SLDPRT]
2023-11-13 Create EN-10029-AA-Differential Sprocket Assem.zip
2023-11-13 Update AC-A0200-DA-Accumulator Assembly.SLDASM
2023-11-13 Changed pedal position
    [BR-10001-CD-Accel Pedal Assembly.SLDASM, BR-10001-DC-Brake Pedal Assembly.SLDASM]
2023-11-13 Brake assembly
    [BR-00004-AB-CP7855 Master Cylinder.SLDASM, BR-10001-DC-Brake Pedal Assembly.SLDASM]
2023-11-14 Revert "HV Cover"
    This reverts commit e1b7a746ab691a4495f6a25246dd7630bb628449.
    [AC-50030-AA-AIR Enclosure Lid.SLDPRT, EL-A0101-AA-TSMP + MS Assembly.SLDASM, EL-A0103-AA-E-Stop Assembly.SLDASM, EL-A0104-AA-LV Battery Assembly.SLDASM, EL-A0105-AA-TSAL Assembly.SLDASM, EL-A0107-AA-HVI Assembly.SLDASM, EN-A0010-AC-HV Connection Cover.SLDASM]
2023-11-17 PB and Unsprung shid
    [6391K334_Oil-Embedded Bronze Sleeve Bearing.SLDPRT, 92510A802_Aluminum Unthreaded Spacer.SLDPRT, BR-10001-DC-Brake Pedal Assembly.SLDASM, FR-0000X-AA-BOTS CAP.SLDPRT, FS-High Misalign Spherical Bearing, 0.375 (HAB-6TG).SLDASM, FS-MALE ROD END UNF-3A, 0.25x28-0.25D (AM-4).SLDASM, SP - Front Lower A-Arms.SLDASM, SP - Rear Lower A-Arms.SLDASM]
2023-11-17 Actual nosecone
    [FR-70001-AA-Nosecone.SLDPRT]
2023-11-17 Updated upright + camber block
    [WT-#####-AC-Front Upright.SLDPRT, WT-XXXXX-CA-Front Camber Block.SLDPRT]
2023-11-17 actual upright and camber block
    [WT-#####-AC-Front Upright.SLDPRT, WT-XXXXX-CA-Front Camber Block.SLDPRT]
2023-11-17 camber fix
    [WT-XXXXX-CA-Front Camber Block.SLDPRT]
2023-11-17 Toe bracket + WP Upright assembly changes
    [WP-AA-Toe Base Plate.SLDPRT, WT-A0100-AC-Toe Bracket.SLDASM, WT-FB-Toe Base Plate.SLDPRT, WT-FC-Toe Bottom Clevis.SLDPRT, WT-Front Upright Assembly.SLDASM, WT-GB-Toe Top Clevis1.SLDPRT, WT-XXXXX-AB-Front Camber Block.SLDPRT]
2023-11-17 HVD Tab
    [EN-30035-AB-HVD Tab.SLDPRT]
2023-11-19 Motor Sprocket
    [EN-00021-XB-Motor Sprocket, 40B12 Splined.SLDPRT]
2023-11-22 new APPS sensor
    [9851R5KL2.0.step]
2023-11-23 Sprocket CAM
    [EN-10029-AB-Differential Sprocket.SLDPRT, Sprocket_Assem.SLDASM]
2023-11-23 Motor Shaft CAM
    [EN-00021-AC- Motor Shaft, Involute Splines.SLDPRT]
2023-11-26 New Accel Pedal Assembly for sensor swap
    [BR-00001-AA-Pivot Shaft.SLDPRT, BR-00001-BA D-Shaft.SLDPRT, BR-00002-AA 2868T4_High-Load Oil-Embedded 863 Sleeve Bearing 0.375 in ID.SLDPRT, BR-0000X-AA-Pivot Shaft.SLDPRT, BR-1000X-CD-Accel Pedal Mount.SLDPRT, BR-93657A069_Nylon Unthreaded Spacer 5.3mm ID 10mm OD.SLDPRT, Components_for_APPS_at_Pivot.xlsx]
2023-11-26 Updating Diff Sprocket CAM (IP)
    [EN-10029-AB-Differential Sprocket.SLDPRT, Sprocket_Assem.SLDASM]
2023-11-27 Accel Pedal
    [BR-00001-BA D-Shaft.SLDPRT, BR-1000X-CD-Accel Pedal Mount.SLDPRT, BR-2000X-BD-Accel_Pedal_Arm.SLDPRT, BR-9851R5KL2.0 Potentiometer Sensor.SLDPRT]
2023-12-01 Suspension Jig
    A-Arm Jig
    [SP-40001-AA-AArm Jig.SLDPRT]
2023-12-01 Create FR-40001-CI-Space Frame.SLDPRT
    [FR-40001-CI-Space Frame.SLDPRT]
2023-12-02 Acccumulator Waterproofing Prototype New
    [AC V2 Waterproofing Prototype Assembly.SLDASM, AC V2 Waterproofing container.SLDPRT, AC V2 Waterproofing lid.SLDPRT]
2023-12-02 Fixturing Plate
    [12.00_x_12.00_x_1.5_Fixture_Plate.SLDPRT, Sprocket_Assem.SLDASM]
2023-12-02 Accumulator Waterproofing Prototype Update
    [AC V2 Waterproofing Prototype Assembly.SLDASM, AC V2 Waterproofing container.SLDPRT, AC V2 Waterproofing lid.SLDPRT]
2023-12-03 Accumulator Waterproofing Prototype Update 2
    [AC V2 Waterproofing Prototype Assembly.SLDASM, AC V2 Waterproofing lid.SLDPRT]
2023-12-03 Accumulator Waterproofing Prototype Update 3
    [AC V2 Waterproofing Prototype Assembly.SLDASM, AC V2 Waterproofing container.SLDPRT, AC V2 Waterproofing lid.SLDPRT]
2023-12-07 drive side bracket
    [EN-10001-BA-Drive_Side_Bracket.SLDPRT]
2023-12-09 actually doing my job
    [BR-#####-AB-Solid Brake Rotor.SLDPRT, CP4227-2S0.SLDASM, WT-#####-AC-Front Upright.SLDPRT, WT-####-AB-Misuni Drive Pins.SLDPRT, WT-00201-AA-OZ Centerlock 10in Wheel.SLDPRT, WT-00202-AA-Hoosier R25B 16x7_5-10.SLDPRT, WT-10101-AA-Wheel Hub Front.SLDPRT, WT-10106-AB-Backing Plate.SLDPRT]
2023-12-09 Accelerator Pedal
    [BR-00001-BA D-Shaft.SLDPRT, BR-1000X-CD-Accel Pedal Mount.SLDPRT, BR-2000X-BD-Accel_Pedal_Arm.SLDPRT]
2023-12-10 Accelerator Pedal Sensor Angle
    [BR-00001-BD-Heel Plate.SLDPRT, BR-1000X-CD-Accel Pedal Mount.SLDPRT, BR-2000X-BD-Accel_Pedal_Arm.SLDPRT]
2023-12-10 Brake Heel Plate
    [BR-00001-BC-Heel Plate.SLDPRT, BR-10001-DC-Brake Pedal Assembly.SLDASM]
2023-12-10 More CAM
    [SS Bracket CAM.SLDASM, SS Bracket Stock.SLDPRT]
2023-12-10 Update SS Bracket CAM.SLDASM
    [SS Bracket CAM.SLDASM]
2023-12-16 Steering Change
    [BR-10001-CD-Accel Pedal Assembly.SLDASM, BR-10001-DC-Brake Pedal Assembly.SLDASM, ST-10005-BB-Upper Support.SLDPRT, ST-A0200-AA-Inboard Steering.SLDASM]
2023-12-18 SS Bracket
    [EN-A0005-AA-HVD Assembly.SLDASM, SS Bracket CAM.SLDASM, SS Bracket Stock.SLDPRT]
2023-12-24 Create EN-10001-BA-Tensioning tool.SLDPRT
    [EN-10001-BA-Tensioning tool.SLDPRT]
2023-12-28 Create Tensioning Tool EN-A0100-AC-Drivetrain Assembly.SLDPRT
    [Tensioning Tool EN-A0100-AC-Drivetrain Assembly.SLDPRT]
2024-01-08 Controls DXF + Minor Changes
    [BR-0000X-CC-Accel Pedal Platform.DXF, BR-1000X-CD-Accel Pedal Mount.DXF, BR-1000X-CD-Accel Pedal Mount.SLDPRT, BR-2000X-BD-Accel_Pedal_Arm.DXF, BR-X000X-BC-Brake Pedal Platform.DXF, Rack Mount Assembly v3.dxf, Rack Mount Assembly.DXF, Rack Mount Assembly.SLDASM]
2024-01-08 Steering Tab box update
    Added tongue and groove
    [ST-10001-AA-Steering Tab Box.SLDASM]
2024-01-08 Unsprung Chassis Steering Box Update
    [ST-10001-AA-Steering Tab Box.SLDASM]
2024-01-10 Update FR-40001-CI-Space Frame.SLDPRT
    [FR-40001-CI-Space Frame.SLDPRT]
2024-01-11 SS Bracket CAM
    [12.00 x 12.00 x 1.5 Fixture Plate (1).SLDPRT, 4999A31_Step Setup Clamp.SLDPRT, Assem1.SLDASM, EN-10001-BA-Tensioning tool.SLDPRT, SS Bracket CAM.SLDASM, SS Bracket Stock.SLDPRT, Stock.SLDPRT]
2024-01-12 Update BR-1000X-CD-Accel Pedal Mount.SLDPRT
    [BR-1000X-CD-Accel Pedal Mount.SLDPRT]
2024-01-14 Steering collar jigging
    [Jig Assembly.SLDASM, Jig for tubes to collar.SLDPRT, ST-10005-BB-Upper Support Modified.SLDPRT]
2024-01-16 Steering Tab box
    [Steering Tab Box Side.DXF, Steering Tab Box Top.DXF]
2024-01-16 Toe Bracket Change
    [BR-10001-DC-Brake Pedal Assembly.SLDASM, FR-40001-CI-Space Frame.SLDPRT, SP-10011-AA-Front Tie Rods.SLDASM, SP-A0105-AC-Ohlin TTX25 MKII, 200mm.SLDASM, ST-00020-AA-NARRco Rack MkII.SLDASM, ST-A0200-AA-Inboard Steering.SLDASM]
2024-01-16 Accumulator Waterproofing Prototype V3
    [AC V3 Waterproofing Assembly.SLDASM, AC V3 Waterproofing container.SLDPRT, AC V3 Waterproofing lid.SLDPRT]
2024-01-16 AC Prototyping update
    [AC V3 Waterproofing Assembly.SLDASM, AC V3 Waterproofing lid.SLDPRT]
2024-01-16 AC Prototyping Update 2
    [AC V3 Waterproofing Assembly.SLDASM, AC V3 Waterproofing container.SLDPRT, AC V3 Waterproofing lid.SLDPRT]
2024-01-18 DS Bracket CAM
    [12.00_x_12.00_x_1.5_Fixture_Plate.SLDPRT, DS Bracket CAM.SLDASM, DS Bracket Stock.SLDPRT, EN-10001-BA-Drive_Side_Bracket.SLDPRT, EN-10001-BB-Drive_Side_Bracket.SLDPRT, SS Bracket CAM.SLDASM]
2024-01-18 Revert "DS Bracket CAM"
    This reverts commit 20f51261bbbe10aca9f3f236af95a043a9258a73.
    [12.00_x_12.00_x_1.5_Fixture_Plate.SLDPRT, DS Bracket CAM.SLDASM, DS Bracket Stock.SLDPRT, EN-10001-BA-Drive_Side_Bracket.SLDPRT, EN-10001-BB-Drive_Side_Bracket.SLDPRT, SS Bracket CAM.SLDASM]
2024-01-19 Steering Collar Jig
    [Jig Assembly.SLDASM, Jig for tubes to collar.SLDPRT, Spacer Left.SLDPRT, Spacer Right.SLDPRT]
2024-01-20 Extruded Al Jig
    [47065T127_T-Slotted Framing Extruded Al.SLDPRT, 47065T209_T-Slotted Framing Extruded Al 1x1 - 2 ft.SLDPRT, 47065T411_T-Slotted Framing 1x1 1ft.SLDPRT, 47065T553_T-Slotted Framing 1x1 - 0.5 ft.SLDPRT, Chassis Steering Collar Jig.SLDASM]
2024-01-22 AC waterproofing updates
    [AC V3 Waterproofing container.SLDPRT, AC V4 Waterproofing Assembly.SLDASM, AC V4 Waterproofing lid.SLDPRT]
2024-01-22 Steering Rack Clearance Jig
    [Steering Rack Clearance Jig.SLDPRT]
2024-01-25 AC waterproofing
    [AC V4 Waterproofing container.SLDPRT, AC mini Waterproofing Assembly.SLDASM, AC mini lid.SLDPRT]
2024-01-27 Jig Height
    [Chassis Steering Collar Jig.SLDASM, Jig to Steering Collar Tubes.SLDASM]
2024-01-27 Create ~$EN-00021-AC- Motor Shaft, Involute Splines.SLDPRT
2024-01-27 Create EN-00021-AC- Motor Shaft, Involute Splines.SLDDRW
    [EN-00021-AC- Motor Shaft, Involute Splines.SLDDRW]
2024-01-27 Revert "Create EN-00021-AC- Motor Shaft, Involute Splines.SLDDRW"
    This reverts commit 901a66d24f6f2822ed1dd9326e14942f52772da5.
    [EN-00021-AC- Motor Shaft, Involute Splines.SLDDRW]
2024-01-27 Revert "Revert "Create EN-00021-AC- Motor Shaft, Involute Splines.SLDDRW""
    This reverts commit 33cfc6e5aedea858acaa52fc20501240a1bc5973.
    [EN-00021-AC- Motor Shaft, Involute Splines.SLDDRW]
2024-01-29 Rear Camber Block Prototype
    [WT-RR####-CA-Camber Block.SLDPRT]
2024-02-03 Create ~$EN-00021-AC- Motor Shaft, Involute Splines.SLDDRW
2024-02-03 Create EN-00021-AC- Motor Shaft, Involute Splines.pdf
    PDF Of Motor Shaft Drawing
2024-02-11 GD&T Drawings for A-Arm Tubes
    GD&T Drawings for A-Arm Tubes
    [SP-FR Lower A-Arm Tube.SLDDRW, SP-FR Upper A-Arm Tube.SLDDRW, SP-RR Lower A-Arm Tube.SLDDRW, SP-RR Upper A-Arm Tube.SLDDRW]
2024-02-12 DT Jig Updates
    [EN-50043-AA-Jig.SLDPRT, EN-50044-AA-Centering Jig.SLDPRT]
2024-02-20 Suspension Apexes Drawings
    Suspension Apexes Drawings
    [SP-10002-AE-Lower Apex F.SLDDRW, SP-10002-AF-Lower Apex F.SLDDRW, SP-10052-AB-Upper Apex R.SLDDRW, SP-10052-AD-Lower Apex R.SLDDRW]
2024-02-20 Apex Drawings
    [SP-10002-AE-Lower Apex F.SLDPRT, SP-10002-AF-Lower Apex F.SLDPRT, SP-10052-AB-Upper Apex R.SLDPRT, SP-10052-AD-Lower Apex R.SLDPRT]
2024-02-20 Steering Jig
    [Chassis Steering Collar Jig.SLDASM, Jig to Steering Collar Tubes.SLDASM, JigtoChassisA.SLDPRT, ST-00006-AA-Upper Column Bearing (2938T23).SLDPRT]
2024-02-22 Apex Drawings Update
    [SP-10002-AE-Lower Apex F.SLDDRW, SP-10002-AF-Lower Apex F.SLDDRW, SP-10052-AB-Upper Apex R.SLDDRW, SP-10052-AD-Lower Apex R.SLDDRW]
2024-02-24 Suspension Rear Rocker Drawing
    Rear Rocker Drawing
    [SP-20001-BB-Rear Rocker.SLDDRW, SP-20001-BB-Rear Rocker.SLDPRT]
2024-02-24 2.75 Diff Sprocket
    Creating Folder for CAM for 2.75 diff sprocket
    [EN-10029-BA-Differential Sprocket 33 Teeth.SLDPRT]
2024-02-24 Apex CAM
    [Apex CAM.SLDASM, Apex Stock.SLDPRT, EN-00021-AC- Motor Shaft, Involute Splines.SLDPRT, SP-10052-AD-Lower Apex R.SLDPRT, Soft Jaws.SLDPRT]
2024-02-24 fixed wheel hub
    [WT-10101-AA-Wheel Hub Front.SLDPRT]
2024-02-25 Update Camber Block
    [WT-RR####-CA-Camber Block.SLDPRT]
2024-02-25 CAM for Soft Jaws, step side
    CAM for Soft Jaws, step side
    [EN-10003-AB-Drive Side Puck (DSP).SLDPRT, EN-50043-AA-Jig.STL, EN-50044-AA-Centering Jig.STL, Soft Jaws Step side.SLDPRT, Soft Jaws.SLDPRT]
2024-02-28 CAM- Camber Block
    [BA Camber Block CAM.SLDASM, WT-RR####-CA-Camber Block.SLDPRT]
2024-02-29 Update BA Camber Block CAM.SLDASM
    [BA Camber Block CAM.SLDASM]
2024-02-29 Update SP-40001-AB-AArm Jig.SLDPRT
    [SP-40001-AB-AArm Jig.SLDPRT]
2024-03-02 CAM Sprocket
    [Differntial Sprocket 2.75 CAM.SLDASM, EN-10029-BA-Differential Sprocket 33 Teeth.SLDPRT, Sprocket_Assem.SLDASM]
2024-03-04 Brake platform drawing
    [BR-X000X-BC-Brake Pedal Platform.SLDDRW]
2024-03-07 Assembly Drawings
    1) SP-10011-BB-Push Rod Rear
    2) SP-A0101-BB-Rear-Rocker
    3) SP-A0106-AB-Front Shock Tab
    4) SP-A0100-AA-Rear A Arm Assembly
    [6960T231_Super-Swivel Ball Joint Rod End.SLDPRT, FS-High Misalign Spherical Bearing, 0.375 (HAB-6TG).SLDASM, FS-MALE ROD END UNF-3A, 0.25x28-0.25D (AM-4).SLDASM, FS-ZINC YELLOW THIN NUT G8 HX, 0.25x28-0.15625 (93839A805).SLDPRT, FS-ZINC YELLOW THIN NUT G8 HX, 0.375x24-0.21875 (93839A815).SLDPRT, SP - Rear Lower A-Arms.SLDASM, SP-#####-AB-Spring.SLDPRT, SP-10003-AC-Threaded Insert.SLDPRT]
2024-03-07 Create SP-A0106-AB-Front Shock Tab Box.SLDDRW
    [SP-A0106-AB-Front Shock Tab Box.SLDDRW]
2024-03-08 CAM update sprocket
    [Differntial Sprocket 2.75 CAM.SLDASM, EN-10029-BA-Differential Sprocket 33 Teeth.SLDPRT, Sprocket_Assem.SLDASM]
2024-03-08 Update Differntial Sprocket 2.75 CAM.SLDASM
    [Differntial Sprocket 2.75 CAM.SLDASM]
2024-03-09 Add files via upload
    Front Camber Block CAM
    [WT-XXXXX-CA-Front Camber Block.SLDASM]
2024-03-09 Update CAM
    [Differntial Sprocket 2.75 CAM.SLDASM, EN-10029-BA-Differential Sprocket 33 Teeth.SLDPRT]
2024-03-13 Drawings
    More suspension Drawings
    [SP-10071-AC-P Rod Tube R.SLDDRW, SP-30034-AB-Front Shock Tab.SLDDRW, SP-30034-AB-Front Shock Tab.SLDPRT, SP-30035-AA-Front Shock Gusset Tab.SLDDRW, SP-30035-AA-Front Shock Gusset Tab.SLDPRT, SP-A0106-AB-Front Shock Tab Box.SLDASM, SP-A0200-Front Rocker Tab Box.SLDDRW, SP-AB- Front Upper A-Arms.SLDDRW]
2024-03-14 Made rocker hole diameter changes. Also added ball bearings to rear assembly
    [6960T231_Super-Swivel Ball Joint Rod End.SLDPRT, 92510A802_Aluminum Unthreaded Spacer.SLDPRT, FS-High Misalign Spherical Bearing, 0.375 (HAB-6TG).SLDASM, FS-MALE ROD END UNF-3A, 0.25x28-0.25D (AM-4).SLDASM, FS-ZINC YELLOW THIN NUT G8 HX, 0.25x28-0.15625 (93839A805).SLDPRT, FS-ZINC YELLOW THIN NUT G8 HX, 0.375x24-0.21875 (93839A815).SLDPRT, MirrorSP-C30066-AA-A-Arm Tab Box.SLDPRT, SP-#####-AB-Spri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]
2024-03-14 D Shaft Update
    [BR-00001-BA D-Shaft.SLDDRW, BR-00001-BA D-Shaft.SLDPRT]
2024-03-15 stock parts for members' cam
    [WT-Brake Rotor STOCK.SLDPRT]
2024-03-15 Create Breakline Clip.SLDPRT
    [Breakline Clip.SLDPRT]
2024-03-19 HV Cover new
    [EN-90043-AB-HV Connection Cover L1.SLDPRT, EN-90044-AB-HV Connection Cover L2.SLDPRT]
2024-03-25 mirrored right upright
    [WT-#####-Front Upright RIGHT.SLDPRT]
2024-03-27 Front A-Arm and Rear A-Arm Assembly Drawings
    [6391K334_Oil-Embedded Bronze Sleeve Bearing.SLDPRT, 92510A802_Aluminum Unthreaded Spacer.SLDDRW, FS-High Misalign Spherical Bearing, 0.375 (HAB-6TG).SLDASM, SP - Front Lower A-Arms.SLDASM, SP - Rear Lower A-Arms.SLDASM, SP-10001 - BB - Front Rocker.SLDPRT, SP-10011-BA-Push Rod Front.SLDASM, SP-10011-BA-Push Rod Front.SLDDRW]
2024-04-04 Suspension Drawings
    Updating some of them as well as rearranging folder
    [FS-MALE ROD END UNF-3A, 0.25x28-0.25D (AM-4).SLDASM, SP-10002-AE-Lower Apex F.SLDDRW, SP-10002-AF-Lower Apex F.SLDDRW, SP-10003-AC-Threaded Insert.SLDPRT, SP-10011-BB-Push Rod Rear.SLDDRW, SP-10052-AB-Upper Apex R.SLDDRW, SP-10052-AD-Lower Apex R.SLDDRW, SP-10071-AC-P Rod Tube R.SLDDRW]
2024-04-06 Diff Sprocket 2.75 CAM
    [Differntial Sprocket 2.75 CAM.SLDASM, Sprocket_Assem.SLDASM]
2024-04-07 Break Rotor CAM
    [12.00_x_12.00_x_1.5_Fixture_Plate.SLDPRT, 4999A31_Step Setup Clamp.SLDPRT, BR-#####-AB-Solid Brake Rotor.SLDPRT, CAM_BreakRotor.SLDASM, WT-Brake Rotor STOCK.SLDPRT]
2024-04-11 Worked on the Brake Rotor CAM
    Updated the Fixture Plate and Adjusted the main rotor CAM
    [12.00_x_12.00_x_1.5_Fixture_Plate.SLDPRT, CAM_BreakRotor.SLDASM]
2024-04-13 Fixture Plate and Rotor Updates
    Fixed misunderstanding with Fixture plate
    [12.00_x_12.00_x_1.5_Fixture_Plate.SLDPRT, BR-#####-AB-Solid Brake Rotor.SLDPRT, CAM_BreakRotor.SLDASM]
2024-04-13 Brake Rotor CAM updates
    [12.00_x_12.00_x_1.5_Fixture_Plate.SLDPRT, CAM_BreakRotor.SLDASM]
2024-04-16 Updated Brake Rotor
    [12.00_x_12.00_x_1.5_Fixture_Plate.SLDPRT, 4999A31_Step Setup Clamp.SLDPRT, 91290A154_Alloy Steel Socket Head Screw, M4x0.7, 16mm.SLDPRT, BR-Black Oxide C12.9 SHCS, M4x0.7-12(91290A148).SLDPRT, CAM_BreakRotor.SLDASM]
2024-04-17 Diff Sprocket CAM Feeds
    [Differntial Sprocket 2.75 CAM.SLDASM, EN-10029-BA-Differential Sprocket 33-Teeth.SLDPRT]
2024-04-26 Cooling Pt. 2
    [Aluminum Adapter Subassembly.SLDASM, EN-00302-Pump Mounting Tab.SLDPRT, EN-00303-Pump Mounting Tab.SLDPRT, EN-00304-Lower Radiator Mounting Tab.SLDPRT, EN-00305-Upper Radiator Mounting Tab.SLDPRT, EN-90069-AA-0.75in Aluminum Hose Joiner.SLDPRT, Tee Adapter Subassembly.SLDASM]
2024-04-26 Mass Updates
    [EN-20095-Catch Can.SLDPRT]
2024-04-30 Added bolts to front and rear assemblies
    [91290A154_Alloy Steel Socket Head Screw, M4x0.7, 16mm.SLDPRT, 92461A400_Medium-Strength Steel Nylon-Insert Flange Locknut.SLDPRT, 94622A416_Cadmium-Plated Steel Hex Head Screw.SLDPRT, 95615A130_Medium-Strength Steel Nylon-Insert Locknut.SLDPRT]
2024-04-30 missing fastener
    [95327A569_Zinc Yellow-Chromate Plated Steel Hex Head Screw.SLDPRT]
2024-05-01 Updated Rotor CAM
    Used feedback from Andy to change the brake rotor CAM
    [CAM_BreakRotor.SLDASM]
2024-05-08 Hub CAM
    [WT-10101-AA-Wheel Hub Front.SLDPRT]
2024-05-12 Changed WCS of Brake Rotor
    [CAM_BreakRotor.SLDASM]
2024-05-12 Update CAM rotor with 4 flute
    [CAM_BreakRotor.SLDASM]
2024-05-14 upright: the thread update
    [WT-#####-AC-Front Upright.SLDPRT]
2024-05-18 Fixed Rotor CAM Problems
    Fixed the feeds and speeds, made the threads on the fixture plate and made a finish pass on the rotor
    [12.00_x_12.00_x_1.5_Fixture_Plate.SLDPRT, CAM_BreakRotor.SLDASM]
2024-05-20 MAJOR-Changed Rotor Design
    I added corner spaces in the brake rotor. Previous years didn't have a problem with this but I'm nervous about Cast Iron
    [BR-#####-AB-Solid Brake Rotor.SLDPRT, CAM_BreakRotor.SLDASM]
2024-05-21 Smaller Rotor Corner holes and removed static study data
    [BR-#####-AB-Solid Brake Rotor.SLDPRT, CAM_BreakRotor.SLDASM]
2024-05-23 New Tripod nut ;)
    [WT-RR####-XB-Tripod Nut.SLDDRW, WT-RR####-XB-Tripod Nut.SLDPRT]
2024-05-23 new tripod nut Rev2
    [WT-RR####-XB-Tripod Nut.SLDDRW, WT-RR####-XB-Tripod Nut.SLDPRT]
2024-05-28 Fixed Hexagon Hole Corners
    [12.00_x_12.00_x_1.5_Fixture_Plate.SLDPRT, BR-#####-AB-Solid Brake Rotor.SLDPRT, CAM_BreakRotor.SLDASM]
2024-05-28 Changed Tap
    [12.00_x_12.00_x_1.5_Fixture_Plate.SLDPRT]
2024-05-28 Slight Changes to Drill Speed
    [CAM_BreakRotor.SLDASM]
2024-05-30 Create EN-00023-AA-Motor Shaft Spacer.SLDPRT
    [EN-00023-AA-Motor Shaft Spacer.SLDPRT]
2024-05-30 Changed Rotor CAM for Water Jet Production
    We have acess to the water jet now so I cut the majority of the features on the Water jet and just mill out the hexagon on the CNC
    [12.00_x_12.00_x_1.5_Fixture_Plate.SLDPRT, BR-#####-AB-Solid Brake Rotor.SLDPRT, BR-Black Oxide C12.9 SHCS, M4x0.7-12(91290A148).SLDPRT, BR-RotorJetStock.SLDPRT, CAMBreakRotorPostWaterJet.SLDASM, CAM_BreakRotor.SLDASM, NOTUSEDCAM.SLDASM]
2024-05-31 Rotor NC changes
    Made some tool changes to make setup easier
    [12.00_x_12.00_x_1.5_Fixture_Plate.SLDPRT, CAMBreakRotorPostWaterJet.SLDASM]
2024-06-04 Rotor Changes With New Bolts
    I changed the bolts to #8 bolts and shifted everything to make the CAM work out and avoid the broken tool
    [12.00_x_12.00_x_1.5_Fixture_Plate.SLDPRT, CAMBreakRotorPostWaterJet.SLDASM]
2024-06-04 Adjust things on CAM
    [12.00_x_12.00_x_1.5_Fixture_Plate.SLDPRT, CAMBreakRotorPostWaterJet.SLDASM]
2024-06-05 TSMP Protection wall
    [EL_500XX-AA-TSMP Wall.SLDPRT]
2024-07-14 Update Breakline Clip.SLDPRT
    [Breakline Clip.SLDPRT]
2024-08-15 FE12 subpack layout for CDR
    [FE12 generic heatsink.SLDPRT, FE12 sample busbar.SLDPRT, Subpack layout for CDR.SLDASM]
2024-09-06 Create ST-A0200-AA-Inboard Steering-Static 1.CWR
2024-09-10 Pedal Box Review
    [91290A168_Alloy Steel Socket Head Screw M4x0.7,20.SLDPRT, BR-00001-BC-Heel Plate.SLDPRT, BR-00001-BE-Heel Plate.SLDPRT, BR-00004-AB-CP7855 Master Cylinder.SLDASM, BR-00005-AA-Balance Bar (Tilton 600 Series).SLDASM, BR-00009-DA-BPPS (MSC360-1A-C0004-ERA360-05K).SLDASM, BR-0000X-AA-BPPS Spacer, Long.SLDPRT, BR-0000X-AA-BPPS Spacer, Short.SLDPRT]
2024-09-10 Revert "Pedal Box Review"
    This reverts commit 91a8ee42caa8aaef5abc7dcfac9b70d8033a1174.
    [91290A168_Alloy Steel Socket Head Screw M4x0.7,20.SLDPRT, BR-00001-BC-Heel Plate.SLDPRT, BR-00001-BE-Heel Plate.SLDPRT, BR-00004-AB-CP7855 Master Cylinder.SLDASM, BR-00005-AA-Balance Bar (Tilton 600 Series).SLDASM, BR-00009-DA-BPPS (MSC360-1A-C0004-ERA360-05K).SLDASM, BR-0000X-AA-BPPS Spacer, Long.SLDPRT, BR-0000X-AA-BPPS Spacer, Short.SLDPRT]
2024-09-13 U-Joint Changes On Steering System
    [ST-00007-AA-SU Joint Borgeson.SLDASM, ST-00007-AB-SU Joint Borgeson.SLDASM, ST-10008-AG-Lower Column.SLDPRT, ST-10009-AA-Lower Lower Column.SLDPRT, ST-A0200-BA-Inboard Steering.SLDASM]
2024-09-14 Brake Pedal Material Changes
    [BR-0000X-AC-Toe Plate Spacer.SLDPRT, BR-10001-DC-Brake Pedal Assembly.SLDASM, BR-30003-BE-Accel Toe Plate.SLDPRT, BR-30003-BF-Toe Plate.SLDPRT]
2024-09-14 Steering System U-Joint and Rod Material
    [ST-10004-AC-Upper Column.SLDPRT, ST-10008-AG-Lower Column.SLDPRT, ST-10009-AA-Lower Lower Column.SLDPRT, ST-A0200-BA-Inboard Steering.SLDASM]
2024-09-14 Heel and Toe Plate Changes
    [BR-00001-BC-Heel Plate.SLDPRT, BR-00001-BD-Heel Plate.SLDPRT, BR-00001-BE-Heel Plate.SLDPRT, BR-00001-BF-Heel Plate.SLDPRT, BR-10001-DC-Brake Pedal Assembly.SLDASM, BR-30003-BE-Accel Toe Plate.SLDPRT, BR-30003-BF-Accel Toe Plate.SLDPRT, BR-30003-BG-Toe Plate.SLDPRT]
2024-10-07 New Heel Plate
    [BR-00001-CA-Heel Plate.SLDPRT]
2024-10-08 New Ackermann Testing
    [Assem2.SLDASM]
2024-10-08 New Heel Support
    [BR-00001-AA-Heel Support.SLDPRT]
2024-11-07 this is dumb, rebuild this later future chris. never let members do this again.
    teach members how to make cad better, this was not a good idea
    [6960T231_Super-Swivel Ball Joint Rod End.SLDPRT, FS-High Misalign Spherical Bearing, 0.375 (HAB-6TG).SLDASM, FS-ZINC YELLOW THIN NUT G8 HX, 0.375x24-0.21875 (93839A815).SLDPRT, SP-10003-AD-Threaded Insert.SLDPRT, SP-10052-AB-Upper Apex R.SLDPRT, SP-10052-AD-Lower Apex R.SLDPRT, SP-30063-AB-Pushrod Tab.SLDPRT, SP-RR Lower A-Arm Tube.SLDPRT]
2024-11-07 rear tubs
    [SP-RR Lower A-Arm Tube.SLDPRT]
